mabrains/PLL_design/README.md

# Bluetooth PLL Design on Skywater's __130nm__ technology

 *The current design is still under progress. This is an **experimental release**.*

<p align="center">



&nbsp 
</p>

----------------------
# Table of Contents

- [Introduction](docs/Introduction.md)
- [System Model](docs/system_model.md)
- [Blocks](docs/blocks/design.md)
- [Full PLL Design](docs/full_pll_design.md)
- [Tapeout using Caravel SoC](docs/tapeout.md)

Each block is designed to achieve system design specifications using [xschem](https://github.com/StefanSchippers/xschem) tool. 

Each block is Layouted to using [Klayout](https://github.com/KLayout/klayout) tool. 

Refer to [README](docs/source/index.rst) for this sample project documentation.
