mabrains/PLL_design/pll/lc_vco_lib_Ahmed_Reda/VCO_CMOS_init_tb/README.md

Initial Design
=================

    - A simple inductor model is used which is composed of an ideal inductor in parallel with a resistor which represents the losses of the inductor.
    
    - Varactor isn't implemented yet, so a capacitor is used.
    
    - The values of the inductor and the capacitor are adjusted to get a resonance frequency at 2.45 GHz.
    
    - The size of the NMOS cross coupled pair is adjusted to generate a negative resistance which negates the positive resistance of the inductor.

_________________________________________________________________________
- Implemented CMOS based LC VCO operating at 2.45 GHz
    - Schematic:
 
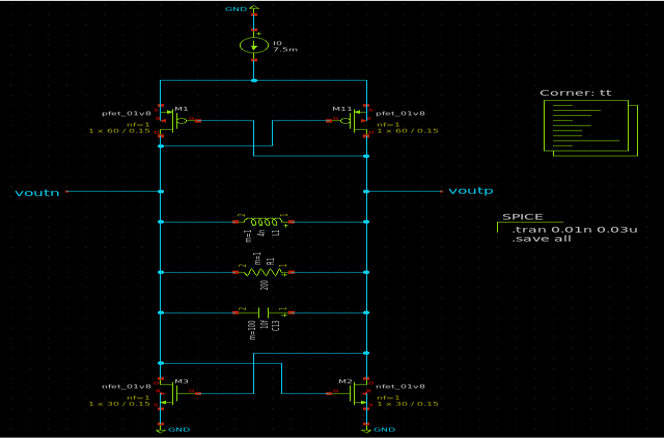
[picture p4: pll/lc_vco_lib_Ahmed_Reda/VCO_CMOS_init_tb/images/CMOS_LC_VCO_Schematic.png]
CMOS LC VCO Schematic
    
    
    - Output:
    
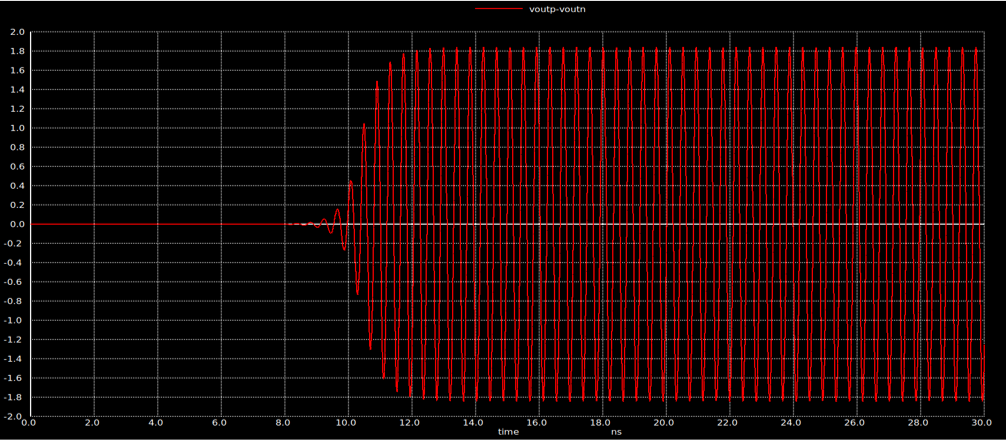
[picture p5: pll/lc_vco_lib_Ahmed_Reda/VCO_CMOS_init_tb/images/CMOS_LC_VCO_Diff_Output.png]
CMOS LC VCO Output CMOS LC VCO Differential Output
