mabrains/PLL_design/pll/lc_vco_lib_Ahmed_Reda/BGR_Corners/csv_sheets/mult/constant_load/README.md

**This file contains the results of the BGR circuit of the schematic view and after paracitic exraction but by **fixing** the voltage value of the output node at **VDD/2** at the typical corner.**
