mabrains/PLL_design/docs/blocks/design.md

# Blocks Design

- [Crystal OSC](xctl.md)

- [PFD](pfd.md)

- [Charge pump](cp.md)

- [Loop Filter](lf.md)

- [Band-gap Refrence](bgr.md)

- [VCO](vco.md)

- [Divider](div.md)

- [DSM](sdm.md)
