mabrains/PLL_design/pll/system/design_specs/Specs.md

# System specs

| Spec | Value |
| --- | --- |
| `Center frequencies` | 2.402-2.480 GHz|
| `Phase noise @ 1MHz offset (From Standard)` |<-74 dBc/Hz |
| `Phase noise @ 2MHz offset (From Standard) ` |<-106 dBc/Hz|
| `Phase noise @ 3MHz offset (From Standard)` | <-116 dBc/Hz |
| `Synthesizer lock time (From Standard)  ` | (<68𝜇)|
| `Loop Bandwidth` | 150 KHz|
| `Phase margin ` | 55°|
| ` Expected Lock time ` | 4/(𝐿𝑜𝑜𝑝 𝐵𝑊)≈26 𝜇𝑠|
| `Loop Filter Parameters` | Cz ≈268𝑝𝐹 ,Rz ≈12.5 𝐾Ohms , CP ≈29.5𝑝𝐹|

# Crystal Oscillator

| Spec | Value |
| --- | --- |
| `Fref` | 10 𝑀𝐻𝑧 |
| `Phase noise @ 1MHz offset` | <-150 dBc/Hz |

# PFD/CP

| Spec | Value |
| --- | --- |
| `Iout` | 100𝜇𝐴 |
| `Compliance Range` | 0.5V-1.5V |
| `Phase noise @ 1MHz offset` | <-240 dBc/Hz |

# VCO
| Spec | Value |
| --- | --- |
| `Tuning range` | 2.35G,2.55G |
| `𝐾_𝑣𝑐𝑜 ` | 200MHz/V |
| `Phase noise @ 1MHz offset ` | <-115 dBc/Hz |

# Divider
| Spec | Value |
| --- | --- |
| `DIV RATIO` | 240-248|
| `Step ` | 0.1 |
| `Resolution` |  1 MHz |
| `Modulus control A B ratios` |  9 : 1 |
| `Phase Noise @ 1 MHz offset` |  <-150 dBc/Hz |

18/8/2022
