mabrains/PLL_design/docs/Introduction.md

# Introduction

A fully integrated Sigma-Delta Fractional-N PLL for Wifi/Bluetooth applications is implemented using Open-Source PDKs by Google-Skywater 130nm. The entire design was built using Open-Source EDA tools such as Octave, python, xschem, ngspice and Klayout.
