mabrains/PLL_design/docs/blocks/bgr.md

## Band Gap Refrence (BGR) 
----------------------------------

### Circuit design 
----------------------

* Proposed BGR circuit (Banba) :

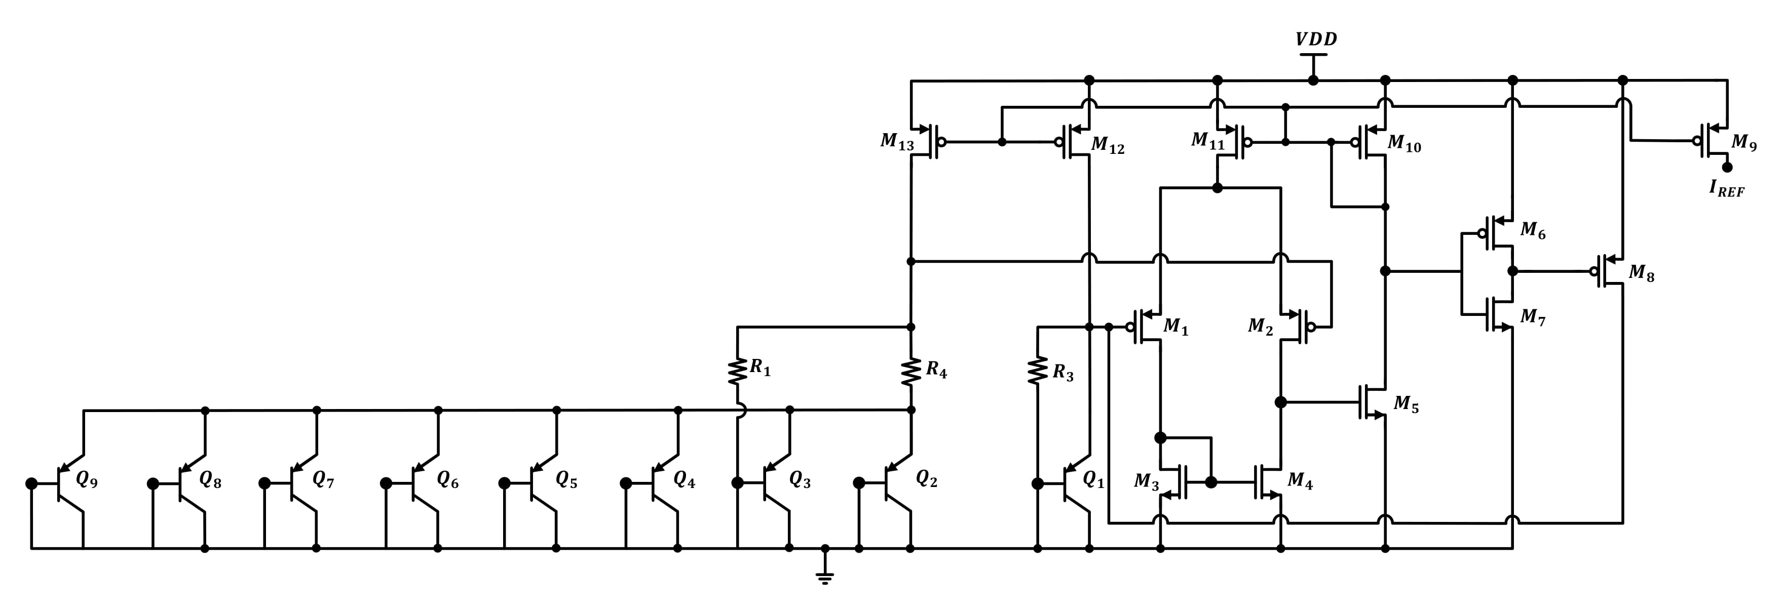
[picture p51: images/Diagrams/BGR/Banba BGR.jpg]
BGR


* Core Circuit :

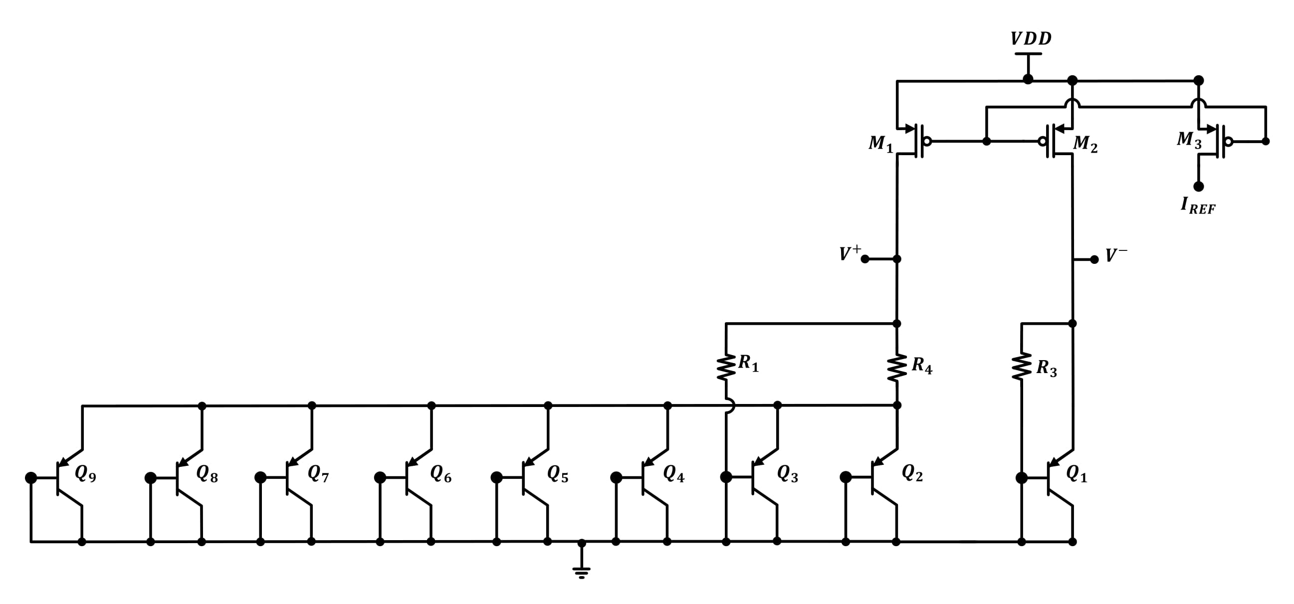
[picture p52: images/Diagrams/BGR/Core .jpg]
Core


* OTA :

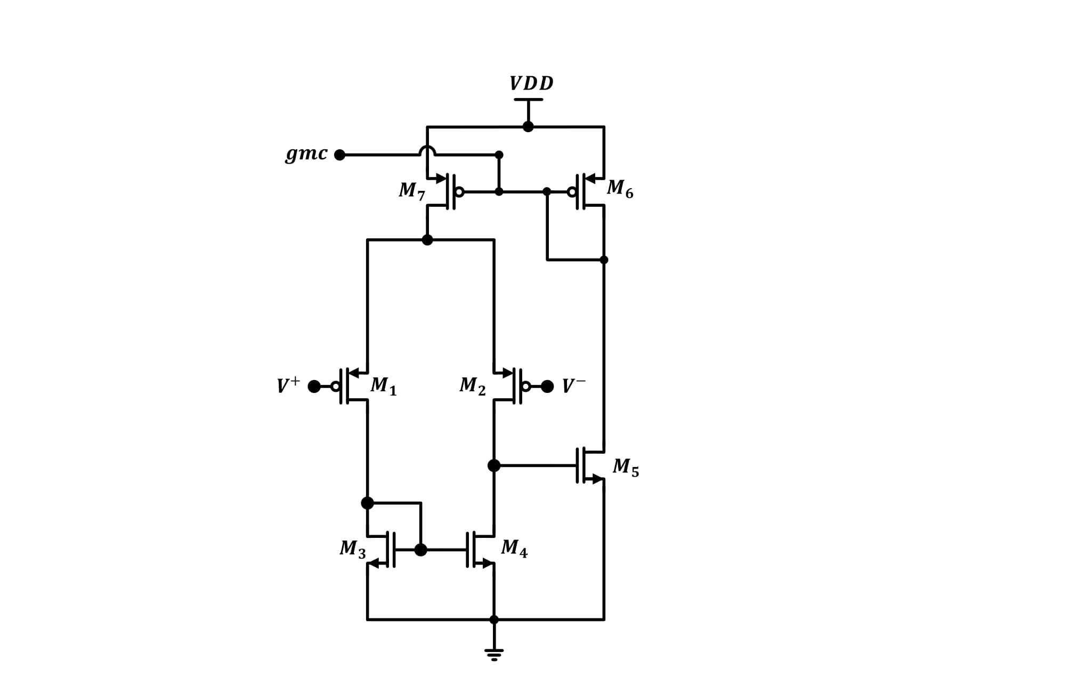
[picture p53: images/Diagrams/BGR/OTA.jpg]
OTA


* Start-Up Circuit :

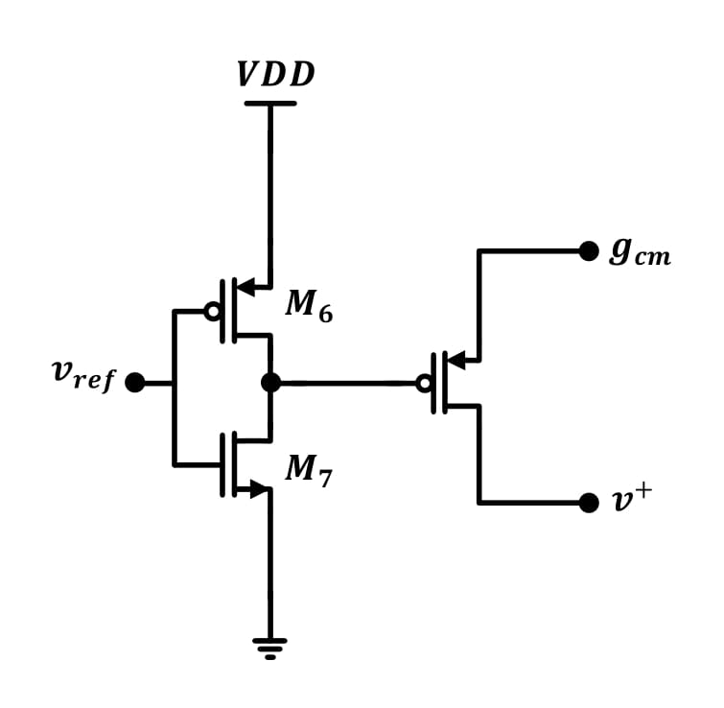
[picture p54: images/Diagrams/BGR/Start-up Circuit.jpg]
STC


### Simulation results 
----------------------
#### Biasing Circuit  : Simulation of Banba Bandgap

Iref vs Temperature (-40 to 125 )
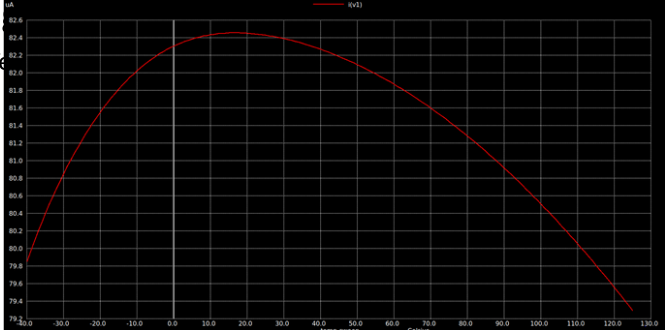
[picture p55: docs/blocks/bgr_images/1.png]

#### Transient Analysis
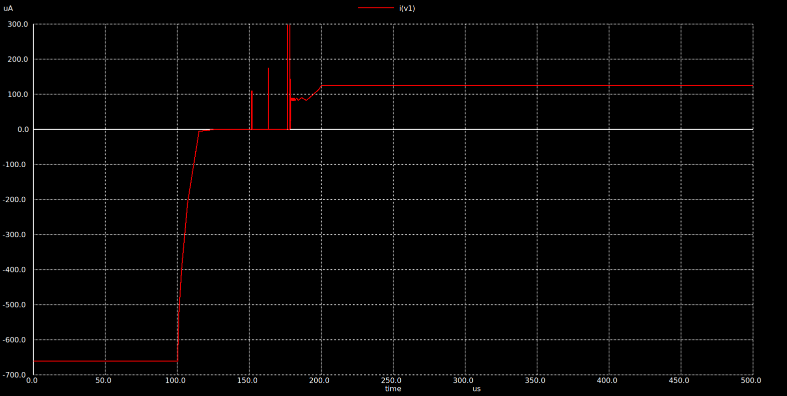
[picture p56: docs/blocks/bgr_images/tran.png]


### Layout design 
----------------------
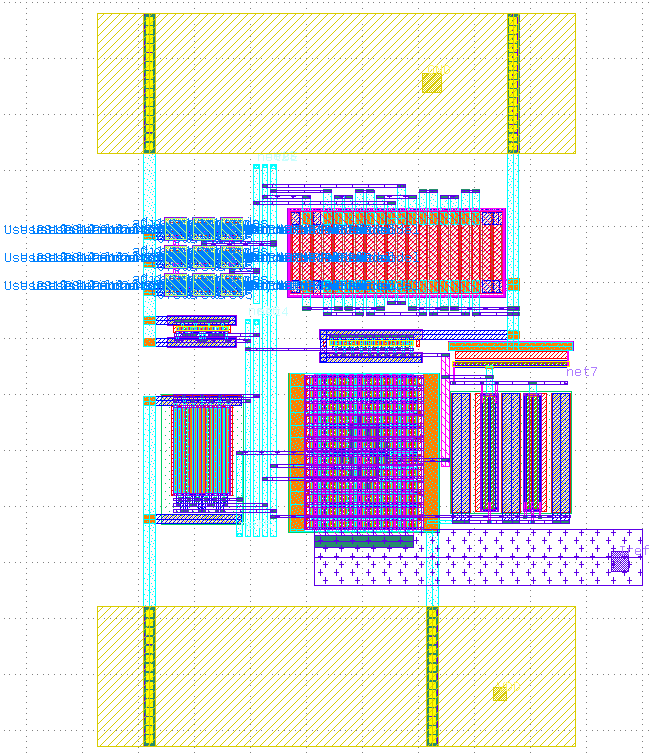
[picture p57: images/Layout/bgr_layout.png]
bgr_layout


### Post-Layout simulation
----------------------
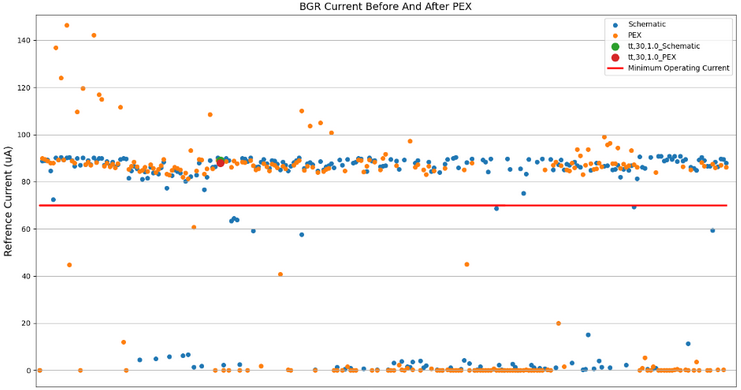
[picture p58: docs/blocks/bgr_images/play.png]
