mabrains/PLL_design/docs/blocks/lf.md

## Loop Filter
----------------------

### Circuit design 
----------------------

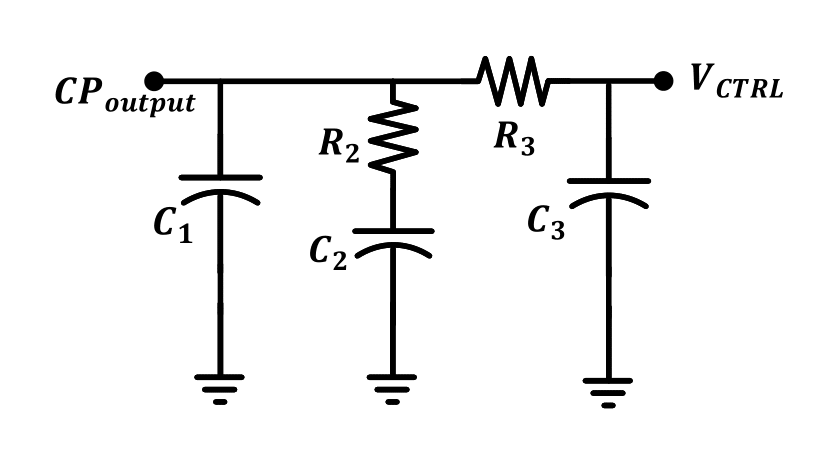
[picture p59: images/Diagrams/Loop filter/png/3rdorderlpf.png]


### Layout design 
----------------------

### Integeration of PFD + CP + LF
----------------------



#### REF lags from FB


#### FB lags from REF


#### FB lags from REF
When phase error is very small $50 ps$ FB lags from REF signal 
