mabrains/PLL_design/images/Diagrams/LC VCO/pdf/LC_VCO-6.pdf

# Capictance pF

# Reverse Voltage (Vr

)

Capictance decreases when the reverse voltage increases
