mabrains/PLL_design/images/Diagrams/PFD/pdf/deadzone_exists.pdf

180

o | −180 o

Pha e error

Avera e Output Volta e of the PFD
