mabrains/PLL_design/pll/system/python_model/README.md

4 Sept 2022
---
# _Status of the python Models_
80% 
---
## Phase Noise Modeling
* Need to model the loop filter parameters calculator
* Need to revise Ref Crystal 

* Python models are compiled and are working probably 

Here are the samples
* The Cloosed loop response of the PLL
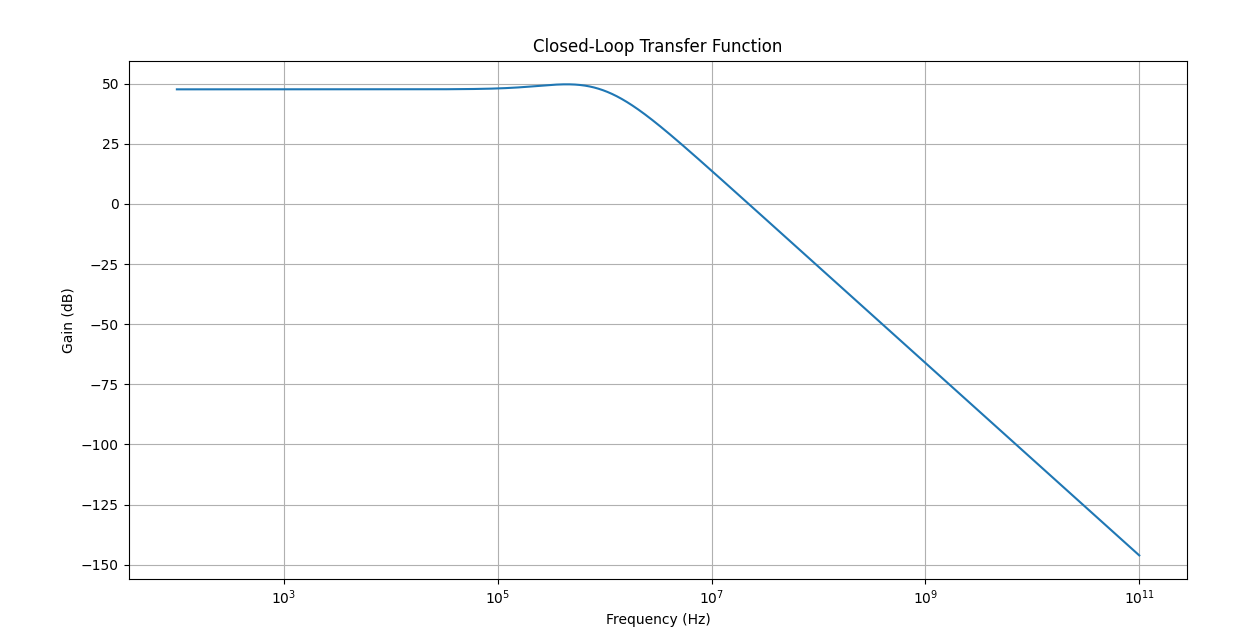
[picture p89: pll/system/python_model/2nd_sample_images/CL.png]
1st_sample

* The Open loop response of the PLL
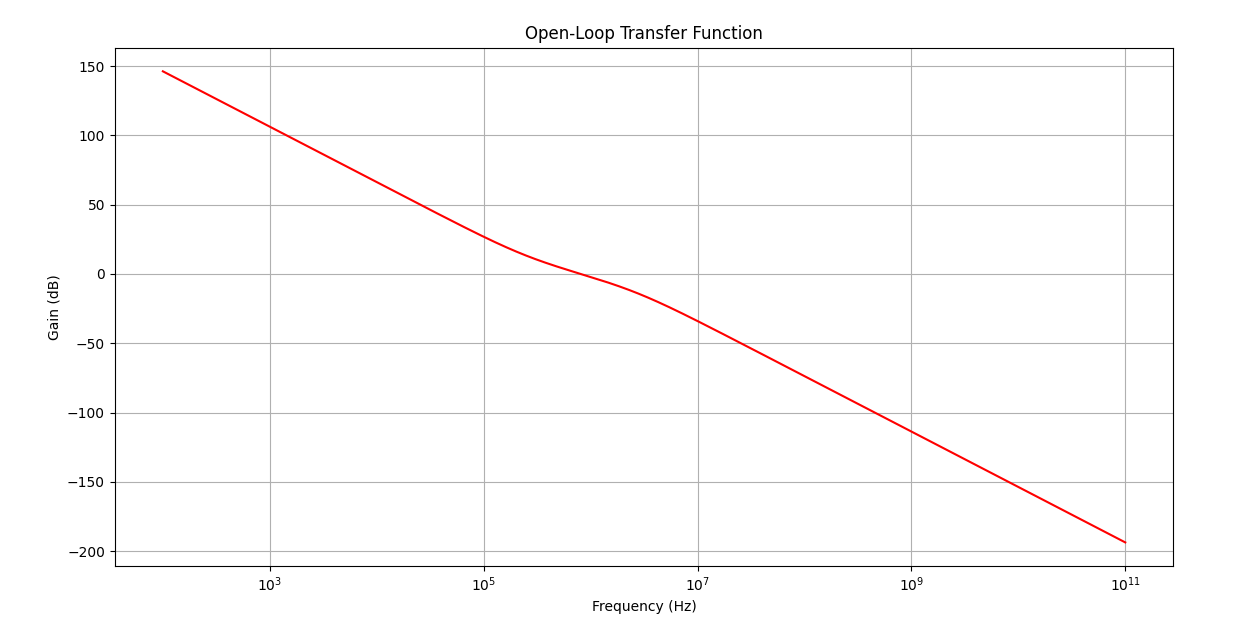
[picture p90: pll/system/python_model/2nd_sample_images/OL.png]
1st_sample

* Crystal oscillator Phase Noise Profile
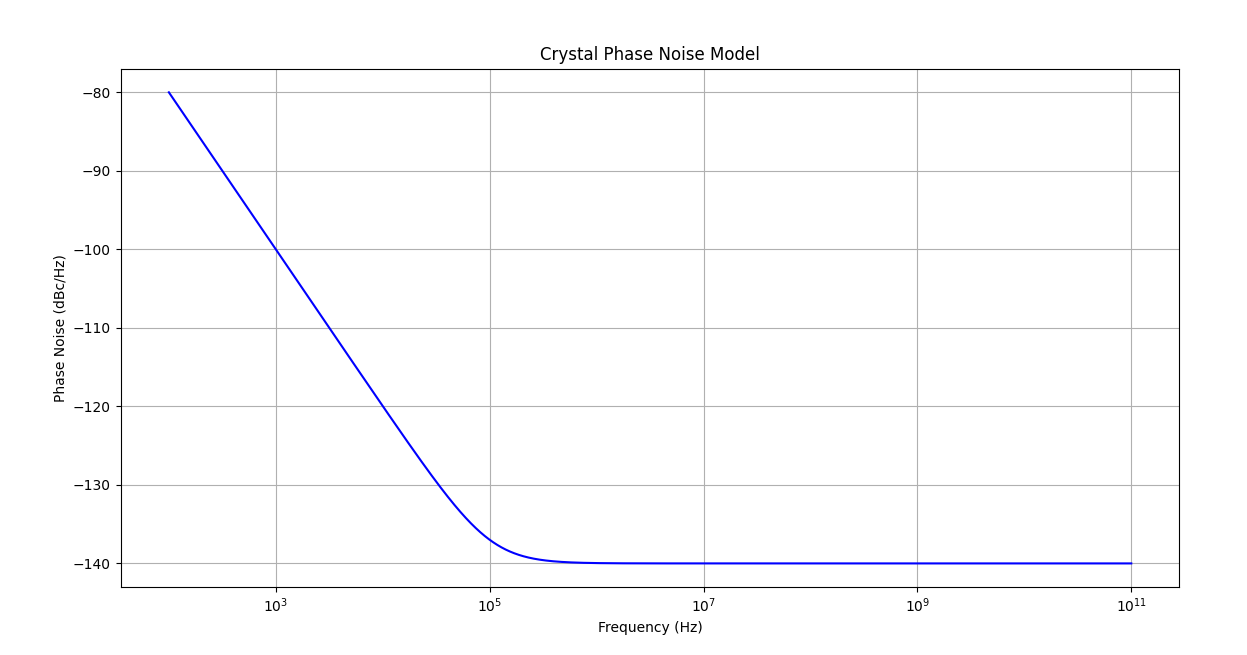
[picture p91: pll/system/python_model/2nd_sample_images/Crystal.png]
1st_sample

* Phase/Frequency Detector Phase Noise Profile
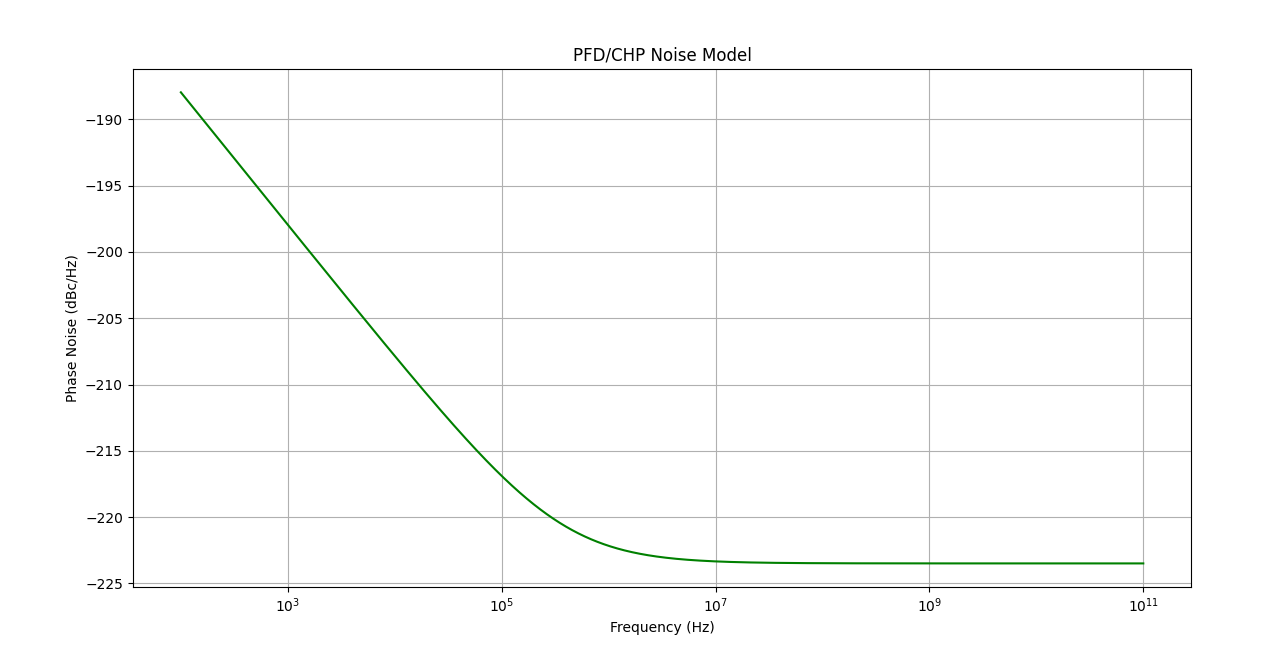
[picture p92: pll/system/python_model/2nd_sample_images/PFD.png]
1st_sample

* Divider Phase Noise Profile
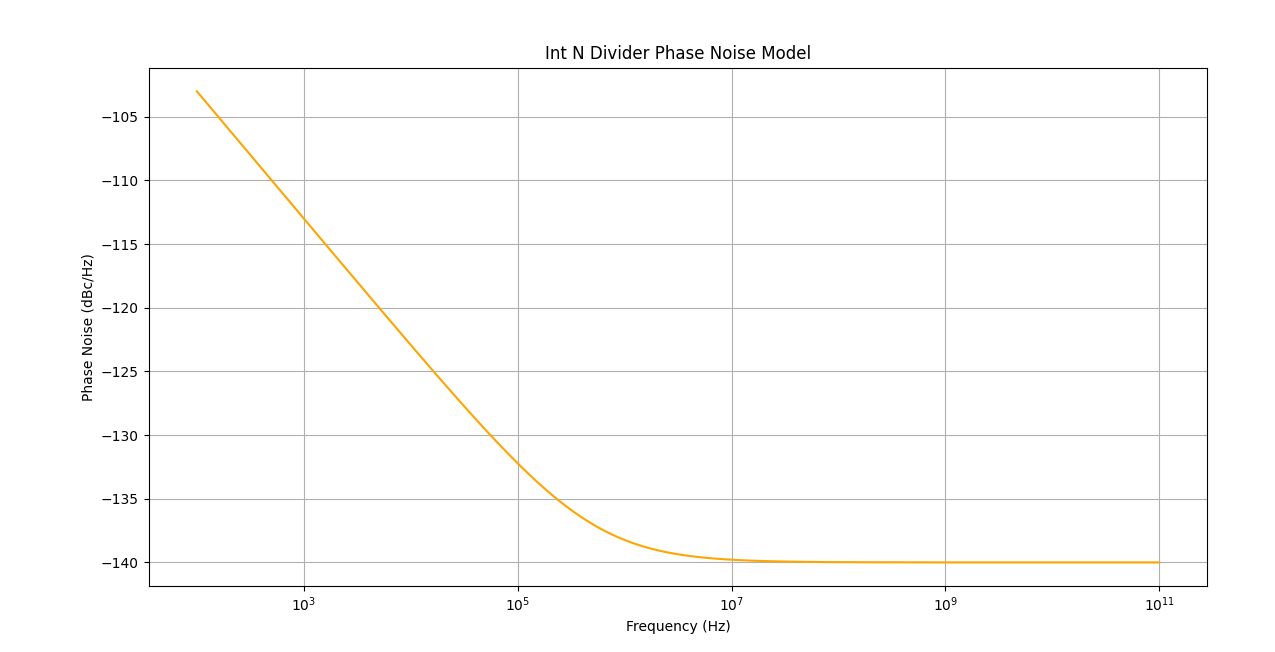
[picture p93: pll/system/python_model/2nd_sample_images/Int.png]
1st_sample

* Sigma Delta Noise Profile
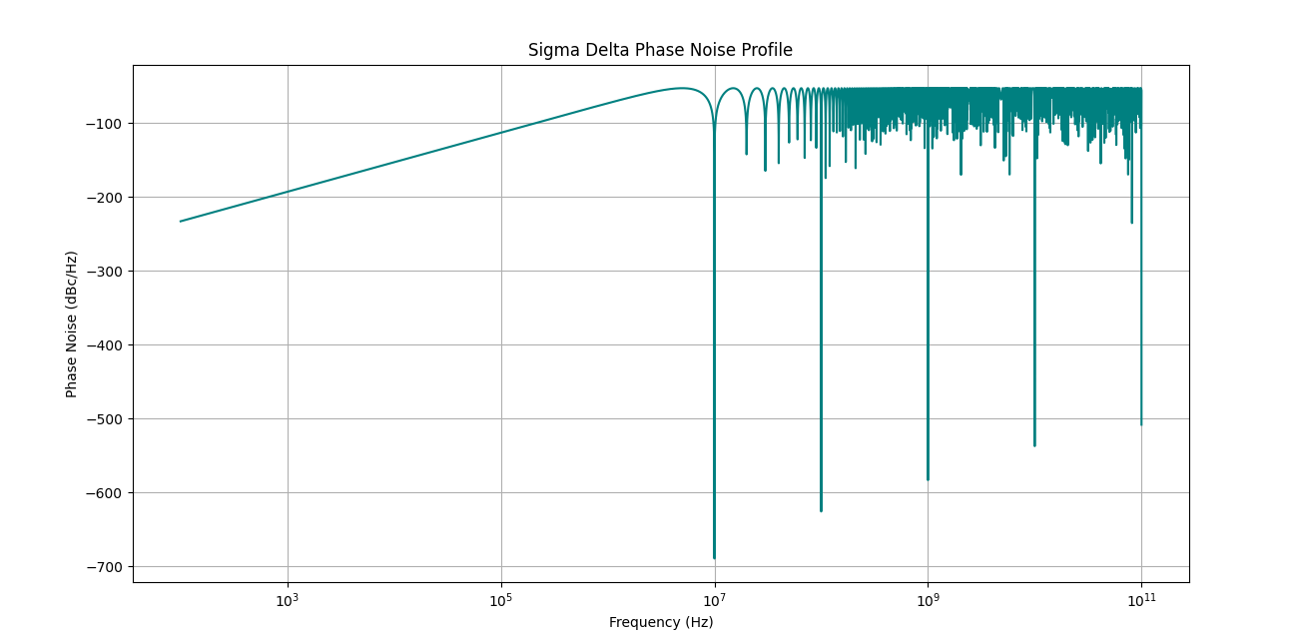
[picture p94: pll/system/python_model/2nd_sample_images/Sigma Delta.png]
1st_sample

* Voltage Controlled oscillator Phase Noise Profile
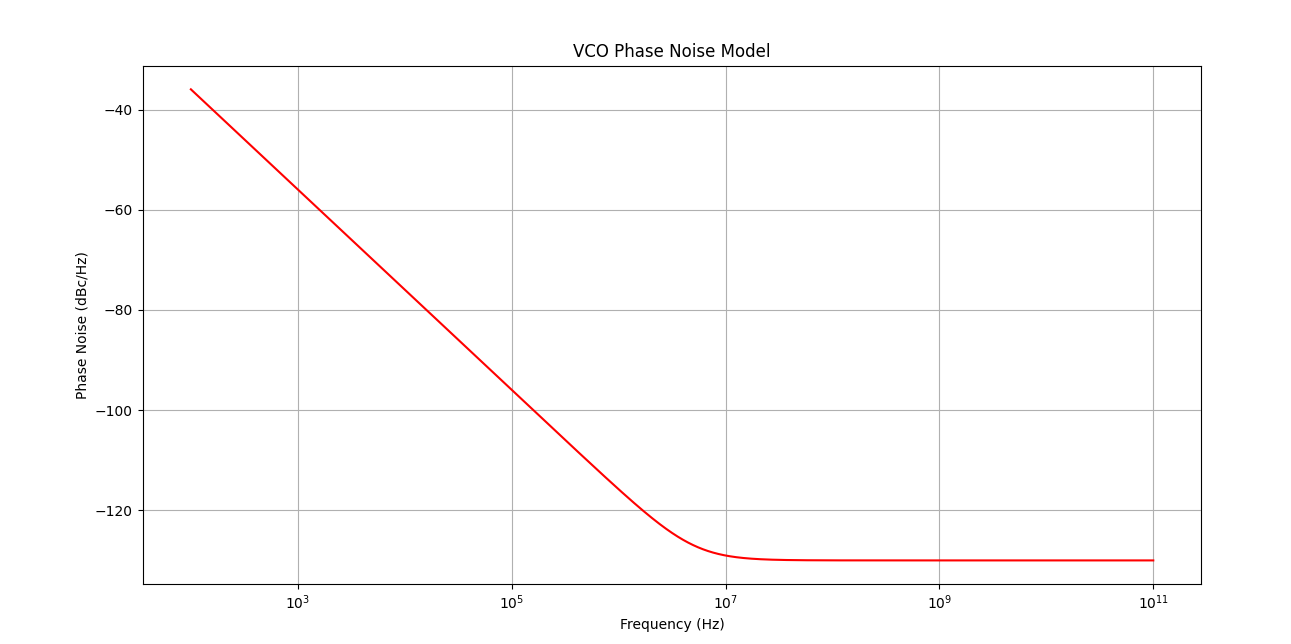
[picture p95: pll/system/python_model/2nd_sample_images/VCO.png]
1st_sample

* Total Output Phase Noise Profile
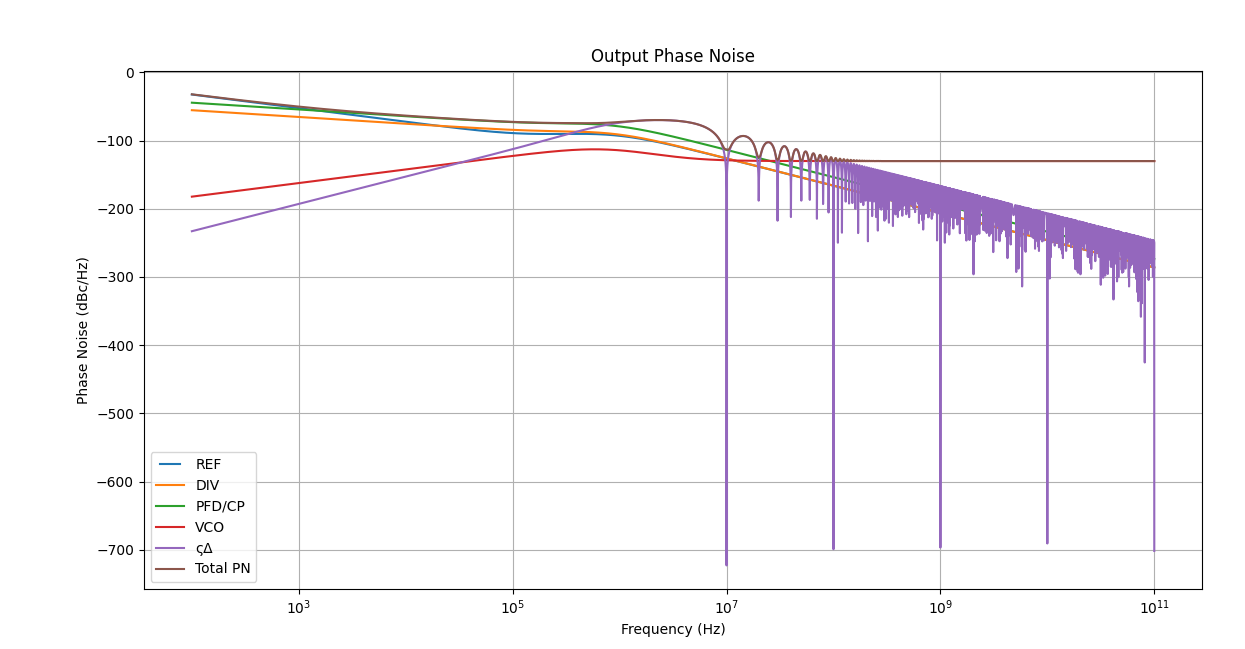
[picture p96: pll/system/python_model/2nd_sample_images/TOTAL.png]
1st_sample


* Missing Loop Filter Phase Noise ( Need to Revise Crystal phase noise and divider )

## Time Domain Modeling 
### PFD 
* In the PFD time domain modeling i compare manually enter two siganls with phase difference of pi to test the UP signal case
* The code comapre each value of time array siganls with each other to detect rising edges and based on this edges it flags an up signal
* But the code has a flaw in the initial step of the code as it cannot detect the first edge ( as i forcly waits for the 2nd edge of the feedback signal to drive some algrothim on how the code should detect the signals 
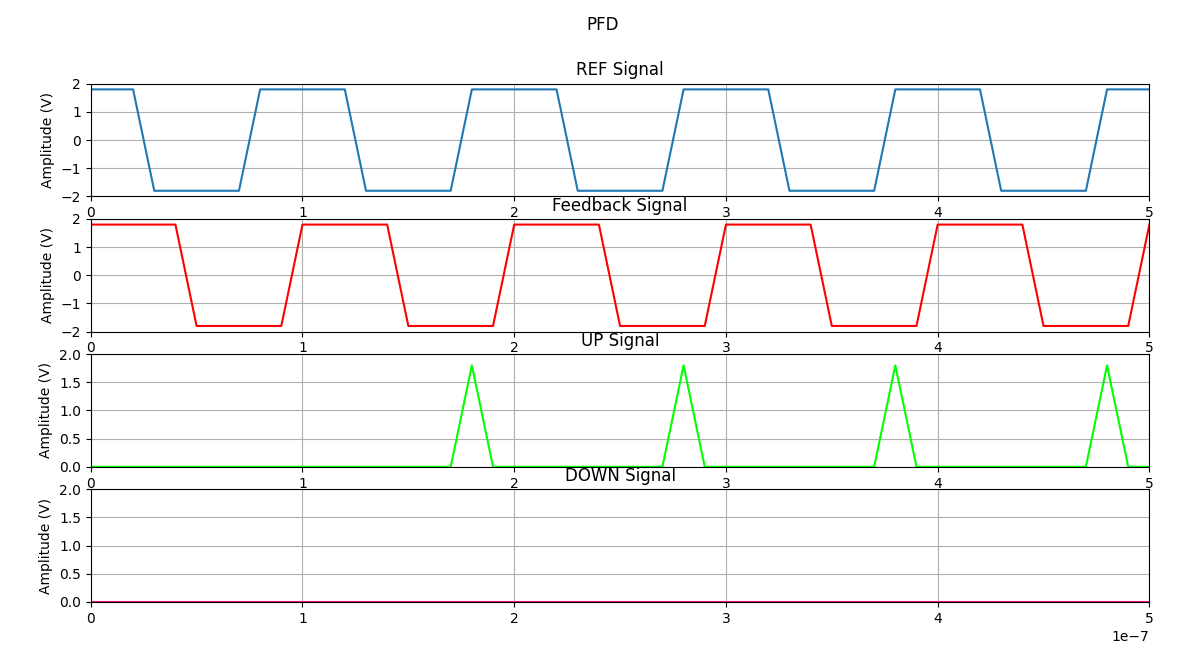
[picture p97: pll/system/python_model/PFD_TIME_DOMAIN_MODEL/PFD OPERATION.png]
   
* When i try to solve the issue i ran into a logical error as i reverse the logic for the next edges 
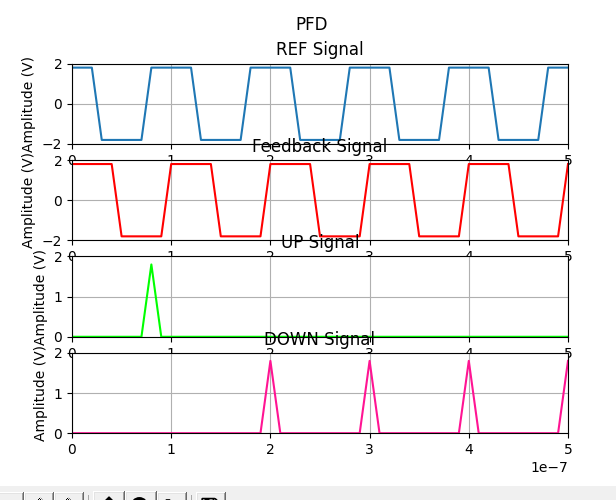
[picture p98: pll/system/python_model/PFD_TIME_DOMAIN_MODEL/trial pfd 1.png]
  
* Problem Should be Fixed soon

*_Moataz Mokhtar_*
