mabrains/PLL_design/pll/system/design_specs/System_Modeling.md

# PLL System Design

## System Parameters:
* Kvco = 200MHz/V
* Ichp = 100uA
* Fref = 10 MHz
* Fout = 2.402 GHz
* Loop Bandwidth = 150 KHz
* Phase margin = 55

## Open loop response:

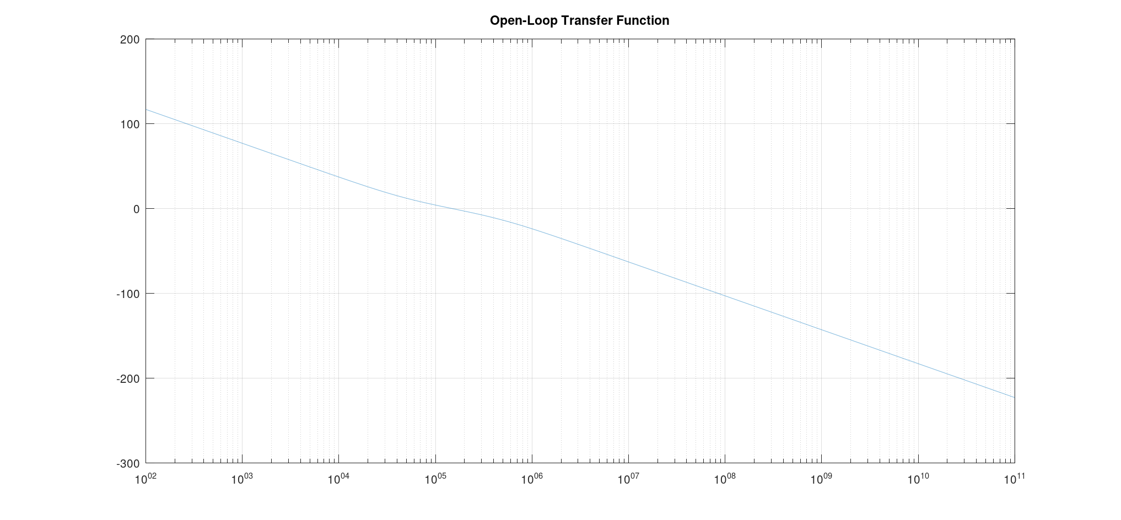
[picture p99: pll/system/phase_noise_images/OL_Tf.png]
Open loop response


## Closed loop response:

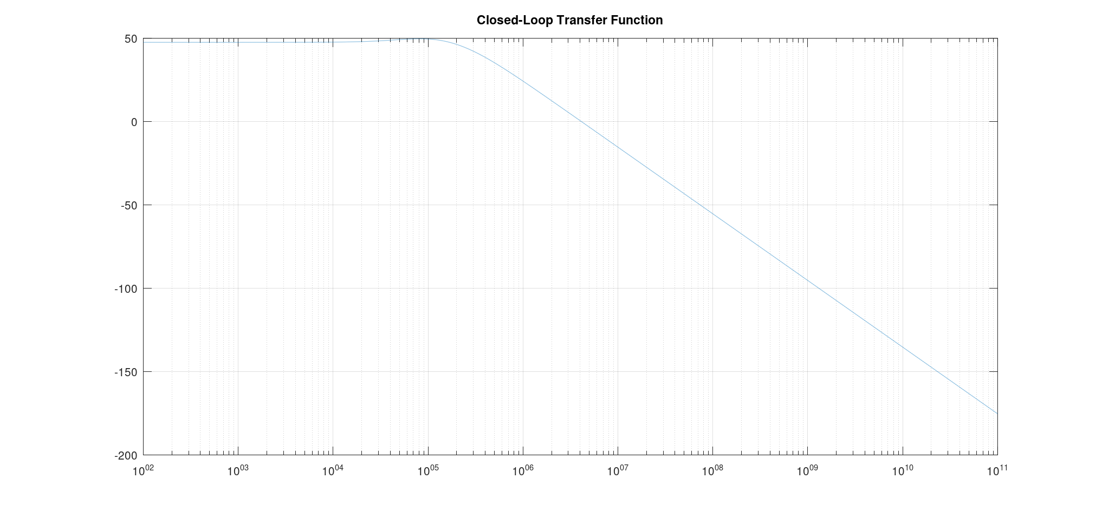
[picture p100: pll/system/phase_noise_images/CL_Tf.png]
Closed loop response


## Phase noise profile of each block:

### Crystal Oscillator Noise Model
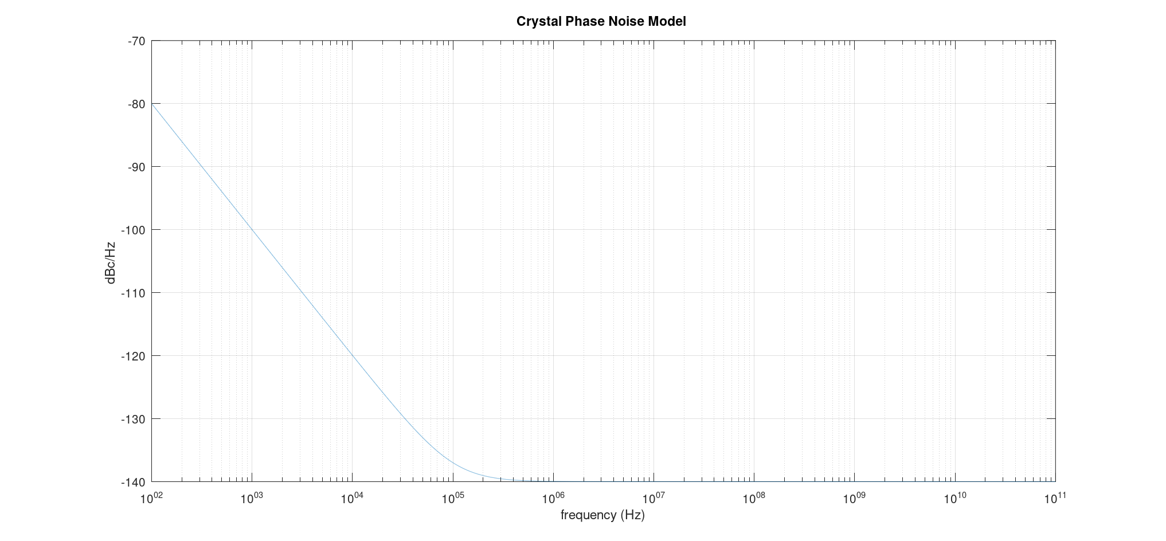
[picture p101: pll/system/phase_noise_images/Crystal_PN_Model.png]
Crystal Oscillator Noise Model


### PFD/CHP Noise Model
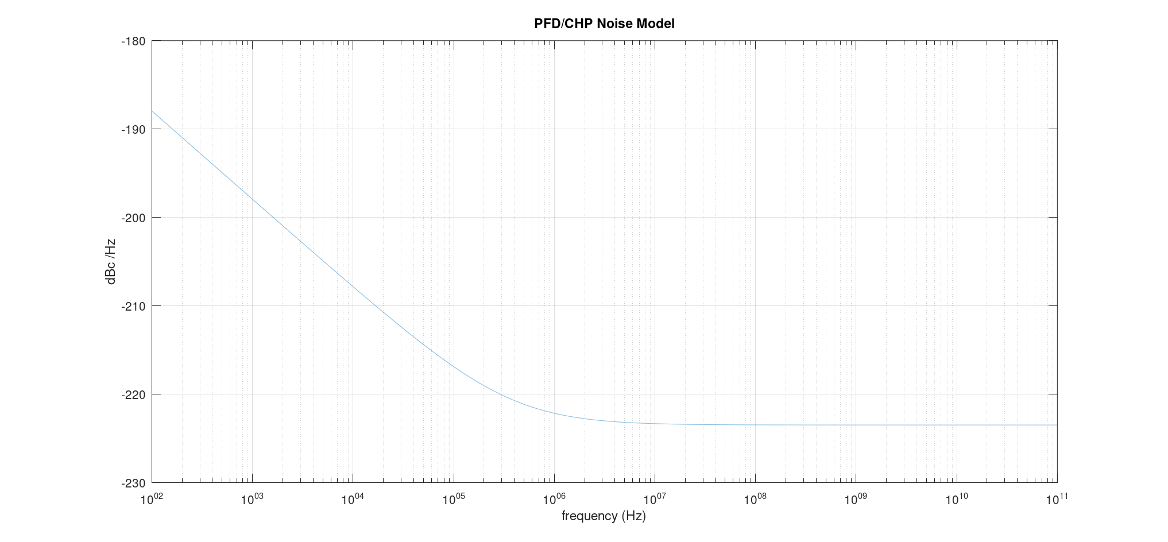
[picture p102: pll/system/phase_noise_images/PFDCHP_PN_Model.png]
PFD/CHP Noise Model


### VCO Noise Model
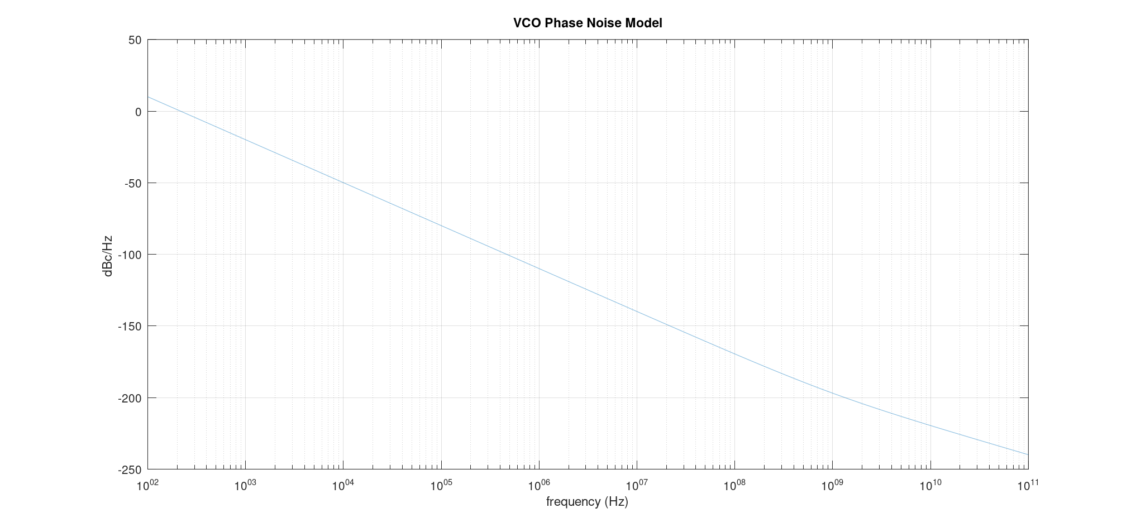
[picture p103: pll/system/phase_noise_images/VCO_PN_Model.png]
VCO Noise Model


### Divider Noise Model
Divider Noise Model

As in the following figure, each noise source sees a different transfer function depending on the position in the loop to the output.
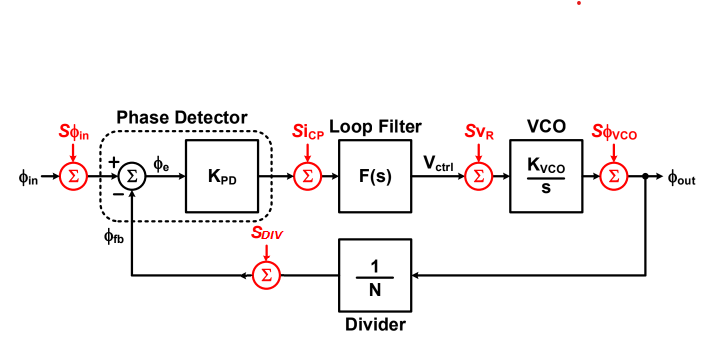
[picture p104: pll/system/phase_noise_images/Linearized_Model.png]


## Total Output Phase noise
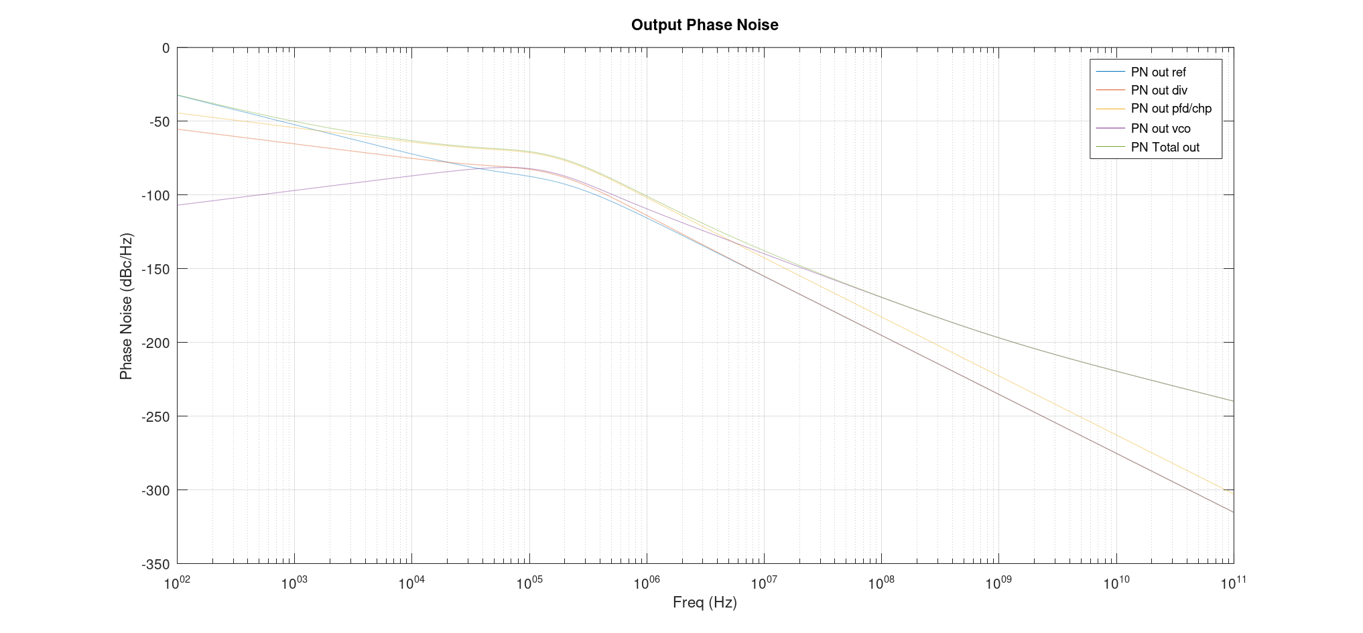
[picture p105: pll/system/phase_noise_images/Total_out_PN.png]


| Phase Noise | Value |
| --- | --- |
| `@ 1MHz offset` |-99.8 dBc/Hz |
| `@ 2MHz offset` |-111.4 dBc/Hz|
| `@ 3MHz offset` |-119.5dBc/Hz |
