mabrains/PLL_design/docs/blocks/xctl_images/crystal_layout.pdf

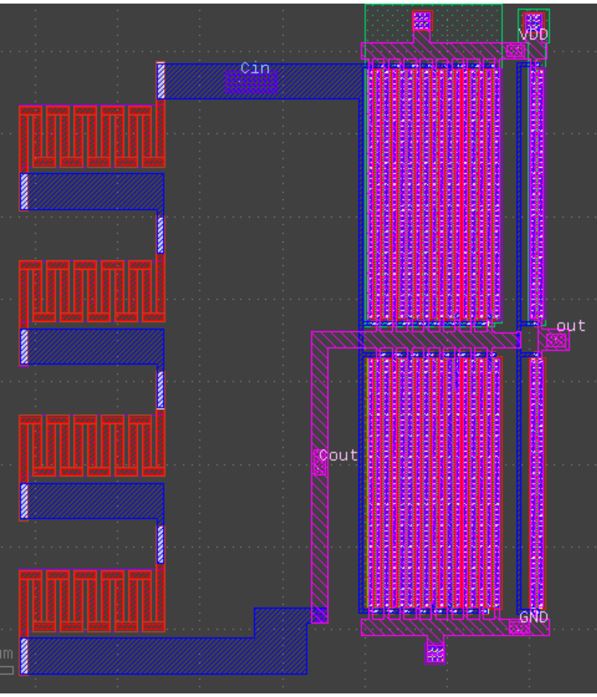
[picture p126: page 1]

gr
