mabrains/PLL_design/images/Diagrams/LC VCO/pdf/LC_VCO-1.pdf

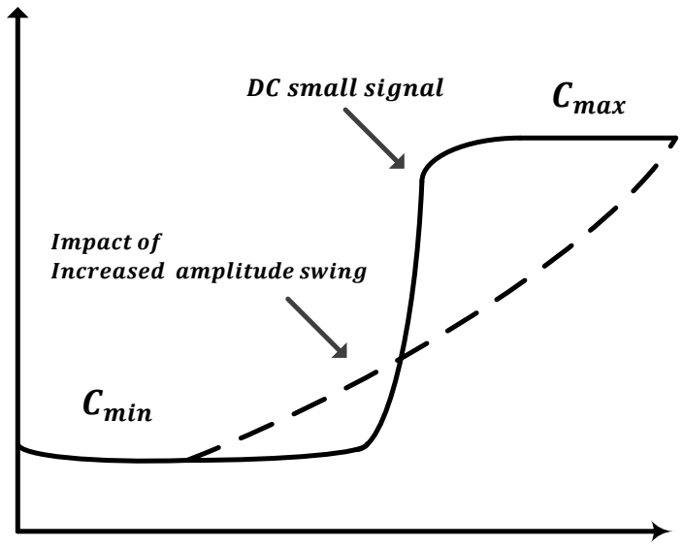
[picture p127: figure]
Impact of Increased amplitude swing; Cmin; Cmax; DC small signal
