mabrains/PLL_design/images/Diagrams/LC VCO/pdf/LC_VCO-10.pdf

1
f
Noise

−10 dB per decade

fcorner

White Noise
