mabrains/PLL_design/images/Diagrams/LC VCO/pdf/LC_VCO-12.pdf

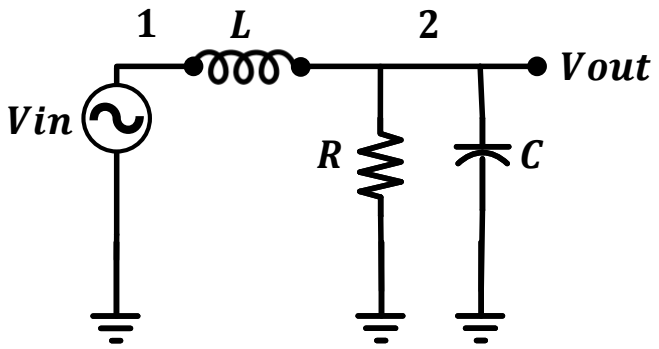
[picture p128: figure]
Vin; Vout
