mabrains/PLL_design/images/Diagrams/LC VCO/pdf/LC_VCO-13.pdf

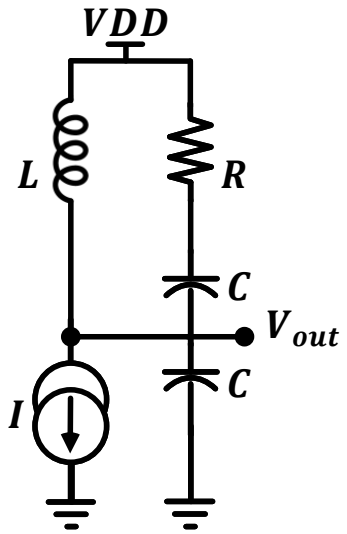
[picture p129: figure]
VDD; Vout
