mabrains/PLL_design/images/Diagrams/LC VCO/pdf/LC_VCO-14.pdf

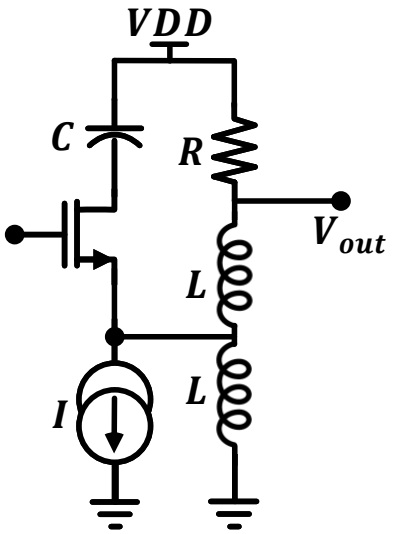
[picture p130: figure]
VDD; Vout
