mabrains/PLL_design/images/Diagrams/LC VCO/pdf/LC_VCO-15.pdf

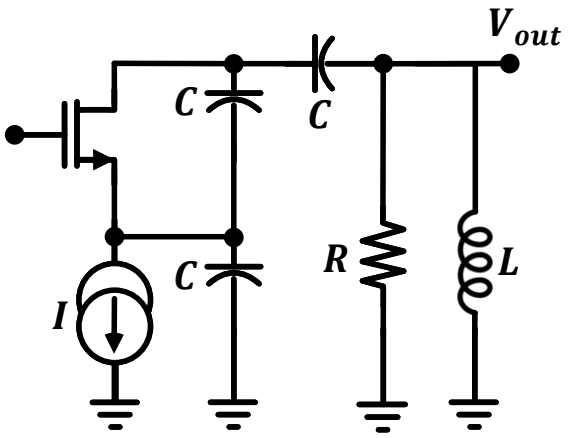
[picture p131: figure]
Vout
