mabrains/PLL_design/images/Diagrams/LC VCO/pdf/LC_VCO-2.pdf

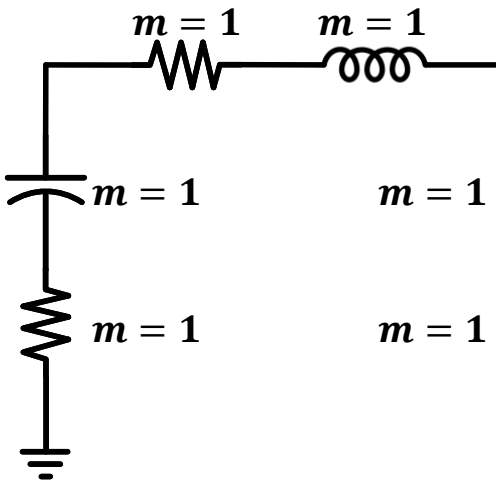
[picture p132: figure]
