mabrains/PLL_design/images/Diagrams/LC VCO/pdf/LC_VCO-20.pdf

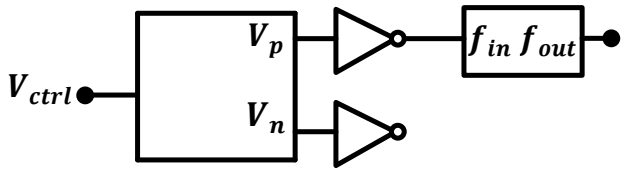
[picture p133: figure]
Vctrl; fin fout
