mabrains/PLL_design/images/Diagrams/LC VCO/pdf/LC_VCO-3.pdf

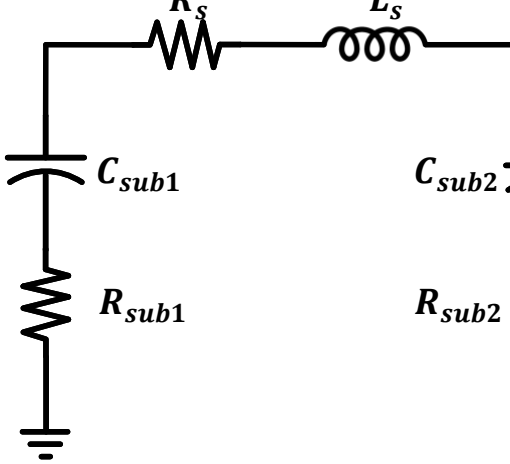
[picture p134: figure]
Csub1; Rsub1; Csub2; Rsub2

Rs | Ls
