mabrains/PLL_design/images/Diagrams/LC VCO/pdf/LC_VCO-4.pdf

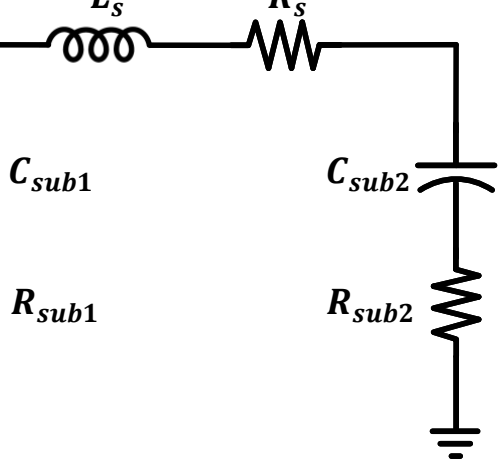
[picture p135: figure]
Csub1; Rsub1; Csub2; Rsub2

Ls | Rs
