mabrains/PLL_design/images/Diagrams/LC VCO/pdf/LC_VCO-7.pdf

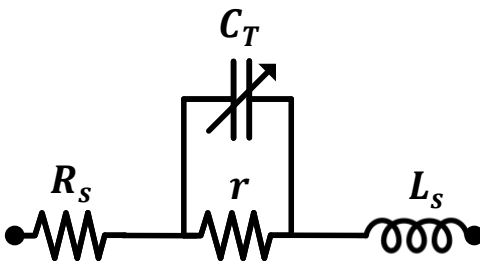
[picture p136: figure]
