mabrains/PLL_design/images/Diagrams/PFD/pdf/conv_PFD.pdf

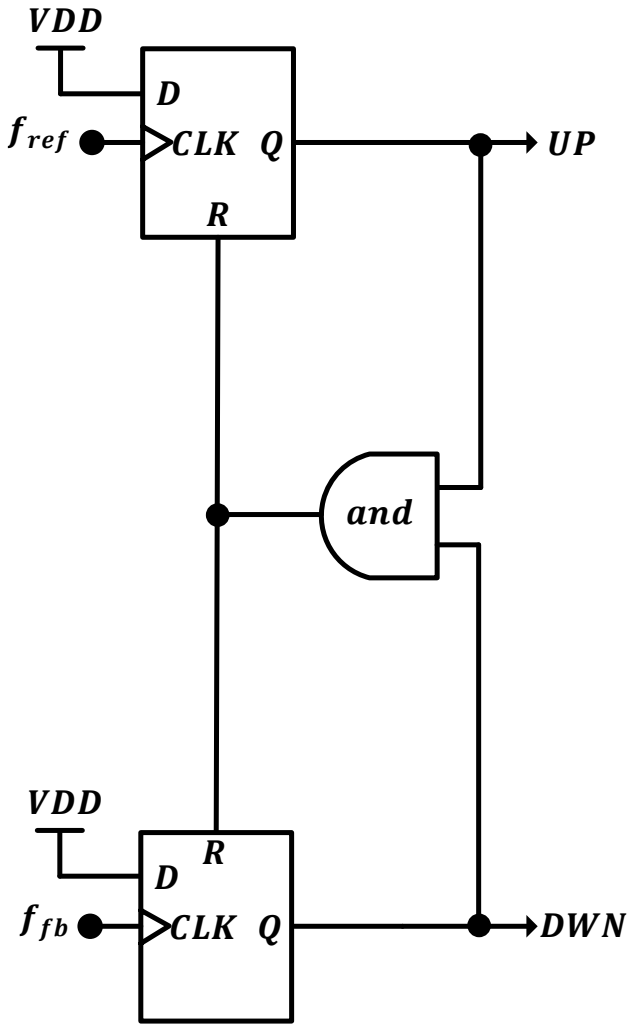
[picture p137: figure]
R SET; CLR; ffb; CLK; SET; fref; VDD; DWN; and
