mabrains/PLL_design/images/Diagrams/PFD/pdf/Implementation.pdf

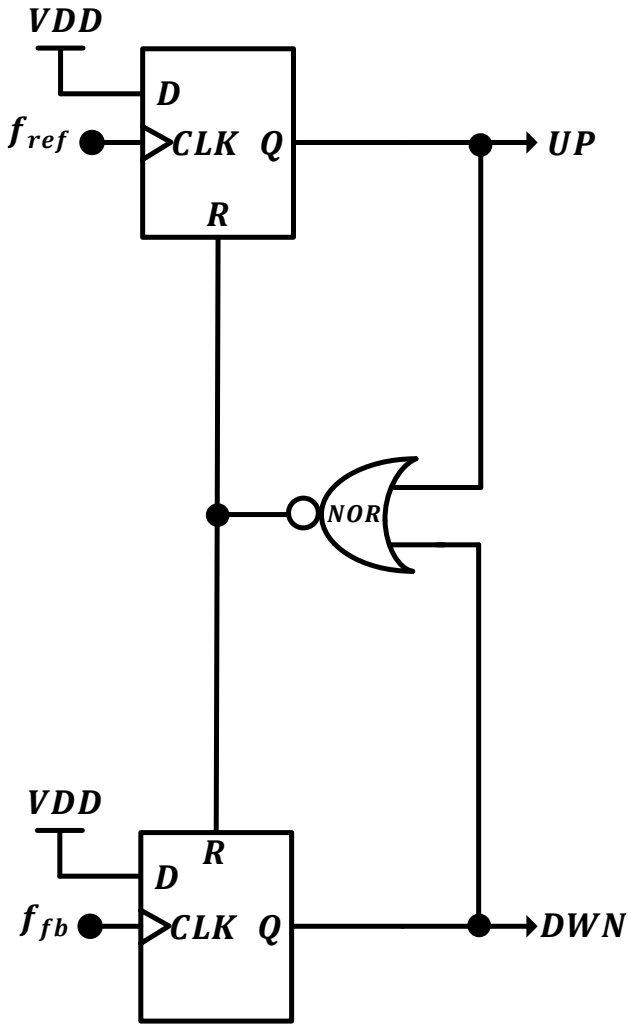
[picture p138: figure]
R SET; CLR; ffb; CLK; SET; fref; VDD; DWN; NOR
