mabrains/PLL_design/images/Diagrams/PFD/pdf/NOR.pdf

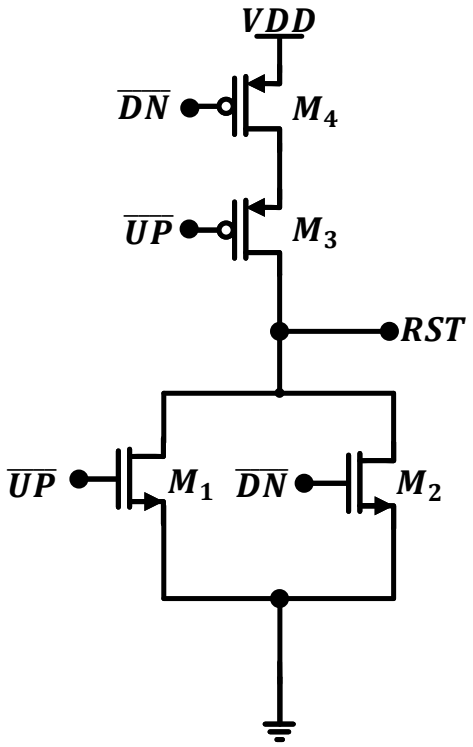
[picture p139: figure]
VDD; RST
