mabrains/PLL_design/images/Diagrams/PFD/pdf/PFD_TRADE_OFSS.pdf

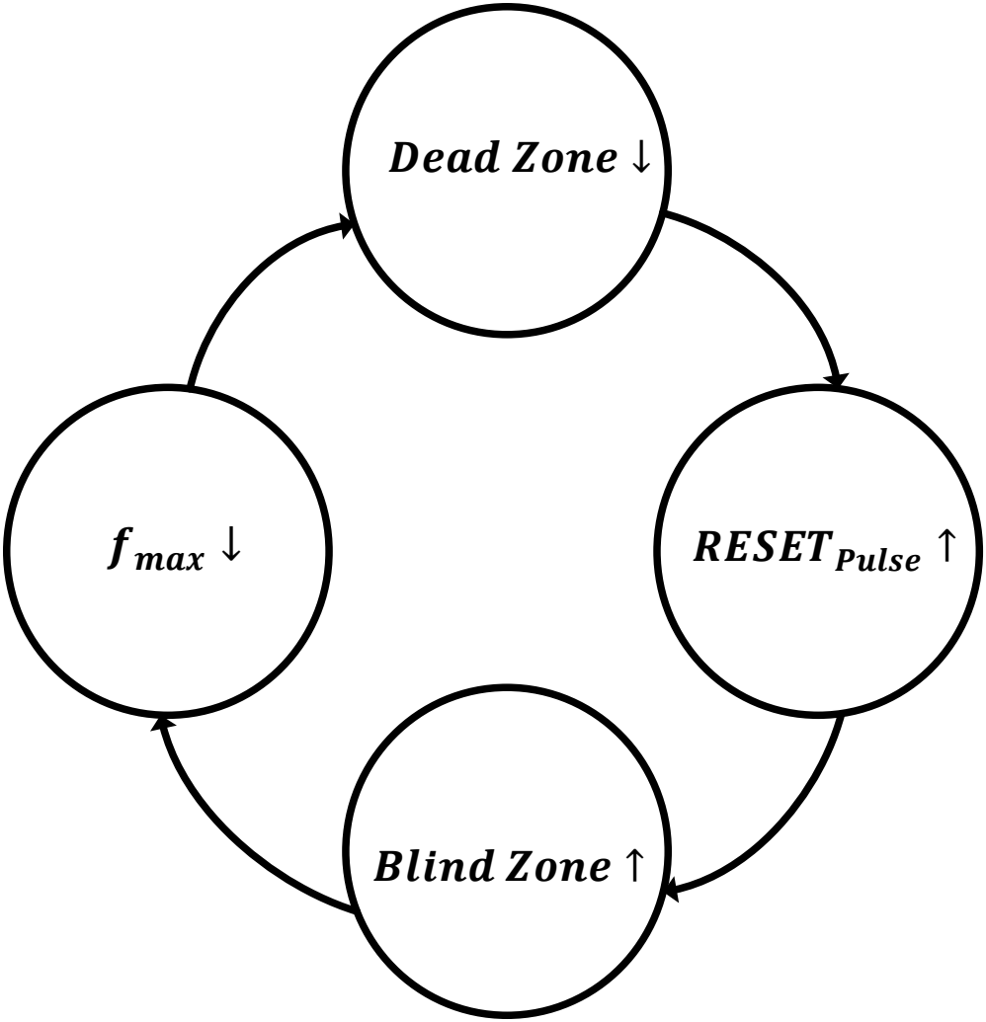
[picture p140: figure]
Dead Zone ↓; fmax ↓; Blind Zone ↑; RESETPul e ↑
