mabrains/PLL_design/images/Diagrams/PFD/pdf/reason_dead_zone.pdf

### Ref

Fb

UP

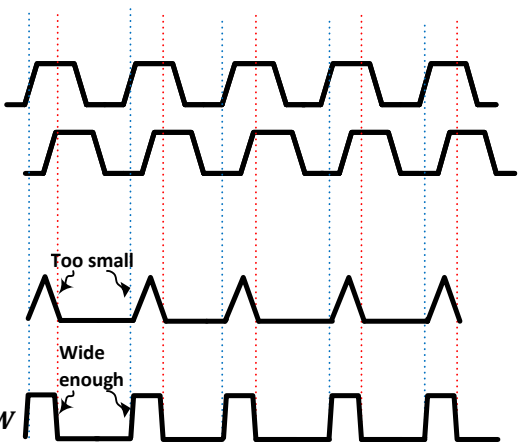
[picture p141: figure]
Too small Wide; enough

### UP NEW
