mabrains/PLL_design/images/Diagrams/PFD/pdf/simple phase detector.pdf

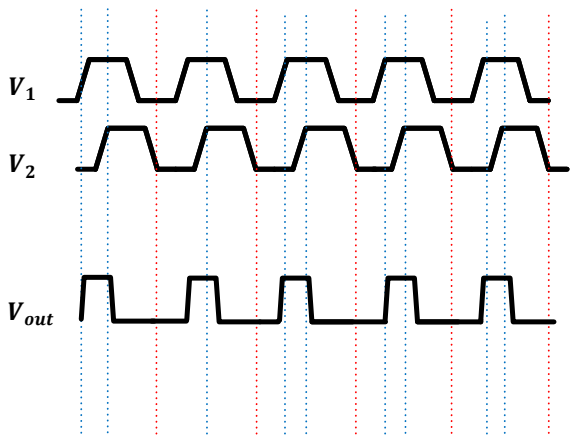
[picture p142: figure]
Vout

V1

V2

Vout
