mabrains/PLL_design/images/Diagrams/PFD/pdf/State_diagram.pdf

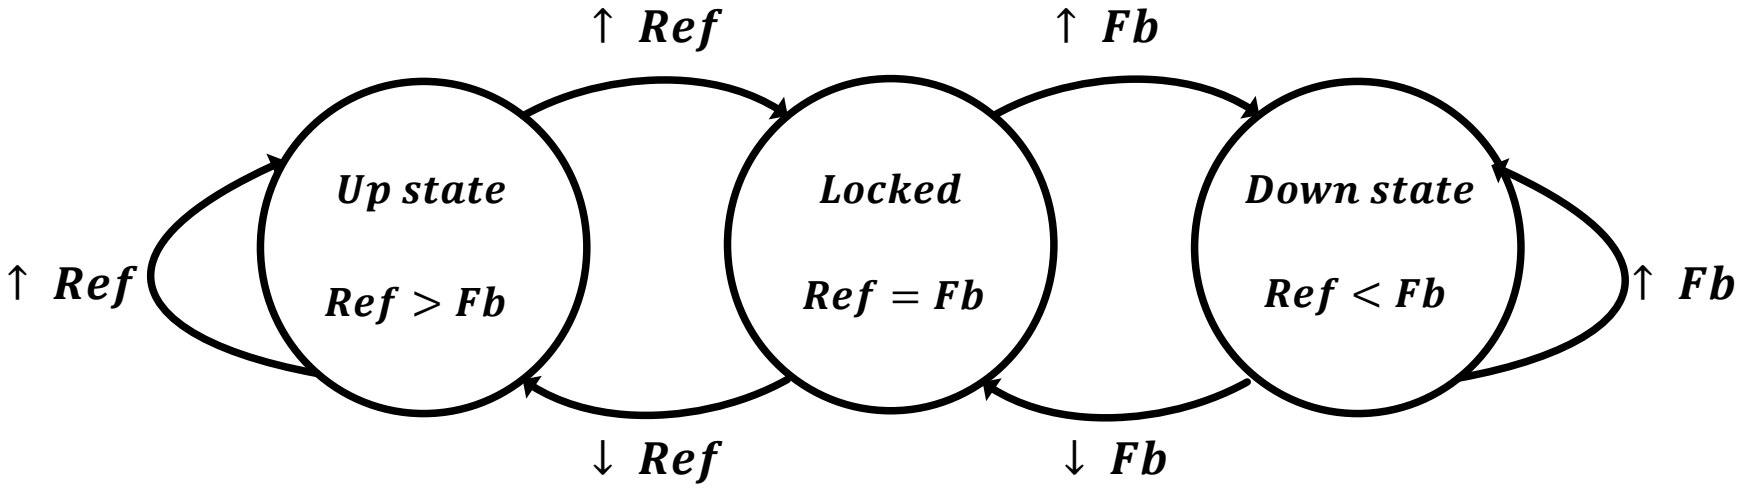
[picture p143: figure]
Up tate; Locked; Down tate; Ref > Fb; Ref = Fb; Ref < Fb; ↑ Ref; ↓ Ref
