mabrains/PLL_design/docs/blocks/vco_images/cmos lc vco buffers.png

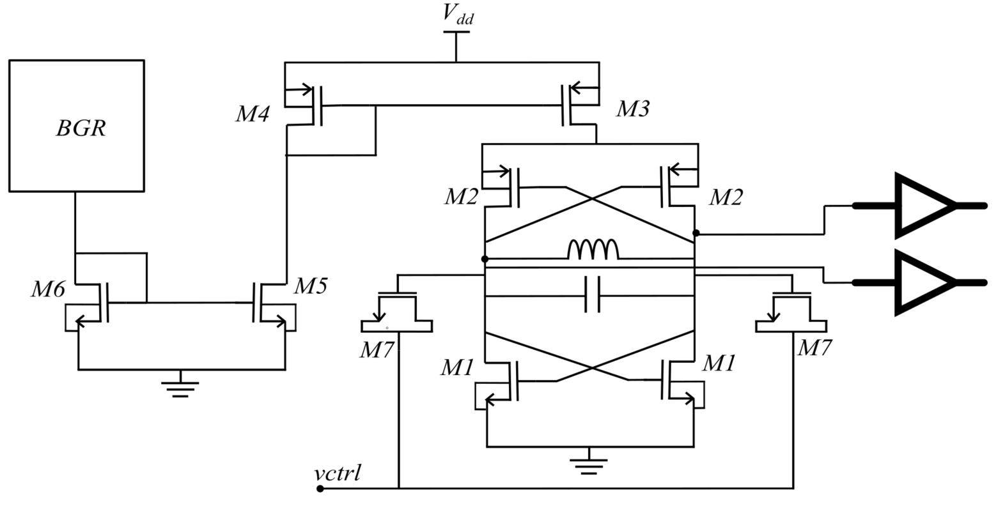
docs/blocks/vco_images/cmos lc vco buffers.png
