mabrains/PLL_design/docs/blocks/vco_images/cross coupled topologies.png

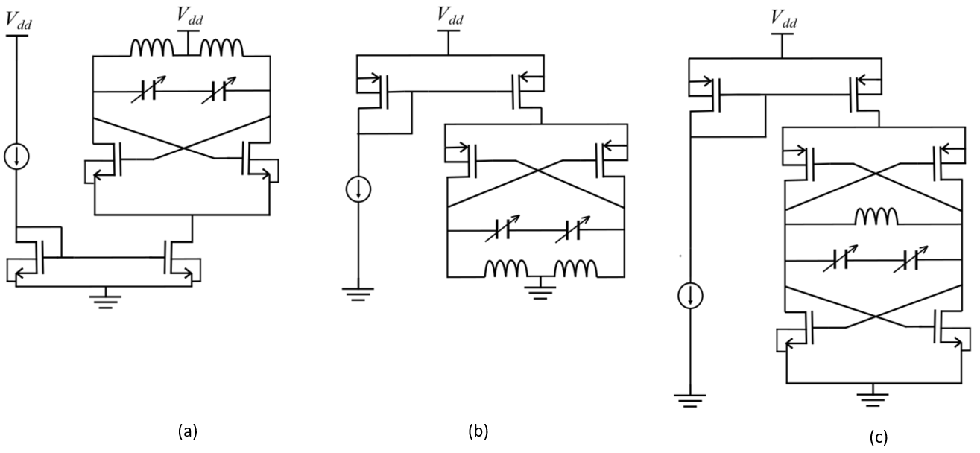
docs/blocks/vco_images/cross coupled topologies.png
