mabrains/PLL_design/docs/blocks/vco_images/inductor pi model.png

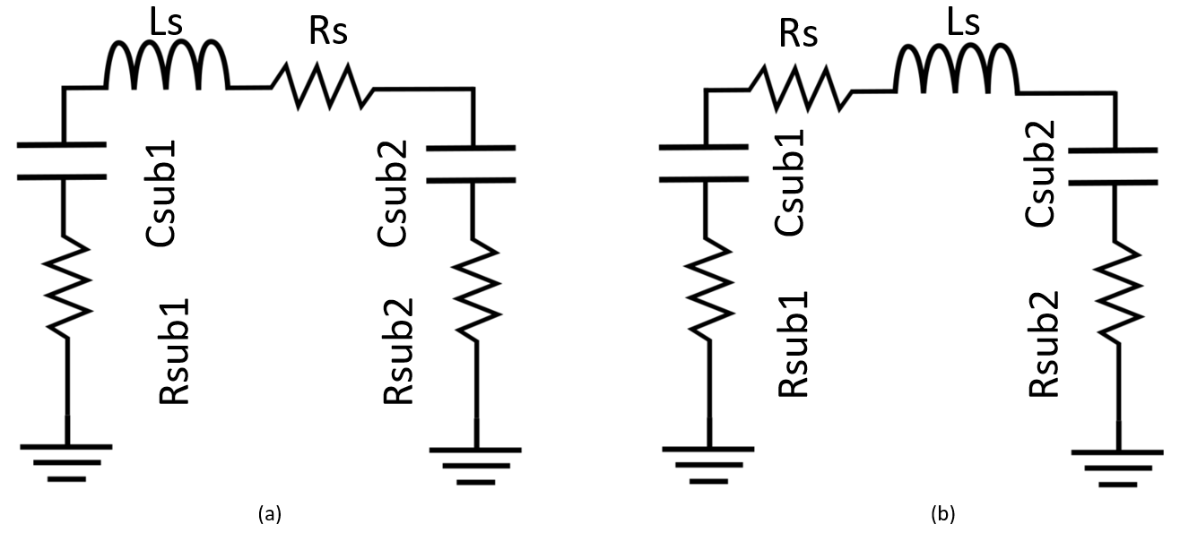
docs/blocks/vco_images/inductor pi model.png
