mabrains/PLL_design/docs/blocks/vco_images/LC_VCO-2-1.png

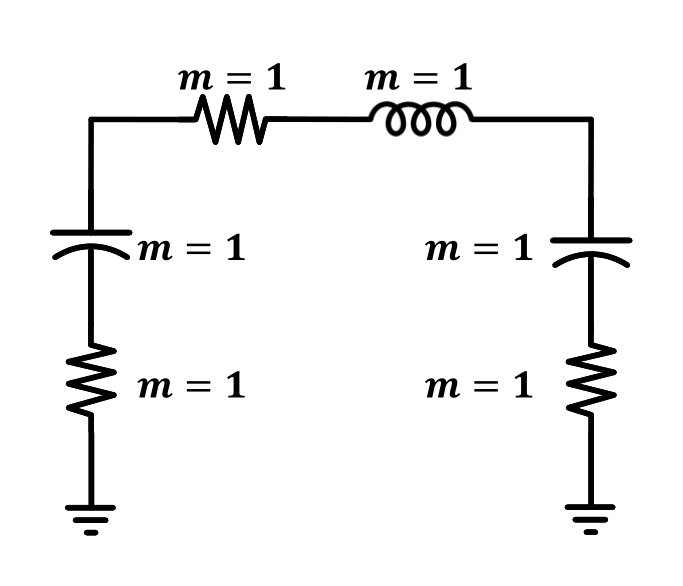
docs/blocks/vco_images/LC_VCO-2-1.png
