mabrains/PLL_design/docs/blocks/vco_images/LC_VCO-6-1.png

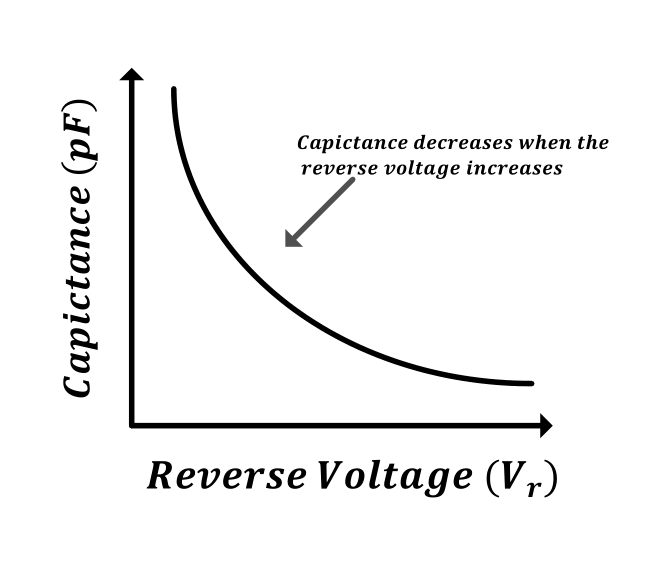
docs/blocks/vco_images/LC_VCO-6-1.png
