mabrains/PLL_design/docs/blocks/vco_images/LC_VCO-8-1.png

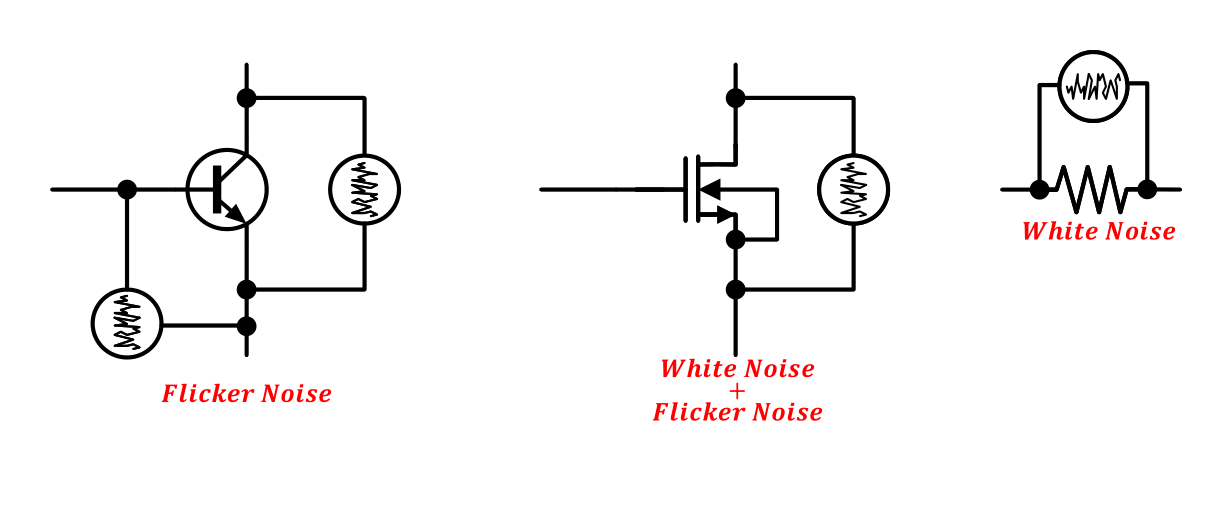
docs/blocks/vco_images/LC_VCO-8-1.png
