mabrains/PLL_design/docs/blocks/vco_images/lcvco topologies.png

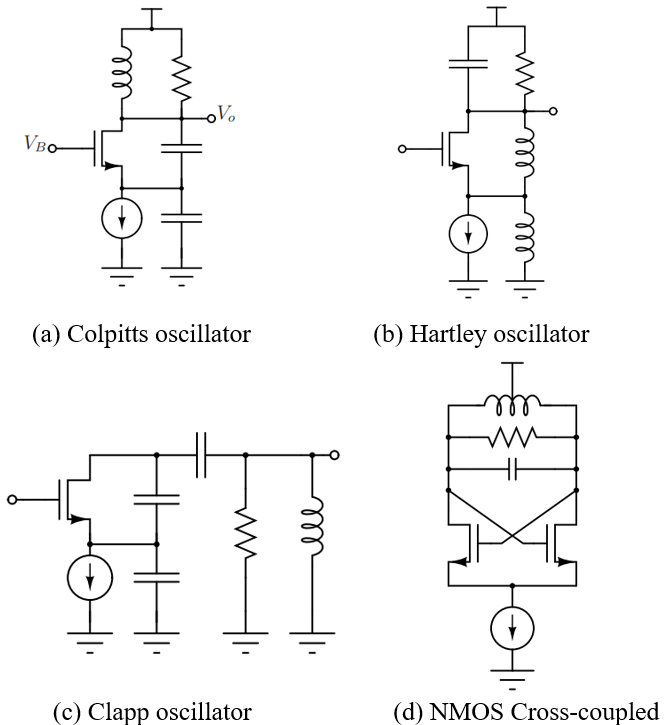
docs/blocks/vco_images/lcvco topologies.png
