mabrains/PLL_design/docs/blocks/vco_images/proposed cmos lc vco.png

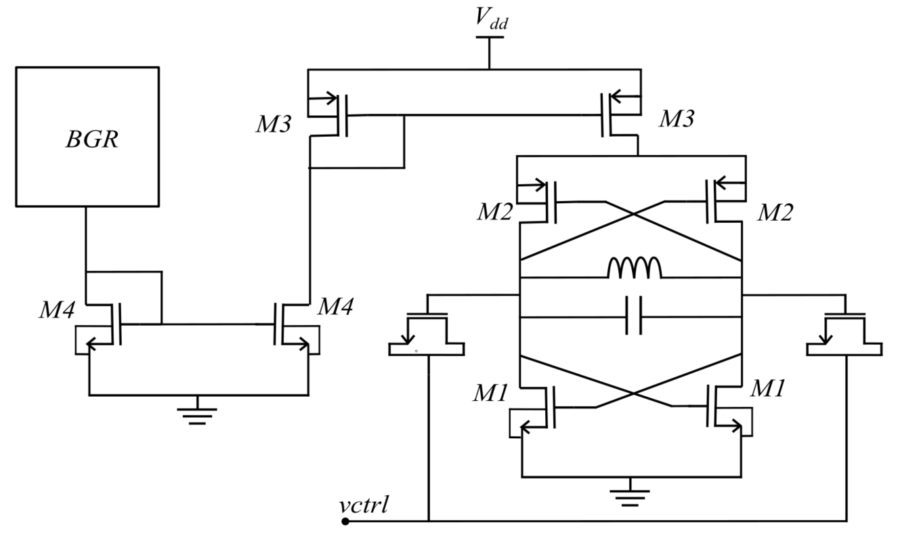
docs/blocks/vco_images/proposed cmos lc vco.png
