mabrains/PLL_design/docs/blocks/vco_images/vco layout with inductor.png

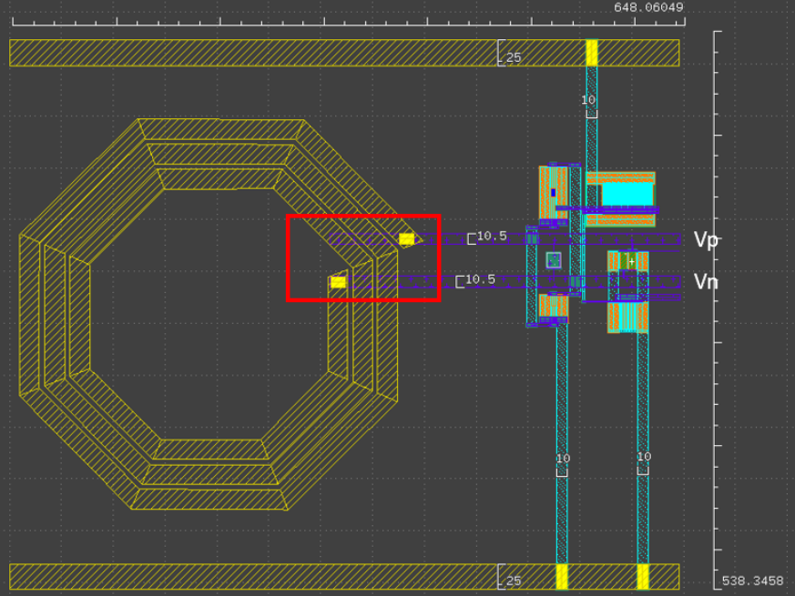
docs/blocks/vco_images/vco layout with inductor.png
