mabrains/PLL_design/docs/blocks/vco_images/vco structure.png

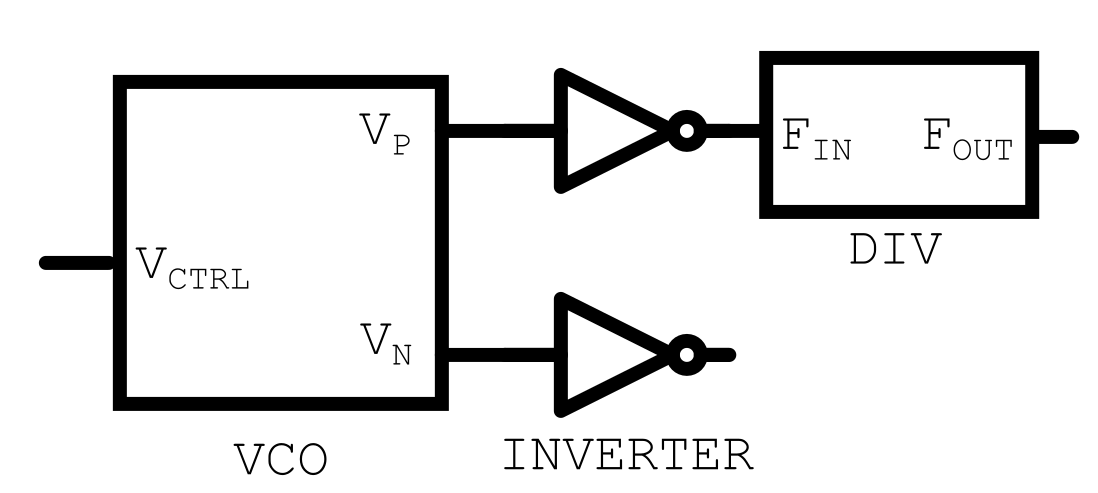
docs/blocks/vco_images/vco structure.png
