mabrains/PLL_design/docs/blocks/xctl_images/Crystal_model.png

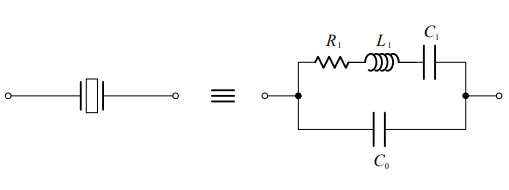
docs/blocks/xctl_images/Crystal_model.png
