mabrains/PLL_design/docs/blocks/xctl_images/pa_eq_model.png

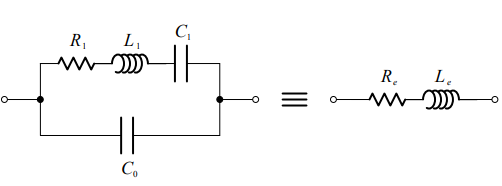
docs/blocks/xctl_images/pa_eq_model.png
