mabrains/PLL_design/docs/blocks/xctl_images/Pierce_crystal.png

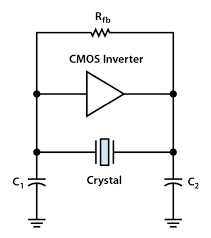
docs/blocks/xctl_images/Pierce_crystal.png
