mabrains/PLL_design/images/Diagrams/Charge pump/png/CP.png

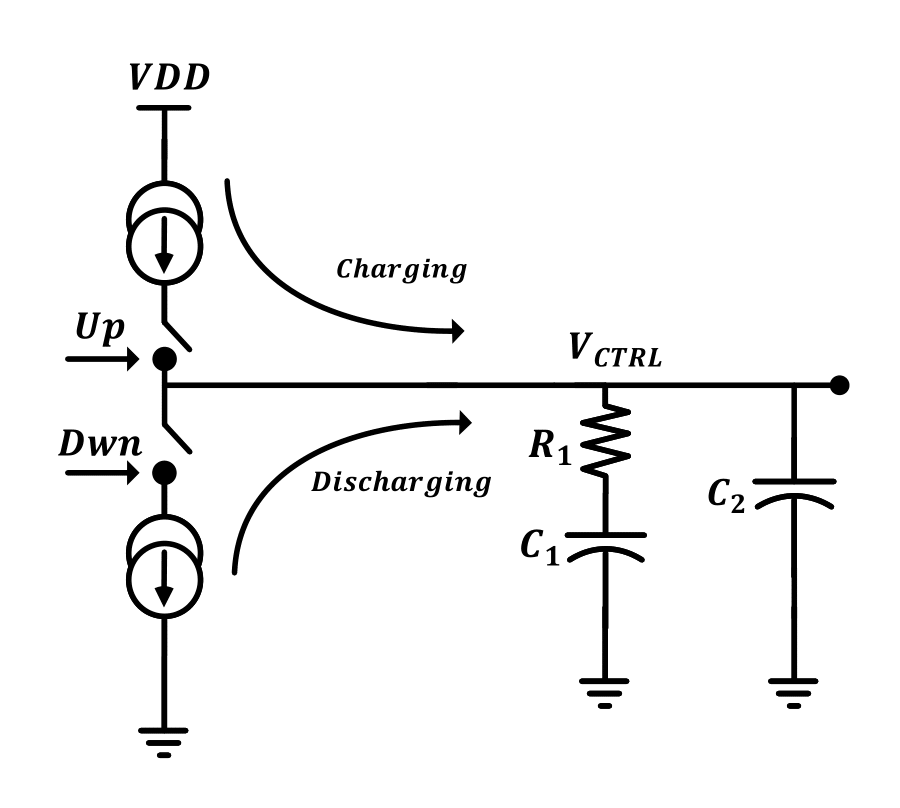
images/Diagrams/Charge pump/png/CP.png
