mabrains/PLL_design/images/Diagrams/Divider/TG.jpg

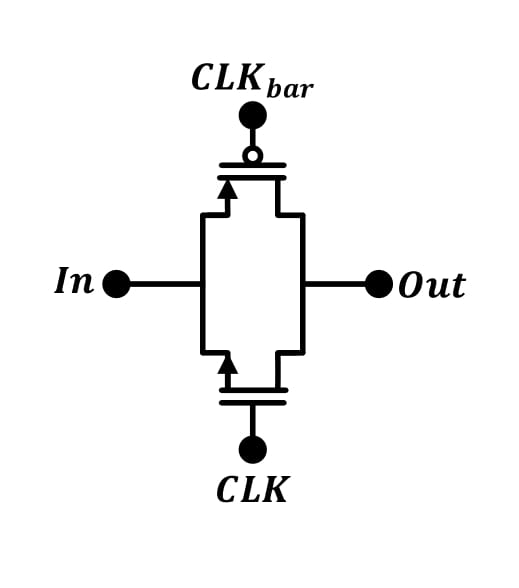
images/Diagrams/Divider/TG.jpg
