mabrains/PLL_design/images/Diagrams/Loop filter/png/2ndorderlpf.png

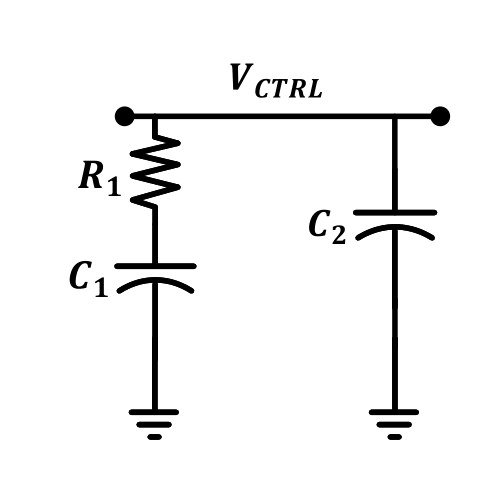
images/Diagrams/Loop filter/png/2ndorderlpf.png
