mabrains/PLL_design/images/schematics/cp.png

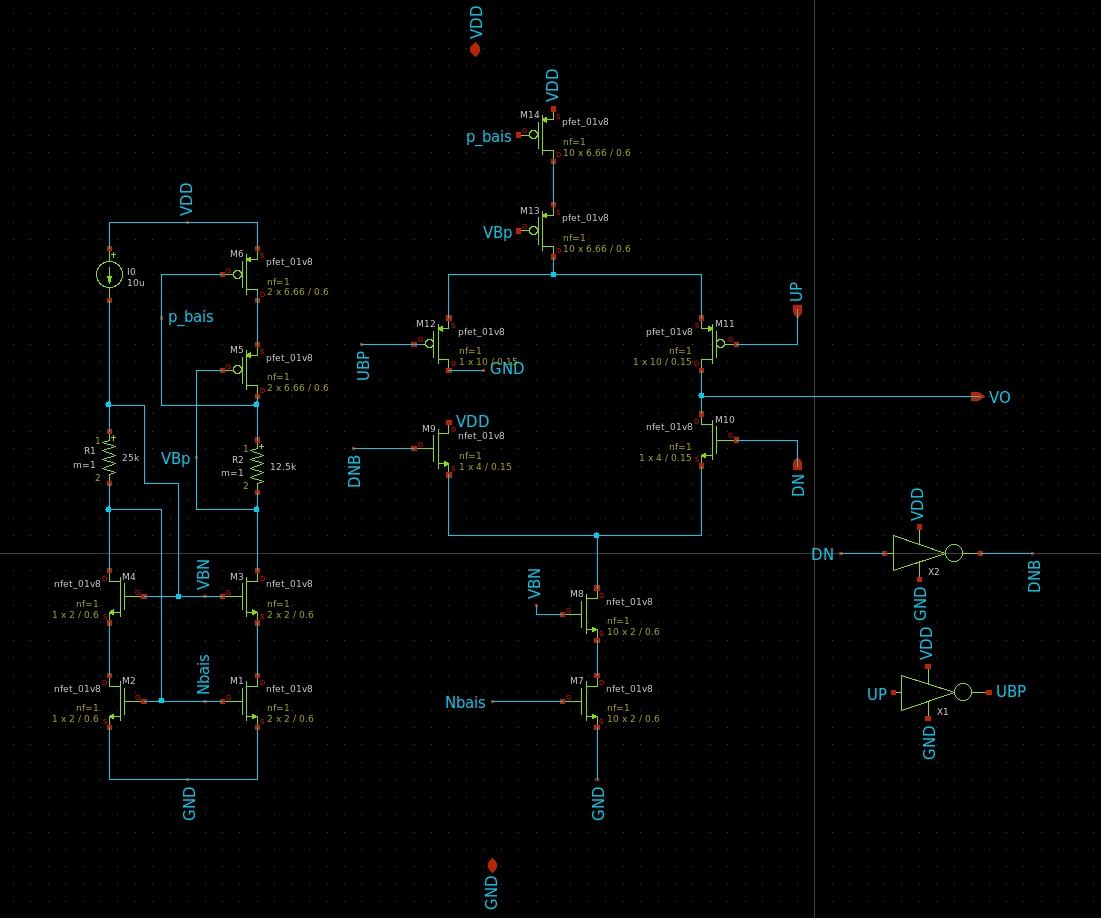
images/schematics/cp.png
