mabrains/PLL_design/images/schematics/cp_inv.png

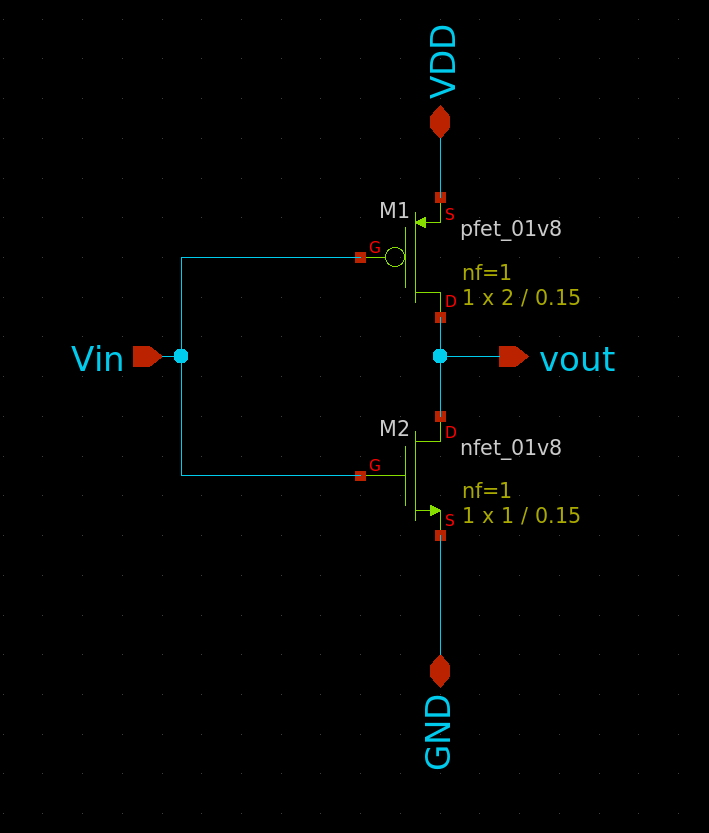
images/schematics/cp_inv.png
