mabrains/PLL_design/images/schematics/Crystal.png

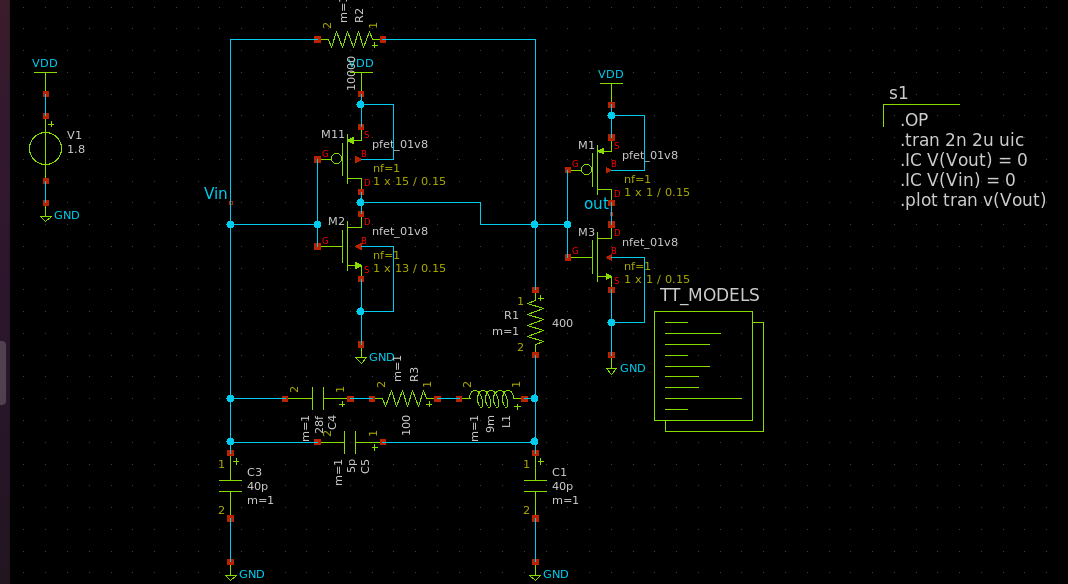
images/schematics/Crystal.png
