mabrains/PLL_design/images/schematics/divider.png

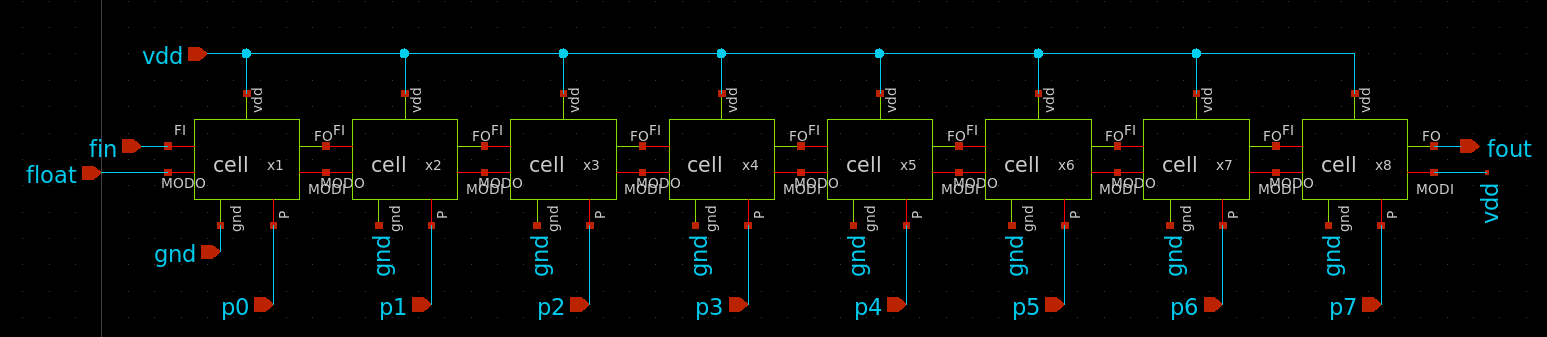
images/schematics/divider.png
