mabrains/PLL_design/images/schematics/divider_and.png

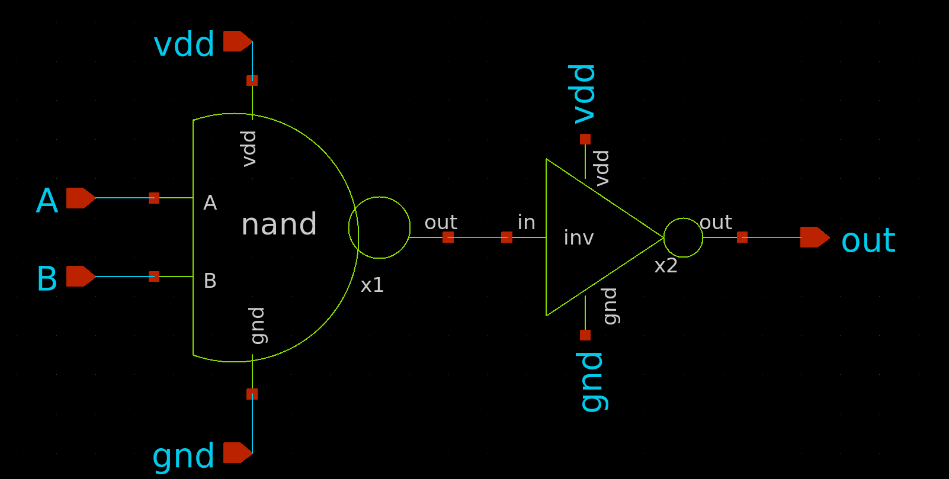
images/schematics/divider_and.png
