mabrains/PLL_design/images/schematics/divider_cell.png

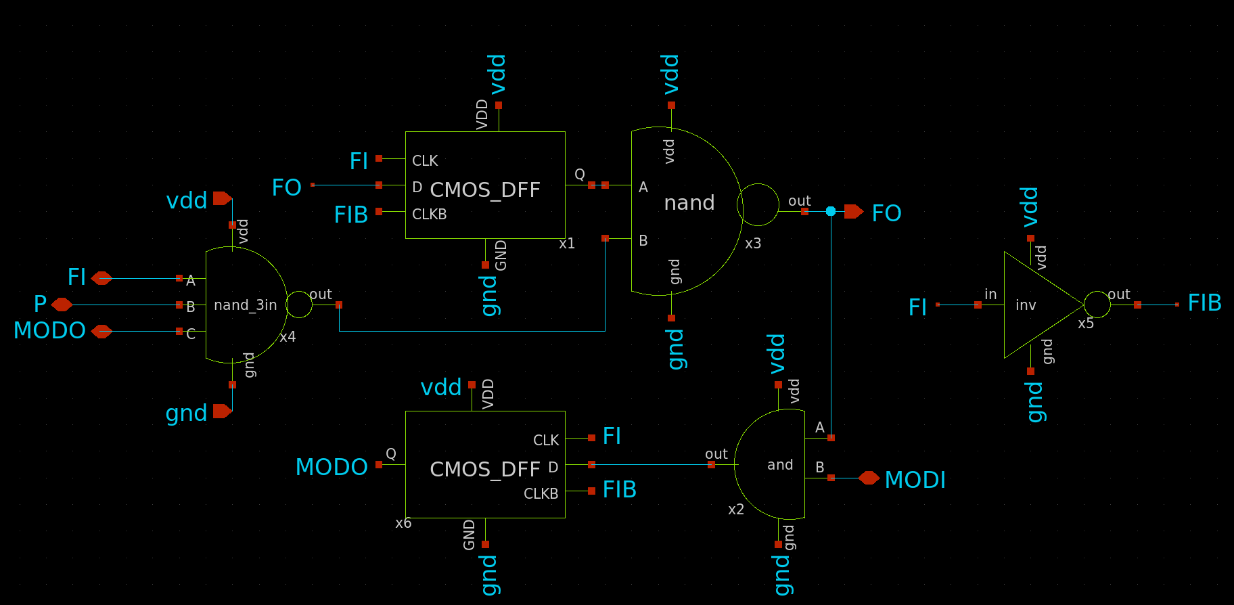
images/schematics/divider_cell.png
