mabrains/PLL_design/images/schematics/divider_dff.png

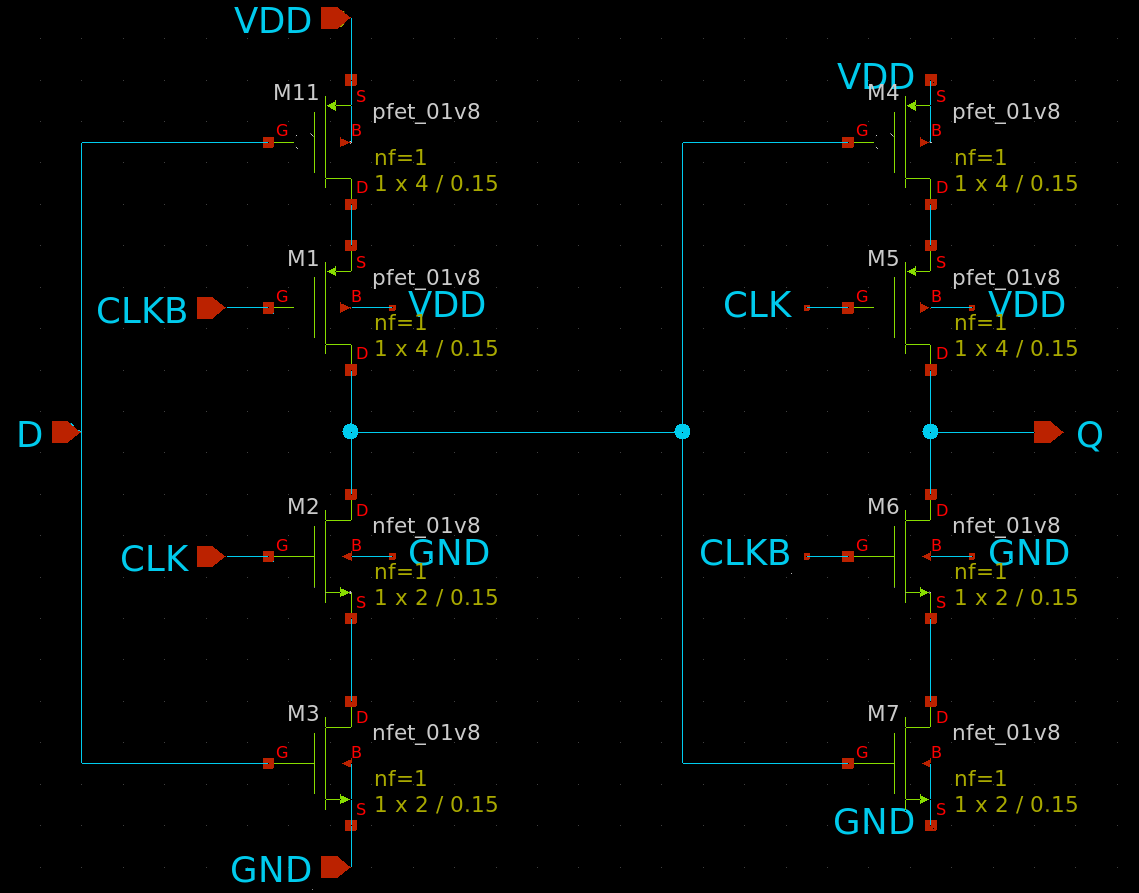
images/schematics/divider_dff.png
