mabrains/PLL_design/images/schematics/divider_inv.png

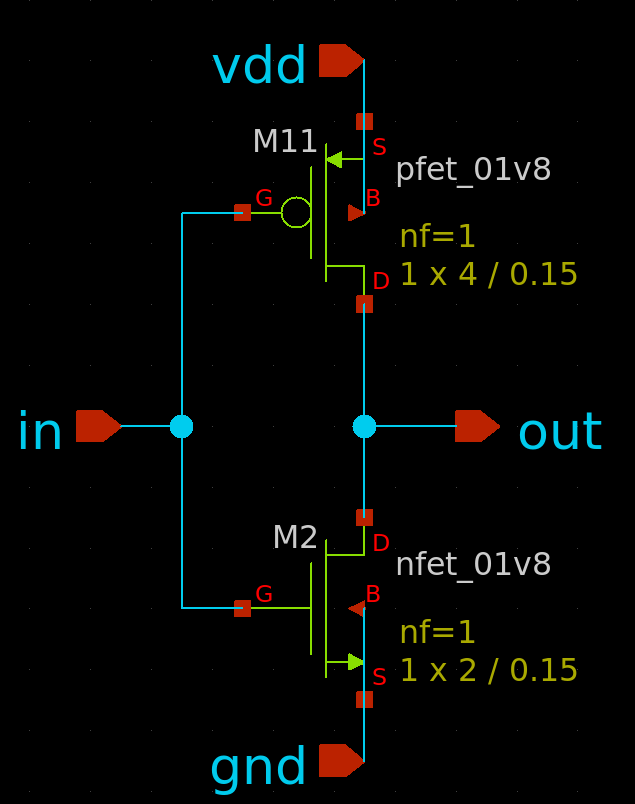
images/schematics/divider_inv.png
