mabrains/PLL_design/images/schematics/divider_nand.png

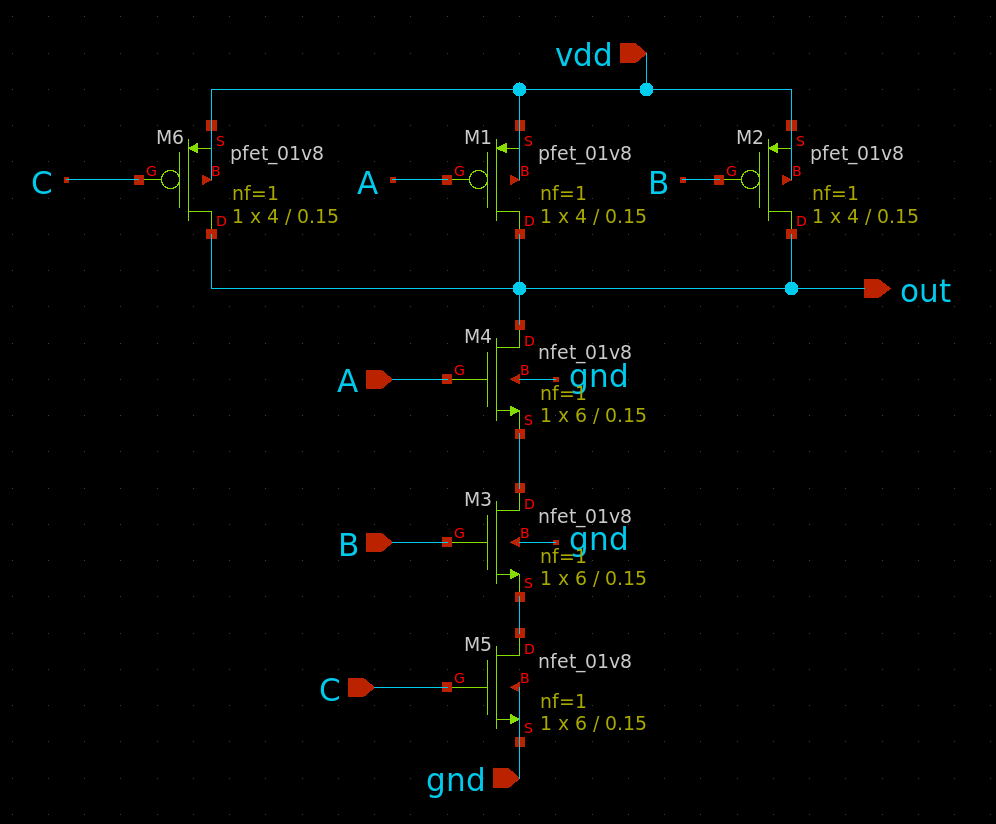
images/schematics/divider_nand.png
