mabrains/PLL_design/images/schematics/pfd.png

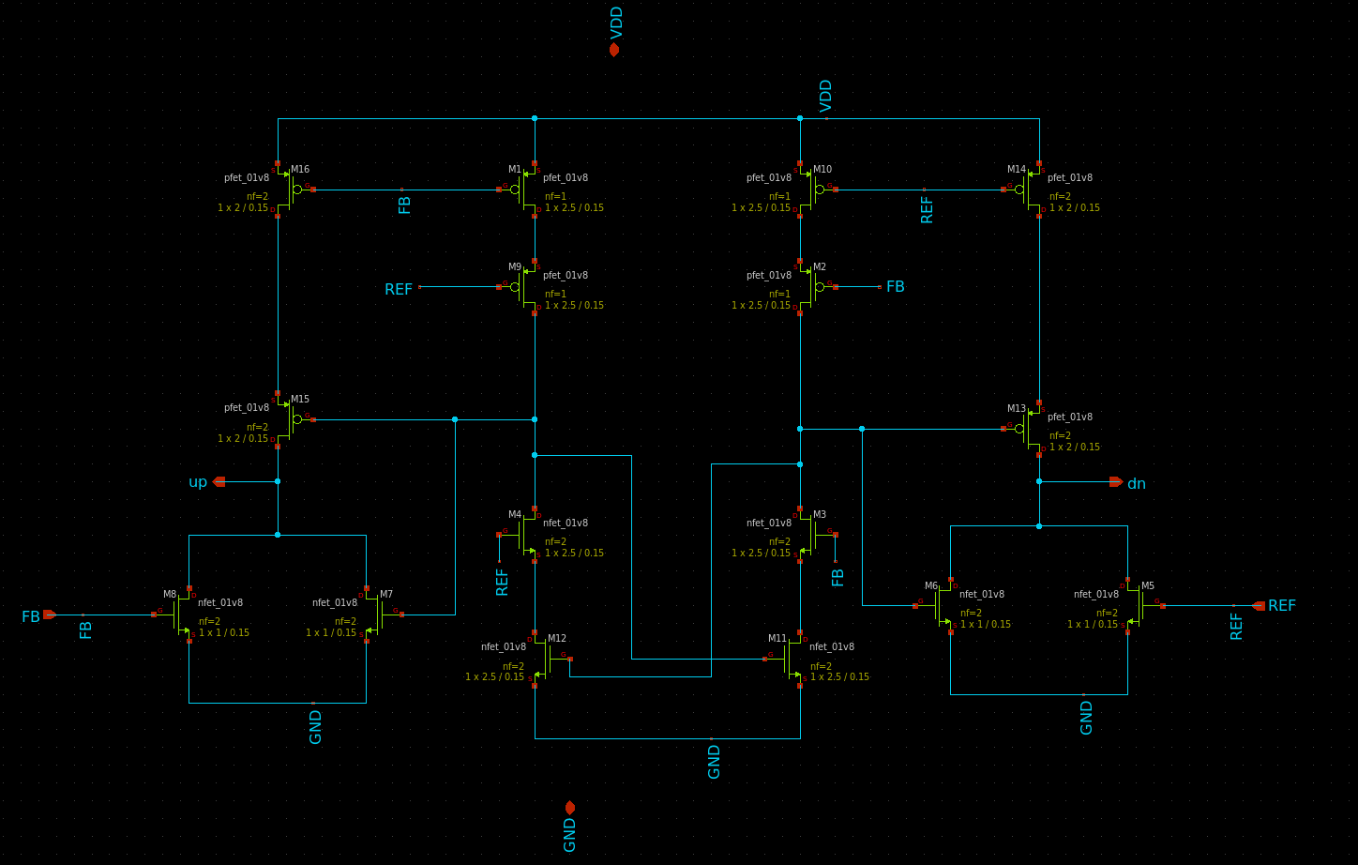
images/schematics/pfd.png
