mabrains/PLL_design/images/Simulations/Cry_sim.png

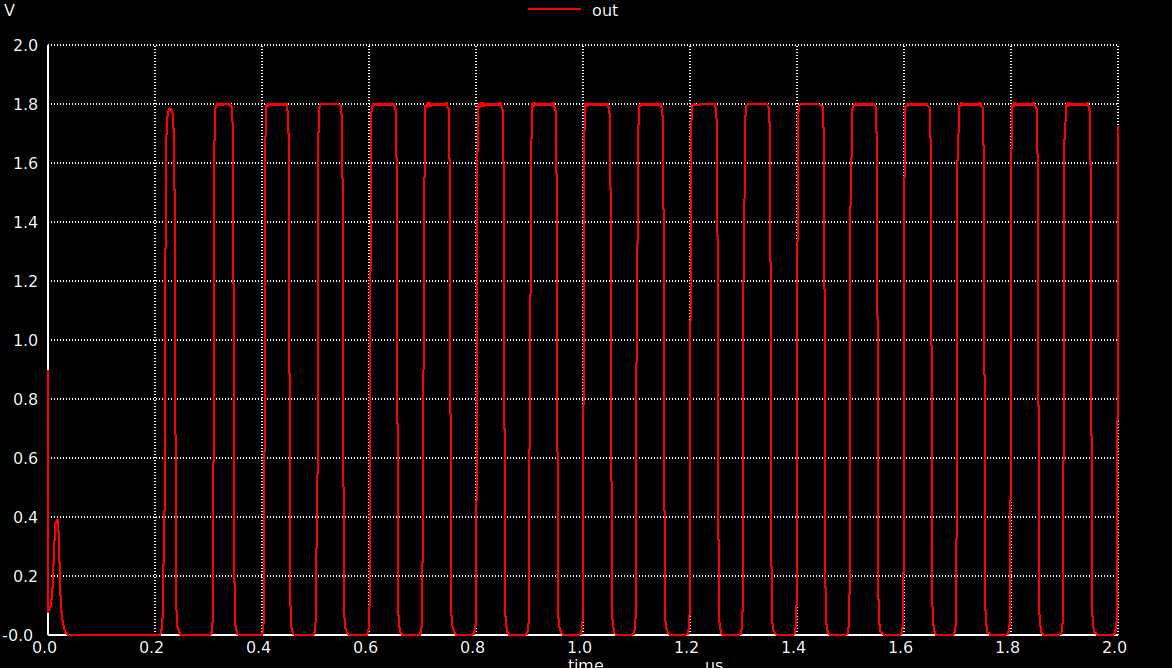
images/Simulations/Cry_sim.png
