mabrains/PLL_design/images/symbols/cp.png

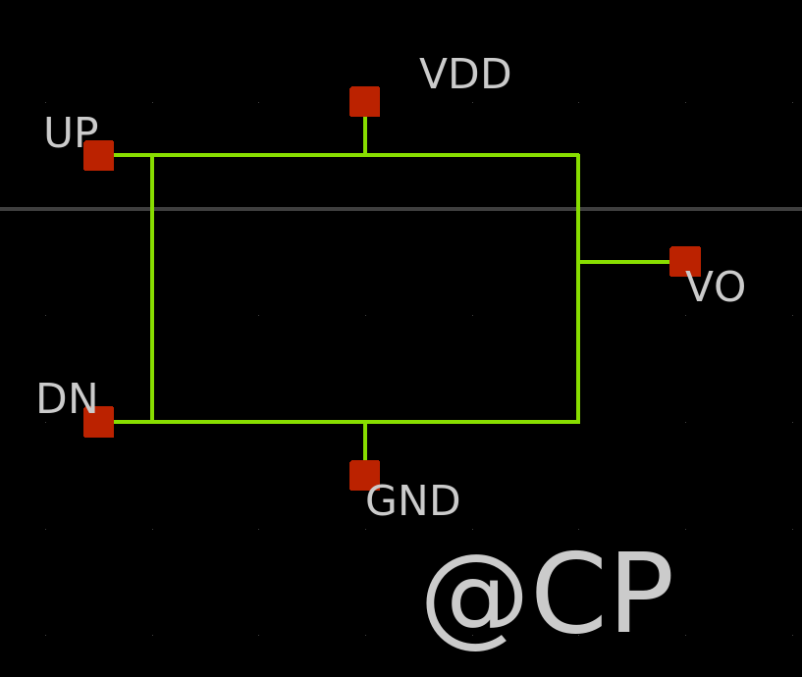
images/symbols/cp.png
