mabrains/PLL_design/images/symbols/pfd.png

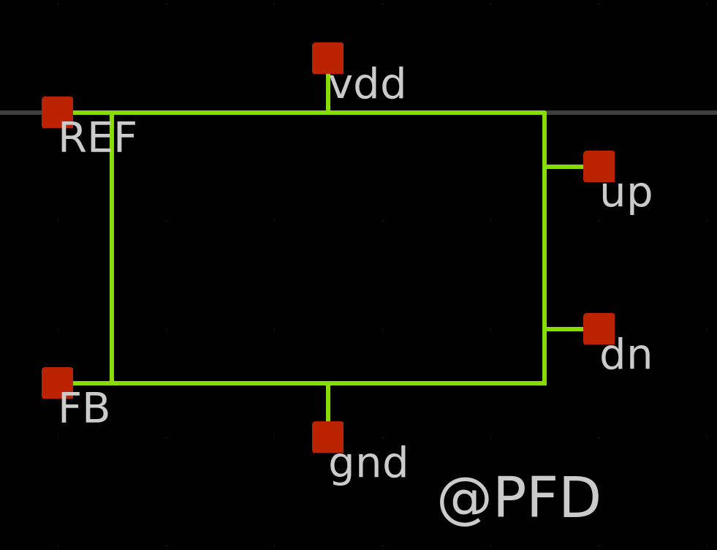
images/symbols/pfd.png
