mabrains/PLL_design/pll/DSM_lib/images/DSM_Diagram.png

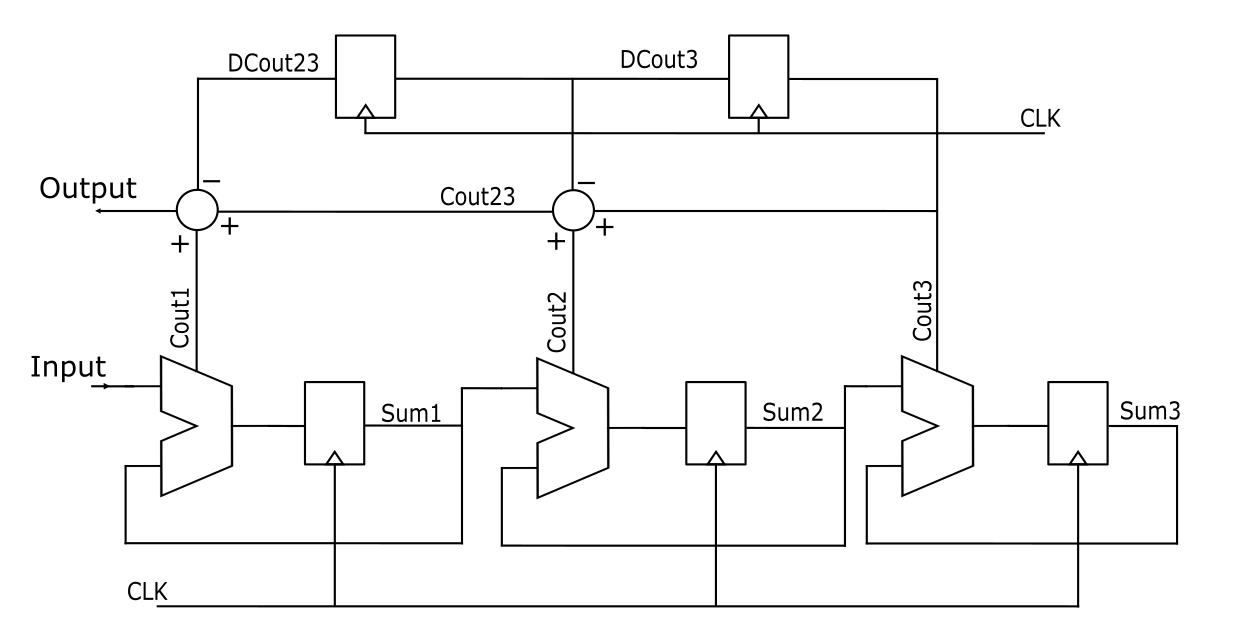
pll/DSM_lib/images/DSM_Diagram.png
