mabrains/PLL_design/pll/Integeration/circuit_integeration/tests/test_div/divider_design_trials/divider_2by3stages/Images/cell_design.png

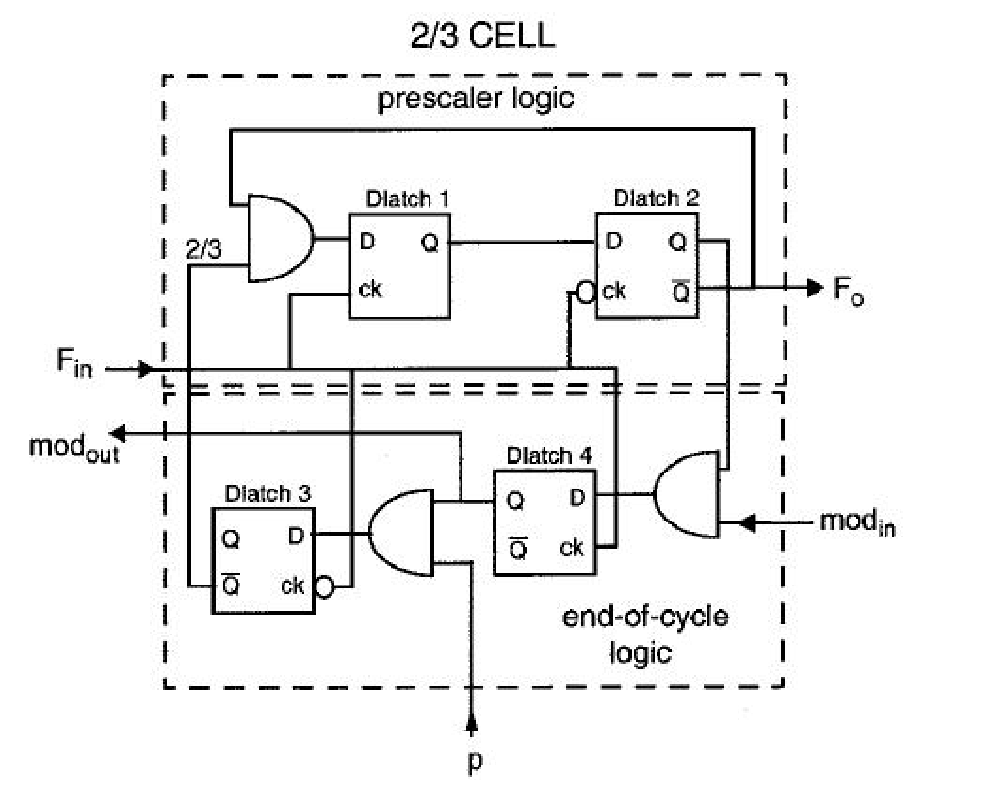
pll/Integeration/circuit_integeration/tests/test_div/divider_design_trials/divider_2by3stages/Images/cell_design.png
