mabrains/PLL_design/pll/lc_vco_lib_Ahmed_Elshahat/CMOS_LC_VCO/CMOS_VCO_corners/Images/fosc_working_corners.png

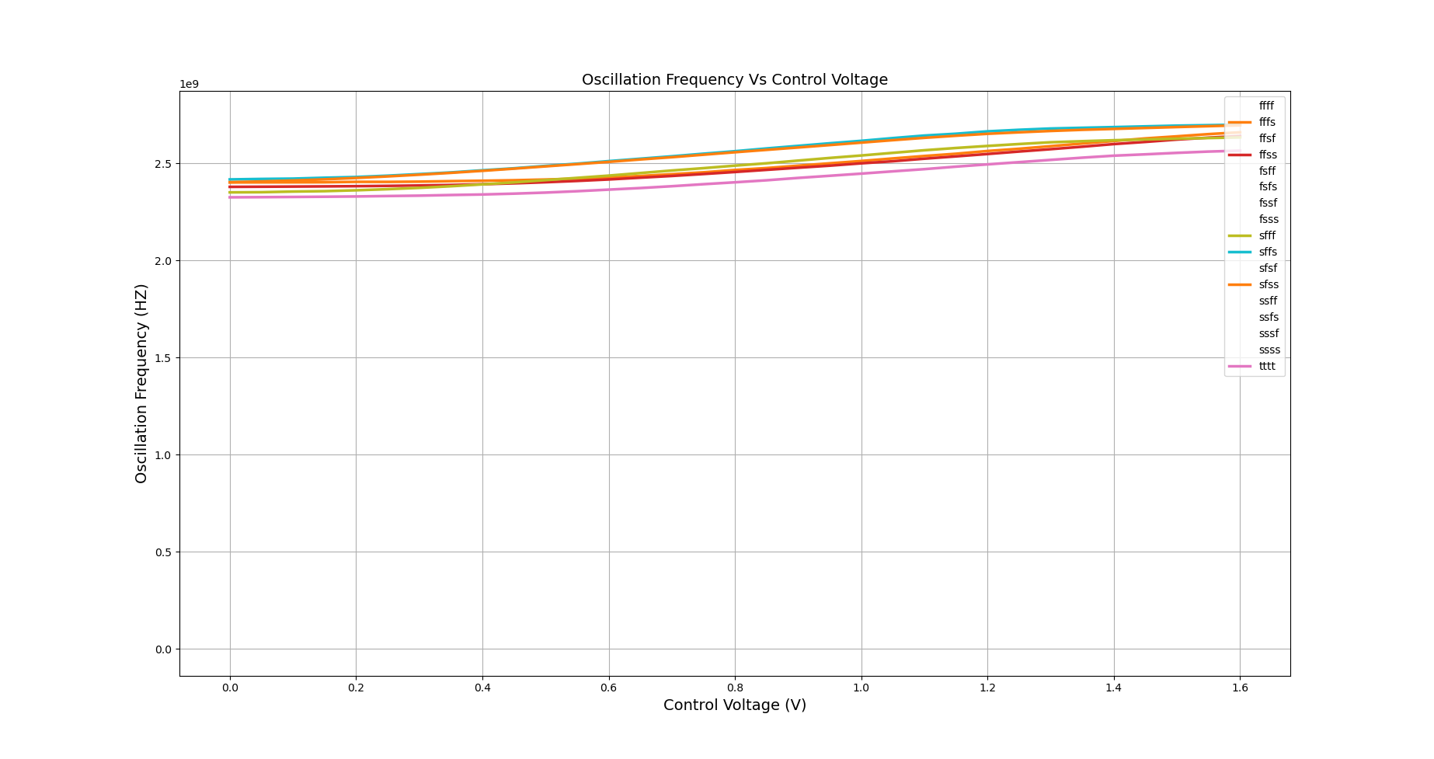
pll/lc_vco_lib_Ahmed_Elshahat/CMOS_LC_VCO/CMOS_VCO_corners/Images/fosc_working_corners.png
