mabrains/PLL_design/pll/lc_vco_lib_Ahmed_Elshahat/CMOS_LC_VCO/CMOS_VCO_corners/Images/kvco_vs_vctrl_modifies.png

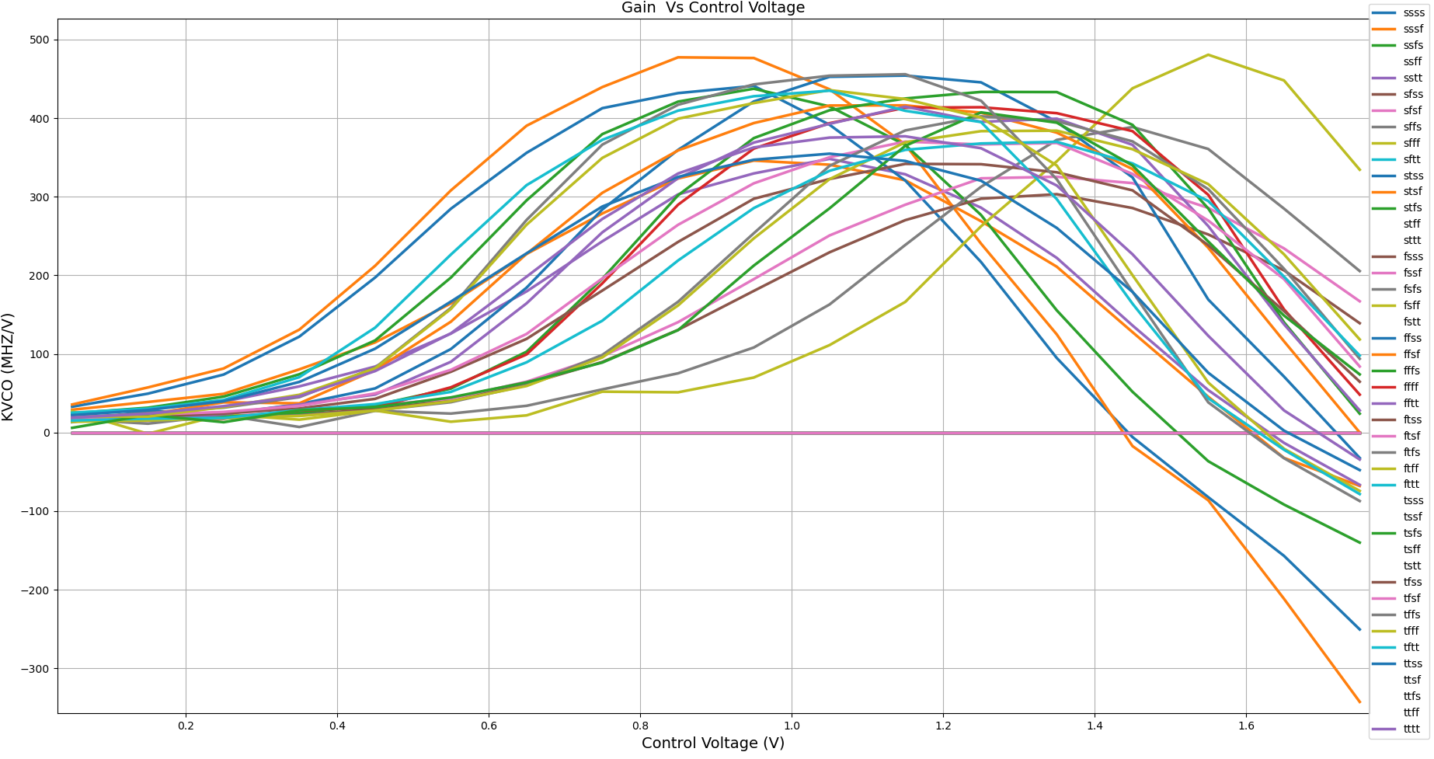
pll/lc_vco_lib_Ahmed_Elshahat/CMOS_LC_VCO/CMOS_VCO_corners/Images/kvco_vs_vctrl_modifies.png
