mabrains/PLL_design/pll/lc_vco_lib_Ahmed_Elshahat/CMOS_LC_VCO/NMOS_charts/Images/CGS_vs_gm_id.png

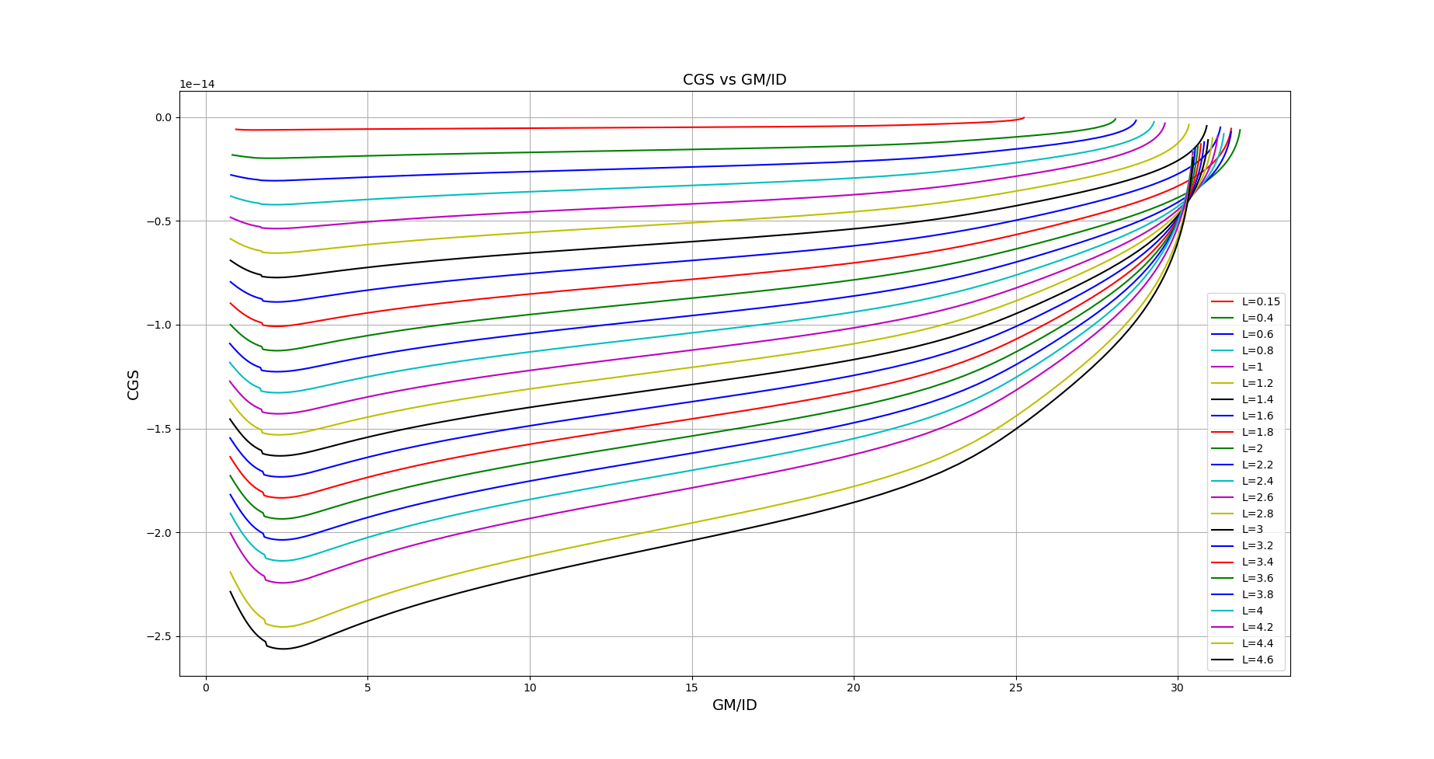
pll/lc_vco_lib_Ahmed_Elshahat/CMOS_LC_VCO/NMOS_charts/Images/CGS_vs_gm_id.png
