mabrains/PLL_design/pll/lc_vco_lib_Ahmed_Elshahat/CMOS_LC_VCO/PMOS_charts/Images/gm_vs_gm_over_id.png

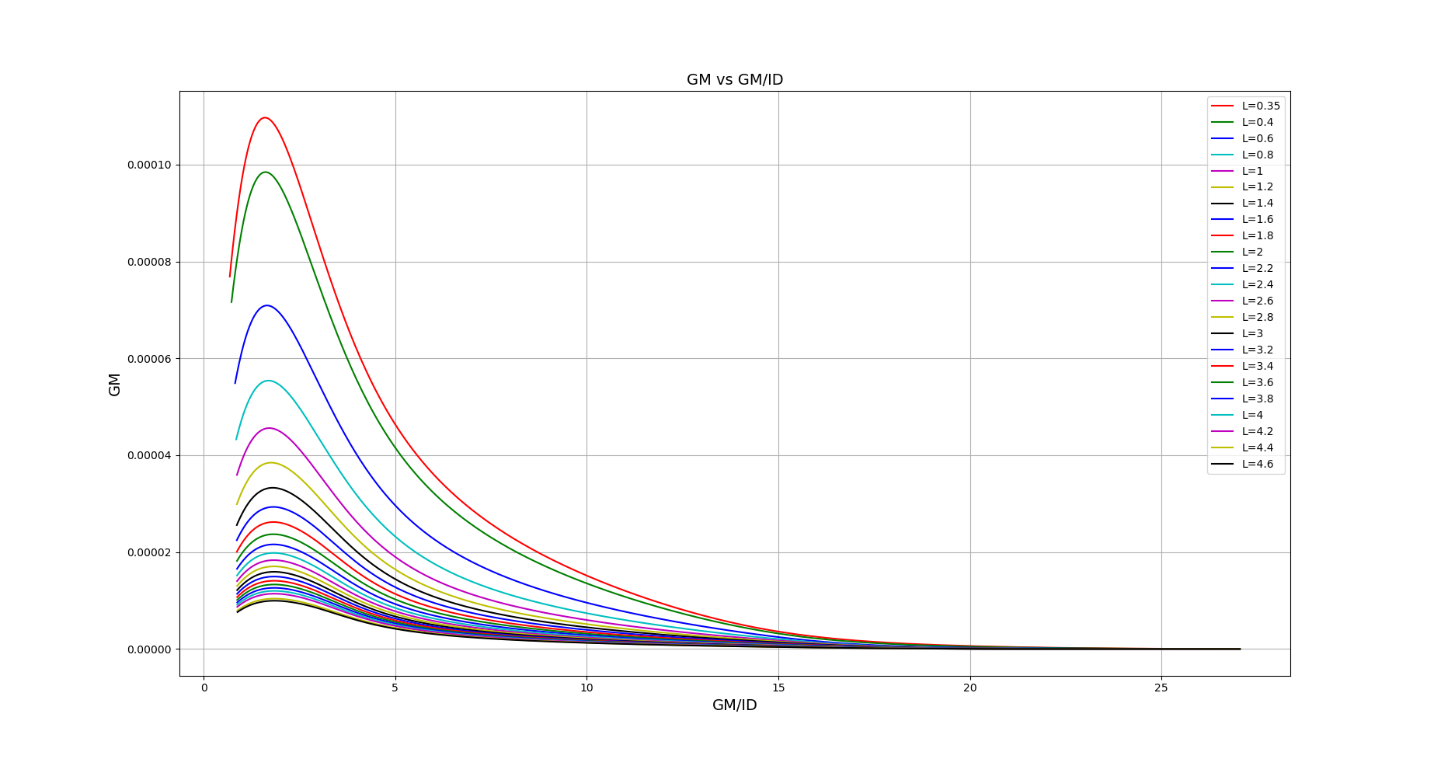
pll/lc_vco_lib_Ahmed_Elshahat/CMOS_LC_VCO/PMOS_charts/Images/gm_vs_gm_over_id.png
