mabrains/PLL_design/pll/lc_vco_lib_Ahmed_Elshahat/CMOS_LC_VCO/Varactor/Images/Capacitance_vs_volatge.png

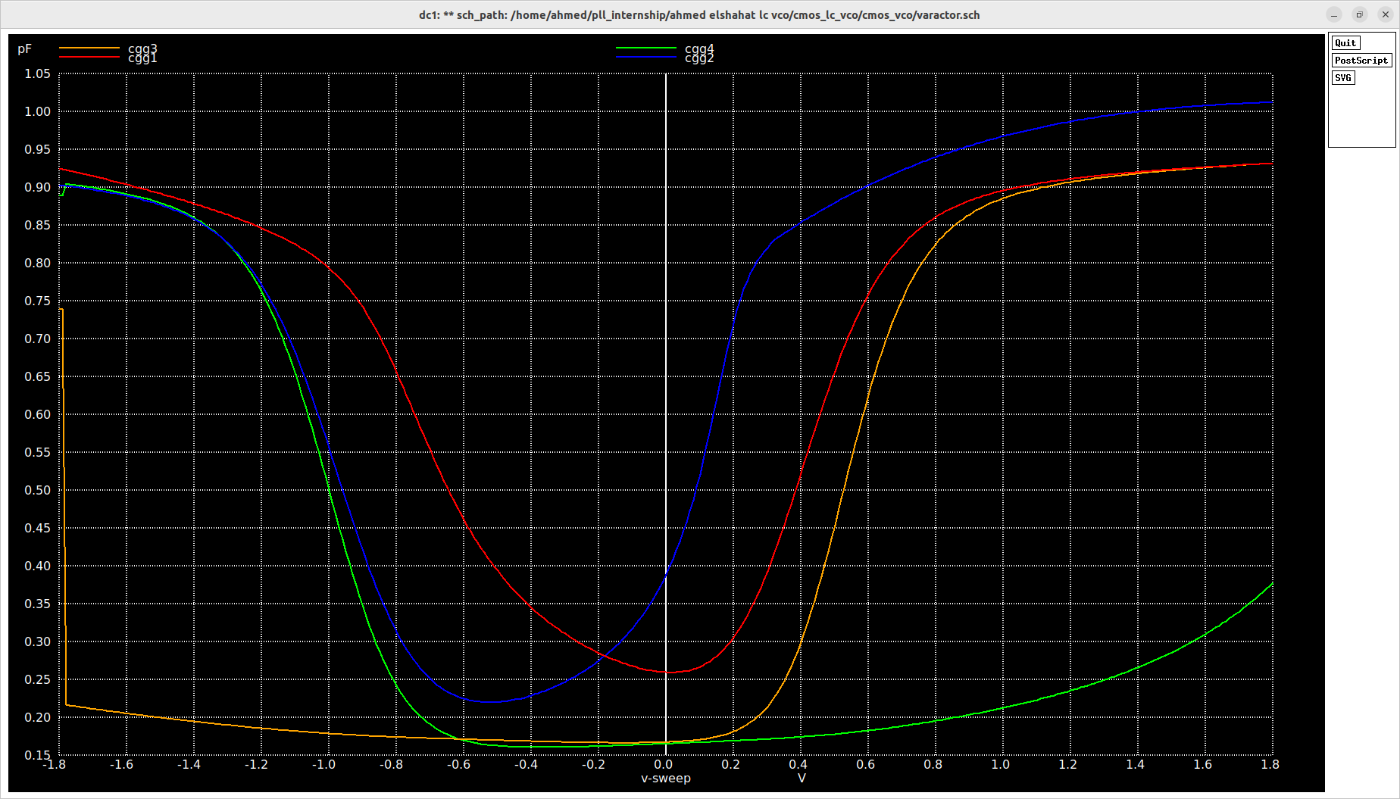
pll/lc_vco_lib_Ahmed_Elshahat/CMOS_LC_VCO/Varactor/Images/Capacitance_vs_volatge.png
