mabrains/PLL_design/pll/lc_vco_lib_Ahmed_Elshahat/phase_nosie_analysis/CS_PN/images/phaseNoise1.png

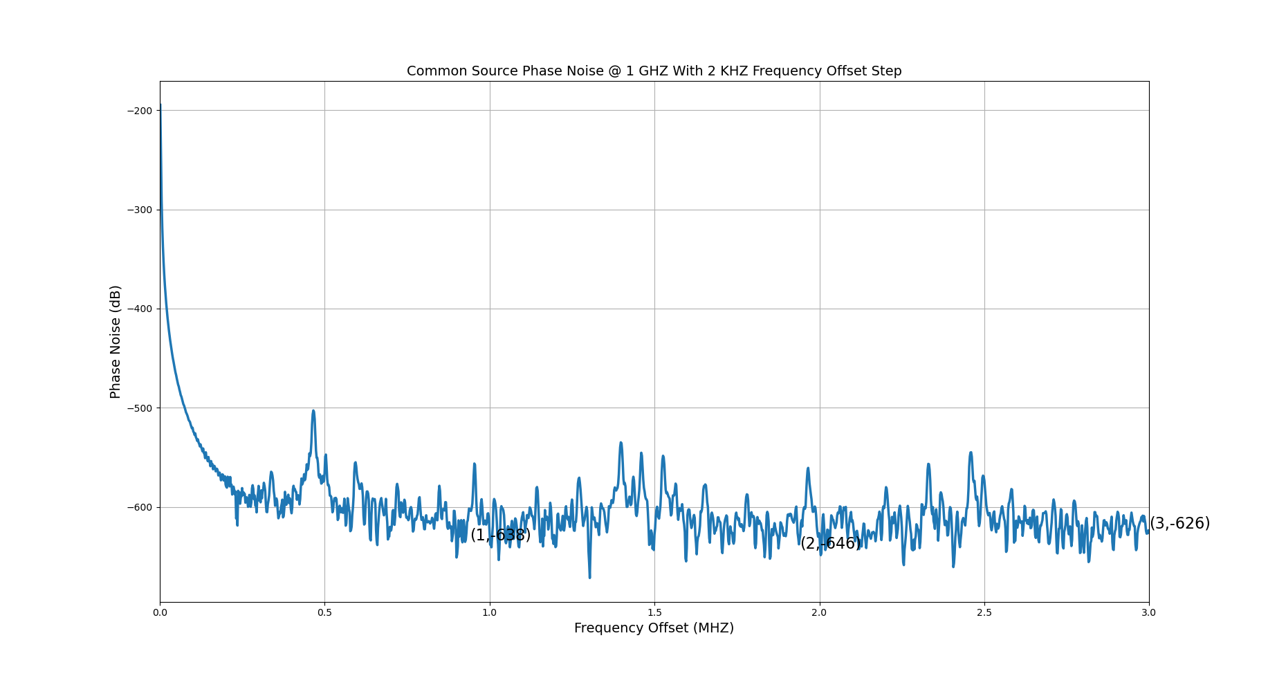
pll/lc_vco_lib_Ahmed_Elshahat/phase_nosie_analysis/CS_PN/images/phaseNoise1.png
