mabrains/PLL_design/pll/system/python_model/images/1st_sample_images/1.png

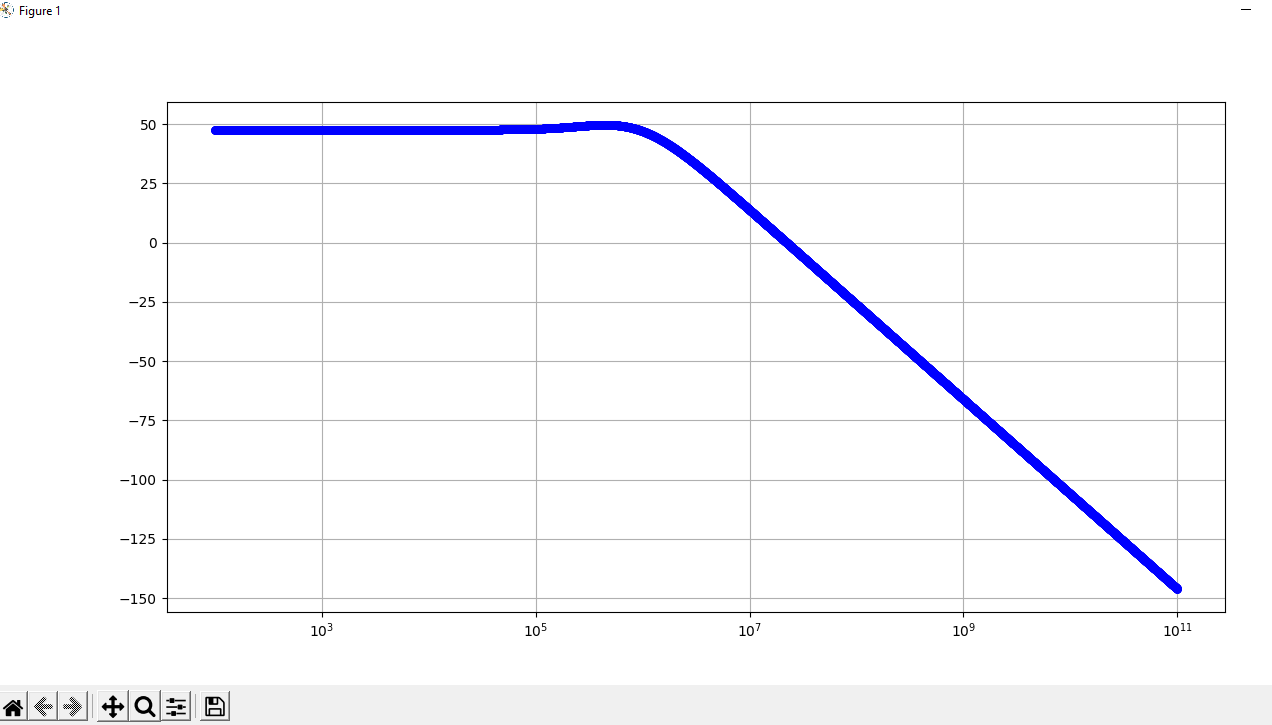
pll/system/python_model/images/1st_sample_images/1.png
