mabrains/PLL_design/pll_int/PLL/layout/images/integer_pll_after_modifying_supply_rails.png

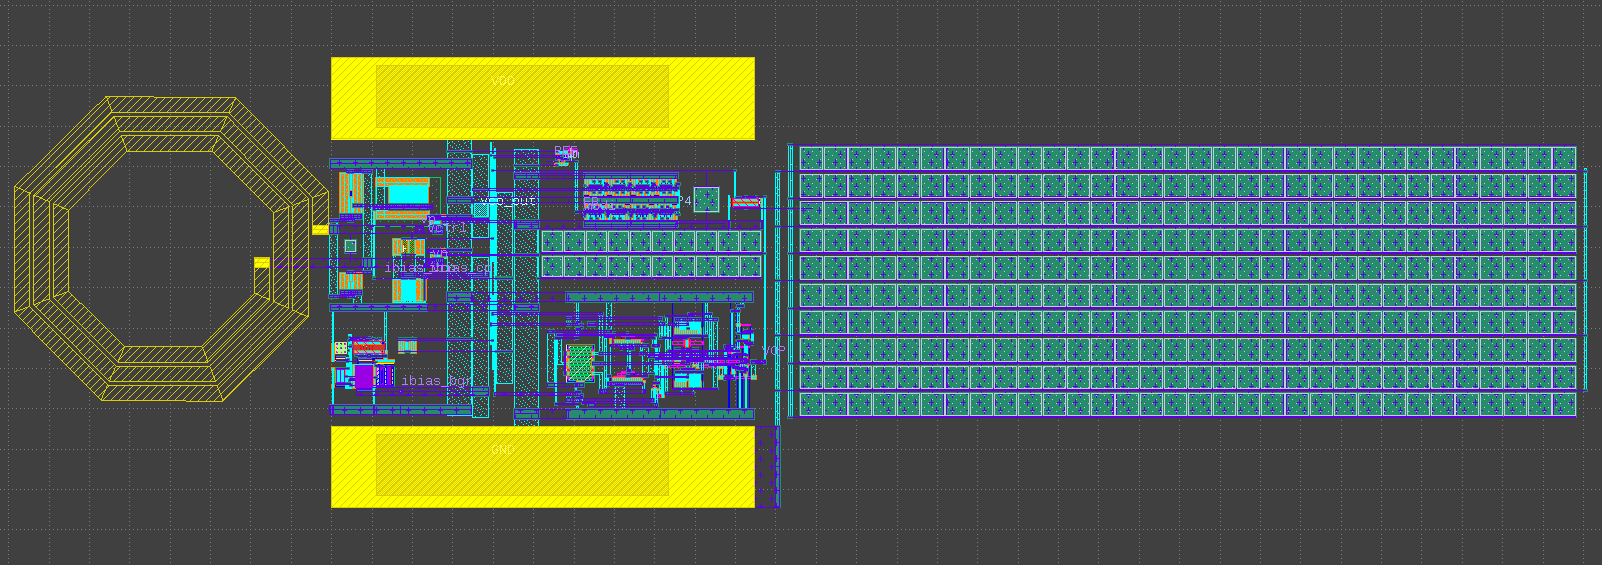
pll_int/PLL/layout/images/integer_pll_after_modifying_supply_rails.png
