mabrains/PLL_design/pll_int/PLL/layout/lvs_klatout/images/integer_pll_passing_lvs.png

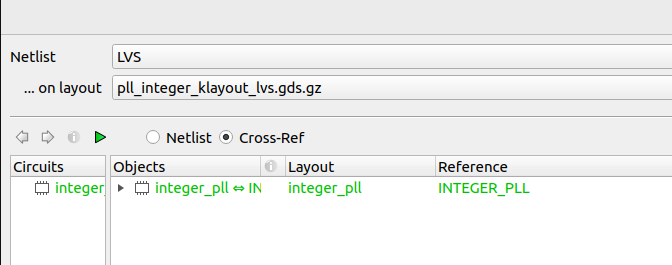
pll_int/PLL/layout/lvs_klatout/images/integer_pll_passing_lvs.png
