mabrains/PLL_design/pll_int/PLL/results/integer_pll_integrated_schematic/images/vco_fft.png

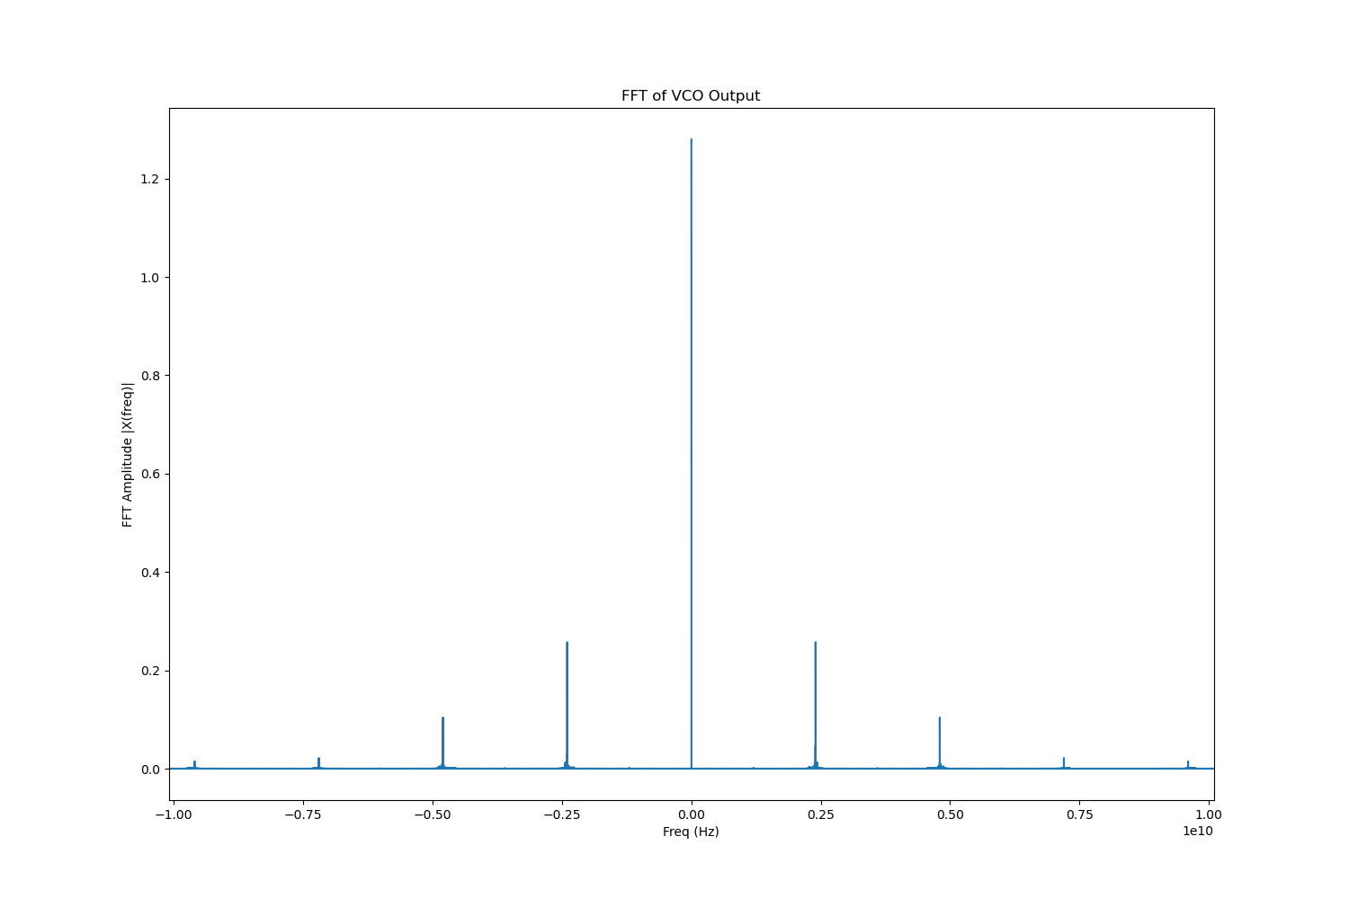
pll_int/PLL/results/integer_pll_integrated_schematic/images/vco_fft.png
