mabrains/PLL_design/pll_int/PLL/results/integer_pll_integrated_schematic_cp_nonideal_cs/images/vco_fft.png

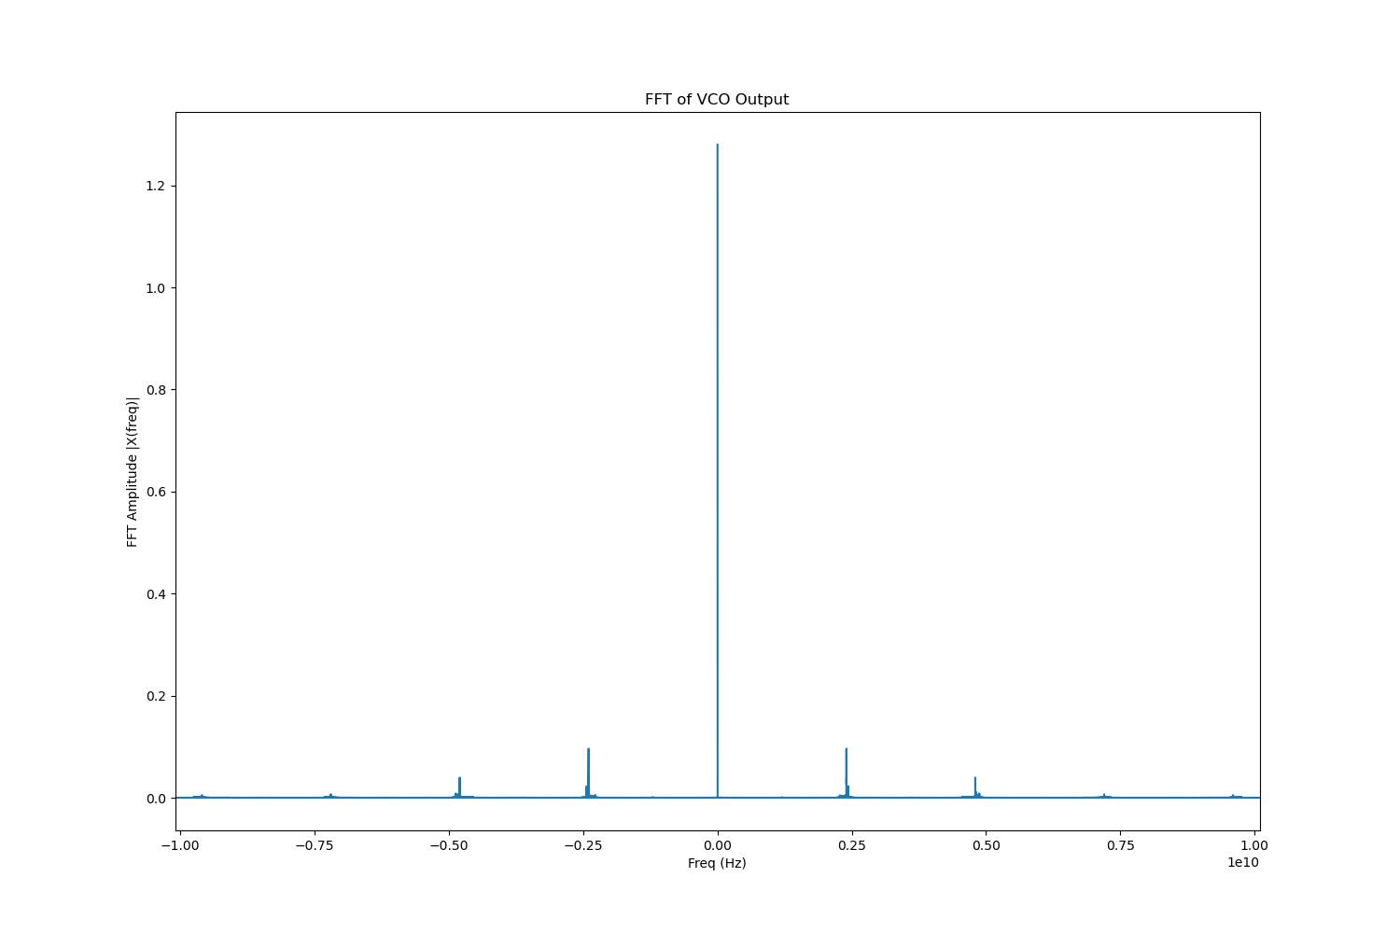
pll_int/PLL/results/integer_pll_integrated_schematic_cp_nonideal_cs/images/vco_fft.png
