mabrains/PLL_design/pll_int/PLL/results/integer_pll_integrated_schematic_with_buffer/images/vco_fft.png

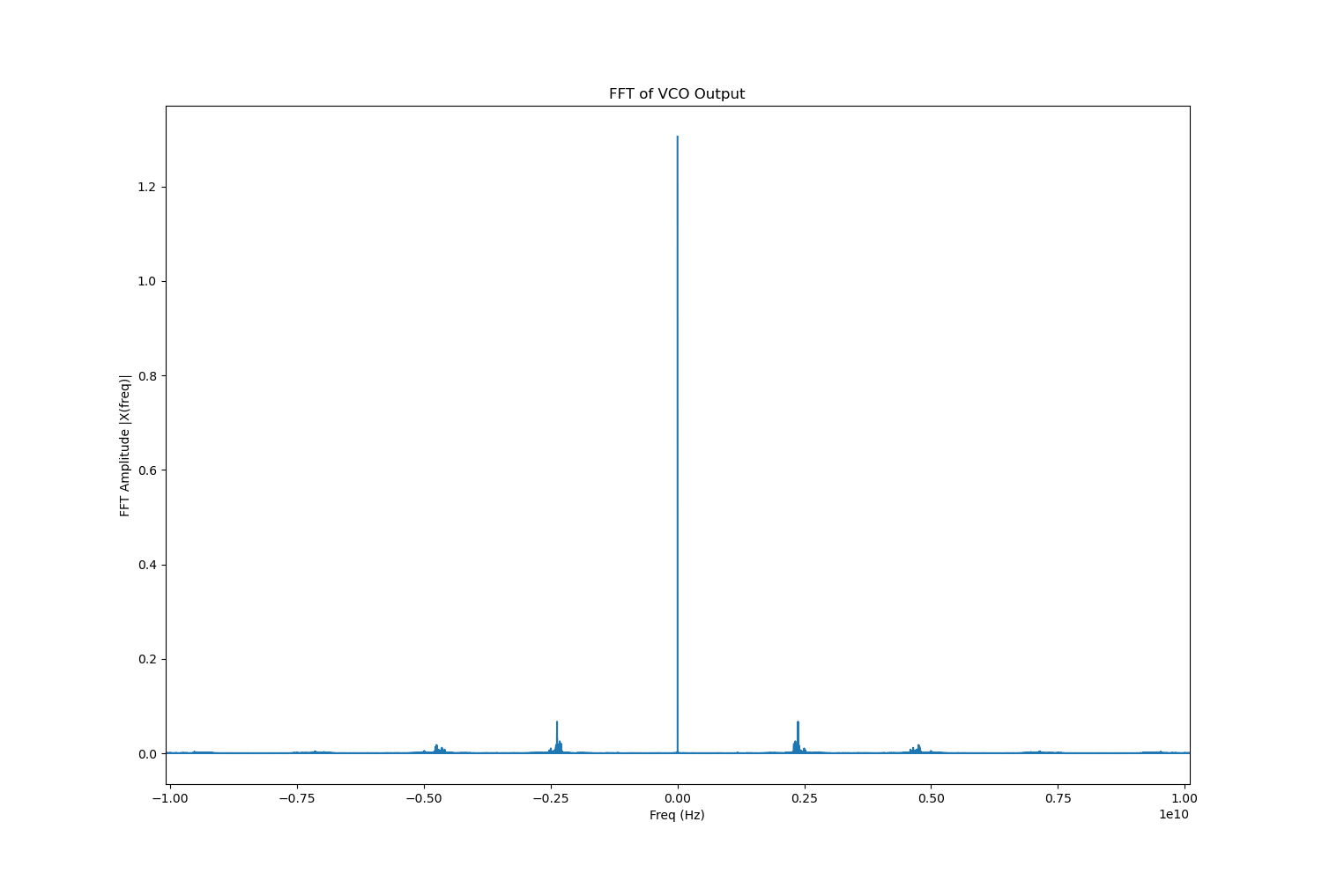
pll_int/PLL/results/integer_pll_integrated_schematic_with_buffer/images/vco_fft.png
