mabrains/PLL_design/pll_int/DSM/testbench/OpenLane/runs/RUN_2022.10.02_17.39.07/reports/metrics.csv

design | design_name | config | flow_status | total_runtime | routed_runtime | (Cell/mm^2)/Core_Util | DIEAREA_mm^2 | CellPer_mm^2 | OpenDP_Util | Peak_Memory_Usage_MB | cell_count | tritonRoute_violations | Short_violations | MetSpc_violations | OffGrid_violations | MinHole_violations | Other_violations | Magic_violations | antenna_violations | lvs_total_errors | cvc_total_errors | klayout_violations | wire_length | vias | wns | pl_wns | optimized_wns | fastroute_wns | spef_wns | tns | pl_tns | optimized_tns | fastroute_tns | spef_tns | HPWL | routing_layer1_pct | routing_layer2_pct | routing_layer3_pct | routing_layer4_pct | routing_layer5_pct | routing_layer6_pct | wires_count | wire_bits | public_wires_count | public_wire_bits | memories_count | memory_bits | processes_count | cells_pre_abc | AND | DFF | NAND | NOR | OR | XOR | XNOR | MUX | inputs | outputs
/home/farag/open_design_environment/tools/OpenLane-2022.09.08/designs/DSM | DSM | RUN_2022.10.02_17.39.07 | flow completed | 0h0m34s0ms | 0h0m14s0ms | -6.666666666666667 | 0.0165839025 | -1 | 15.83 | 503.28 | -1 | 0 | 0 | 0 | 0 | 0 | 0 | 0 | -1 | 0 | -1 | -1 | 4584 | 1162 | 0.0 | 0.0 | 0.0 | 0.0 | -1 | 0.0 | 0.0 | 0.0 | 0.0 | -1 | 3238746.0 | 0.0 | 8.5 | 10.45 | 0.0 | 0.0 | 0.0 | 162 | 374 | 44 | 256 | 0 | 0 | 0 | 173 | 3 | 25 | 19 | 12 | 10 | 31 | 21 | 0 | 32 | 30
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
