mabrains/PLL_design/images/Diagrams/Loop filter/pdf/2nd_order_lpf.pdf

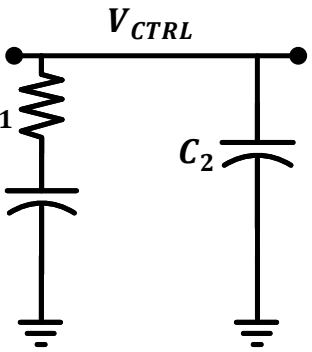
[picture p222: figure]
VCTRL

R1

C1
