mabrains/PLL_design/images/Diagrams/Loop filter/pdf/3rd_order_lpf.pdf

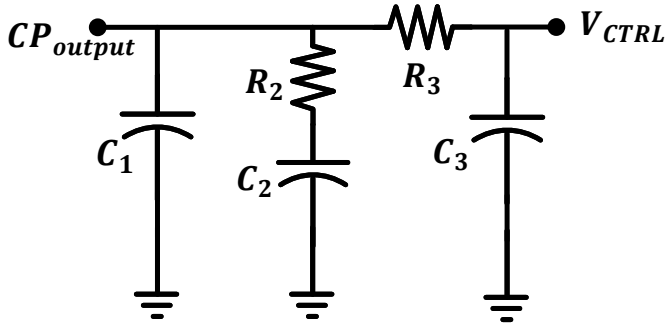
[picture p223: figure]
VCTRL; CPoutput
