mabrains/PLL_design/images/Diagrams/PFD/pdf/pfd_operation.pdf

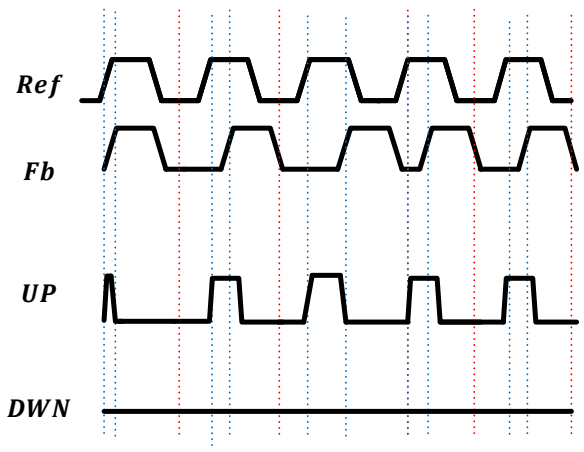
[picture p224: figure]
Ref; DWN
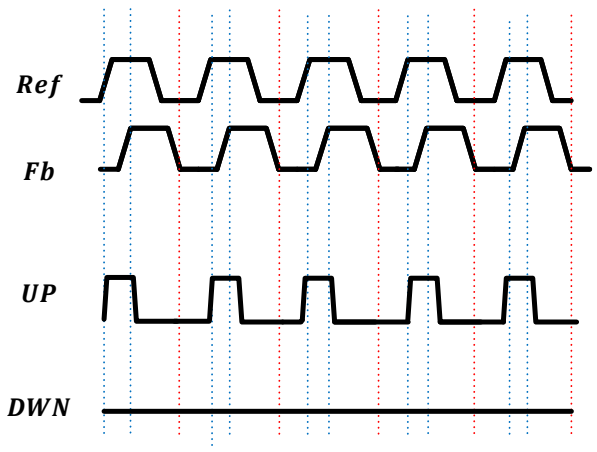
[picture p225: figure]
Ref; DWN
