mabrains/PLL_design/experiments/PDK_varactor_experiment/README.md

# **PDK Varactor Expeiment**  
To simulatet the cct, a bash script has been added to plot the oscillation frequency versus the control voltage.
TO run the sceipt: `./sweep_vctrl.sh`
