mabrains/PLL_design/pll/lc_vco_lib_Ahmed_Reda/CMOS_LC_VCO_tb/CMOS_LC_VCO_Results.md

CMOS LC VCO Design
=================

- Implemented CMOS based LC VCO operating from 2.35 to 2.55 GHz with voltage tuning range from 0.5 to 1.7 V

    - Schematic:
   
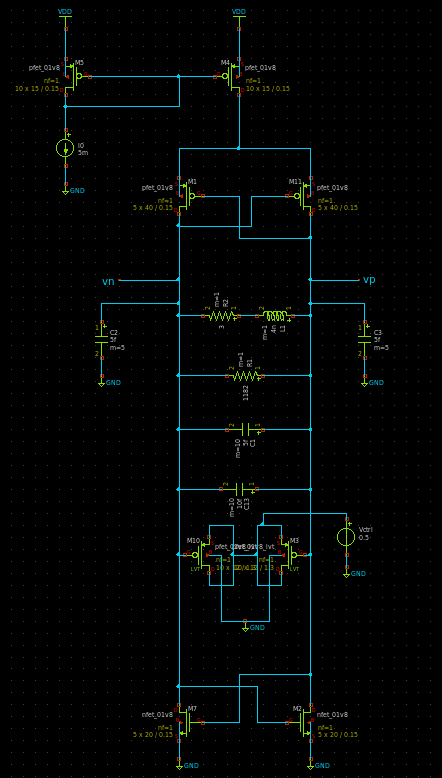
[picture p226: pll/lc_vco_lib_Ahmed_Reda/CMOS_LC_VCO_tb/images/CMOS_LC_VCO_Schematic.png]
CMOS LC VCO Schematic
    
	
    - Output(frequency = 2.35 GHz):
   
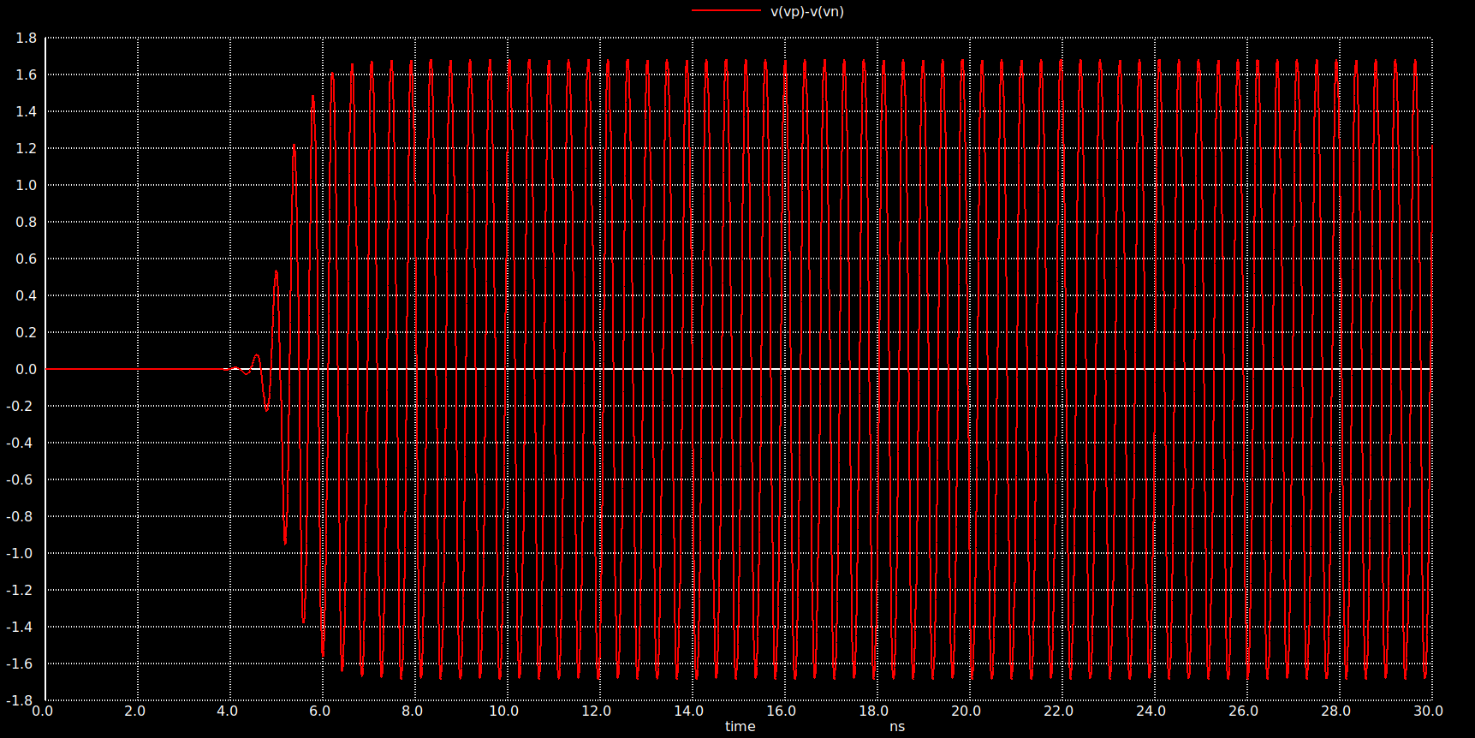
[picture p227: pll/lc_vco_lib_Ahmed_Reda/CMOS_LC_VCO_tb/images/CMOS_LC_VCO_Diff_Output1.png]
CMOS LC VCO Output CMOS LC VCO Differential Output
    
	
	- Output(frequency = 2.55 GHz):

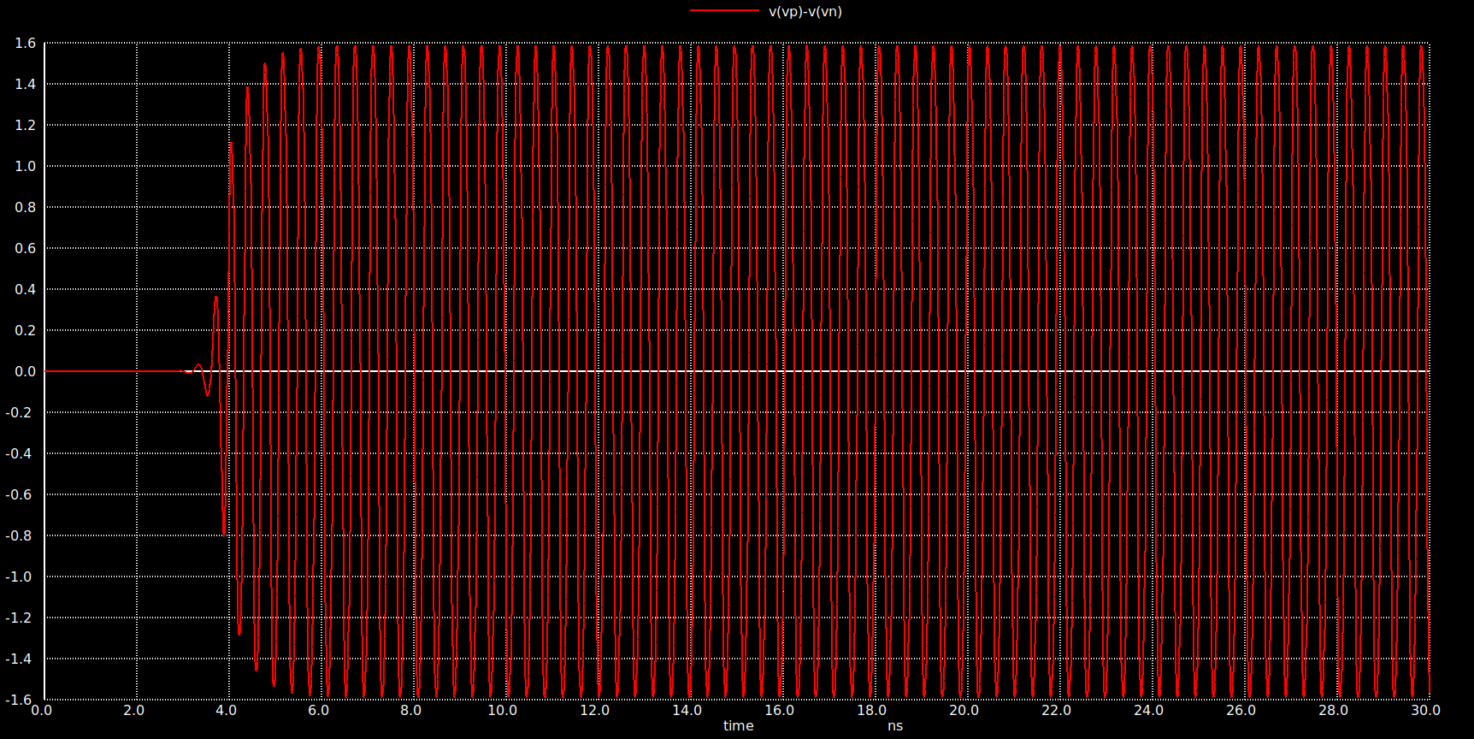
[picture p228: pll/lc_vco_lib_Ahmed_Reda/CMOS_LC_VCO_tb/images/CMOS_LC_VCO_Diff_Output2.png]
CMOS LC VCO Output CMOS LC VCO Differential Output
    
	
	- Frequncy of oscillation VS Control Voltage:

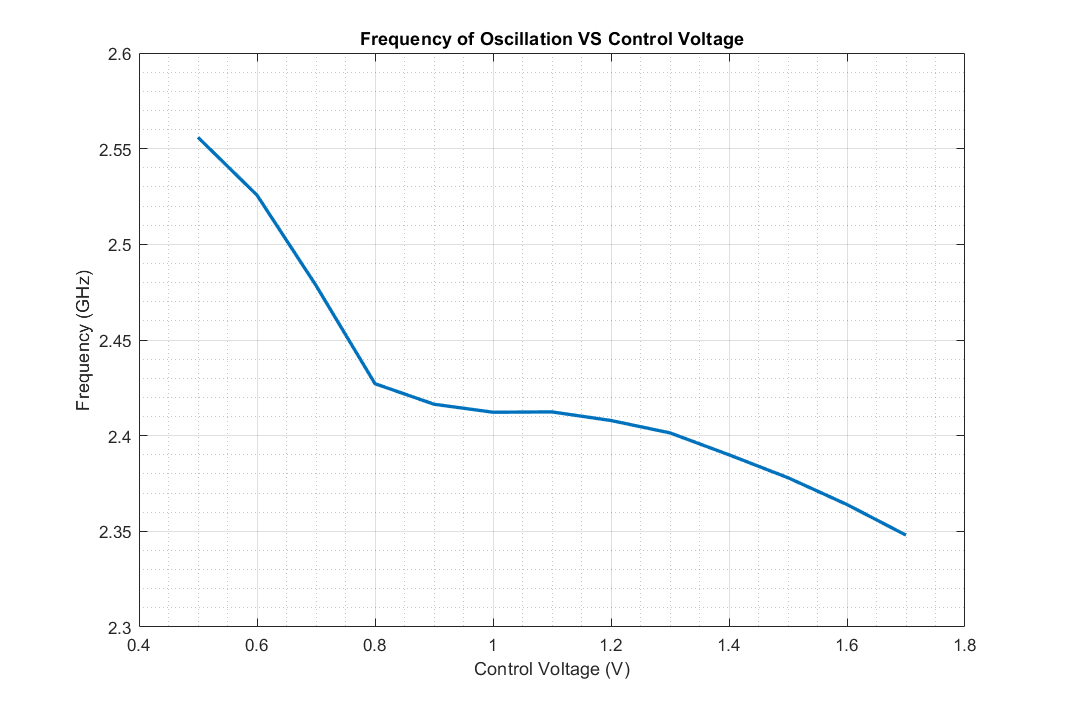
[picture p229: pll/lc_vco_lib_Ahmed_Reda/CMOS_LC_VCO_tb/images/Freq_VS_Vctrl.png]
CMOS LC VCO Output Frequncy of oscillation VS Control Voltage
