mabrains/PLL_design/pll/divider_and_DSM_model/Measurements.csv

Input | Division Ratio
0 | 256.0
1 | 242.43258666992188
2 | 242.43795776367188
3 | 242.45452880859375
4 | 242.43353271484375
5 | 242.50527954101562
6 | 242.41885375976562
7 | 242.4832763671875
8 | 242.4080810546875
9 | 242.46176147460938
10 | 242.43490600585938
11 | 242.49249267578125
12 | 242.39727783203125
13 | 242.48806762695312
14 | 242.46267700195312
15 | 242.456787109375
16 | 242.474365234375
17 | 242.47482299804688
18 | 242.43478393554688
19 | 242.48797607421875
20 | 242.45770263671875
21 | 242.48794555664062
22 | 242.42593383789062
23 | 242.4288330078125
24 | 242.4058837890625
25 | 242.47372436523438
26 | 242.47079467773438
27 | 242.48931884765625
28 | 242.47027587890625
29 | 242.48831176757812
30 | 242.46536254882812
31 | 242.41796875
32 | 242.41552734375
33 | 242.44088745117188
34 | 242.43795776367188
35 | 242.47747802734375
36 | 242.43890380859375
37 | 242.49014282226562
38 | 242.43301391601562
39 | 242.4588623046875
40 | 242.4564208984375
41 | 242.47689819335938
42 | 242.44760131835938
43 | 242.49932861328125
44 | 242.46319580078125
45 | 242.45144653320312
46 | 242.43875122070312
47 | 242.468505859375
48 | 242.477783203125
49 | 242.46505737304688
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
