mabrains/PLL_design/experiments/trnoise_experiment/csv_files/temp2.csv

 0.00000000e+00  1.80000000e+00  0.00000000e+00
 1.00000000e+06 -9.00134943e-01 -2.82756188e-04
 2.00000000e+06  6.00160249e-05  3.67999386e-08
 3.00000000e+06  2.25045627e-05  2.13495926e-08
 4.00000000e+06  1.20033884e-05  1.51683230e-08
 5.00000000e+06  7.50106661e-06  1.19530721e-08
 6.00000000e+06  5.14418798e-06  9.36954360e-09
 7.00000000e+06  3.75016178e-06  8.32709789e-09
 8.00000000e+06  2.85845792e-06  7.33948035e-09
 9.00000000e+06  2.24968309e-06  5.95910602e-09
 1.00000000e+07  1.81920565e-06  6.33644602e-09
 1.10000000e+07  1.50019726e-06  4.67026194e-09
 1.20000000e+07  1.25915379e-06  5.19597459e-09
 1.30000000e+07  1.07074995e-06  3.68862607e-09
 1.40000000e+07  9.24090674e-07  4.95518574e-09
 1.50000000e+07  8.03262131e-07  3.03736974e-09
 1.60000000e+07  7.05908162e-07  3.92050570e-09
 1.70000000e+07  6.25324666e-07  2.95699880e-09
 1.80000000e+07  5.57503421e-07  3.73694616e-09
 1.90000000e+07  5.00093724e-07  2.40878044e-09
 2.00000000e+07  4.51140150e-07  3.53493984e-09
 2.10000000e+07  4.08600920e-07  1.66903092e-09
 2.20000000e+07  3.73535798e-07  3.24079695e-09
 2.30000000e+07  3.40555086e-07  2.87529148e-09
 2.40000000e+07  3.13183706e-07  1.96765688e-09
 2.50000000e+07  2.88978753e-07  2.34169949e-09
 2.60000000e+07  2.66190603e-07  1.91465238e-09
 2.70000000e+07  2.47426250e-07  2.07021718e-09
 2.80000000e+07  2.29697812e-07  1.89875944e-09
 2.90000000e+07  2.14344133e-07  2.47022348e-09
 3.00000000e+07  2.00708891e-07  1.47194178e-09
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
 2.47400000e+09  4.08318956e-10 -1.19038493e-10
 2.47500000e+09 -2.78491700e-10  7.51615846e-10
 2.47600000e+09 -1.52122823e-10 -5.26562379e-10
 2.47700000e+09  8.36976820e-10 -2.42113328e-10
 2.47800000e+09 -8.38766650e-10  3.19299454e-10
 2.47900000e+09  4.21362260e-10  2.15025343e-10
 2.48000000e+09  2.07414272e-11 -3.59308977e-11
 2.48100000e+09  8.49579317e-11 -2.53103252e-10
 2.48200000e+09 -8.44829467e-10  1.92335209e-10
 2.48300000e+09  1.25457227e-09 -2.33301951e-10
 2.48400000e+09 -4.42606215e-10  2.37342436e-10
 2.48500000e+09 -1.04425557e-11  3.33969509e-10
 2.48600000e+09 -2.65958497e-10 -6.66139192e-10
 2.48700000e+09  1.58454178e-10  5.50116927e-10
 2.48800000e+09 -1.43766331e-10  5.09884627e-11
 2.48900000e+09  5.04800488e-10 -2.50448517e-10
 2.49000000e+09 -3.95467119e-10 -4.29694197e-11
 2.49100000e+09  7.56302831e-10  1.02714754e-10
 2.49200000e+09 -6.63580302e-10  1.69808483e-10
 2.49300000e+09  3.78418007e-10 -1.98808470e-10
 2.49400000e+09 -5.68224484e-10  3.35928681e-10
 2.49500000e+09  2.14422606e-10 -5.67038382e-10
 2.49600000e+09  7.89866590e-10  4.13733922e-10
 2.49700000e+09 -5.54095338e-10  2.80631284e-10
 2.49800000e+09 -3.95905206e-10 -4.82762670e-10
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
