mabrains/PLL_design/pll/selected_vco_lib/csv_sheets/post_pex/all_measurements_pex.csv

process | temp | supply | control | corner name | Power (mW) | vn | vp | differential swing | Oscillation Status | freq (GHZ)
tt | 27 | 1 | 0.0 | tt,27,1 | 8.0532 | 9.722206e-01 | 2.343910e-01 | 2.73642 | True | 2.166968
tt | 27 | 1 | 0.1 | tt,27,1 | 4.6656 | -4.01073e-02 | 1.158313e+00 | 2.725402 | True | 2.197007
tt | 27 | 1 | 0.2 | tt,27,1 | -41.4306 | 1.256556e+00 | -5.81121e-02 | 2.718454 | True | 2.231036
tt | 27 | 1 | 0.3 | tt,27,1 | 165.6234 | 1.321272e+00 | 4.506797e-03 | 2.719714 | True | 2.266405
tt | 27 | 1 | 0.4 | tt,27,1 | 411.8994 | 9.646992e-01 | 3.611557e-01 | 2.73529 | True | 2.300612
tt | 27 | 1 | 0.5 | tt,27,1 | 4.5414 | 7.679276e-01 | 7.679230e-01 | 2.76849 | True | 2.331404
tt | 27 | 1 | 0.6 | tt,27,1 | 61.3818 | 1.243137e+00 | 9.478694e-02 | 2.816468 | True | 2.358869
tt | 27 | 1 | 0.7 | tt,27,1 | 4.5468 | 7.679675e-01 | 7.679324e-01 | 2.870548 | True | 2.38433
tt | 27 | 1 | 0.8 | tt,27,1 | 4.519800000000001 | 7.679141e-01 | 7.679023e-01 | 2.924158 | True | 2.408237
tt | 27 | 1 | 0.9 | tt,27,1 | 4.5234000000000005 | 7.678311e-01 | 7.678484e-01 | 2.972378 | True | 2.430115
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
