mabrains/PLL_design/pll/Integeration/circuit_integeration/selected_vco_lib/scripts/all_measurements.csv

process | temp | supply | control | corner name | bgr_tran_02_sat_check | bgr_tran_13_sat_check | bgr_tran_14_sat_check | bgr_tran_15_sat_check | bgr_tran_16_sat_check | bgr_tran_17_sat_check | bgr_tran_18_sat_check | bgr_tran_19_sat_check | bgr_tran_20_sat_check | bgr_tran_21_sat_check | bgr_tran_22_sat_check | bgr_tran_23_sat_check | bgr_tran_24_sat_check | gmn (mS) | gmp (mS) | i2 (uA) | i13 (uA) | i14 (uA) | i15 (uA) | i16 (uA) | i17 (uA) | i18 (uA) | i19 (uA) | i22 (uA) | i23 (uA) | i24 (uA) | I_left (mA) | I_right (mA) | I_tail (mA) | nmos_sat_check | pmos_sat_check | tail_sat_check | Power (mW) | vn | vp | differential swing | Oscillation Status | freq (GHZ)
tt | 27 | 1 | 0.0 | tt,27,1 | True | True | True | True | True | True | True | True | True | True | True | True | True | 1.717200e+01 | 1.175884e+01 | 8.909404e+01 | 8.751688e+00 | 8.709784e+00 | 2.816968e+00 | 4.552549e+01 | 1.509952e+00 | 1.307016e+00 | 4.552549e+01 | 6.431815e-03 | 6.430053e-03 | 4.368483e-10 | 1.113575e+00 | 1.113575e+00 | 2.227149e+00 | True | True | True | 5.2164 | 7.751884e-01 | 7.751884e-01 | 2.972952 | True | 2.209689
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
