mabrains/PLL_design/pll/Integeration/circuit_integeration/tests/test_cp/all_measurements.csv

process | temp | supply | control | UP | Down | corner name | i_out
ff | -40 | 0.9 | 0.0 | 0.0 | 1.8 | ff,-40,0.9 | 2.017690e-06
ff | -40 | 0.9 | 0.0 | 0.0 | 0.0 | ff,-40,0.9 | 2.008824e-06
ff | -40 | 0.9 | 0.0 | 1.8 | 0.0 | ff,-40,0.9 | 9.395492e+01
ff | -40 | 0.9 | 0.0 | 1.8 | 1.8 | ff,-40,0.9 | 9.395492e+01
ff | -40 | 0.9 | 0.1 | 0.0 | 0.0 | ff,-40,0.9 | 1.585398e-06
ff | -40 | 0.9 | 0.1 | 0.0 | 1.8 | ff,-40,0.9 | -7.26369e+01
ff | -40 | 0.9 | 0.1 | 1.8 | 0.0 | ff,-40,0.9 | 9.395006e+01
ff | -40 | 0.9 | 0.1 | 1.8 | 1.8 | ff,-40,0.9 | 2.131313e+01
ff | -40 | 0.9 | 0.2 | 0.0 | 0.0 | ff,-40,0.9 | 1.284306e-06
ff | -40 | 0.9 | 0.2 | 0.0 | 1.8 | ff,-40,0.9 | -9.47825e+01
ff | -40 | 0.9 | 0.2 | 1.8 | 0.0 | ff,-40,0.9 | 9.394507e+01
ff | -40 | 0.9 | 0.2 | 1.8 | 1.8 | ff,-40,0.9 | -8.37470e-01
ff | -40 | 0.9 | 0.3 | 0.0 | 0.0 | ff,-40,0.9 | 1.042721e-06
ff | -40 | 0.9 | 0.3 | 0.0 | 1.8 | ff,-40,0.9 | -9.90249e+01
ff | -40 | 0.9 | 0.3 | 1.8 | 1.8 | ff,-40,0.9 | -5.08500e+00
ff | -40 | 0.9 | 0.3 | 1.8 | 0.0 | ff,-40,0.9 | 9.393992e+01
ff | -40 | 0.9 | 0.4 | 0.0 | 1.8 | ff,-40,0.9 | -9.97135e+01
ff | -40 | 0.9 | 0.4 | 0.0 | 0.0 | ff,-40,0.9 | 8.260059e-07
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
