mabrains/PLL_design/pll/Integeration/circuit_integeration/tests/test_cp/temp.csv

process | temp | supply | control | UP | Down | corner name | i_out
tt | -27 | 1 | 0.0 | 0.0 | 0.0 | tt,-27,1 | 2.841862e-06
tt | -27 | 1 | 0.0 | 0.0 | 1.8 | tt,-27,1 | 2.862753e-06
tt | -27 | 1 | 0.0 | 1.8 | 0.0 | tt,-27,1 | 99.28854
tt | -27 | 1 | 0.0 | 1.8 | 1.8 | tt,-27,1 | 99.28853
tt | -27 | 1 | 0.1 | 0.0 | 0.0 | tt,-27,1 | 2.107203e-06
tt | -27 | 1 | 0.1 | 0.0 | 1.8 | tt,-27,1 | -68.3924
tt | -27 | 1 | 0.1 | 1.8 | 0.0 | tt,-27,1 | 99.2849
tt | -27 | 1 | 0.1 | 1.8 | 1.8 | tt,-27,1 | 30.89251
tt | -27 | 1 | 0.2 | 0.0 | 0.0 | tt,-27,1 | 1.628919e-06
tt | -27 | 1 | 0.2 | 0.0 | 1.8 | tt,-27,1 | -93.4467
tt | -27 | 1 | 0.2 | 1.8 | 0.0 | tt,-27,1 | 99.2812
tt | -27 | 1 | 0.2 | 1.8 | 1.8 | tt,-27,1 | 5.834471
tt | -27 | 1 | 0.3 | 0.0 | 0.0 | tt,-27,1 | 1.29674e-06
tt | -27 | 1 | 0.3 | 0.0 | 1.8 | tt,-27,1 | -98.723
tt | -27 | 1 | 0.3 | 1.8 | 0.0 | tt,-27,1 | 99.27741
tt | -27 | 1 | 0.3 | 1.8 | 1.8 | tt,-27,1 | 0.5544615
tt | -27 | 1 | 0.4 | 0.0 | 0.0 | tt,-27,1 | 1.03384e-06
tt | -27 | 1 | 0.4 | 0.0 | 1.8 | tt,-27,1 | -99.6502
tt | -27 | 1 | 0.4 | 1.8 | 0.0 | tt,-27,1 | 99.27352
tt | -27 | 1 | 0.4 | 1.8 | 1.8 | tt,-27,1 | -0.376692
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
