mabrains/PLL_design/pll/system/ngspice_time_model/test_benches/pfd_cp_lf_vco_integeration/vco_behav.csv

vctrl | vout_max | vout_min | vout_cm | freq
0.0 | 1.699997e+00 | 1.000065e-01 | 9.000017e-01 | 2354986000.0
0.01 | 1.699999e+00 | 1.000003e-01 | 8.999998e-01 | 2355201000.0
0.02 | 1.699999e+00 | 1.000026e-01 | 9.000010e-01 | 2355396000.0
0.03 | 1.699997e+00 | 1.000011e-01 | 8.999992e-01 | 2355589000.0
0.04 | 1.699996e+00 | 1.000002e-01 | 8.999978e-01 | 2355784000.0
0.05 | 1.700000e+00 | 1.000000e-01 | 9.000000e-01 | 2355980000.0
0.06 | 1.699996e+00 | 1.000005e-01 | 8.999981e-01 | 2356176000.0
0.07 | 1.699997e+00 | 1.000013e-01 | 8.999992e-01 | 2356372000.0
0.08 | 1.699999e+00 | 1.000027e-01 | 9.000010e-01 | 2356620000.0
0.09 | 1.699979e+00 | 1.000000e-01 | 8.999894e-01 | 2356766000.0
0.1 | 1.699999e+00 | 1.000096e-01 | 9.000044e-01 | 2357025000.0
0.11 | 1.700000e+00 | 1.000009e-01 | 9.000004e-01 | 2357429000.0
0.12 | 1.699998e+00 | 1.000001e-01 | 8.999989e-01 | 2357761000.0
0.13 | 1.700000e+00 | 1.000005e-01 | 9.000001e-01 | 2358234000.0
0.14 | 1.699949e+00 | 1.000578e-01 | 9.000034e-01 | 2358634000.0
0.15 | 1.699999e+00 | 1.000020e-01 | 9.000007e-01 | 2359034000.0
0.16 | 1.700000e+00 | 1.000079e-01 | 9.000039e-01 | 2359432000.0
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
