mabrains/PLL_design/pll_int/CP/testbench/scripts/analysis/measurements/all_measurements.csv

lp | wp | i1 | i2 | i3 | i4 | sat1 | sat2 | sat3 | sat4 | vds1 | vds2 | vds3 | vds4 | vgs1 | vgs2 | vgs3 | vgs4 | vth1 | vth2 | vth3 | vth4
0.15 | 13.5 | 8.939155e+01 | 4.597166e+01 | 4.597168e+01 | 1.347058e+01 | 5.615789e-01 | 9.560388e-01 | 7.133882e-01 | 6.578424e-01 | 6.719800e-01 | 1.066440e+00 | 7.335583e-01 | 6.679373e-01 | 6.719806e-01 | 6.719805e-01 | 7.335587e-01 | 7.335587e-01 | 5.615794e-01 | 5.615794e-01 | 7.133885e-01 | 7.234638e-01
0.15 | 11.0 | 8.939155e+01 | 4.597166e+01 | 4.597168e+01 | 1.207869e+01 | 5.615789e-01 | 9.560388e-01 | 7.133882e-01 | 6.955907e-01 | 6.719800e-01 | 1.066440e+00 | 7.335583e-01 | 7.124828e-01 | 6.719806e-01 | 6.719805e-01 | 7.335587e-01 | 7.335587e-01 | 5.615794e-01 | 5.615794e-01 | 7.133885e-01 | 7.166666e-01
0.15 | 14.0 | 8.939155e+01 | 4.597166e+01 | 4.597168e+01 | 1.372828e+01 | 5.615789e-01 | 9.560388e-01 | 7.133882e-01 | 6.508799e-01 | 6.719800e-01 | 1.066440e+00 | 7.335583e-01 | 6.597503e-01 | 6.719806e-01 | 6.719805e-01 | 7.335587e-01 | 7.335587e-01 | 5.615794e-01 | 5.615794e-01 | 7.133885e-01 | 7.246883e-01
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
