mabrains/PLL_design/pll_int/Divider/testbench/scripts/corners/measurements/all_measurements.csv

Process | Temp | Supply | F_input | F_out | N
tt | 27.00 | 1.80 | 2.2GHz | 1.00000e+07 | 2.20000e+02
