mabrains/PLL_design/pll_int/VCO/testbench/scripts/corners/measurements/all_measurements.csv

process | temp | supply | control | corner name | Power (mW) | vn | vp | differential swing | Oscillation Status | freq (GHZ) | failed corners
ff | -40 | 0.9 | 0.0 | ff,-40,0.9 | 3425.634 | 1.294391e+00 | -6.98793e-02 | 2.75427 | True | 2.285121
ff | -40 | 0.9 | 0.1 | ff,-40,0.9 | -549.0054000000001 | 9.936014e-02 | 1.172705e+00 | 2.744914 | True | 2.32477
ff | -40 | 0.9 | 0.2 | ff,-40,0.9 | -810.7650000000001 | 1.117119e+00 | 1.565412e-01 | 2.737804 | True | 2.367643
ff | -40 | 0.9 | 0.3 | ff,-40,0.9 | 2.6189999999999998 | 7.599547e-01 | 7.599505e-01 | 2.734024 | True | 2.4108
ff | -40 | 0.9 | 0.4 | ff,-40,0.9 | 2.655 | 7.600337e-01 | 7.600444e-01 | 2.750382 | True | 2.452638
ff | -40 | 0.9 | 0.5 | ff,-40,0.9 | -1310.7528 | 1.101307e-01 | 1.185584e+00 | 2.791688 | True | 2.487615
ff | -40 | 0.9 | 0.6 | ff,-40,0.9 | -110.0304 | -5.25262e-02 | 1.231648e+00 | 2.844618 | True | 2.520768
ff | -40 | 0.9 | 0.7 | ff,-40,0.9 | 2.5416000000000003 | 7.600740e-01 | 7.600619e-01 | 2.899792 | True | 2.553284
ff | -40 | 0.9 | 0.8 | ff,-40,0.9 | 37.34460000000001 | 4.316319e-01 | 7.325083e-01 | 2.952772 | True | 2.587913
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
