mabrains/PLL_design/pll/Integeration/circuit_integeration/tests/test_div/corner_automation/CSV_files/final_result.csv

Process | Temp | Supply | F_input | F_out | N
tt | 27.00 | 1.62 | 2.2GHz | 1.00000e+07 | 2.20000e+02
tt | 27.00 | 1.62 | 2.21GHz | 1.00000e+07 | 2.21000e+02
tt | 27.00 | 1.62 | 2.22GHz | 1.00000e+07 | 2.22000e+02
tt | 27.00 | 1.62 | 2.23GHz | 1.00000e+07 | 2.23000e+02
tt | 27.00 | 1.62 | 2.24GHz | 1.00000e+07 | 2.24000e+02
tt | 27.00 | 1.62 | 2.25GHz | 1.00000e+07 | 2.25000e+02
tt | 27.00 | 1.62 | 2.26GHz | 1.00000e+07 | 2.26000e+02
tt | 27.00 | 1.62 | 2.27GHz | 1.00000e+07 | 2.27000e+02
tt | 27.00 | 1.62 | 2.28GHz | 1.00000e+07 | 2.28000e+02
tt | 27.00 | 1.62 | 2.29GHz | 1.00000e+07 | 2.29000e+02
tt | 27.00 | 1.62 | 2.3GHz | 1.00000e+07 | 2.30000e+02
tt | 27.00 | 1.62 | 2.31GHz | 1.00000e+07 | 2.31000e+02
tt | 27.00 | 1.62 | 2.32GHz | 1.00000e+07 | 2.32000e+02
tt | 27.00 | 1.62 | 2.33GHz | 1.00000e+07 | 2.33000e+02
tt | 27.00 | 1.62 | 2.34GHz | 1.00000e+07 | 2.34000e+02
tt | 27.00 | 1.62 | 2.35GHz | 1.00000e+07 | 2.35000e+02
tt | 27.00 | 1.62 | 2.36GHz | 1.00000e+07 | 2.36000e+02
tt | 27.00 | 1.62 | 2.37GHz | 1.00000e+07 | 2.37000e+02
tt | 27.00 | 1.62 | 2.38GHz | 1.00000e+07 | 2.38000e+02
tt | 27.00 | 1.62 | 2.39GHz | 1.00000e+07 | 2.39000e+02
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
