mabrains/PLL_design/pll/Integeration/circuit_integeration/tests/test_div/phase_nosie_analysis/csv_files/vout_fft.csv

 0.00000000e+00  1.80080944e+00
 2.00000000e+05  9.00689383e-01
 4.00000000e+05  1.38276065e-04
 6.00000000e+05  1.11119006e-04
 8.00000000e+05  7.13350829e-05
 1.00000000e+06  7.52452216e-05
 1.20000000e+06  3.46659159e-05
 1.40000000e+06  4.01599211e-05
 1.60000000e+06  3.89964474e-05
 1.80000000e+06  6.51315261e-06
 2.00000000e+06  4.26514240e-06
 2.20000000e+06  1.48471557e-05
 2.40000000e+06  2.20503402e-05
 2.60000000e+06  1.77556048e-05
 2.80000000e+06  8.79440670e-06
 3.00000000e+06  3.80077009e-05
 3.20000000e+06  3.23357417e-05
 3.40000000e+06  2.14291633e-05
 3.60000000e+06  1.97511128e-05
 3.80000000e+06  2.09510179e-05
 4.00000000e+06  2.23693155e-05
 4.20000000e+06  2.32583705e-05
 4.40000000e+06  2.30980408e-05
 4.60000000e+06  1.74052882e-05
 4.80000000e+06  1.05400414e-05
 5.00000000e+06  2.42763152e-05
 5.20000000e+06  2.10473820e-05
 5.40000000e+06  2.61202053e-05
 5.60000000e+06  2.52725620e-05
 5.80000000e+06  2.17933768e-05
 6.00000000e+06  2.18325751e-05
 6.20000000e+06  3.32586125e-05
 6.40000000e+06  2.92189778e-05
 6.60000000e+06  2.95280082e-05
 6.80000000e+06  2.68168263e-05
 7.00000000e+06  3.85846242e-05
 7.20000000e+06  2.24365125e-05
 7.40000000e+06  1.42042279e-05
 7.60000000e+06  2.71250601e-05
 7.80000000e+06  7.72470165e-06
 8.00000000e+06  1.81820917e-05
 8.20000000e+06  5.64645952e-06
 8.40000000e+06  5.70748965e-05
 8.60000000e+06  3.32531650e-05
 8.80000000e+06  8.19538332e-05
 9.00000000e+06  1.25629869e-04
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
 4.98400000e+08  3.15523679e-05
 4.98600000e+08  6.10990924e-05
 4.98800000e+08  6.62166585e-05
 4.99000000e+08  4.65039307e-05
 4.99200000e+08  7.96122318e-05
 4.99400000e+08  7.24853847e-05
 4.99600000e+08  5.33442687e-05
 4.99800000e+08  1.64197586e-04
 5.00000000e+08  6.64522135e-04
