mabrains/PLL_design/pll/selected_vco_lib/scripts/all_measurements.csv

process | temp | supply | control | corner name | Power (mW) | vn | vp | differential swing | Oscillation Status | freq (GHZ) | failed corners
ff | -40 | 0.9 | 0.0 | ff,-40,0.9 | -25.0776 | 1.010083e+00 | 2.502402e-01 | 2.754038 | True | 2.285767
ff | -40 | 0.9 | 0.1 | ff,-40,0.9 | 4353.893999999999 | 2.264854e-02 | 1.083217e+00 | 2.74386 | True | 2.32453
ff | -40 | 0.9 | 0.2 | ff,-40,0.9 | -344.4948 | 1.127919e+00 | -3.00914e-02 | 2.738024 | True | 2.368612
ff | -40 | 0.9 | 0.3 | ff,-40,0.9 | 2.6189999999999998 | 7.599547e-01 | 7.599505e-01 | 2.734012 | True | 2.411242
ff | -40 | 0.9 | 0.4 | ff,-40,0.9 | 2.655 | 7.600337e-01 | 7.600444e-01 | 2.750432 | True | 2.452638
ff | -40 | 0.9 | 0.5 | ff,-40,0.9 | 394.9326 | 1.360171e+00 | 6.242661e-03 | 2.792494 | True | 2.487571
ff | -40 | 0.9 | 0.6 | ff,-40,0.9 | 224.8146 | 5.743946e-01 | 6.941236e-01 | 2.844354 | True | 2.520773
ff | -40 | 0.9 | 0.7 | ff,-40,0.9 | 2.5416000000000003 | 7.600740e-01 | 7.600619e-01 | 2.899792 | True | 2.553284
ff | -40 | 0.9 | 0.8 | ff,-40,0.9 | 110.35079999999999 | 1.101794e+00 | 1.555014e-01 | 2.95237 | True | 2.587818
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
