mabrains/PLL_design/pll/dividers_lib/ss_corner_testing/NMOS_testing/ss_corner/images/I_V.png

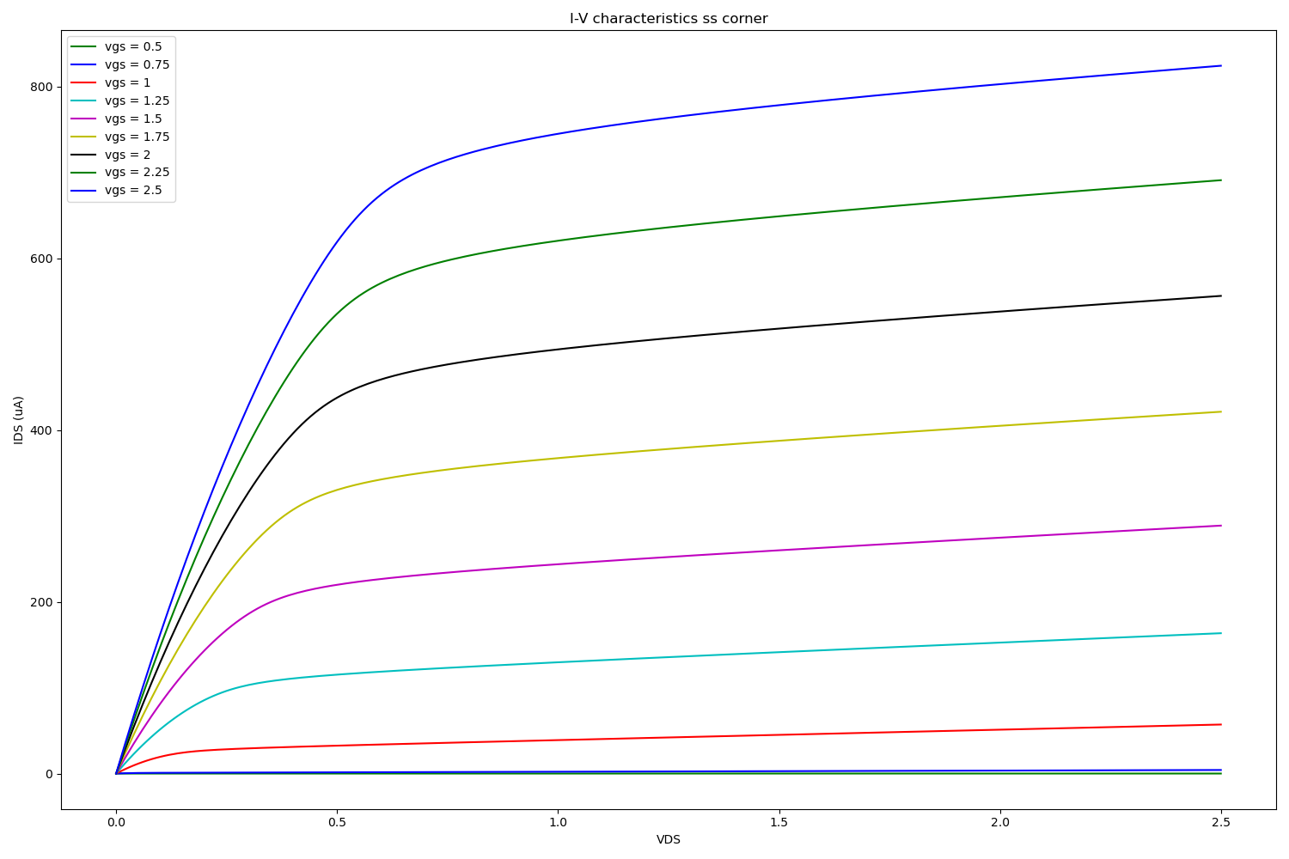
pll/dividers_lib/ss_corner_testing/NMOS_testing/ss_corner/images/I_V.png
