mabrains/PLL_design/pll/dividers_lib/ss_corner_testing/PMOS_testing/tt_corner/images/I_V.png

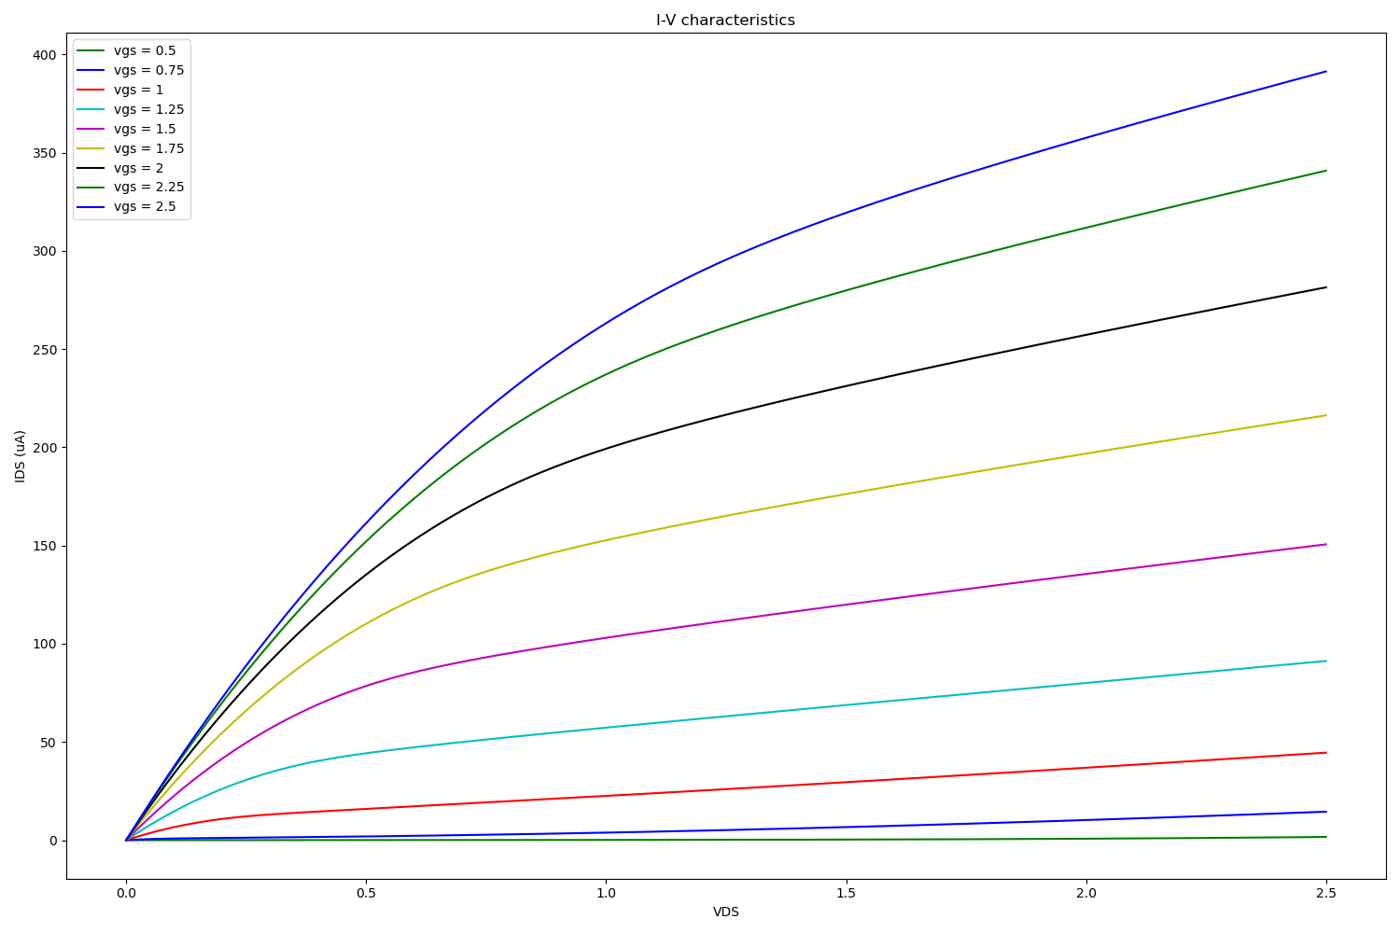
pll/dividers_lib/ss_corner_testing/PMOS_testing/tt_corner/images/I_V.png
