mabrains/PLL_design/pll/Integeration/circuit_integeration/selected_vco_lib/results/ASTIC_hexa_with_bgr_varctor_optimozed/kvco.png

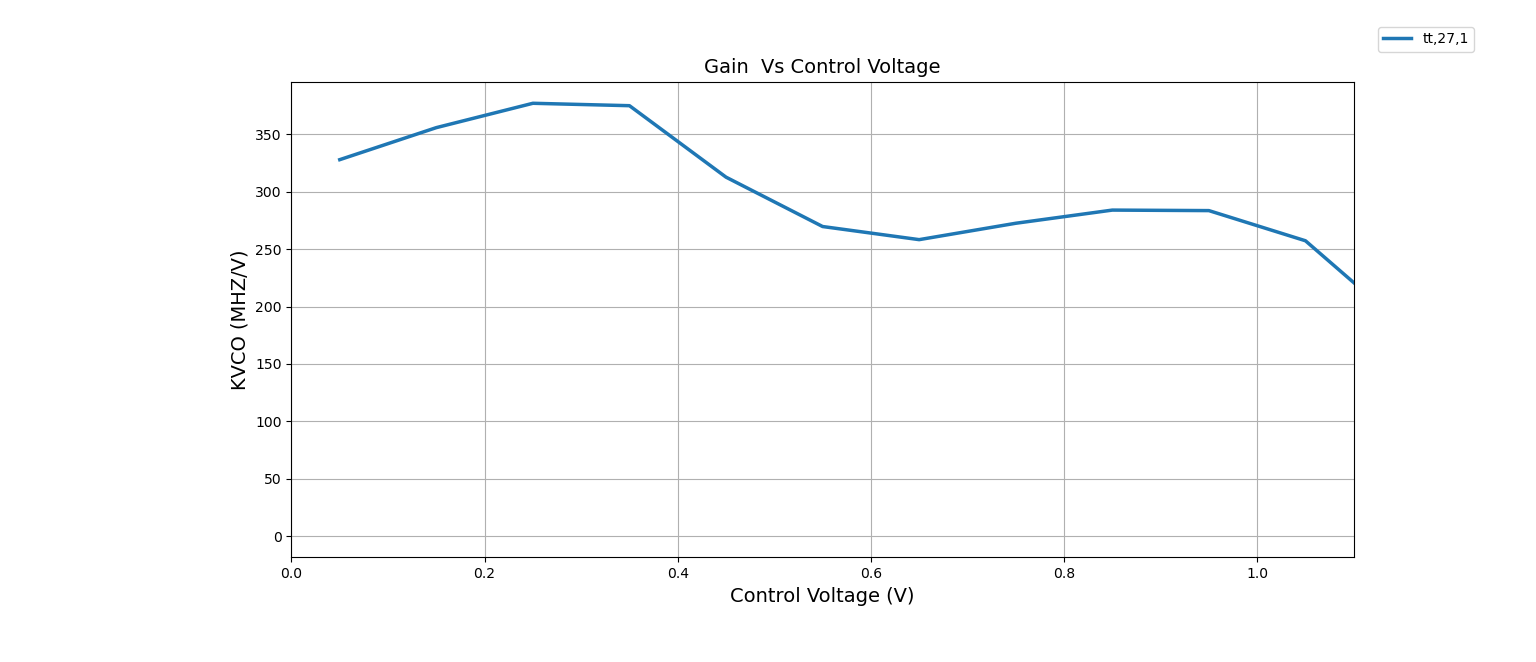
pll/Integeration/circuit_integeration/selected_vco_lib/results/ASTIC_hexa_with_bgr_varctor_optimozed/kvco.png
