mabrains/PLL_design/pll/Integeration/circuit_integeration/selected_vco_lib/results/fosc_new.png

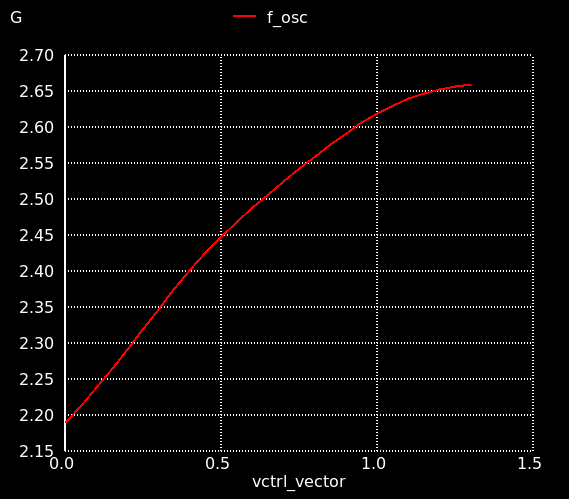
pll/Integeration/circuit_integeration/selected_vco_lib/results/fosc_new.png
