mabrains/PLL_design/pll/Integeration/circuit_integeration/selected_vco_lib/results/fosc_vs_vctrl_corners.png

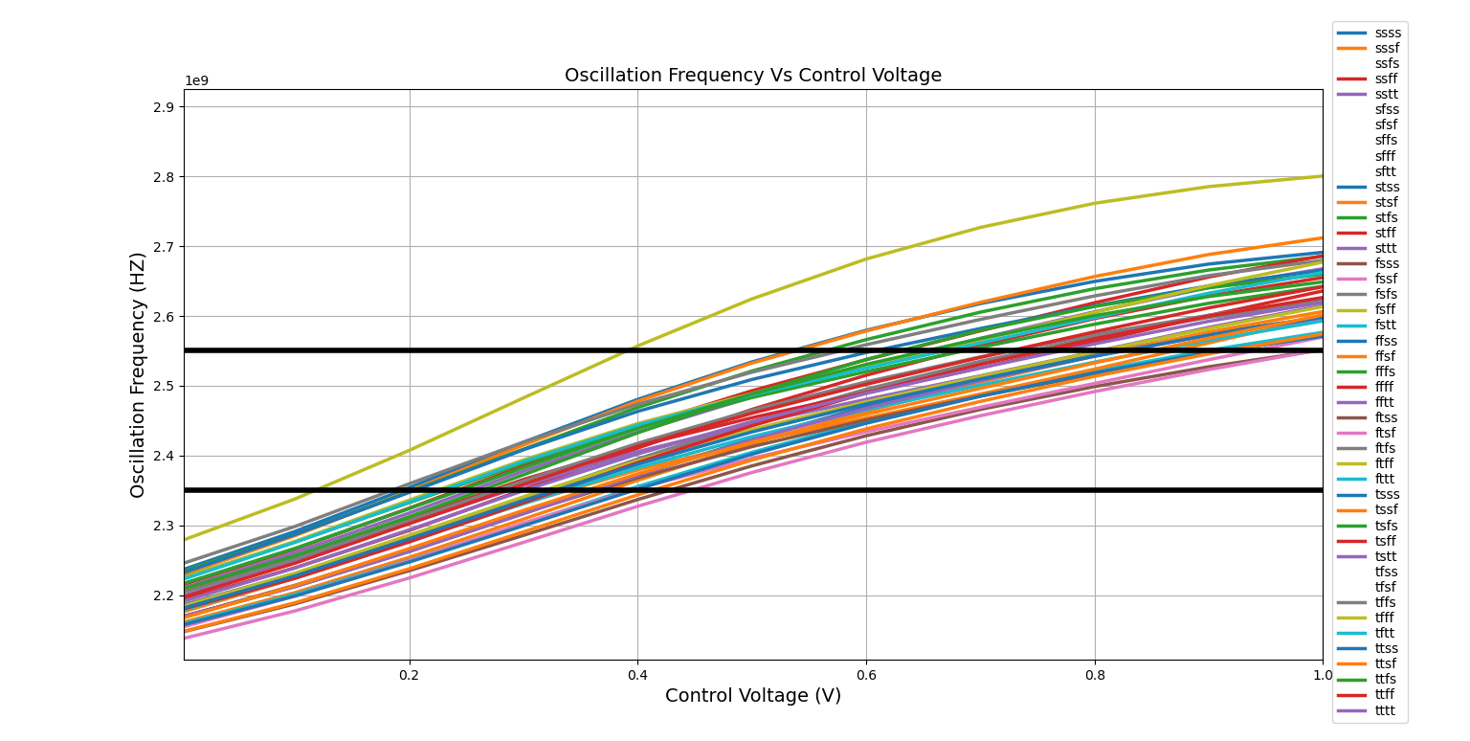
pll/Integeration/circuit_integeration/selected_vco_lib/results/fosc_vs_vctrl_corners.png
