mabrains/PLL_design/pll/Integeration/circuit_integeration/selected_vco_lib/results/ideal_current_source/max_swing.png

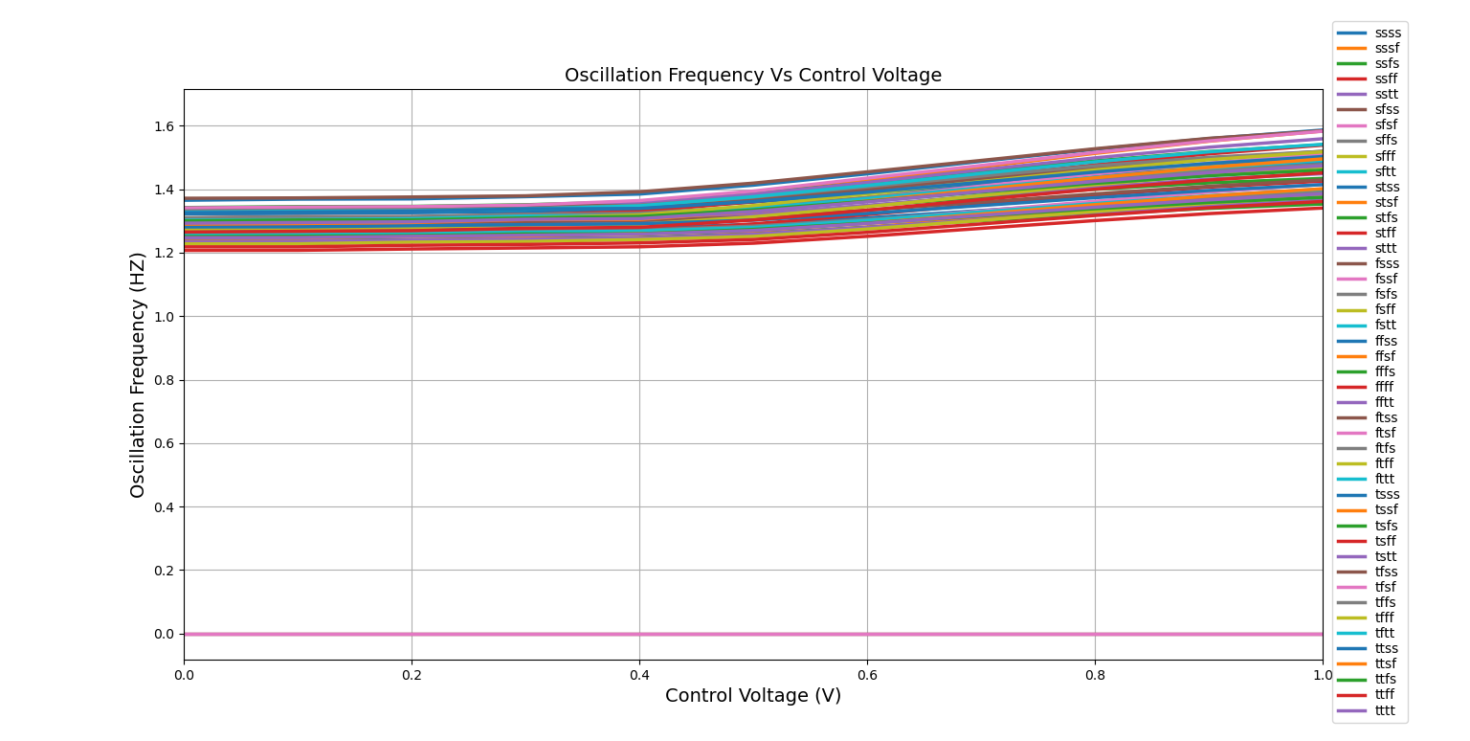
pll/Integeration/circuit_integeration/selected_vco_lib/results/ideal_current_source/max_swing.png
