mabrains/PLL_design/pll/Integeration/circuit_integeration/tests/PLL_Tests/results2/VCO out.png

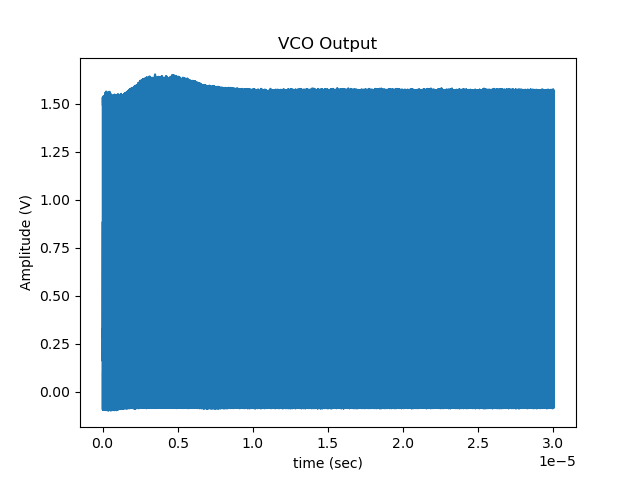
pll/Integeration/circuit_integeration/tests/PLL_Tests/results2/VCO out.png
