mabrains/PLL_design/pll/Integeration/circuit_integeration/tests/PLL_Tests/results/beforelock.png

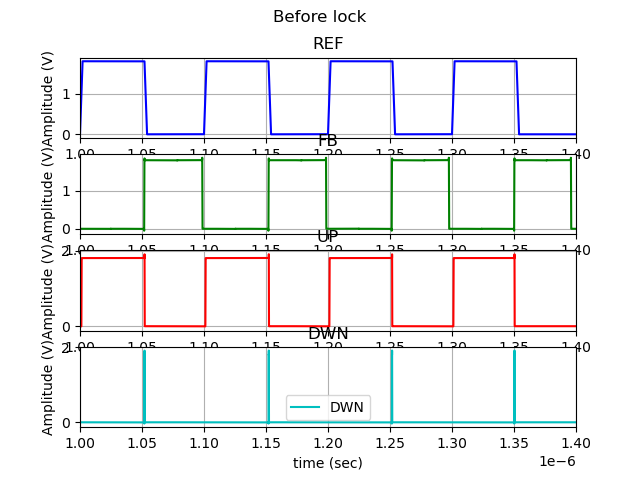
pll/Integeration/circuit_integeration/tests/PLL_Tests/results/beforelock.png
