mabrains/PLL_design/pll/Integeration/circuit_integeration/tests/PLL_Tests/results_3_kvco_lf_200u/VCO out.png

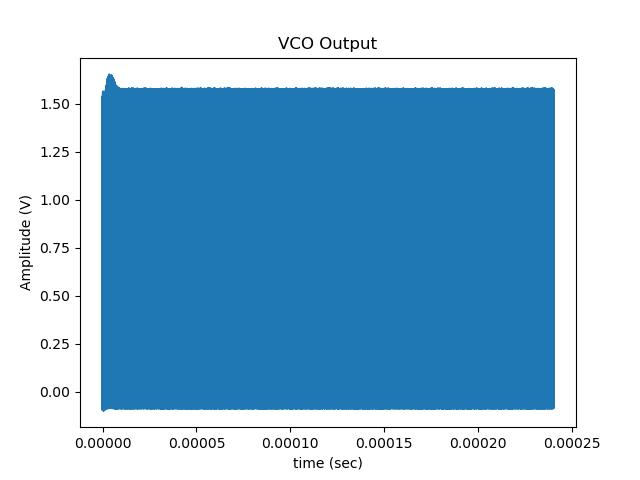
pll/Integeration/circuit_integeration/tests/PLL_Tests/results_3_kvco_lf_200u/VCO out.png
