mabrains/PLL_design/pll/Integeration/circuit_integeration/tests/test_pfd/circuit/Feedback signal leads the Reference.png

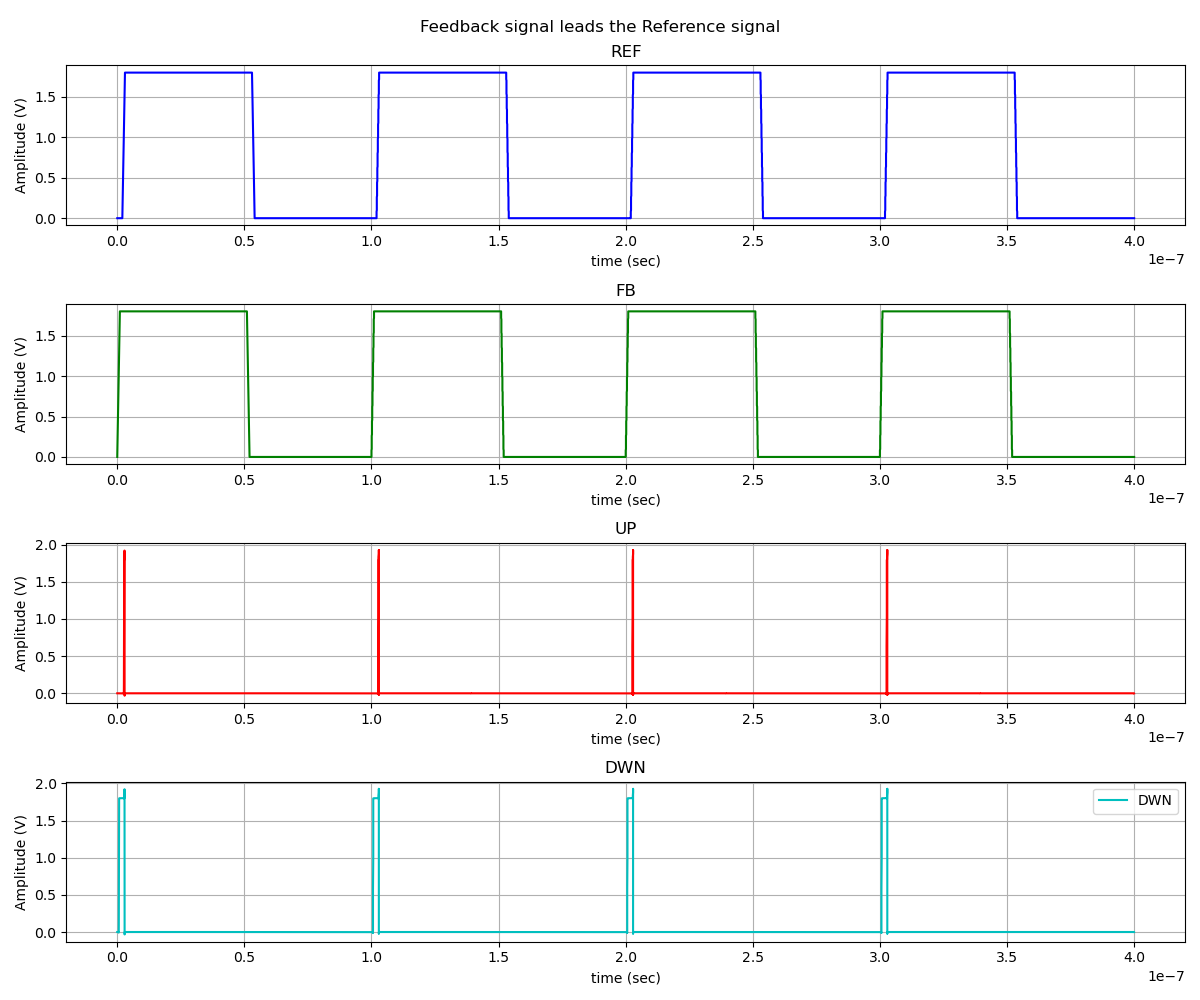
pll/Integeration/circuit_integeration/tests/test_pfd/circuit/Feedback signal leads the Reference.png
