mabrains/PLL_design/pll/lc_vco_lib_Ahmed_Reda/BGR_Corners/results/mult/variant_load/sch.png

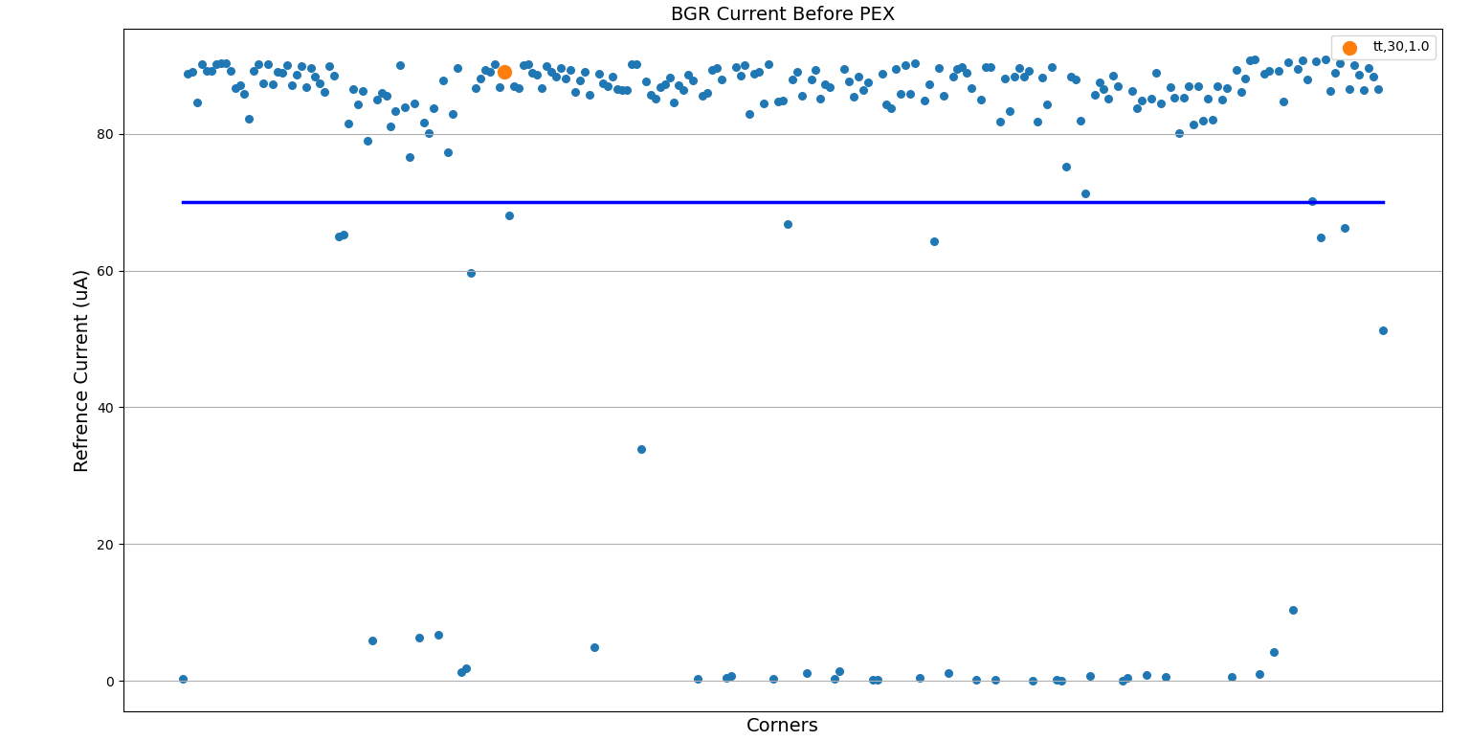
pll/lc_vco_lib_Ahmed_Reda/BGR_Corners/results/mult/variant_load/sch.png
