mabrains/PLL_design/pll/lc_vco_lib_Ahmed_Reda/BGR_Corners/results/mult/variant_load/sch_and_pex.png

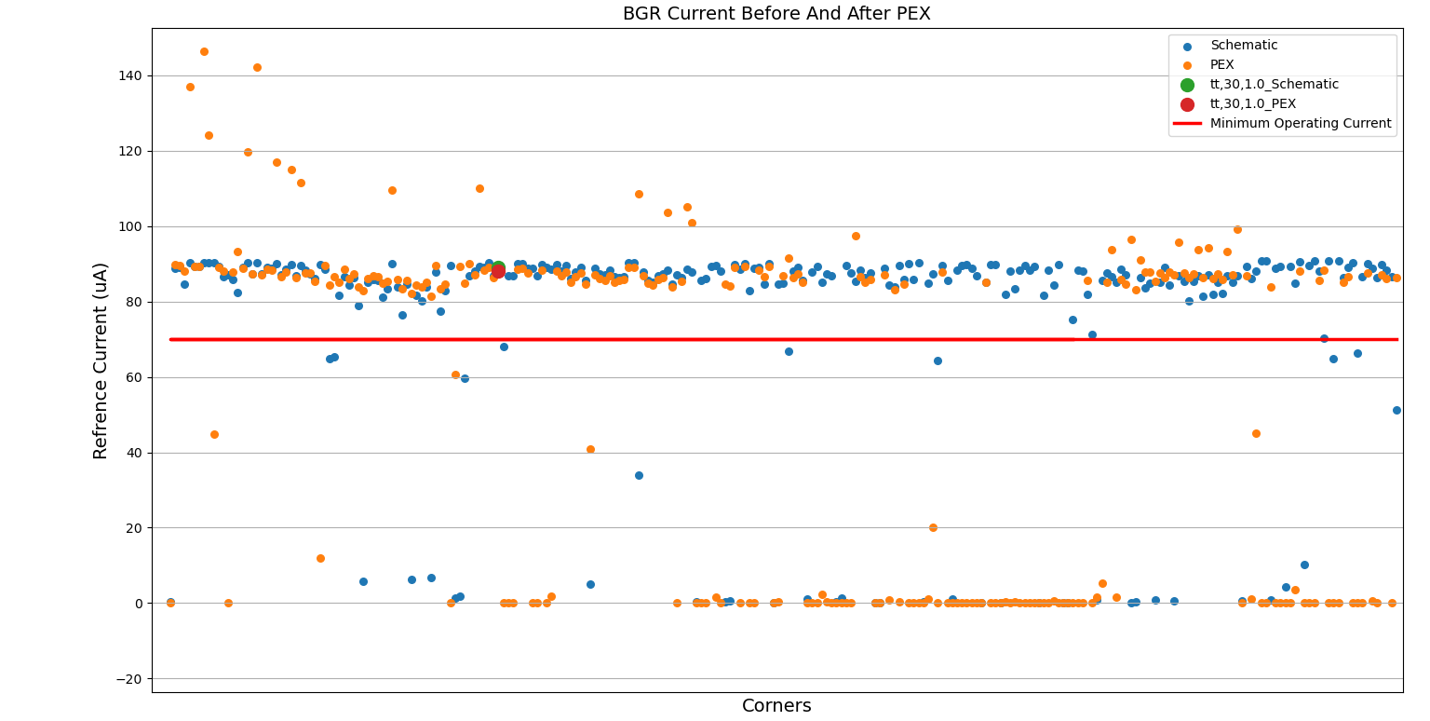
pll/lc_vco_lib_Ahmed_Reda/BGR_Corners/results/mult/variant_load/sch_and_pex.png
