mabrains/PLL_design/pll/lc_vco_lib_Ahmed_Reda/BGR_Corners/results/nf/constant/sch_and_pex.png

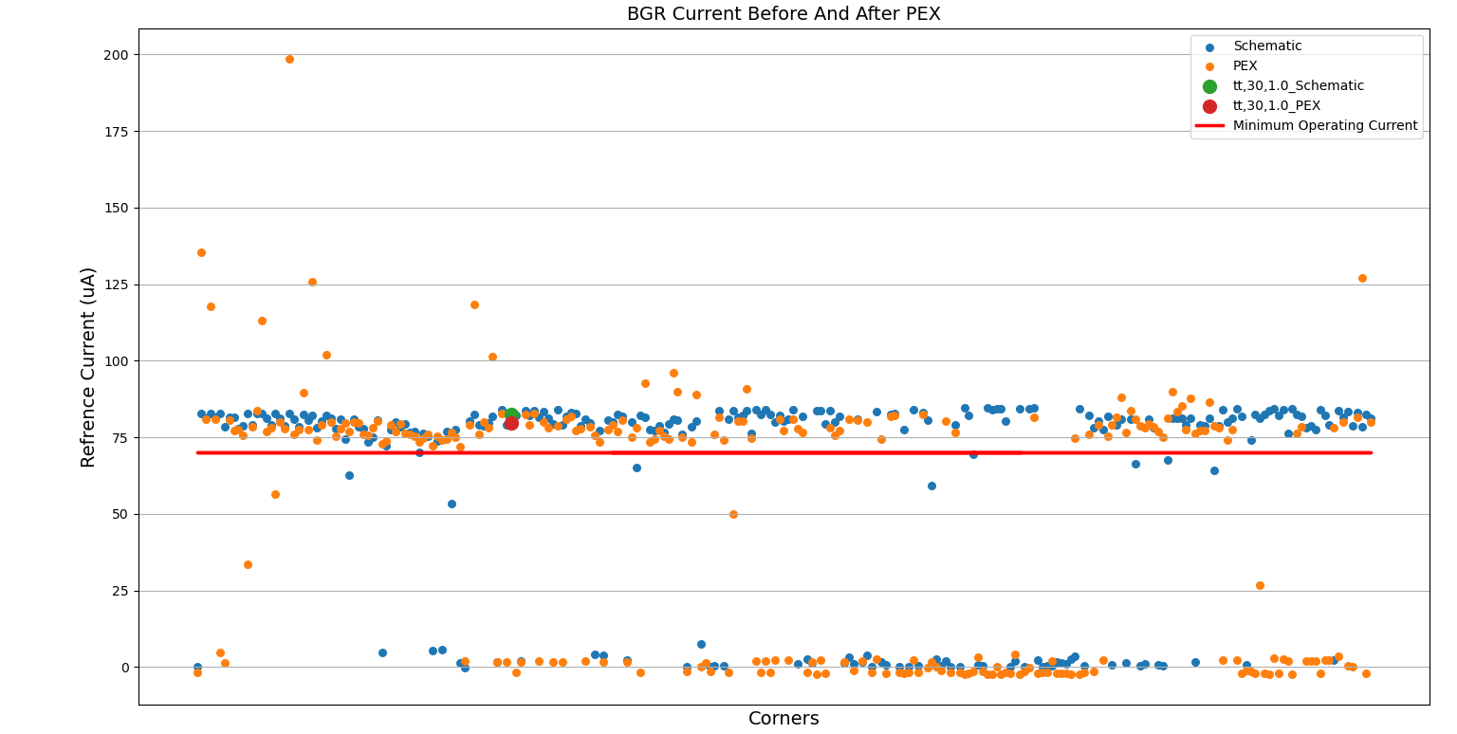
pll/lc_vco_lib_Ahmed_Reda/BGR_Corners/results/nf/constant/sch_and_pex.png
