mabrains/PLL_design/pll/lc_vco_lib_Ahmed_Reda/BGR_Corners/results/nf/variant/sch.png

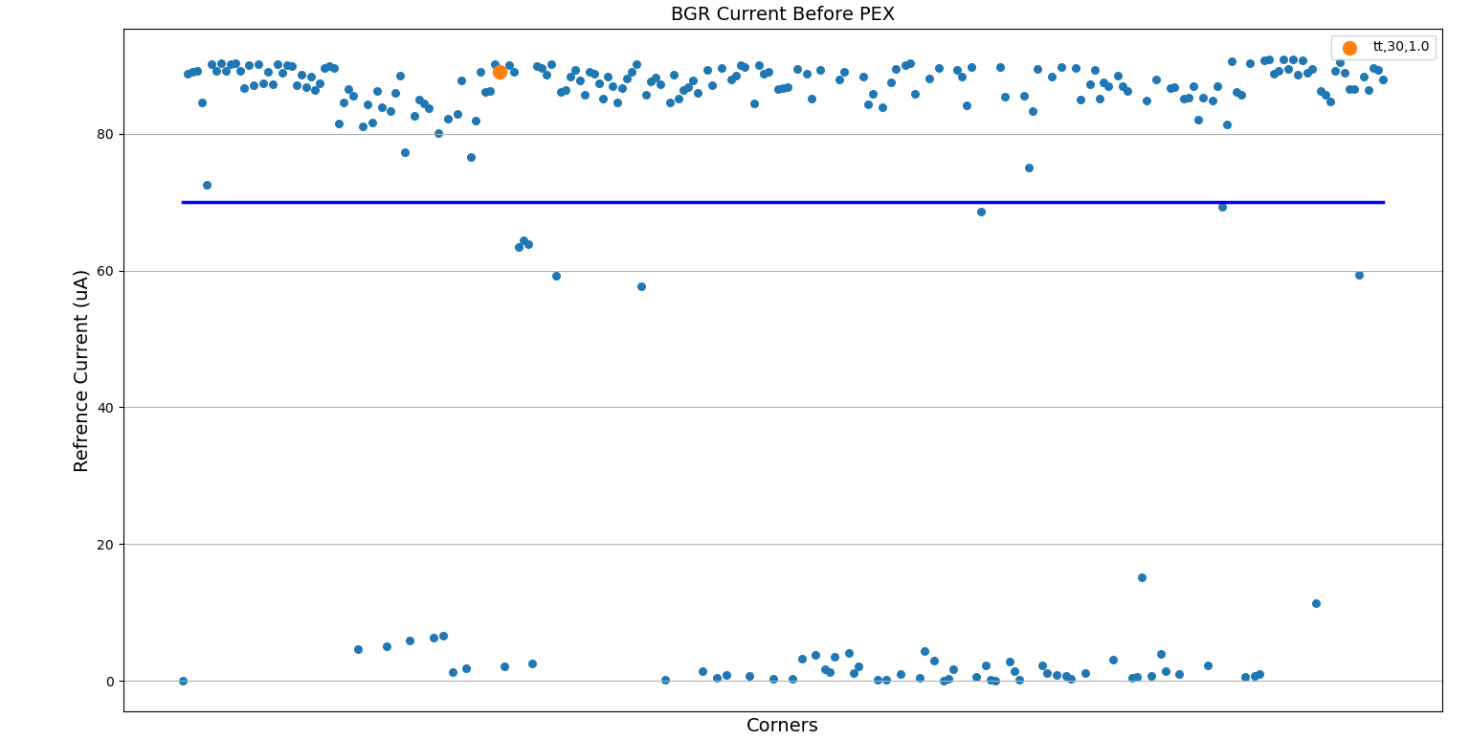
pll/lc_vco_lib_Ahmed_Reda/BGR_Corners/results/nf/variant/sch.png
