mabrains/PLL_design/pll/pfd_cp_lf_lib/cp_corners/Results/up_0_dn_0.png

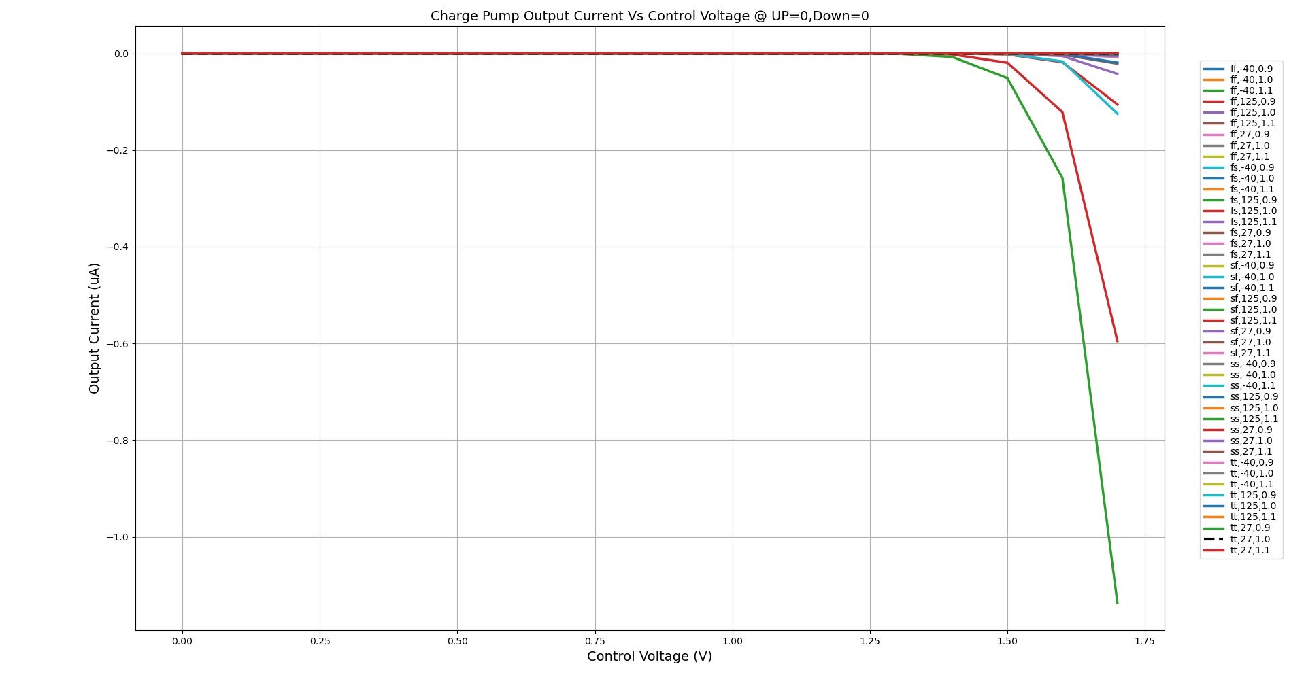
pll/pfd_cp_lf_lib/cp_corners/Results/up_0_dn_0.png
