mabrains/PLL_design/pll/pfd_cp_lf_lib/cp_corners/Results/up_0_dn_1.8.png

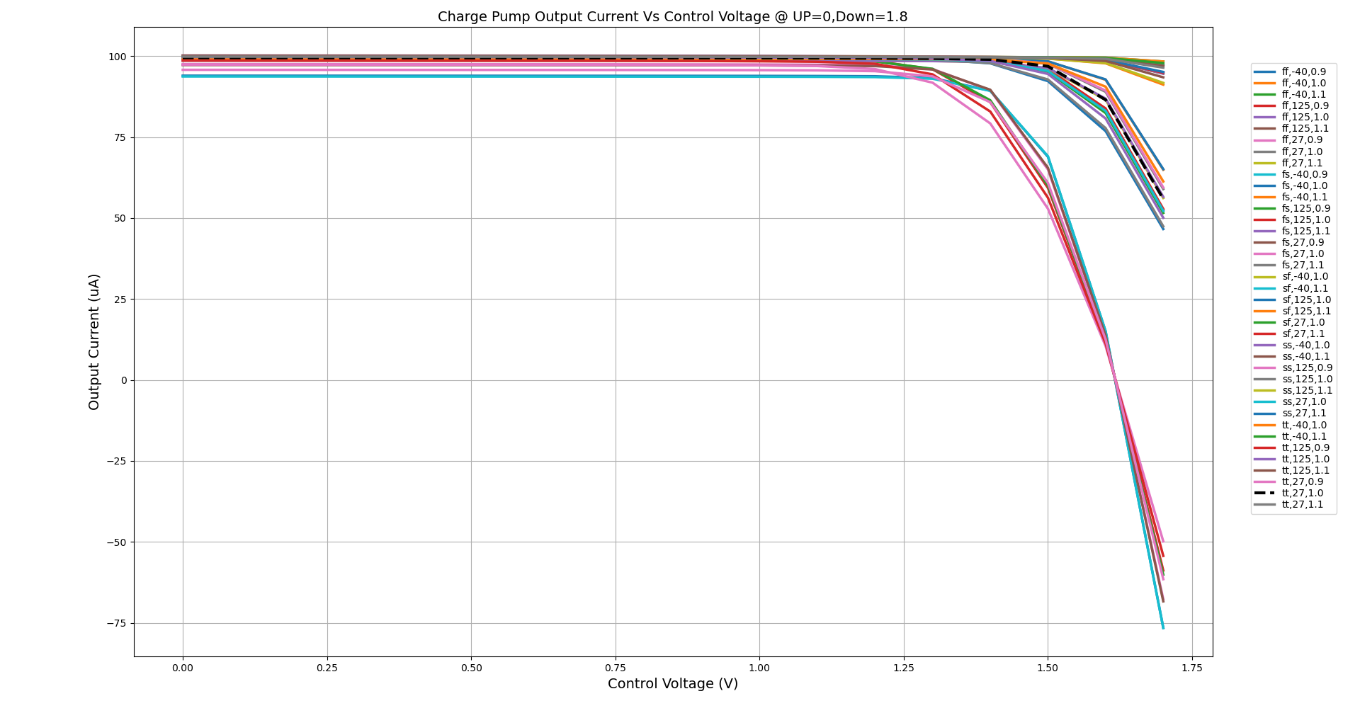
pll/pfd_cp_lf_lib/cp_corners/Results/up_0_dn_1.8.png
