mabrains/PLL_design/pll/pfd_cp_lf_lib/cp_corners/Results/up_1.8_dn_0.png

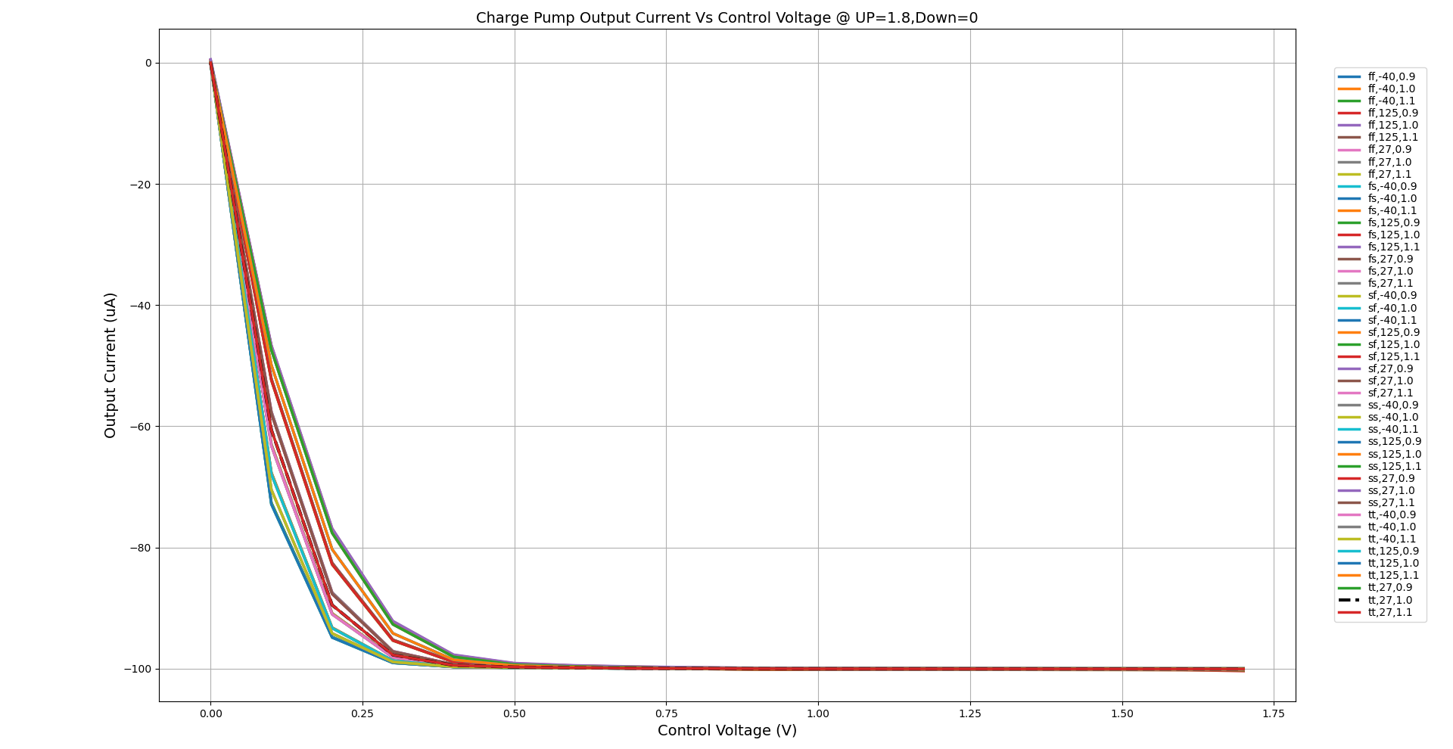
pll/pfd_cp_lf_lib/cp_corners/Results/up_1.8_dn_0.png
