mabrains/PLL_design/pll/pfd_cp_lf_lib/pfd_corners/results/fb_lags_from_fbby10ns/down.png

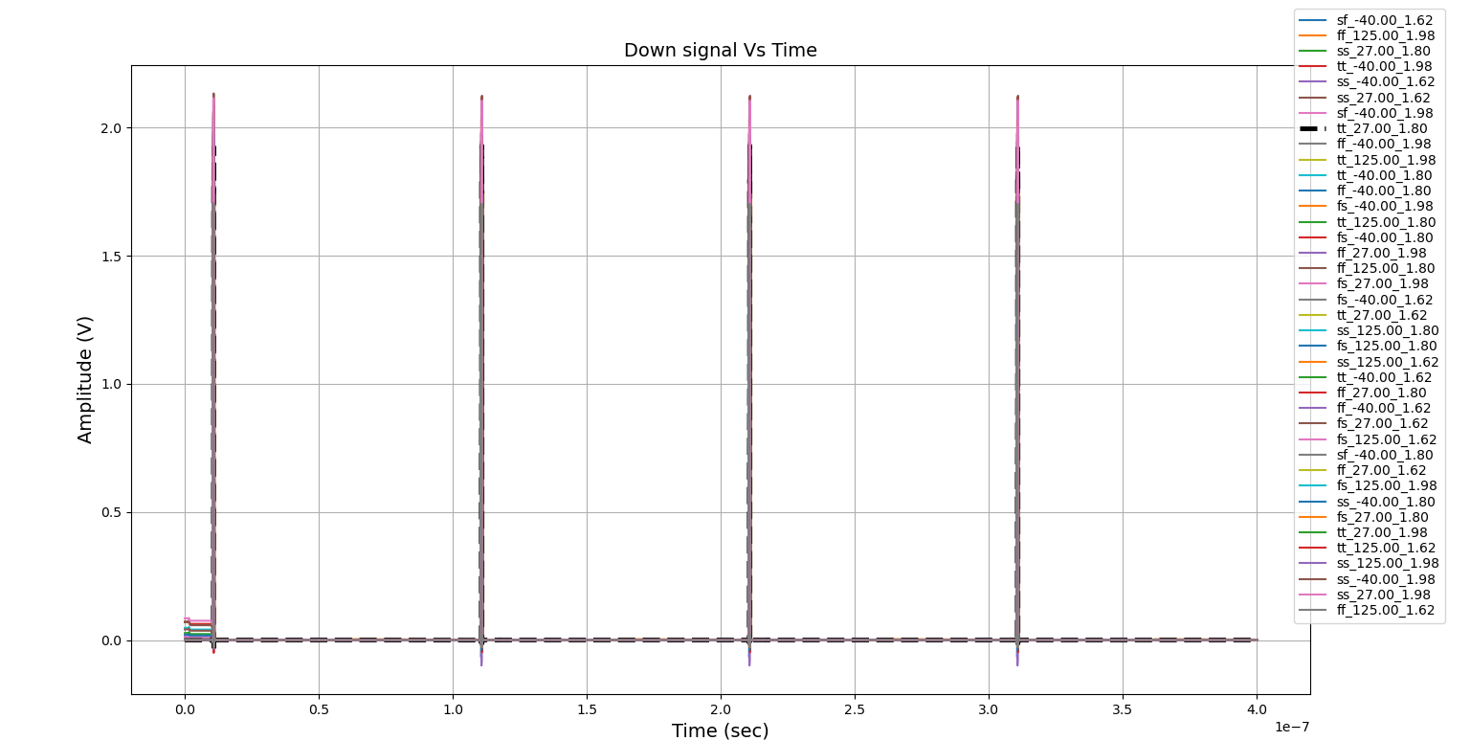
pll/pfd_cp_lf_lib/pfd_corners/results/fb_lags_from_fbby10ns/down.png
