mabrains/PLL_design/pll/pfd_cp_lf_lib/pfd_corners/results/fb_lags_from_refby150p/down_1_period.png

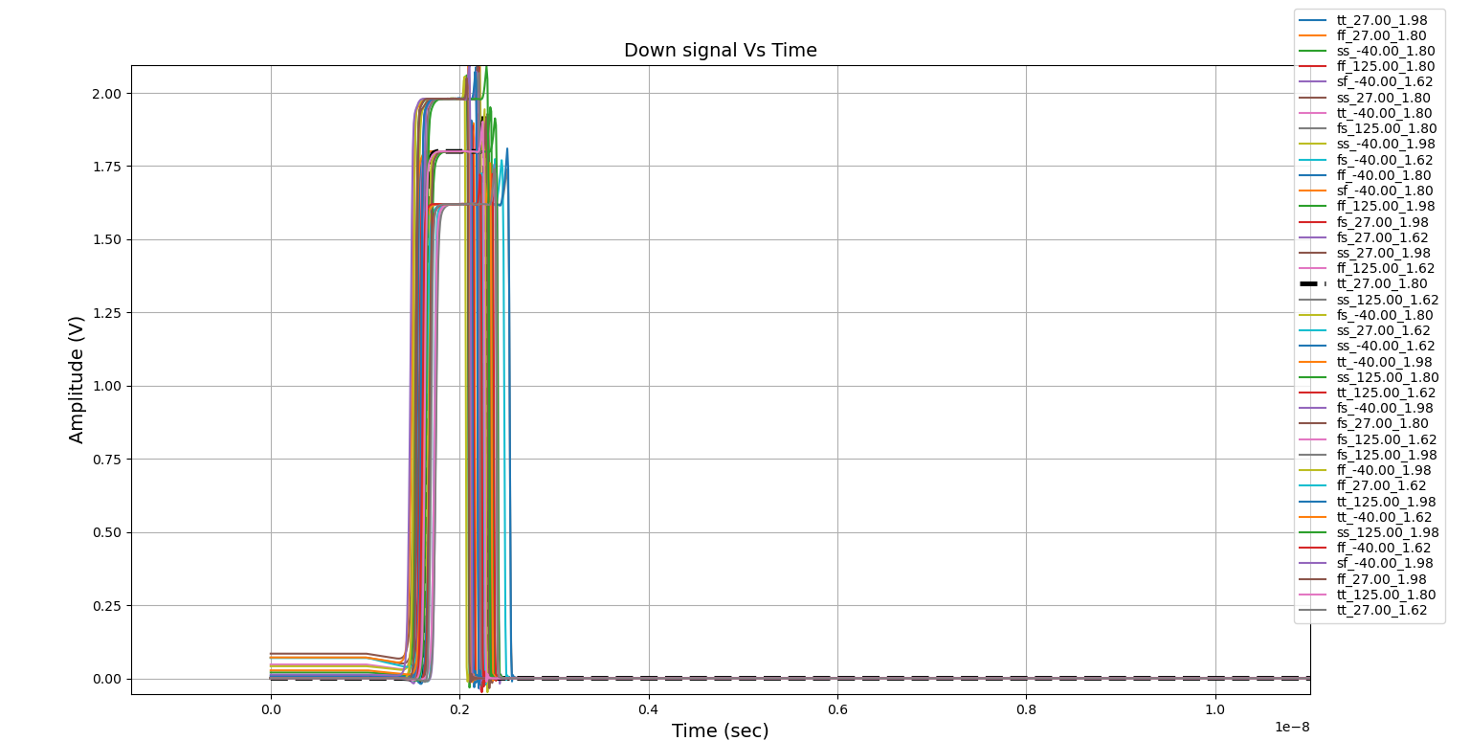
pll/pfd_cp_lf_lib/pfd_corners/results/fb_lags_from_refby150p/down_1_period.png
