mabrains/PLL_design/pll/pfd_cp_lf_lib/pfd_corners/results/ref_lags_from_fb_by10ns/up.png

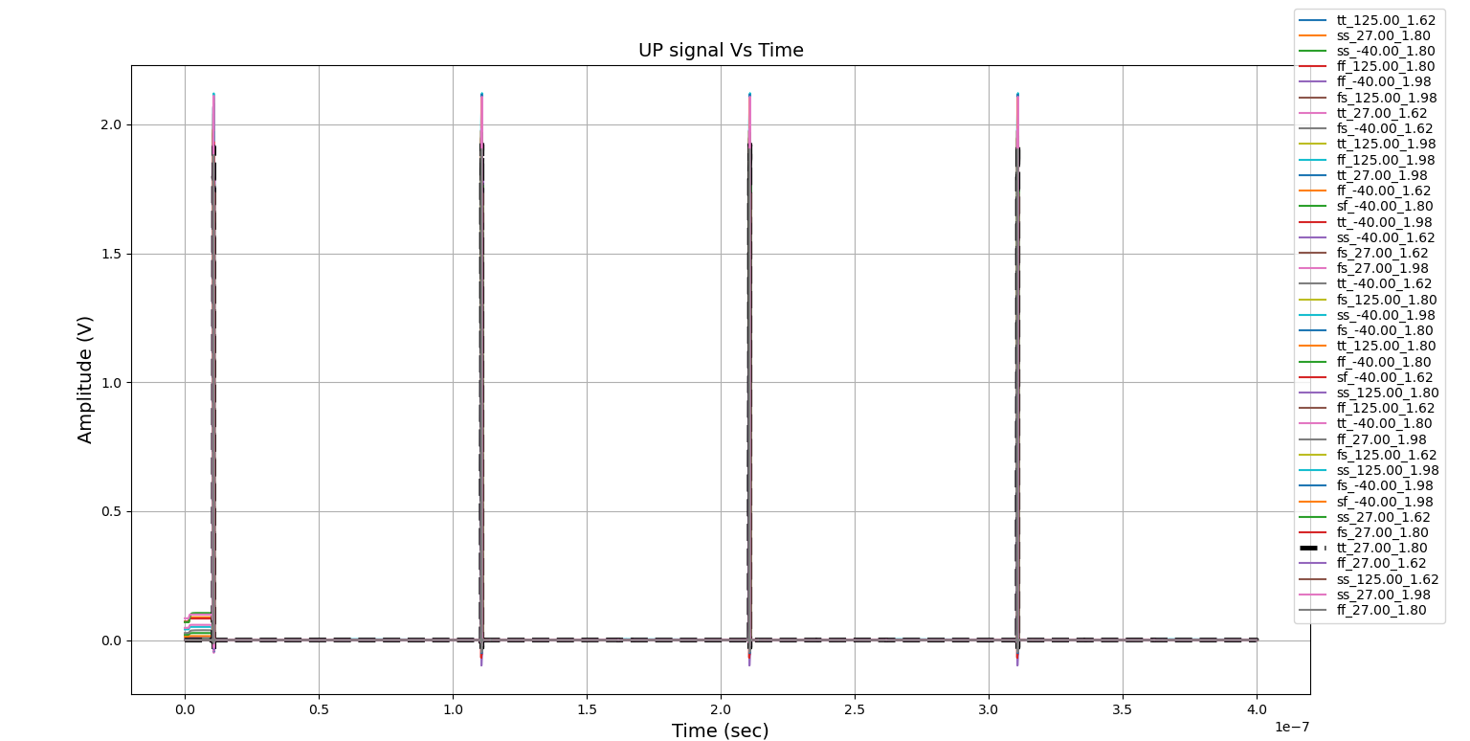
pll/pfd_cp_lf_lib/pfd_corners/results/ref_lags_from_fb_by10ns/up.png
