mabrains/PLL_design/pll/selected_vco_lib/results/after_nf_left_side_inductor/power.png

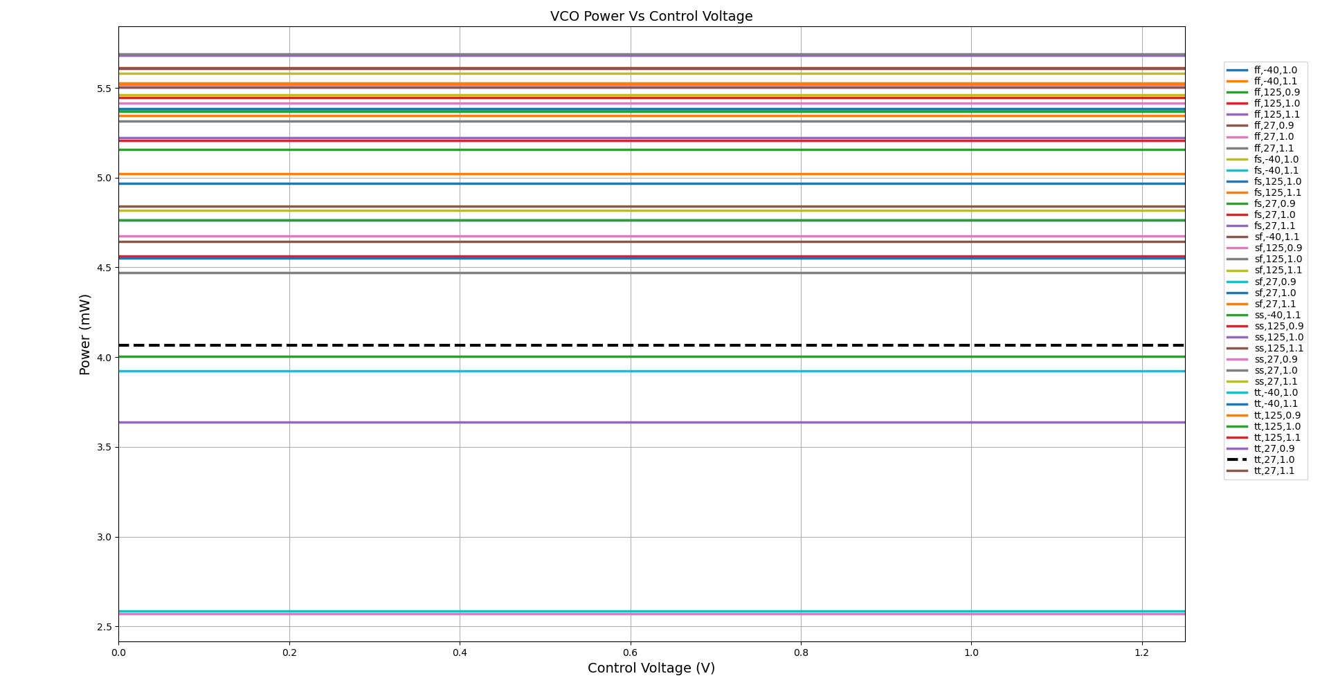
pll/selected_vco_lib/results/after_nf_left_side_inductor/power.png
