mabrains/PLL_design/pll/selected_vco_lib/results/after_nf_left_side_inductor/swing.png

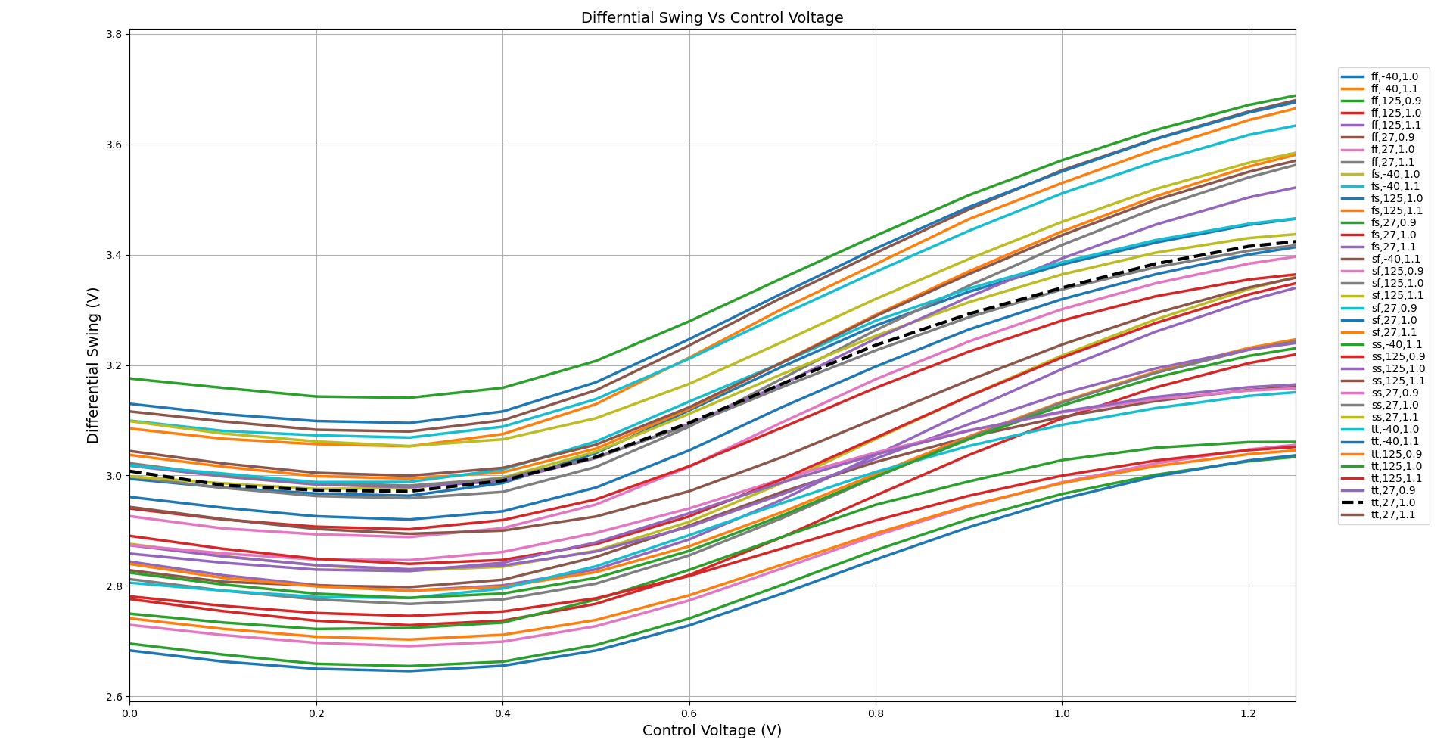
pll/selected_vco_lib/results/after_nf_left_side_inductor/swing.png
