mabrains/PLL_design/pll/selected_vco_lib/results/ASTIC_hexa_with_bgr_varctor_optimozed/differential_swing_corners.png

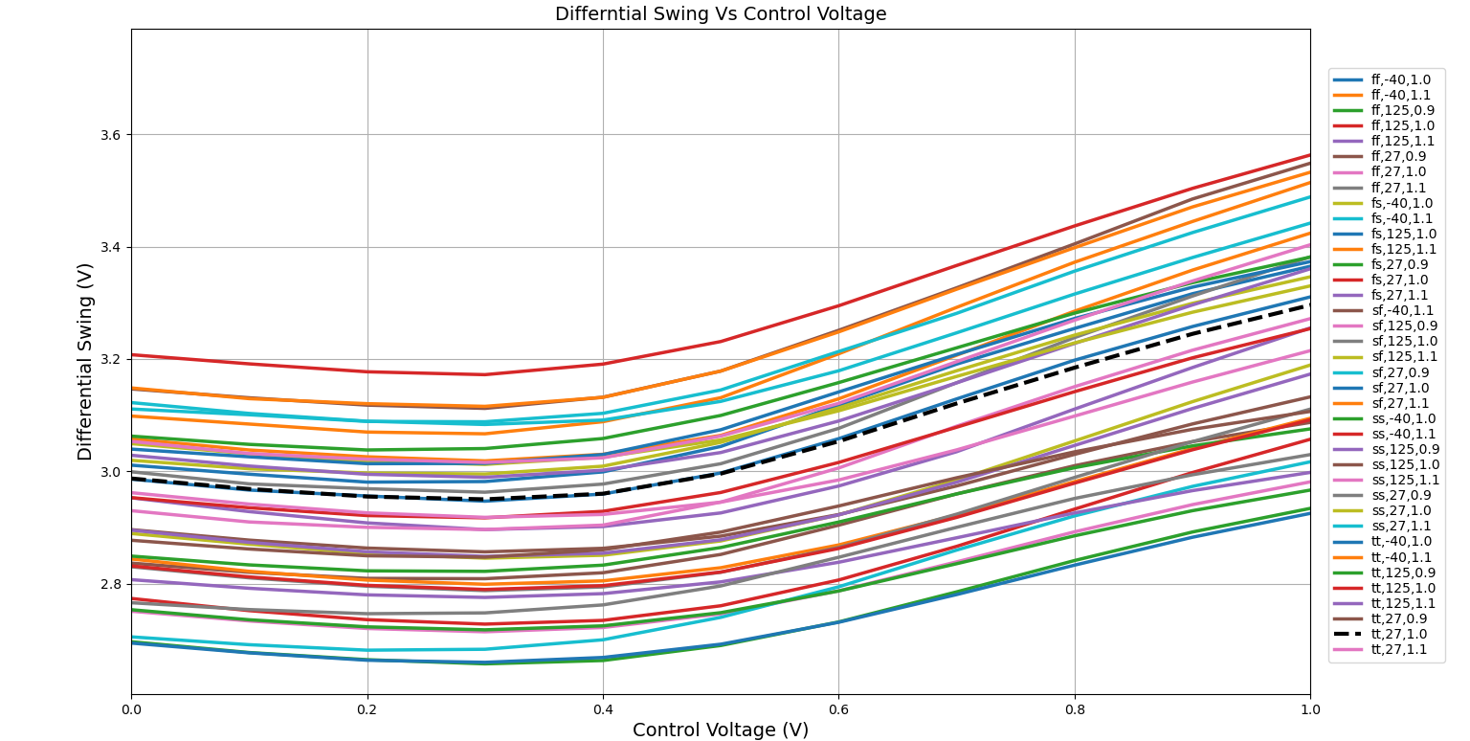
pll/selected_vco_lib/results/ASTIC_hexa_with_bgr_varctor_optimozed/differential_swing_corners.png
