mabrains/PLL_design/pll/selected_vco_lib/results/vco_post_pex_ideal_current/frequency_before_modification.png

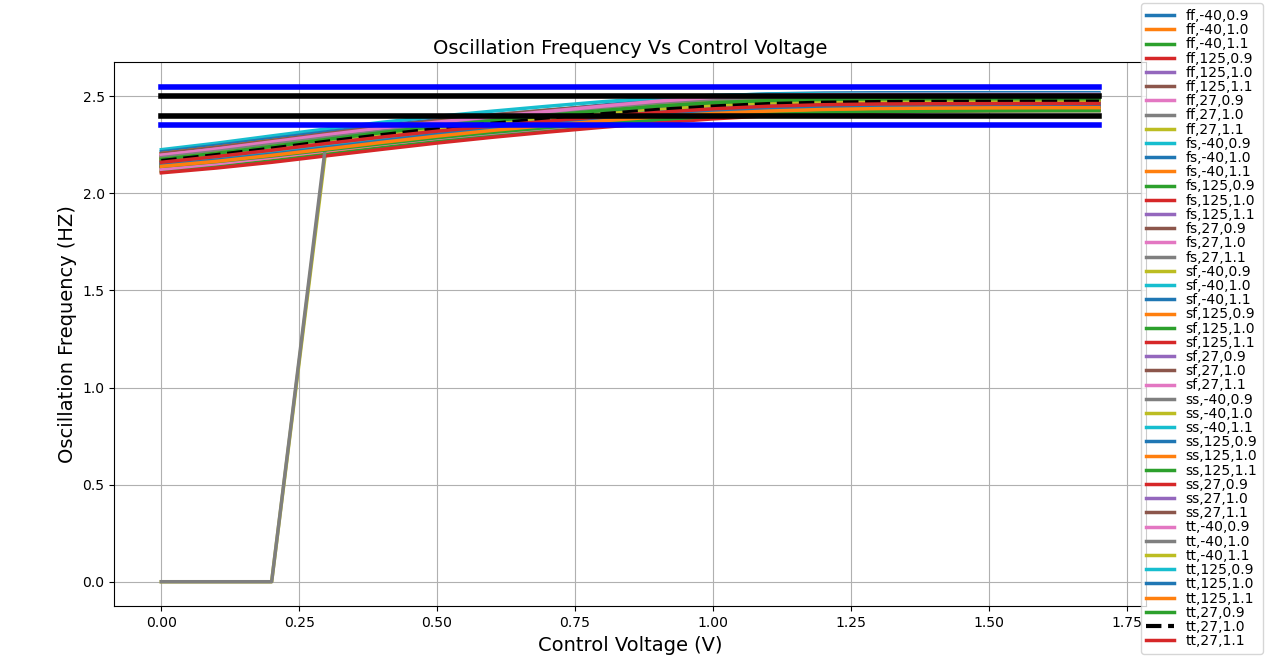
pll/selected_vco_lib/results/vco_post_pex_ideal_current/frequency_before_modification.png
