mabrains/PLL_design/pll/system/ngspice_time_model/test_benches/pfd_cp_lf_integeration/Feedback signal leads the Reference.png

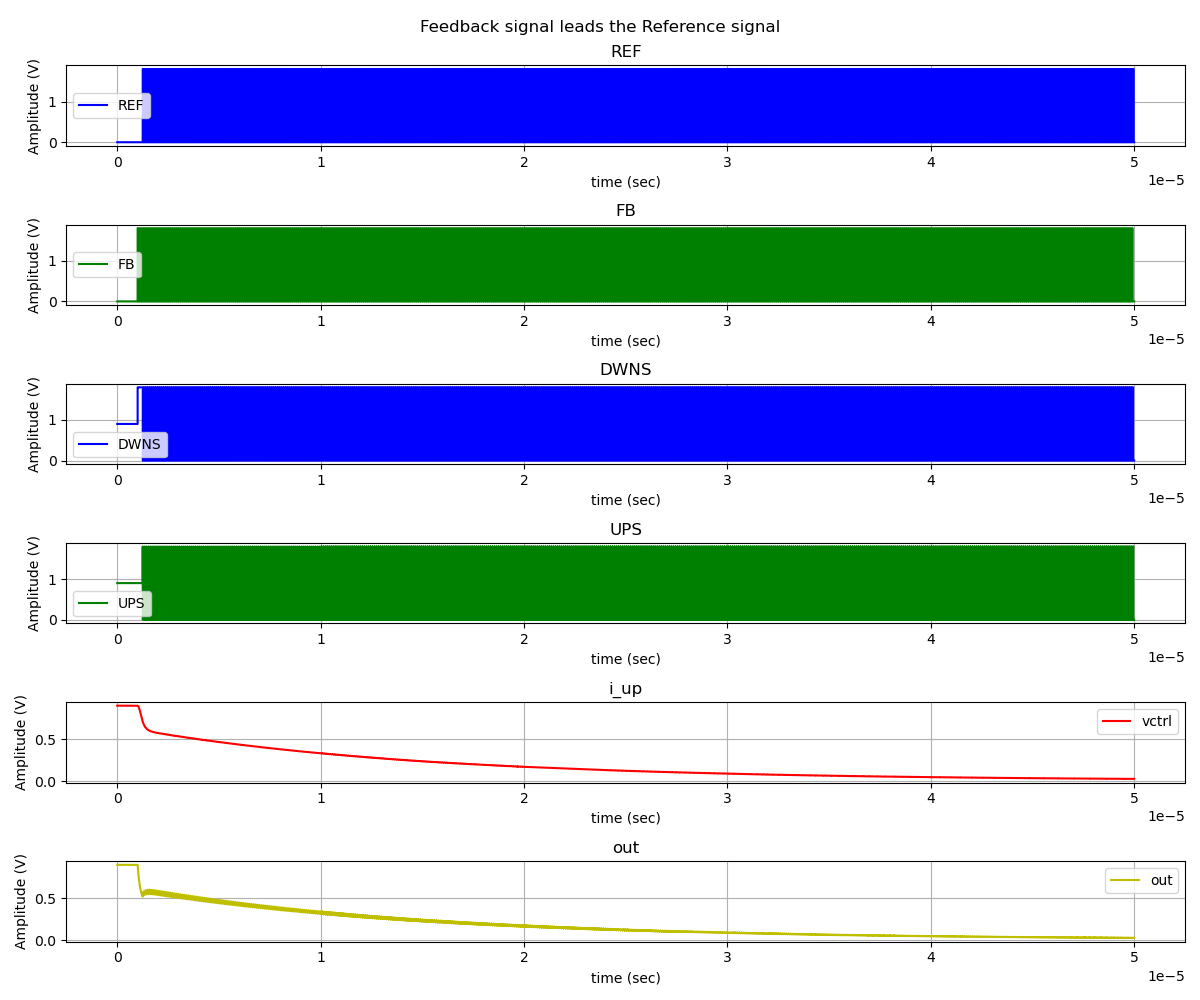
pll/system/ngspice_time_model/test_benches/pfd_cp_lf_integeration/Feedback signal leads the Reference.png
