mabrains/PLL_design/pll/system/ngspice_time_model/test_benches/pfd_cp_lf_integeration/Locked State.png

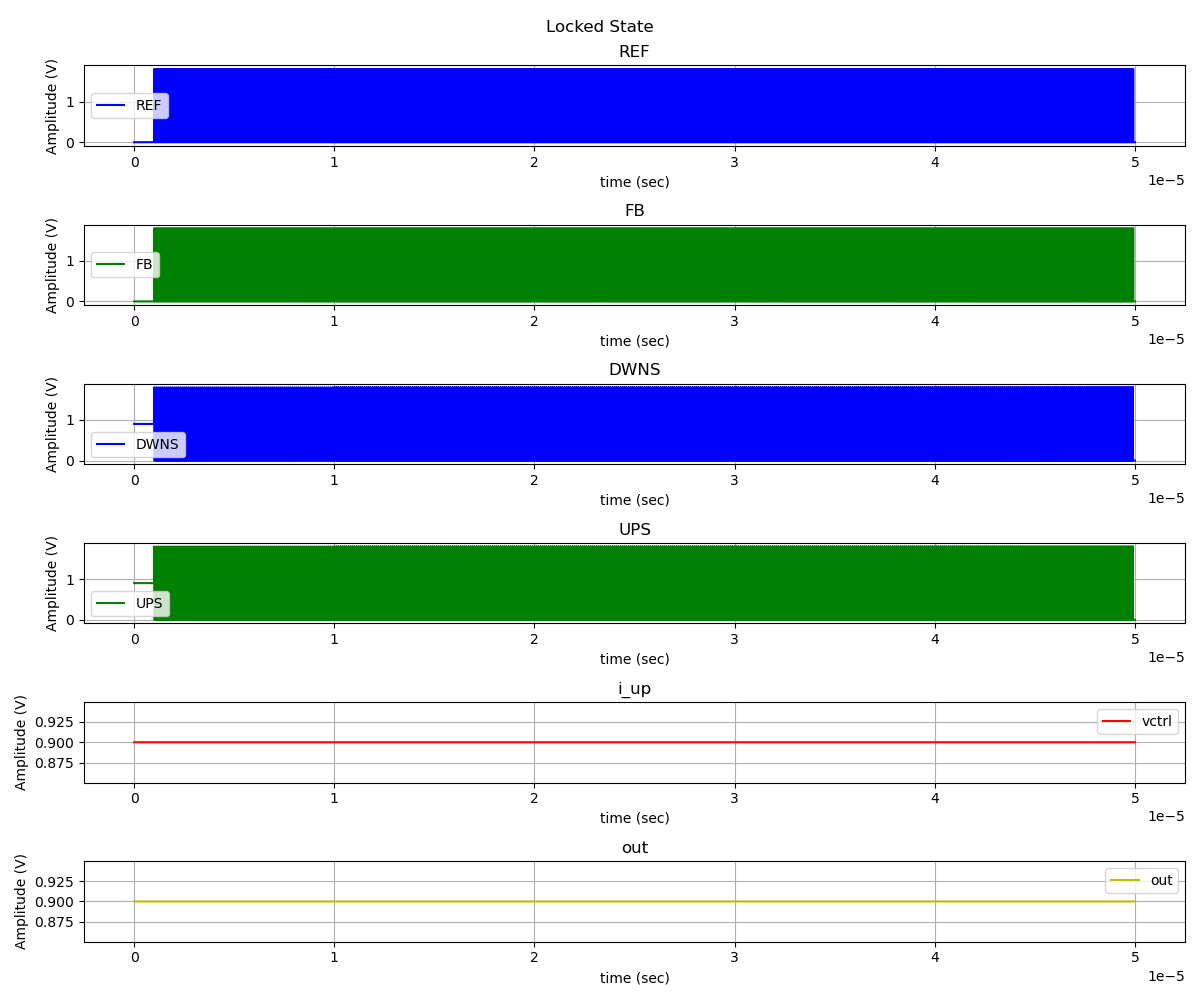
pll/system/ngspice_time_model/test_benches/pfd_cp_lf_integeration/Locked State.png
