mabrains/PLL_design/pll/system/ngspice_time_model/test_benches/pfd_cp_lf_integeration/Reference signal leads the Feedback signal.png

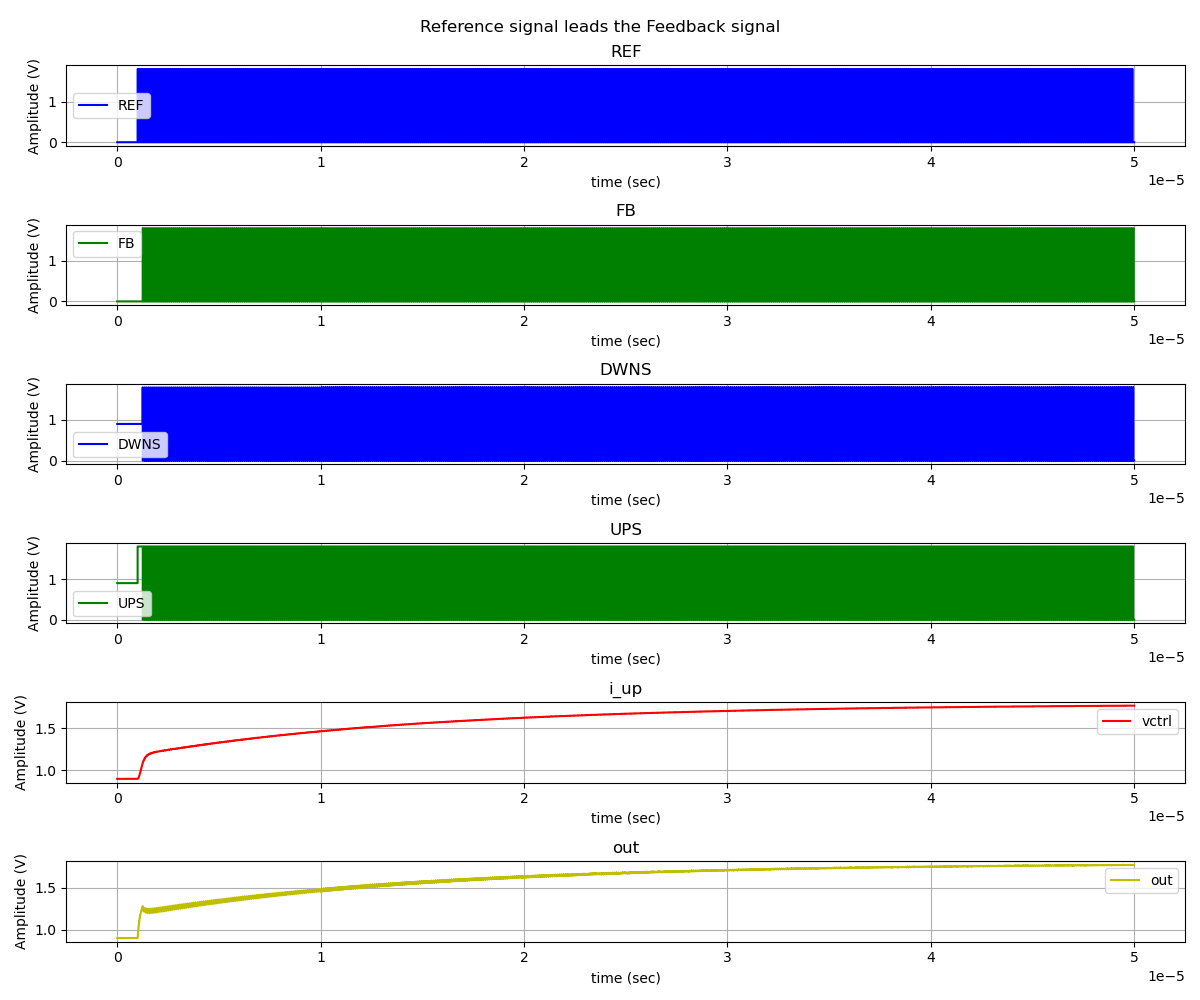
pll/system/ngspice_time_model/test_benches/pfd_cp_lf_integeration/Reference signal leads the Feedback signal.png
