mabrains/PLL_design/pll/system/ngspice_time_model/test_benches/pfd_cp_lf_vco_integeration/vco at up.png

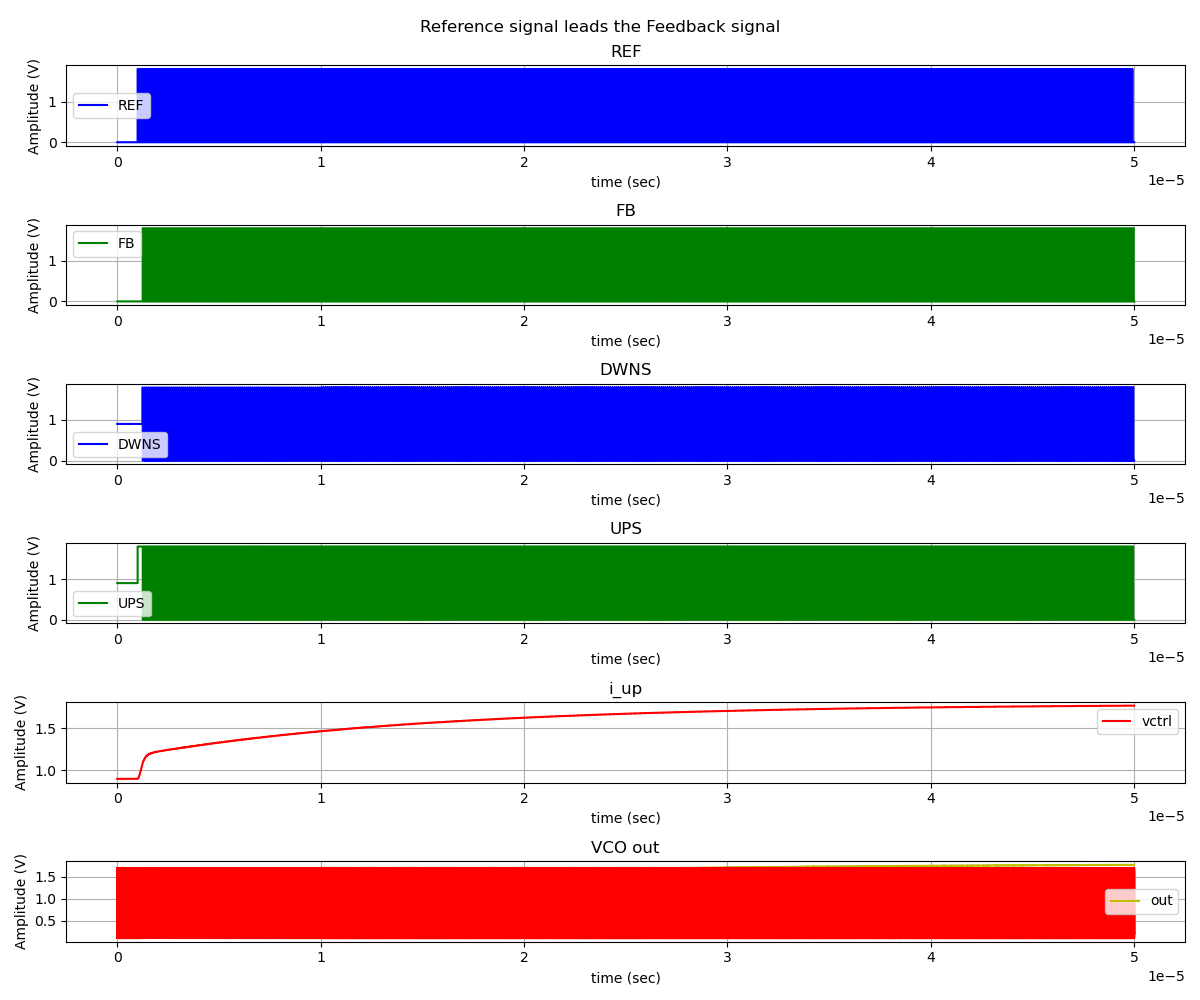
pll/system/ngspice_time_model/test_benches/pfd_cp_lf_vco_integeration/vco at up.png
