mabrains/PLL_design/pll_int/Divider/layout/hierarchical_cdl_experiment/images/divider_lvs_using_hierarchical_cdl.png

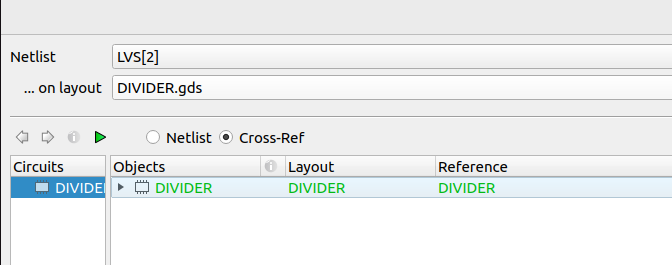
pll_int/Divider/layout/hierarchical_cdl_experiment/images/divider_lvs_using_hierarchical_cdl.png
