mabrains/PLL_design/pll_int/PLL/layout/lvs_klatout_hierarchical_cdl_2/images/klayout_lvs_result.png

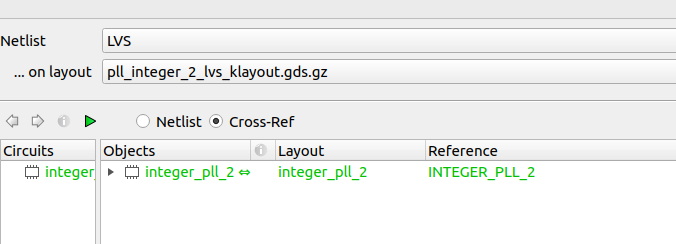
pll_int/PLL/layout/lvs_klatout_hierarchical_cdl_2/images/klayout_lvs_result.png
