mabrains/PLL_design/pll_int/PLL/results/pex_results/images/aferlock.png

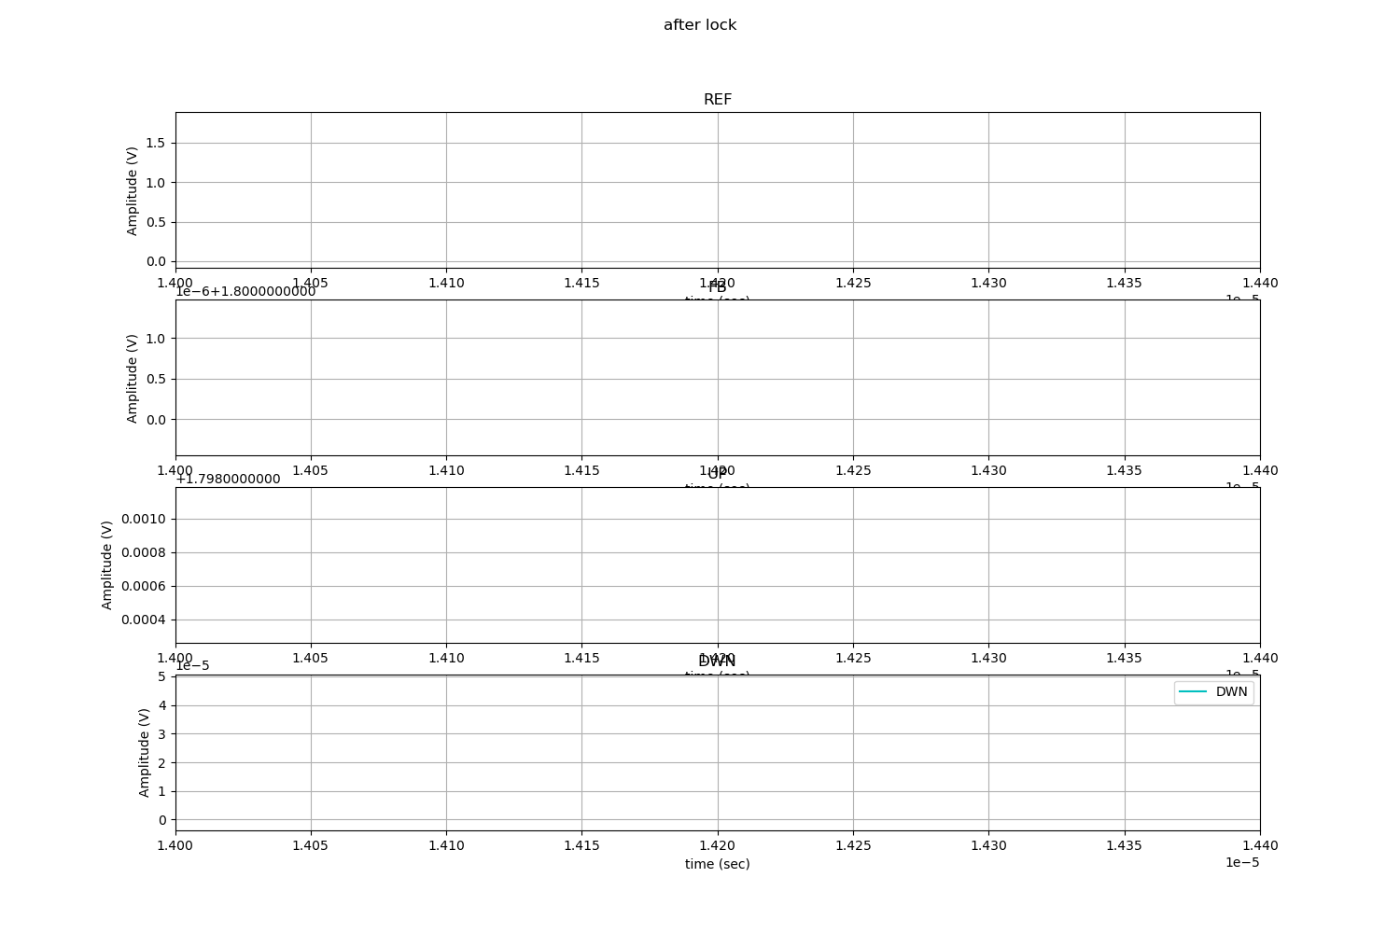
pll_int/PLL/results/pex_results/images/aferlock.png
