mabrains/PLL_design/pll_int/PLL/results/pex_results/images/VCO_out_after_inv.png

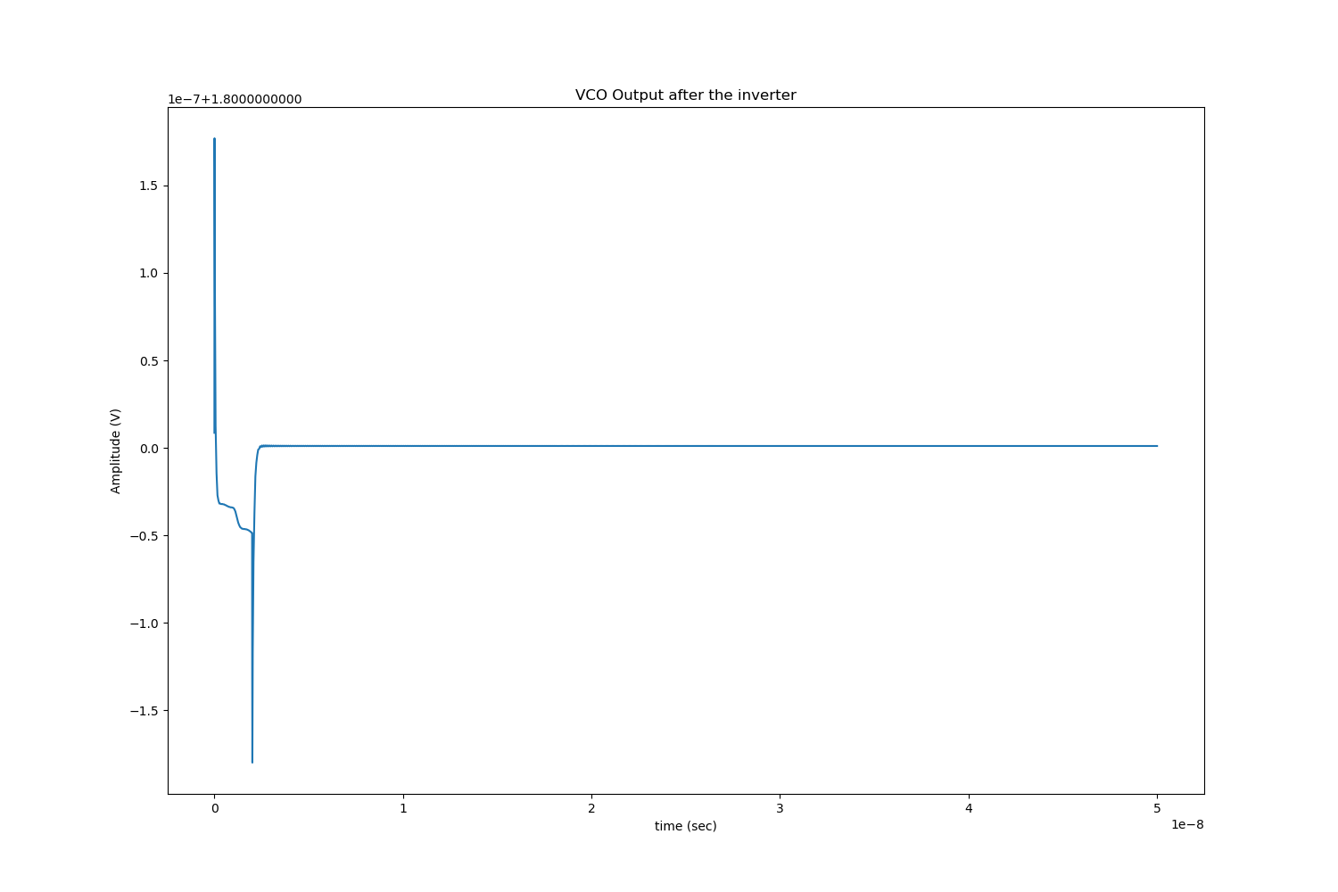
pll_int/PLL/results/pex_results/images/VCO_out_after_inv.png
