mabrains/PLL_design/pll_int/PLL/results/pex_results/images/vctrl.png

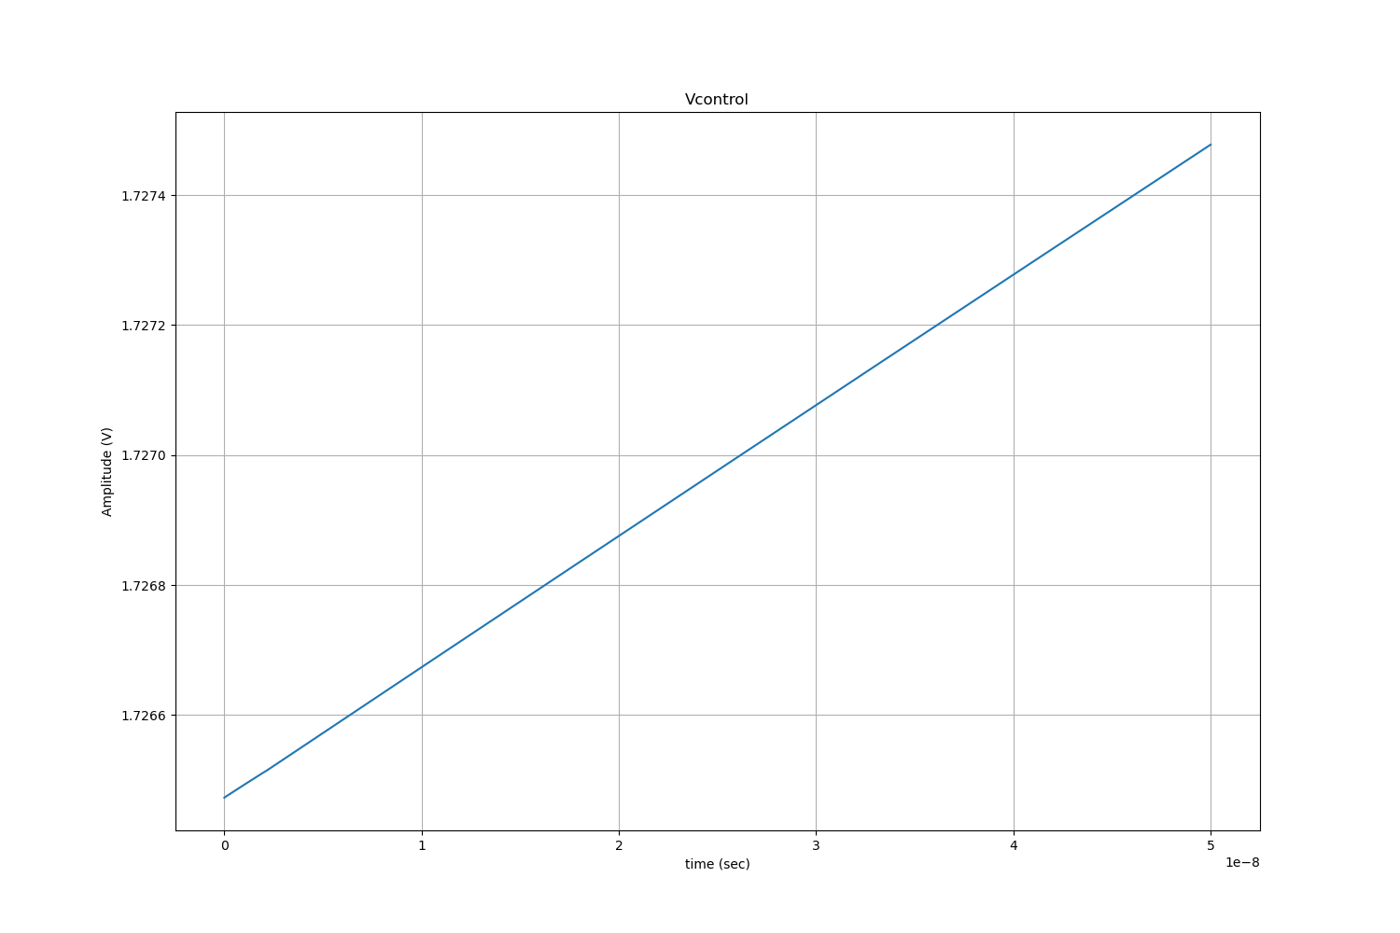
pll_int/PLL/results/pex_results/images/vctrl.png
