mabrains/PLL_design/pll_int/PLL/results/schematic_results/images/vco_freq.png

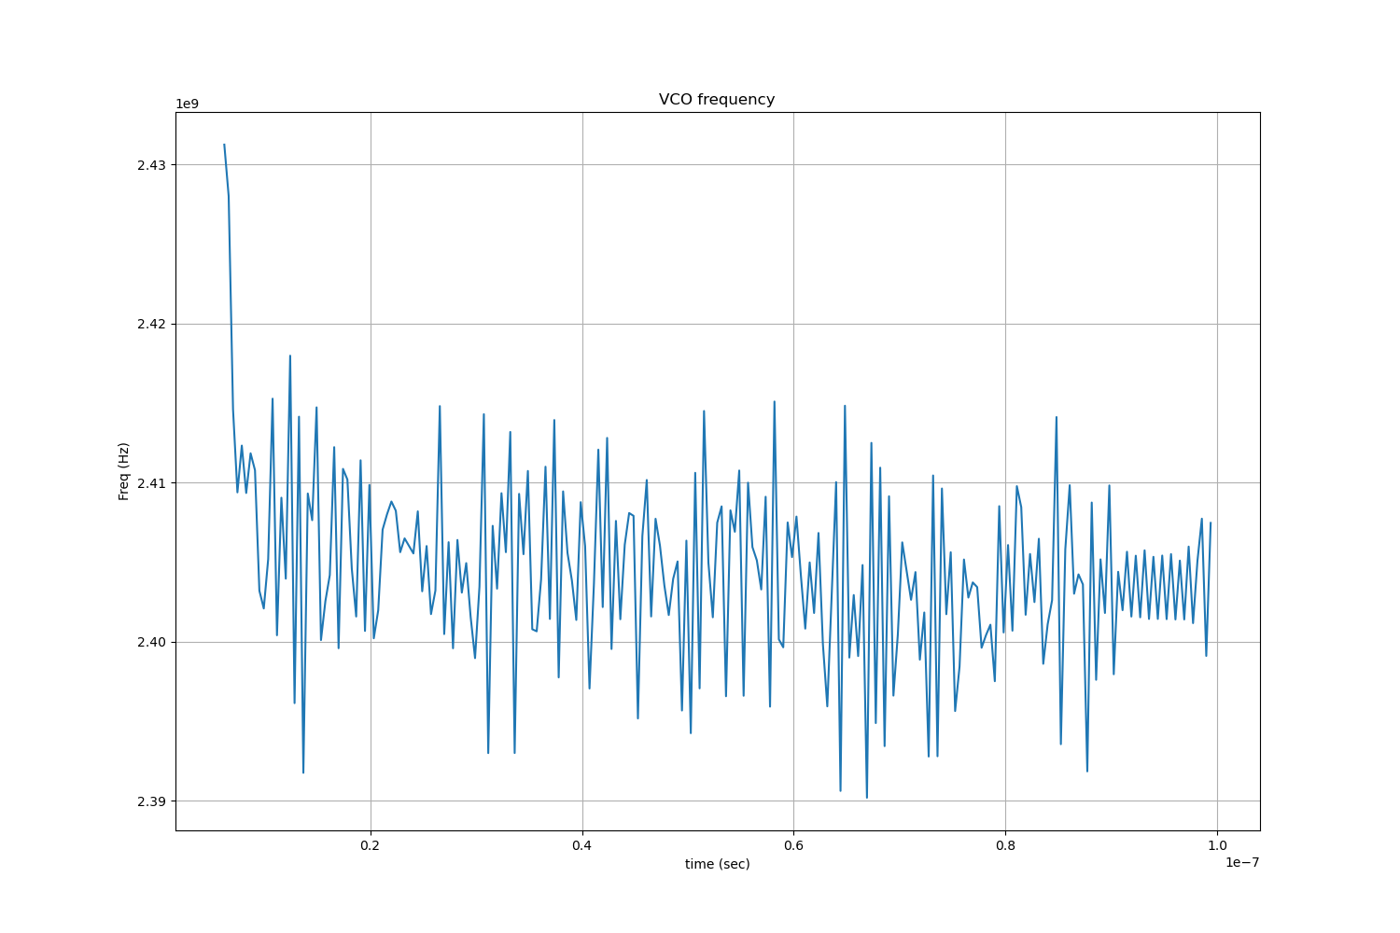
pll_int/PLL/results/schematic_results/images/vco_freq.png
