mabrains/PLL_design/pll_int/PLL/results/schematic_results/images/vctrl.png

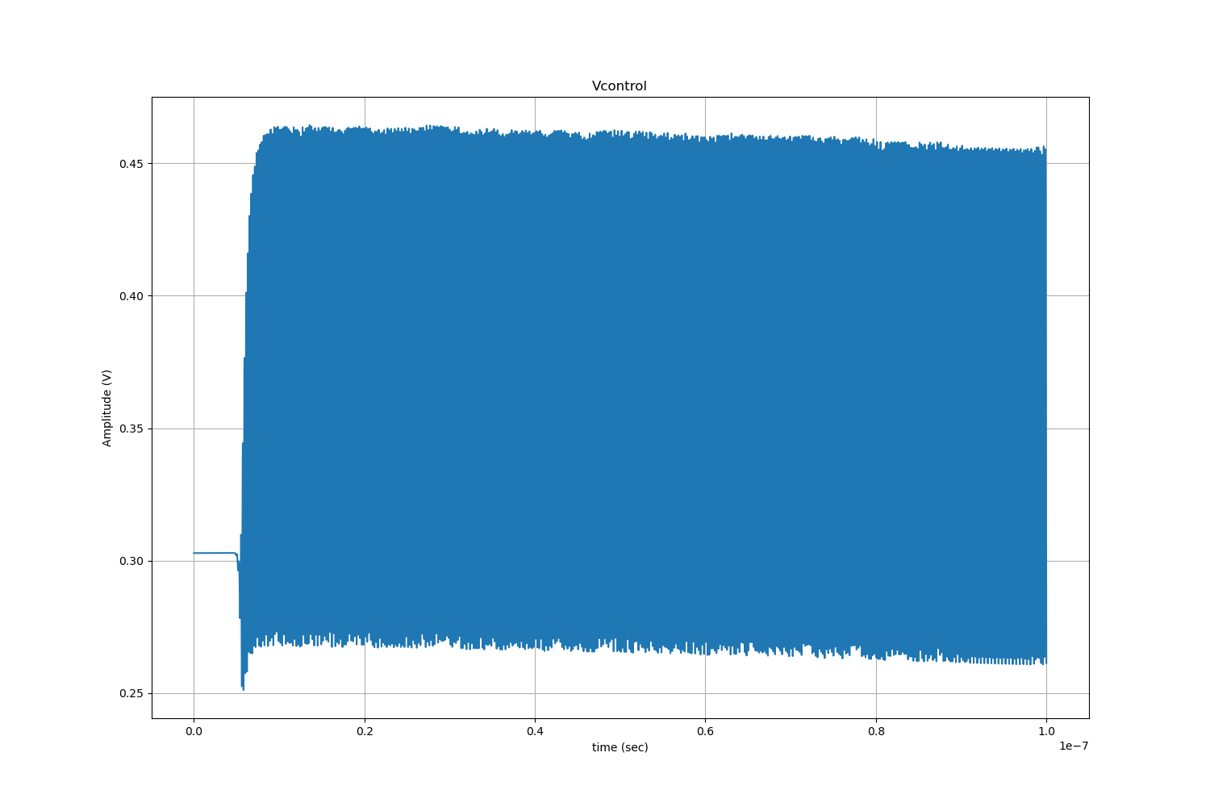
pll_int/PLL/results/schematic_results/images/vctrl.png
