mabrains/PLL_design/pll/system/Diagrams.pdf

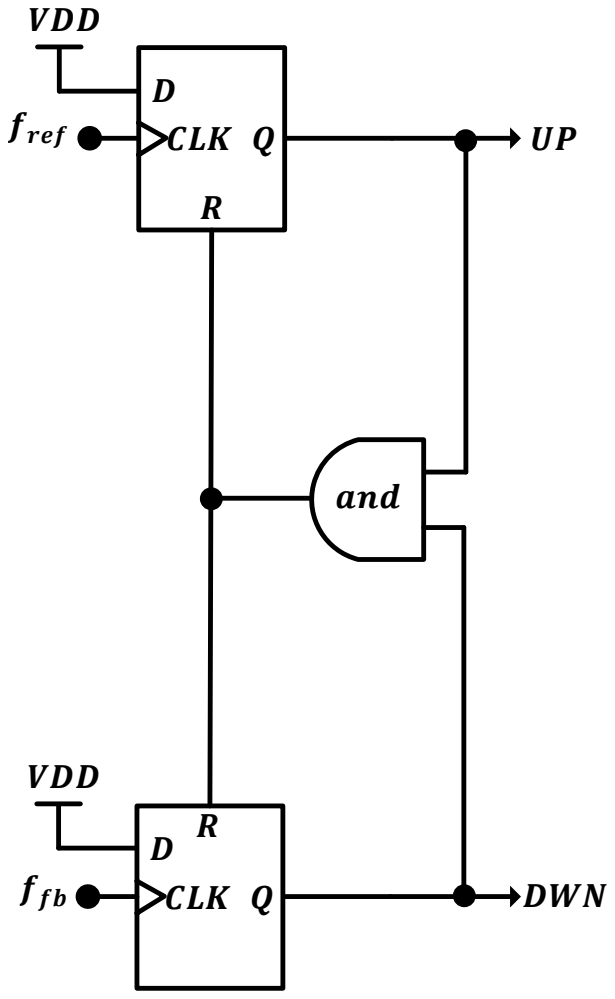
[picture p314: page 1]
CLR; ffb; CLK; fref; VDD; DWN; and

SET

R SET

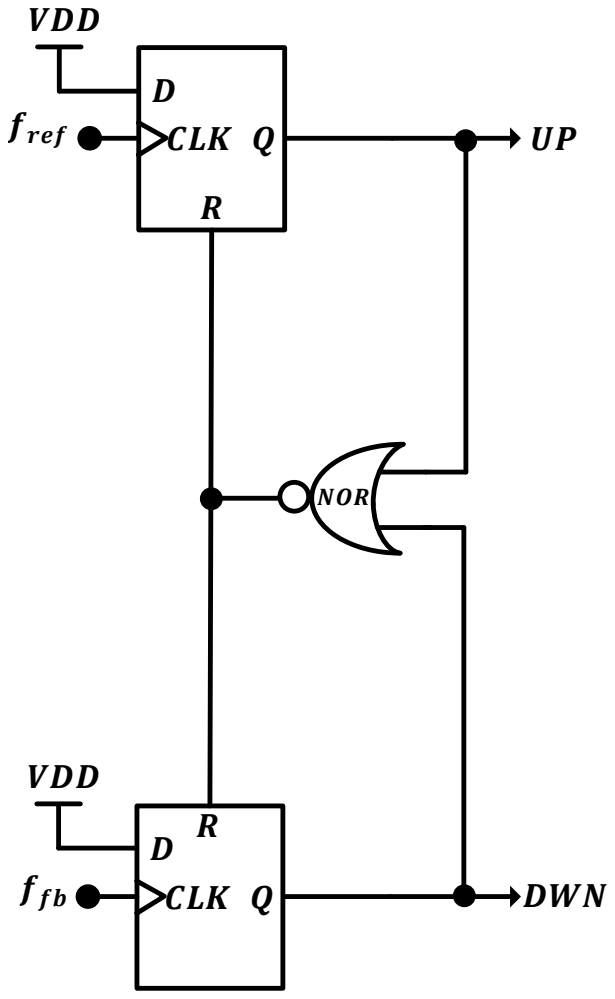
[picture p315: page 2]
CLR; ffb; CLK; fref; VDD; DWN; NOR

SET

R SET

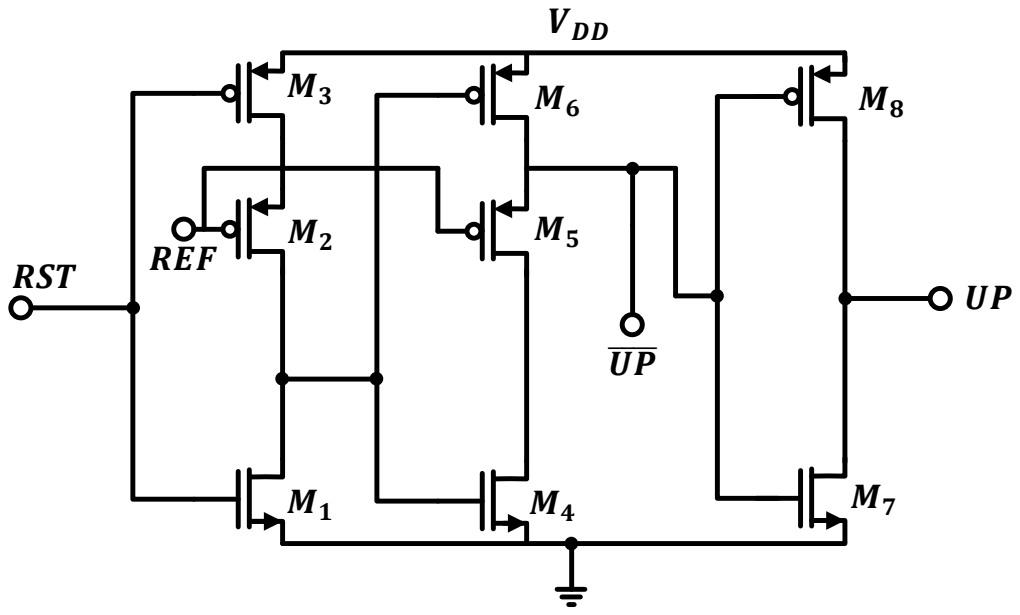
[picture p316: page 3]
VDD; RST; REF

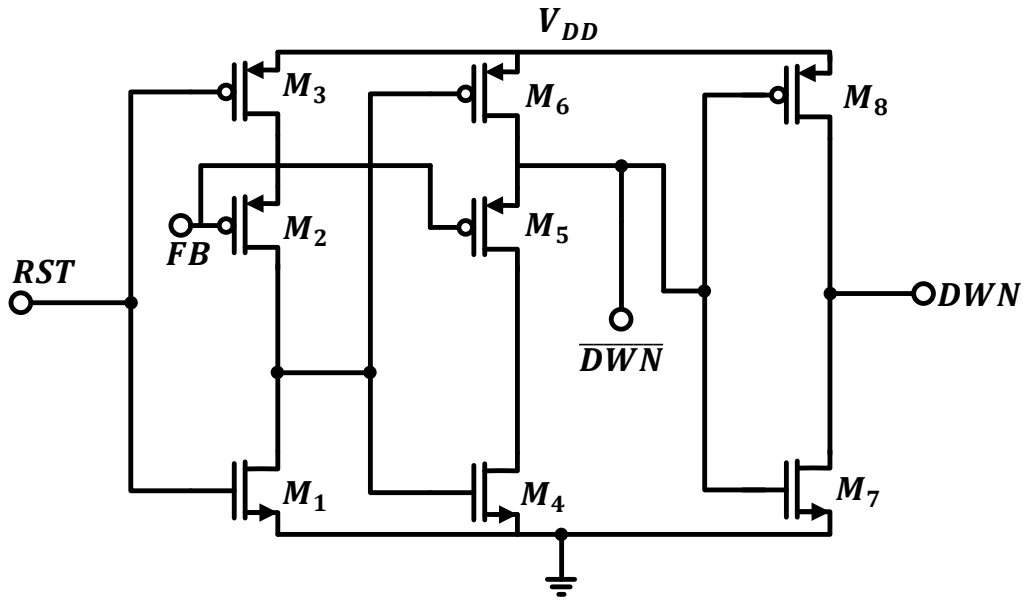
[picture p317: page 4]
VDD; RST; DWN

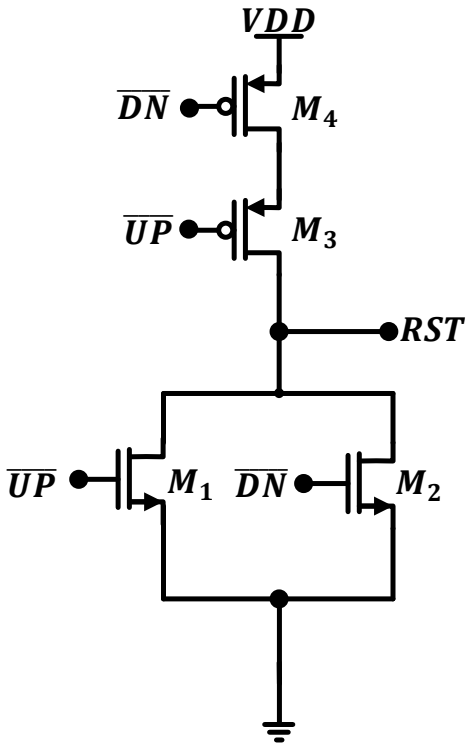
[picture p318: figure]
VDD; RST
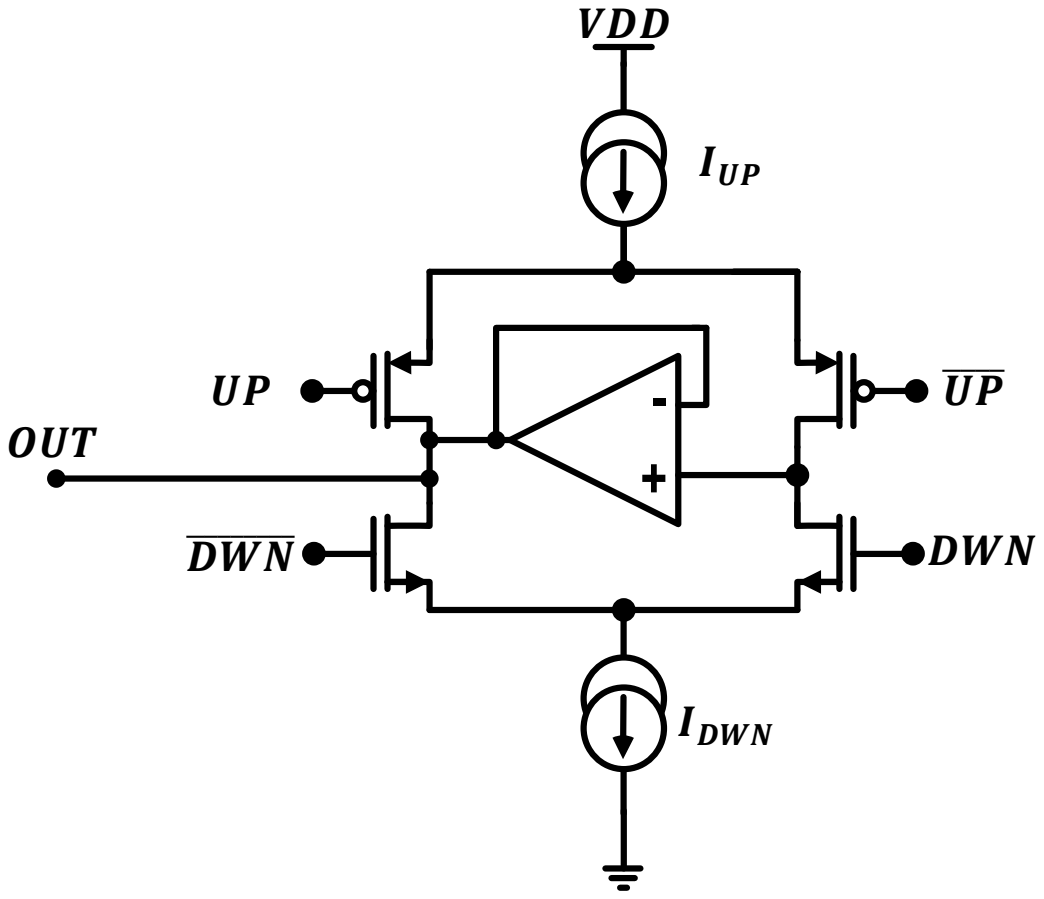
[picture p319: page 6]
DWN VDDIDWN IUP OUT

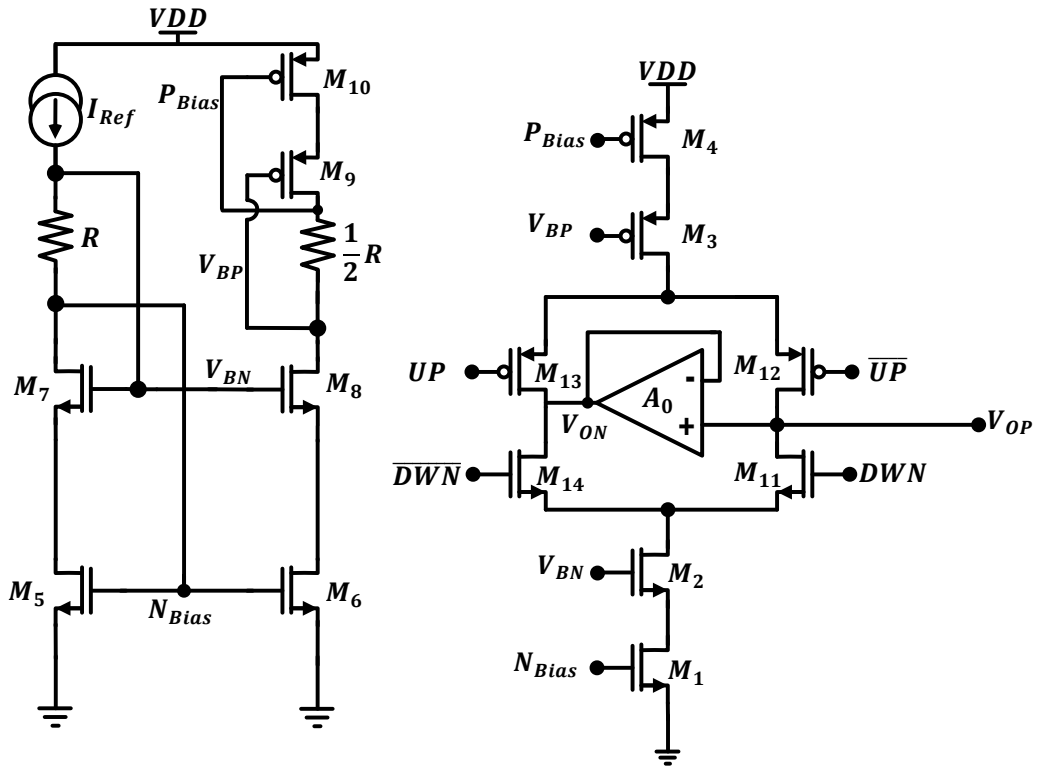
[picture p320: page 7]
DWN VON; VOP RIRef; 12R NBias; NBias PBias; PBias VBN VBP VBN VBP VDD

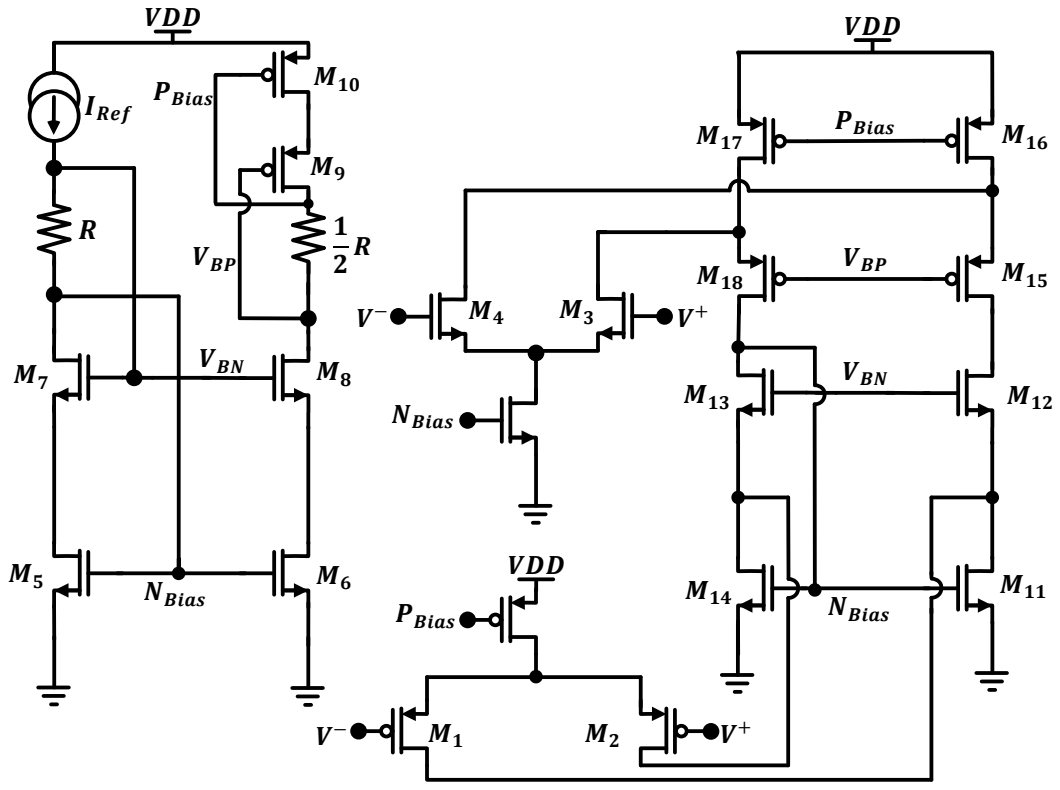
[picture p321: page 8]
IRef; NBias; PBias; VBN; VBP; VDD

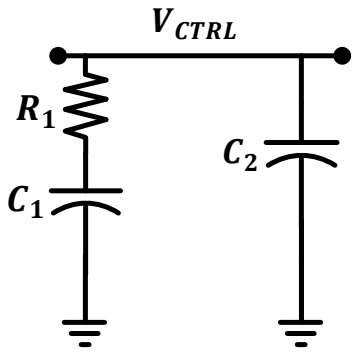
[picture p322: figure]
VCTRL

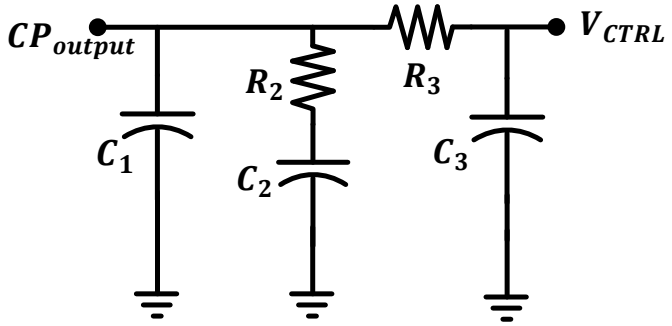
[picture p323: figure]
VCTRL; CPoutput

## BGR

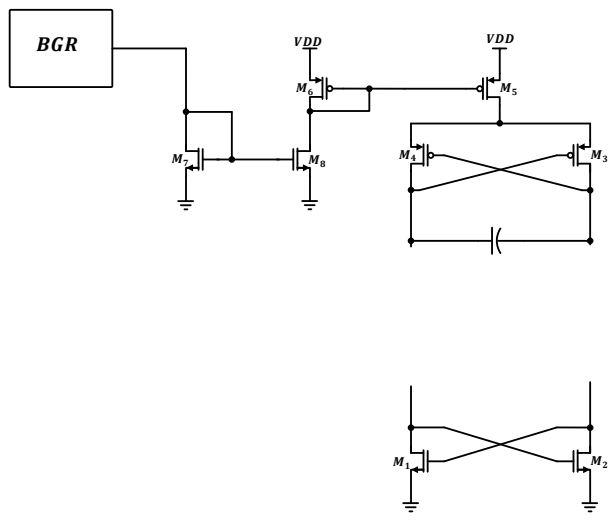
[picture p324: page 11]
VDD

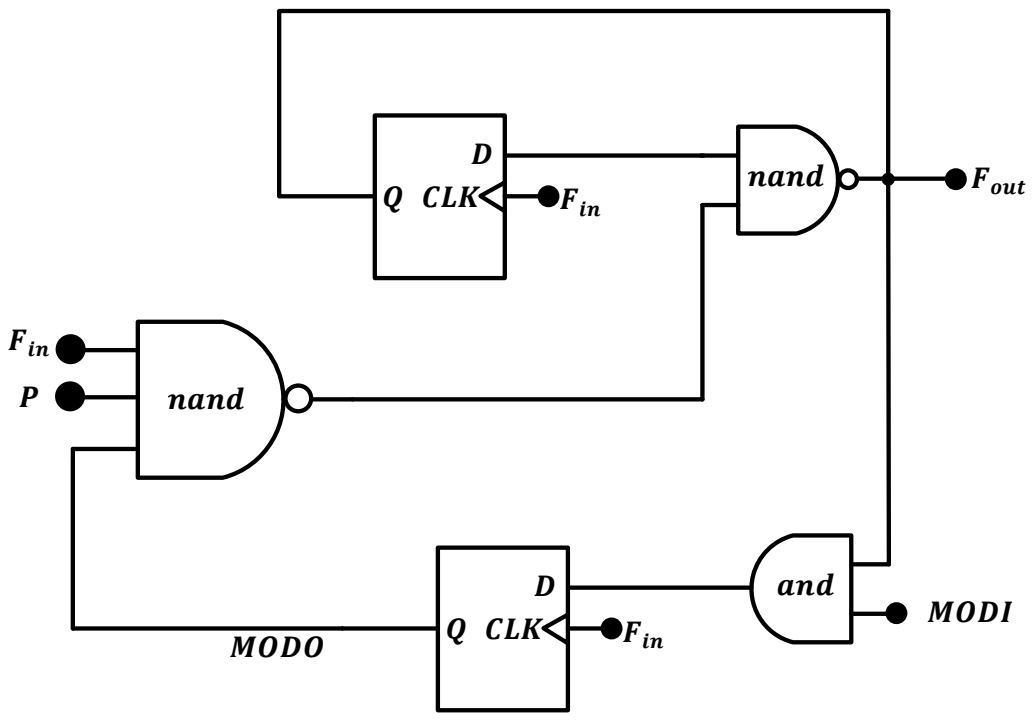
[picture p325: page 12]
MODI; and; nand; CLR; Fin; MODO; Fout

SET

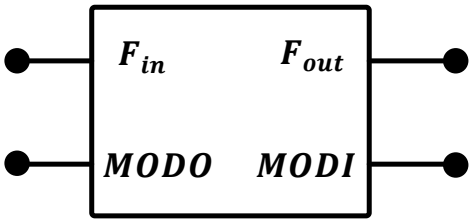
[picture p326: figure]
Fout; MODO; MODI; Fin

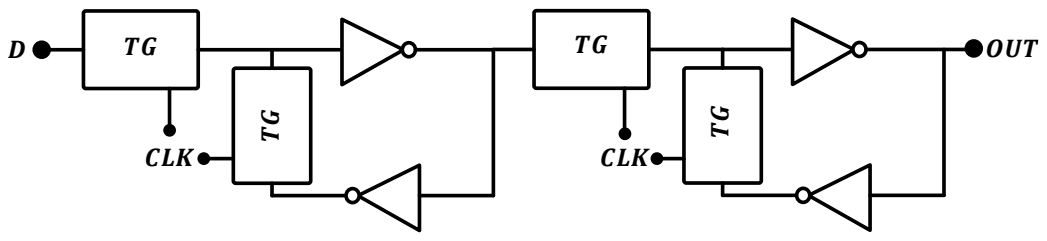
[picture p327: page 15]
OUT; CLK

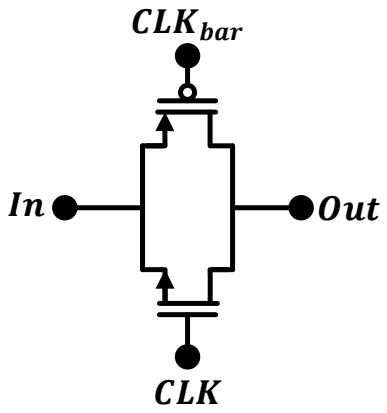
[picture p328: figure]
CLKbar; CLK; Out
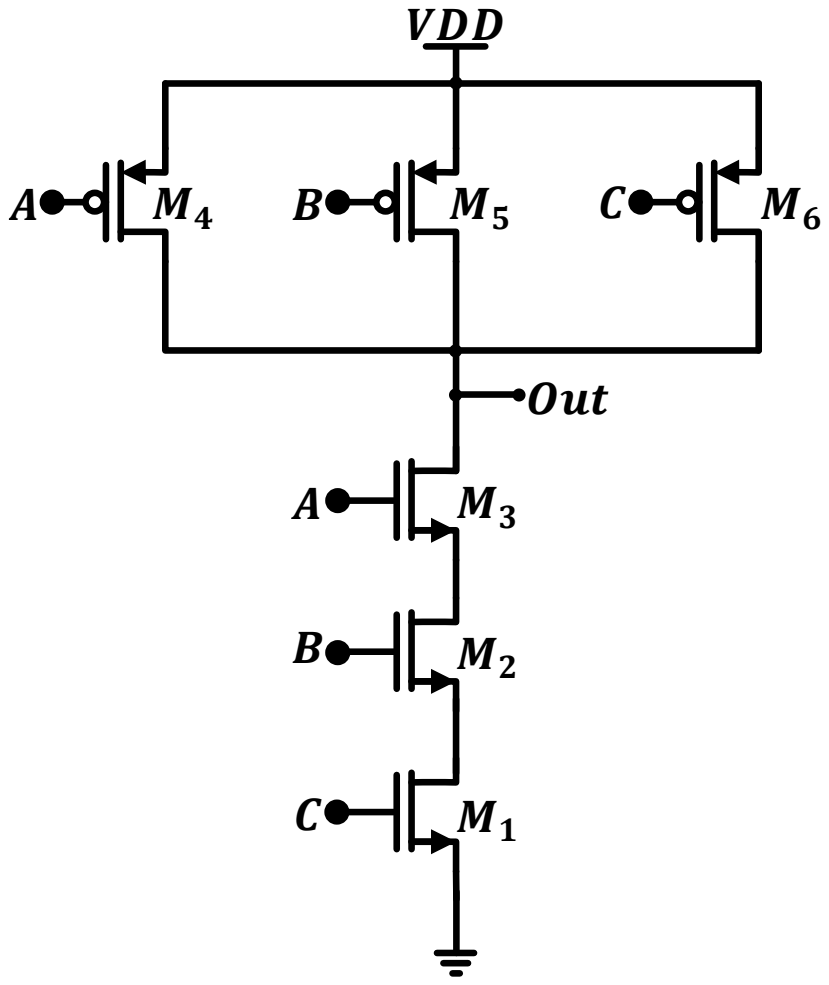
[picture p329: page 17]
VDD; Out

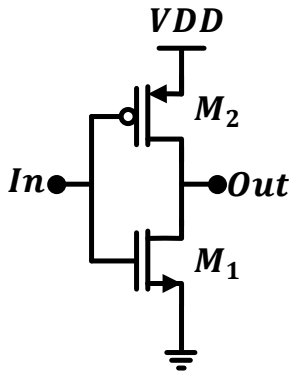
[picture p330: figure]
VDD; Out

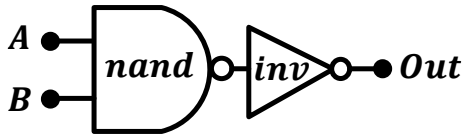
[picture p331: figure]
nand; inv; Out

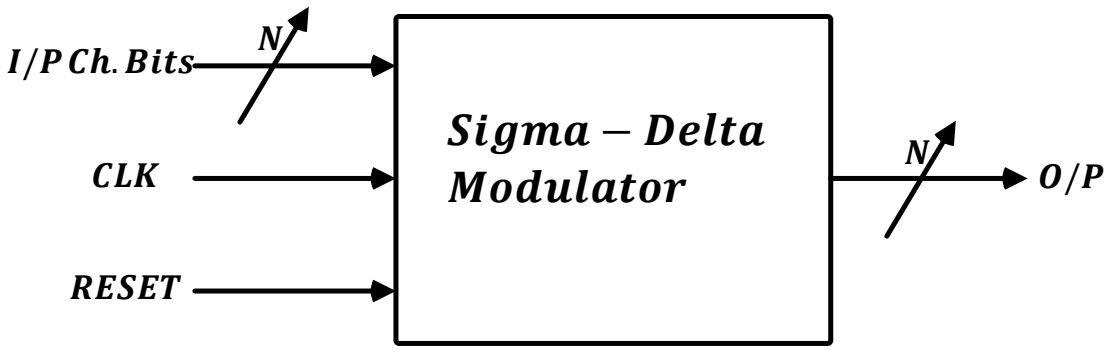
[picture p332: figure]
I/PCh. Bits; CLK; RESET; Sigma − Delta Modulator

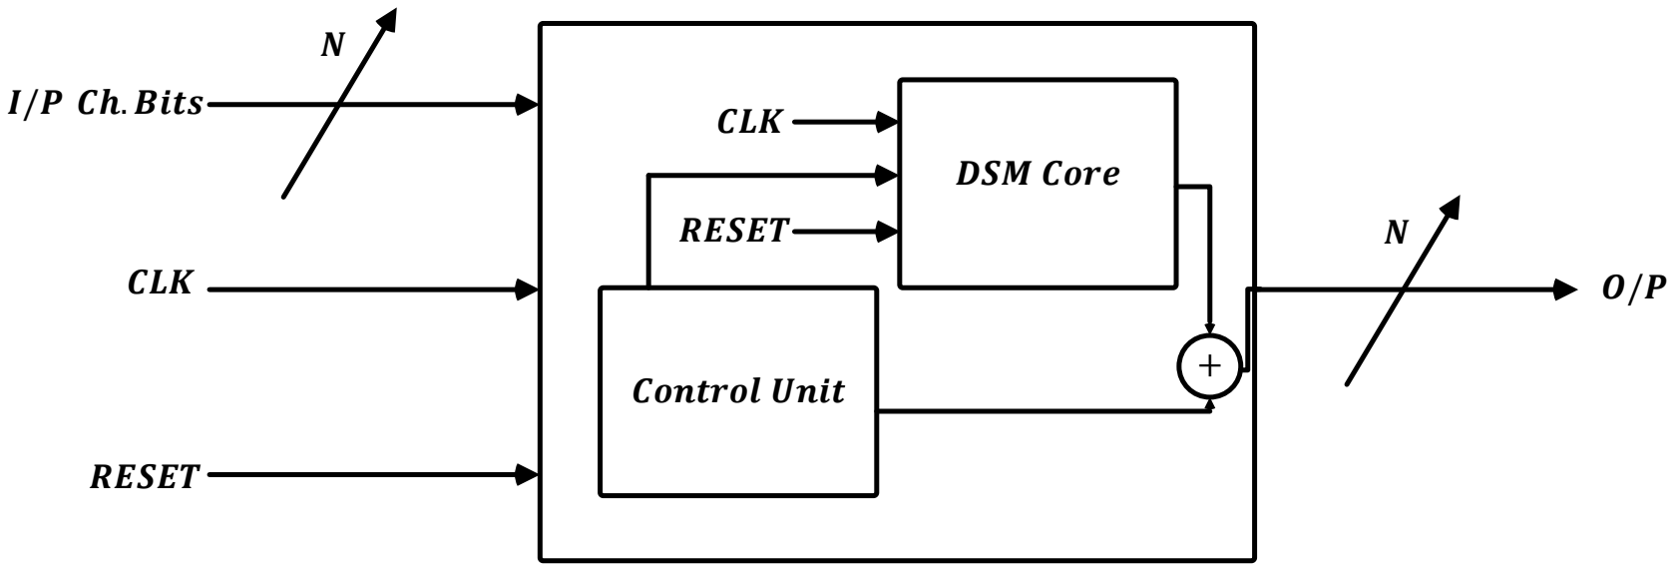
[picture p333: figure]
I/P Ch. Bits; CLK; RESET; Control Unit; DSM Core
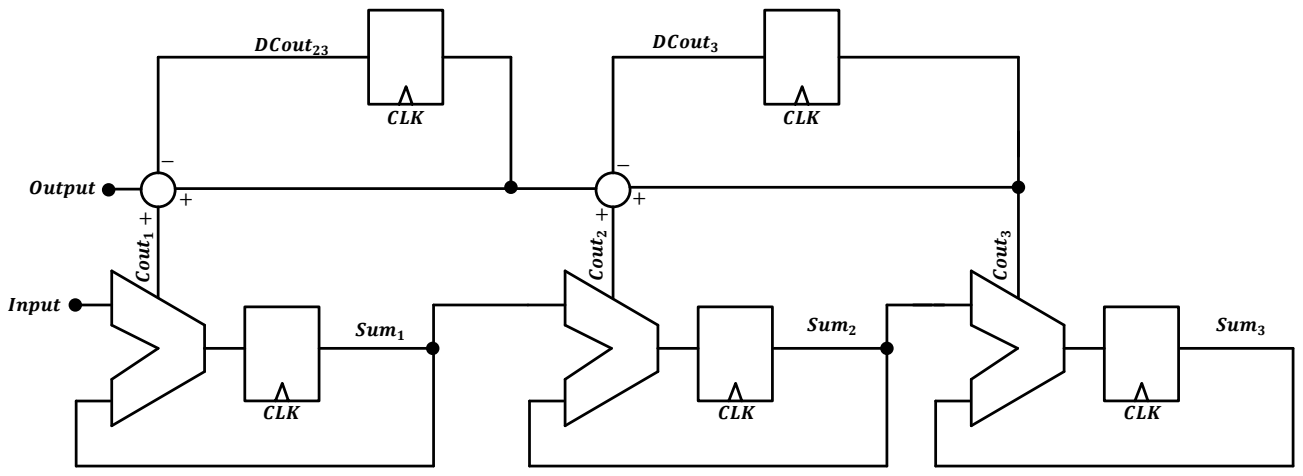
[picture p334: page 22]
CLR; SET D

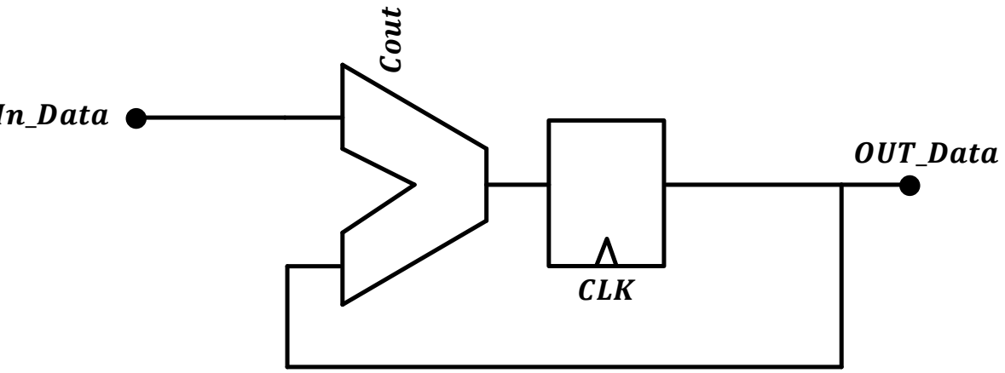
[picture p335: figure]
CLR; SET D

I

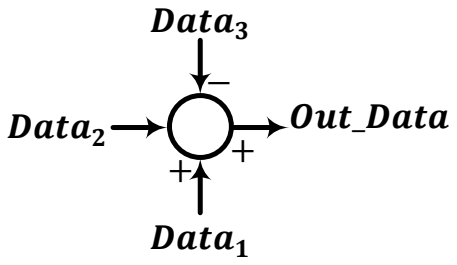
[picture p336: figure]
Data1; Data2; Data3; Out_Data
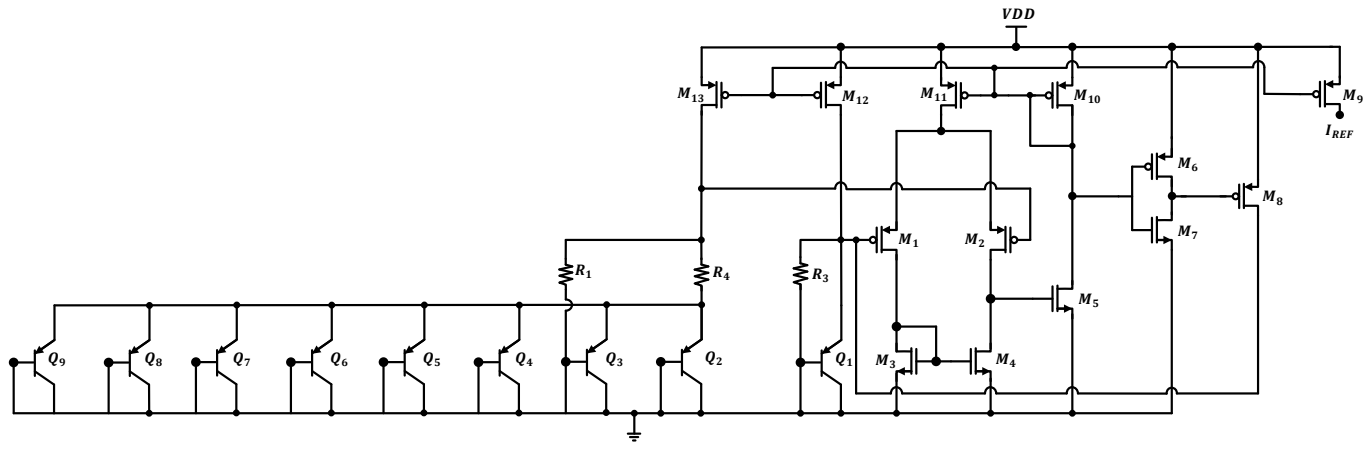
[picture p337: page 25]
VDD; IREF

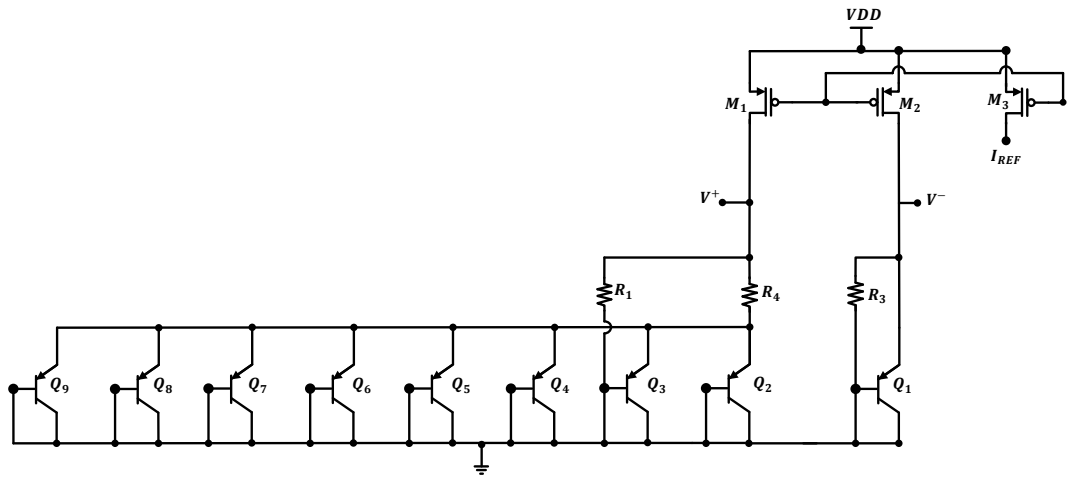
[picture p338: page 26]
VDD; IREF

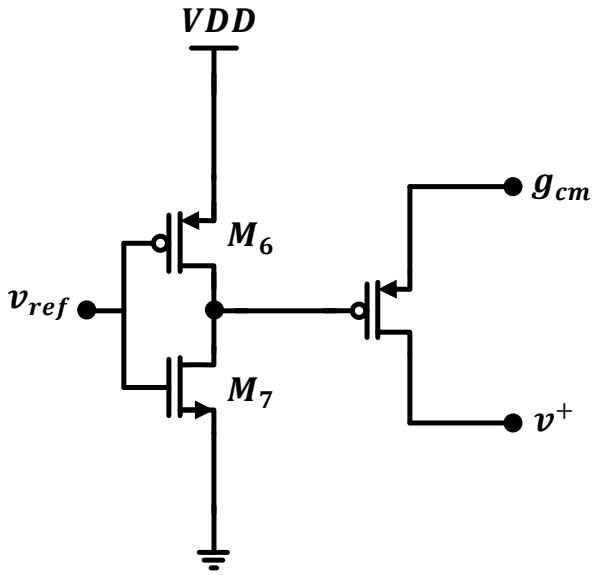
[picture p339: figure]
VDD; vref; gcm
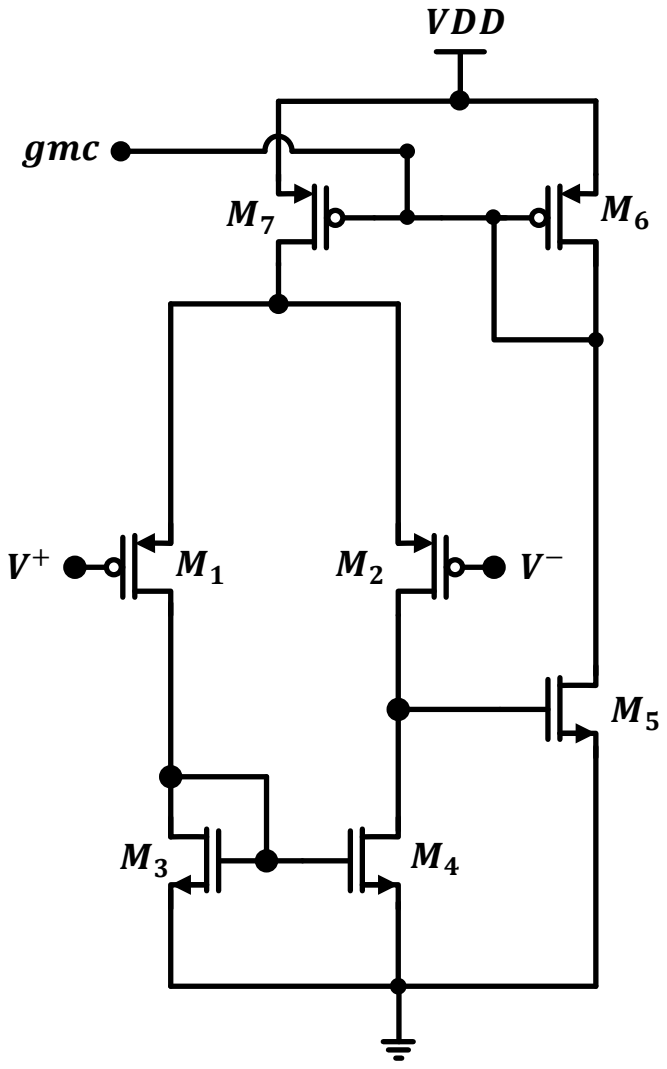
[picture p340: page 28]
VDD; gmc
