mabrains/PLL_design/images/Diagrams/LC VCO/pdf/LC_VCO-11.pdf

## BGR

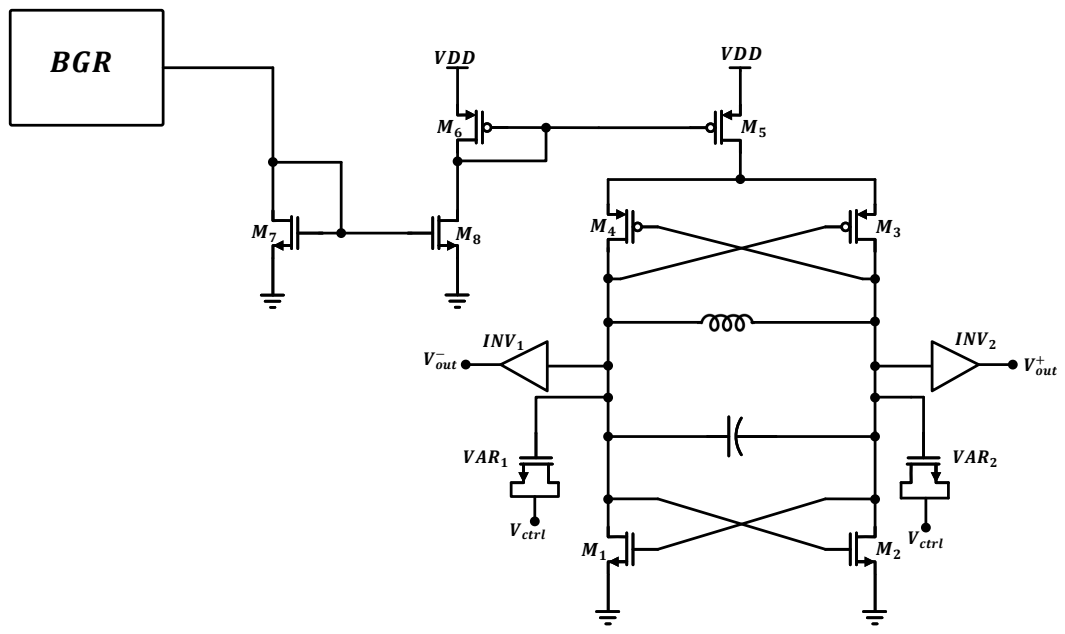
[picture p341: page 1]
VDD; VAR1; VAR2; INV1; INV2; Vctrl; Vout; out
