mabrains/PLL_design/images/Diagrams/LC VCO/pdf/LC_VCO-16.pdf

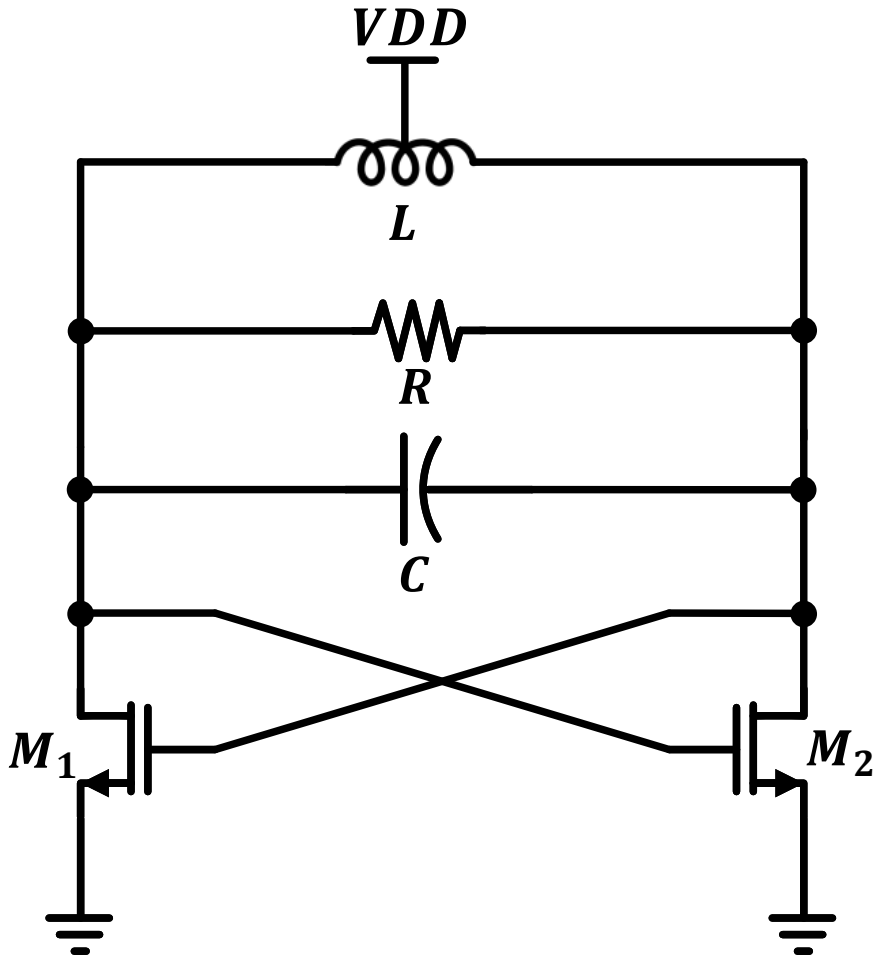
[picture p342: page 1]
VDD
