mabrains/PLL_design/images/Diagrams/LC VCO/pdf/LC_VCO-17.pdf

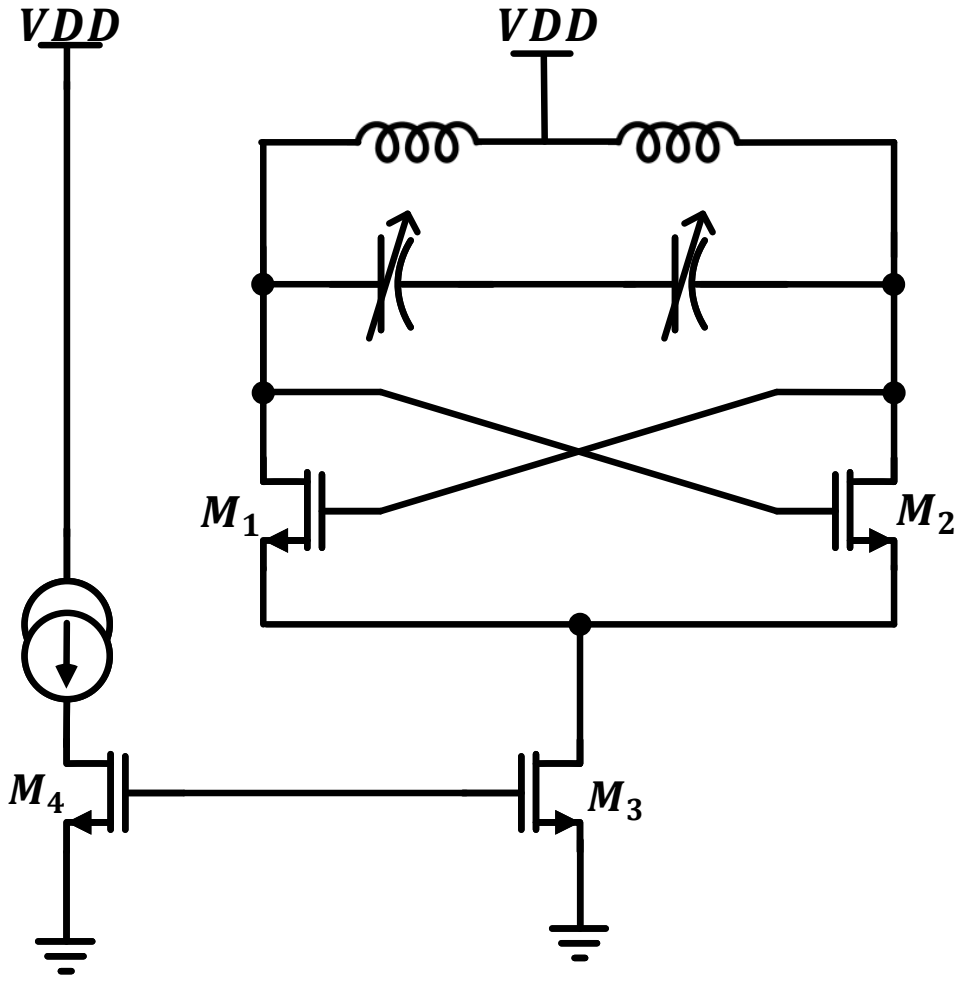
[picture p343: page 1]
VDD
