mabrains/PLL_design/images/Diagrams/LC VCO/pdf/LC_VCO-18.pdf

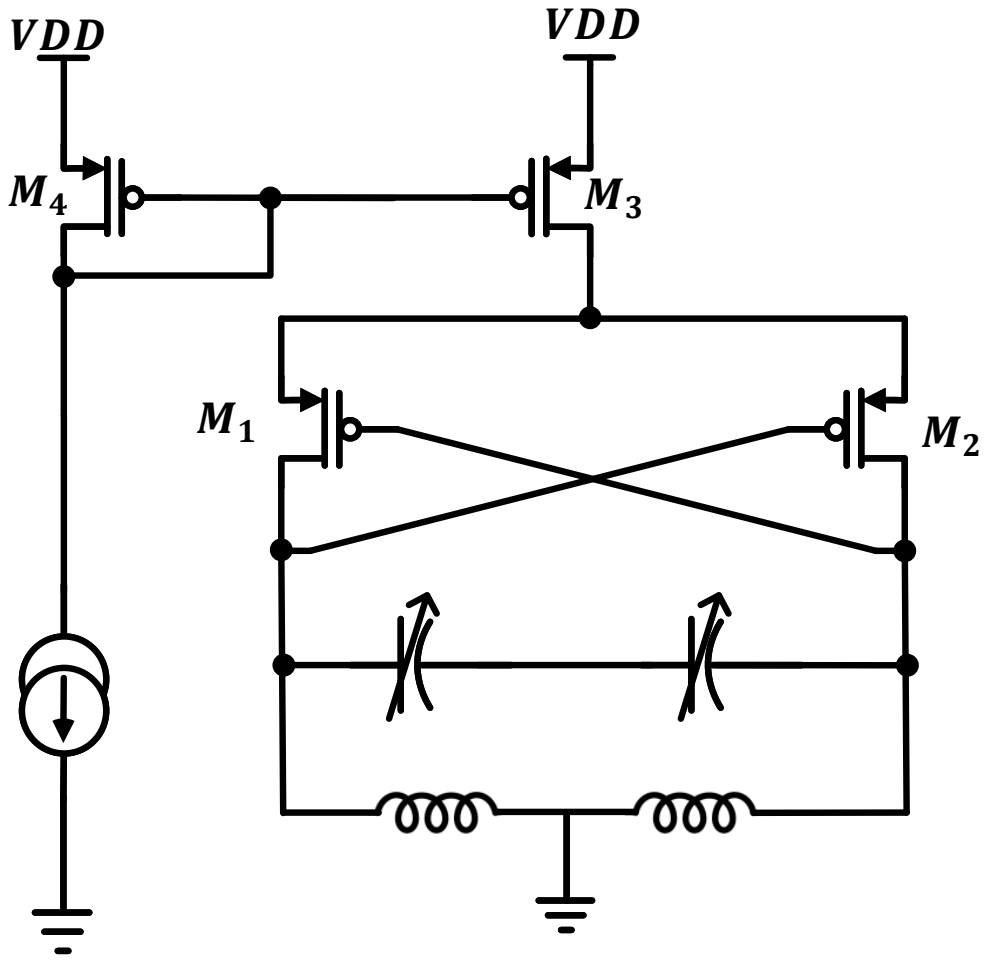
[picture p344: page 1]
VDD
