mabrains/PLL_design/images/Diagrams/LC VCO/pdf/LC_VCO-19.pdf

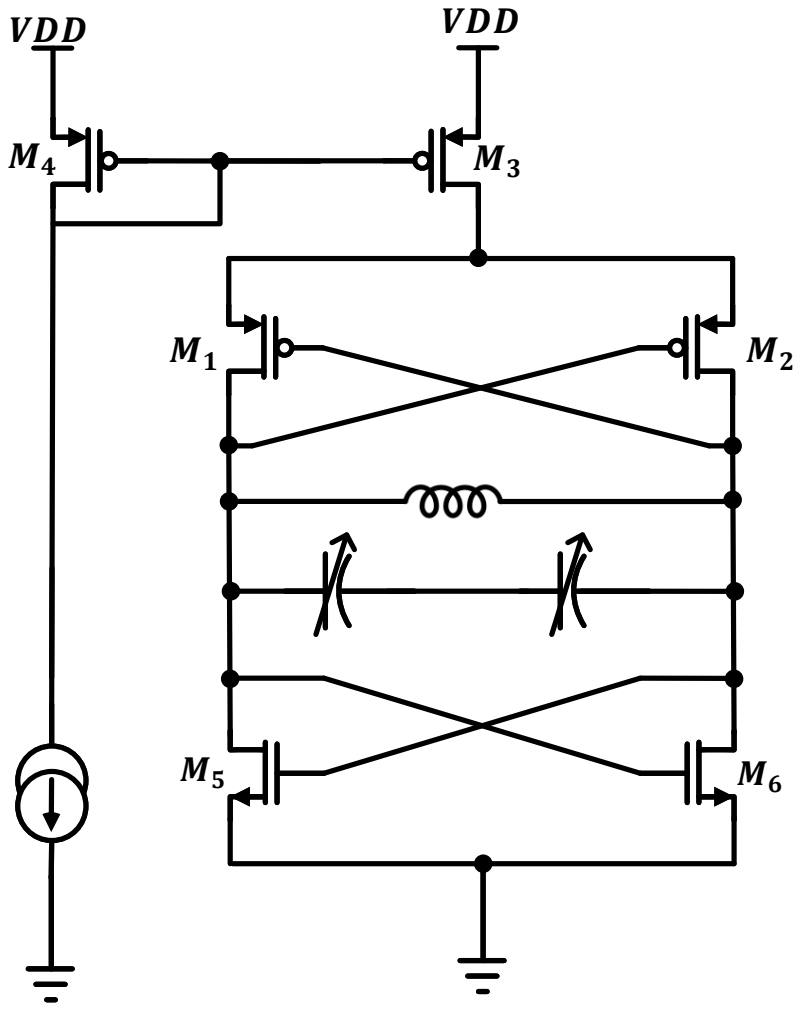
[picture p345: page 1]
VDD
