mabrains/PLL_design/images/Diagrams/LC VCO/pdf/LC_VCO-8.pdf

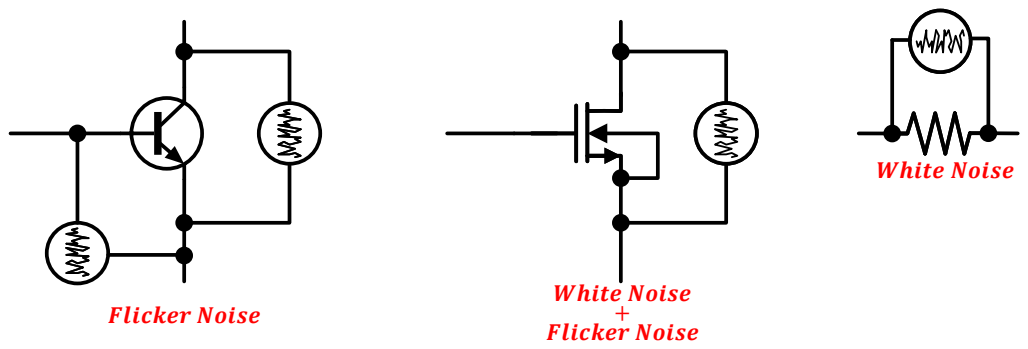
[picture p346: page 1]
Flicker Noise; White Noise +; White Noise
