mabrains/PLL_design/images/Diagrams/Charge pump/pdf/Chargepump_BD.pdf

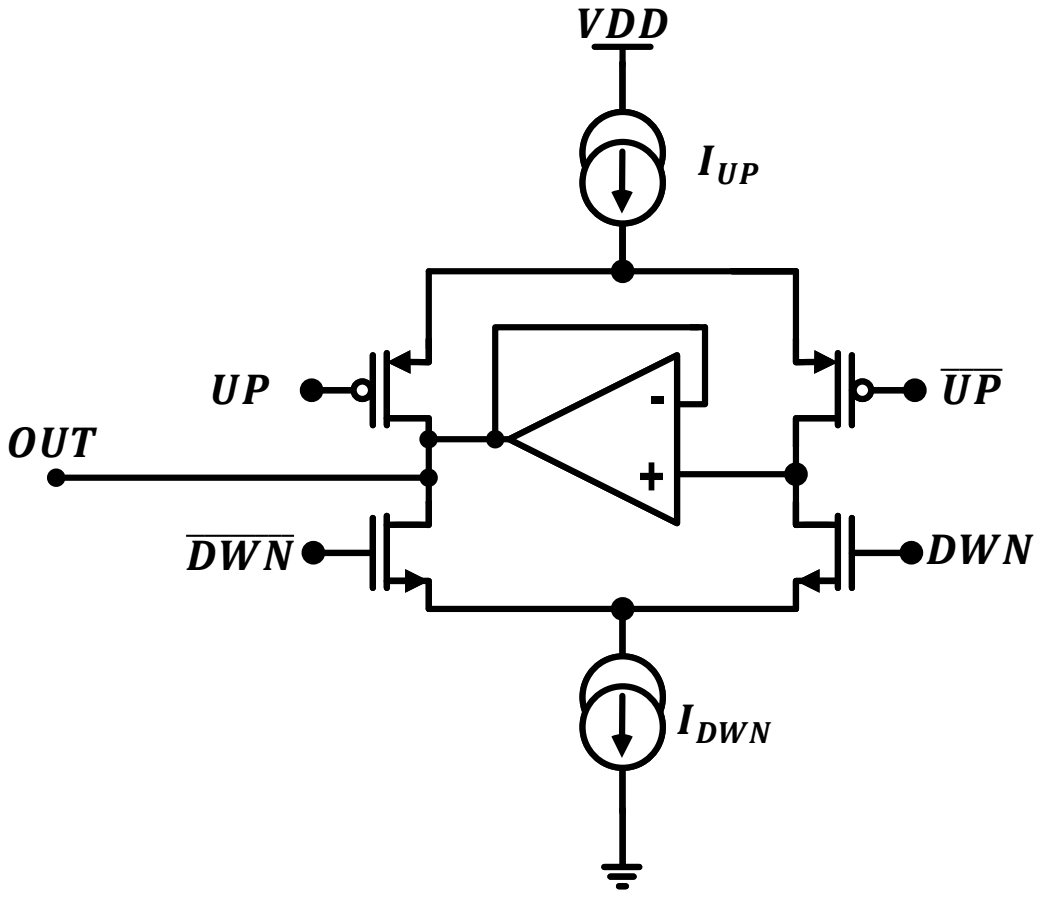
[picture p347: page 1]
DWN VDDIDWN IUP OUT
