mabrains/PLL_design/images/Diagrams/Charge pump/pdf/CP.pdf

## VDD

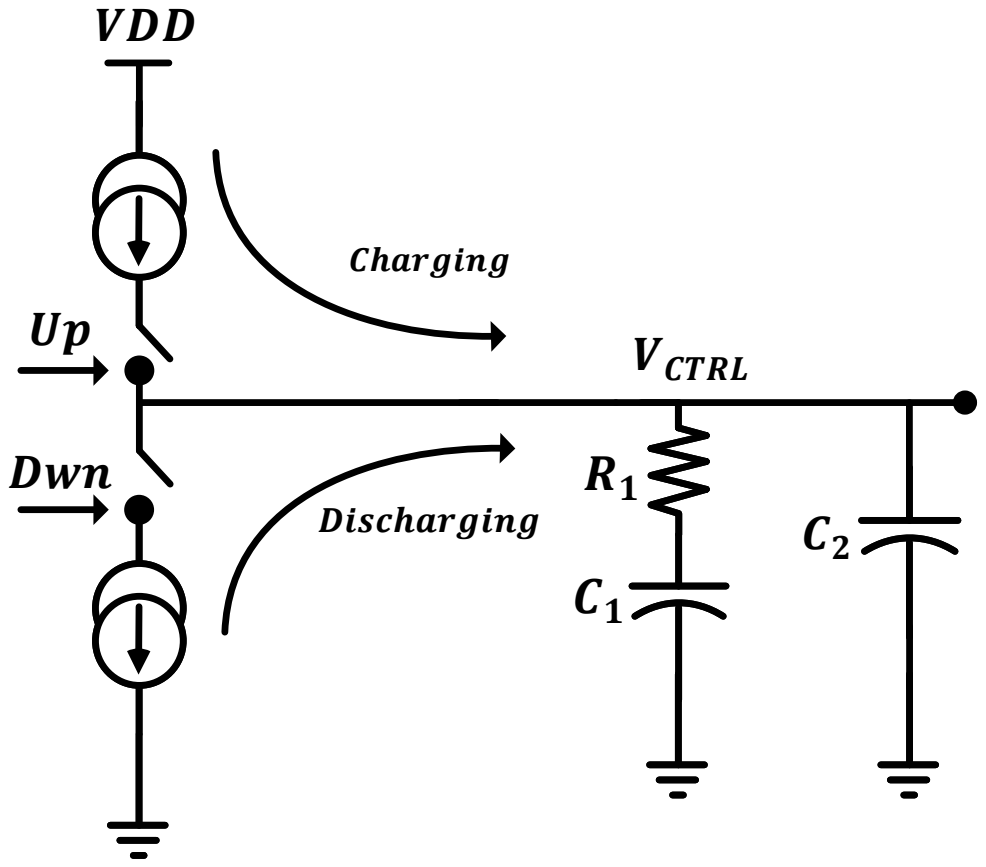
[picture p348: page 1]
VCTRL; Dwn; Char in

Di char in
