mabrains/PLL_design/images/Diagrams/Charge pump/pdf/cp_circuit.pdf

V

D

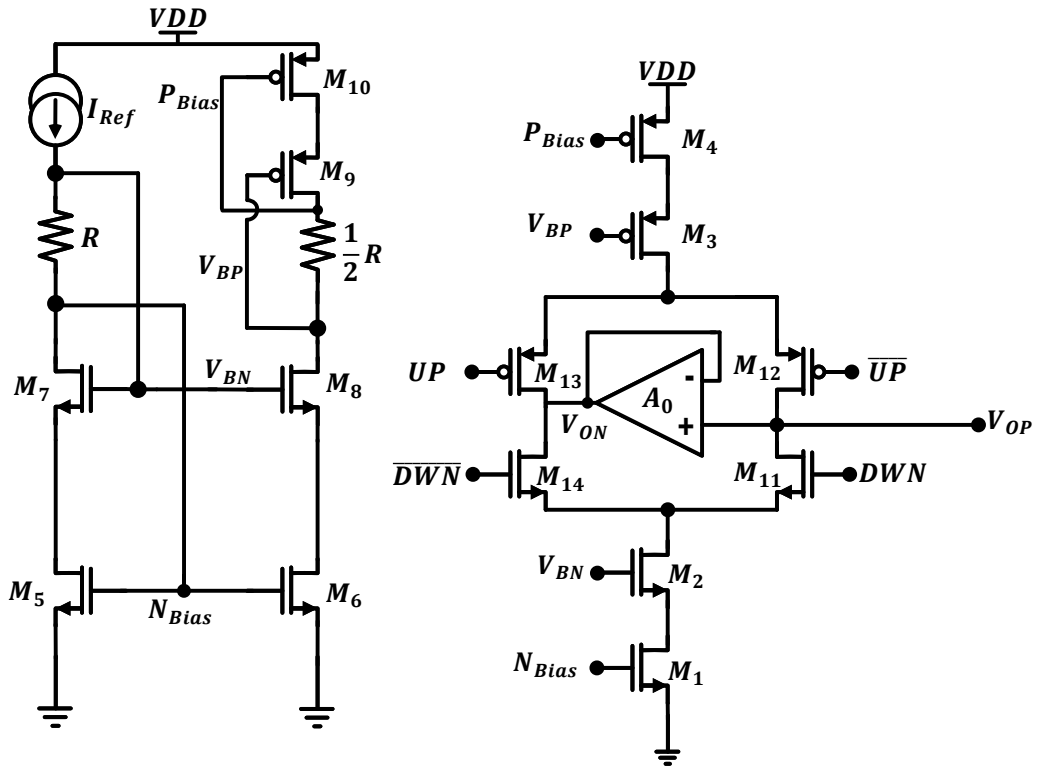
[picture p349: page 1]
DWN VON; VOP RIRef; 12R NBia; NBia PBia; PBia VBN VBP VBN VBP VDD
