mabrains/PLL_design/images/Diagrams/Charge pump/pdf/cp_ota.pdf

## VDD

M9

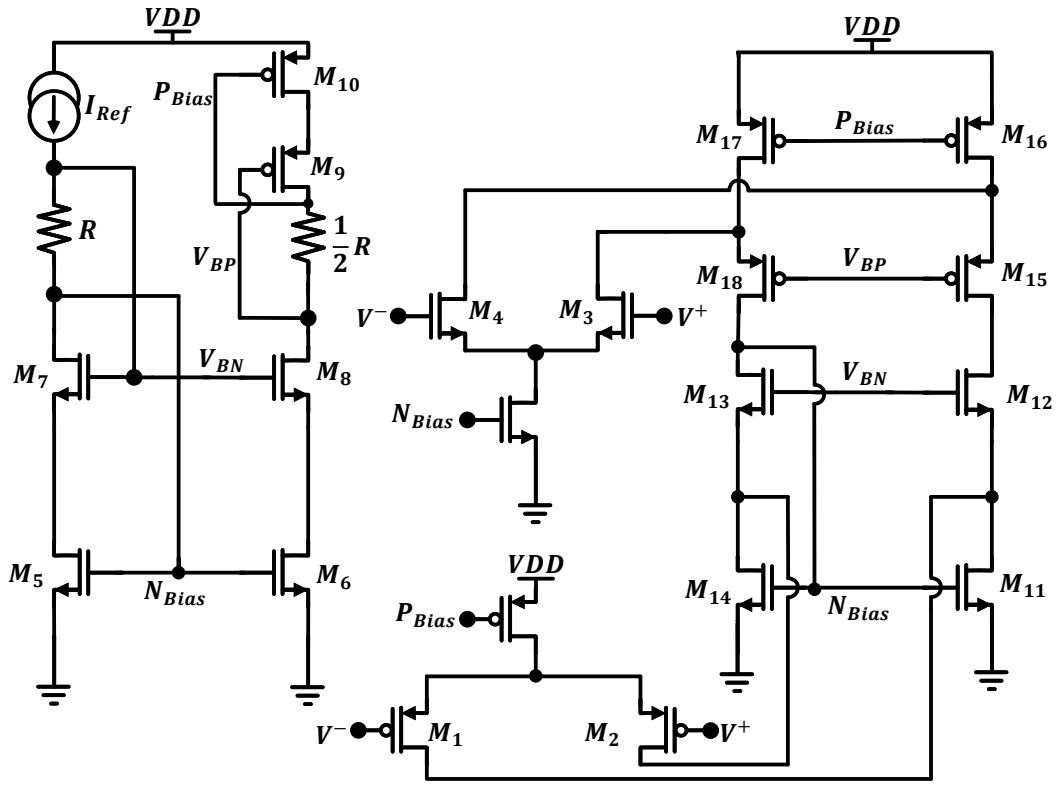
[picture p350: page 1]
IRef; NBia; PBia; VBN; VBP; VDD
