mabrains/PLL_design/images/Diagrams/PFD/pdf/DWN_DFF_PFD.pdf

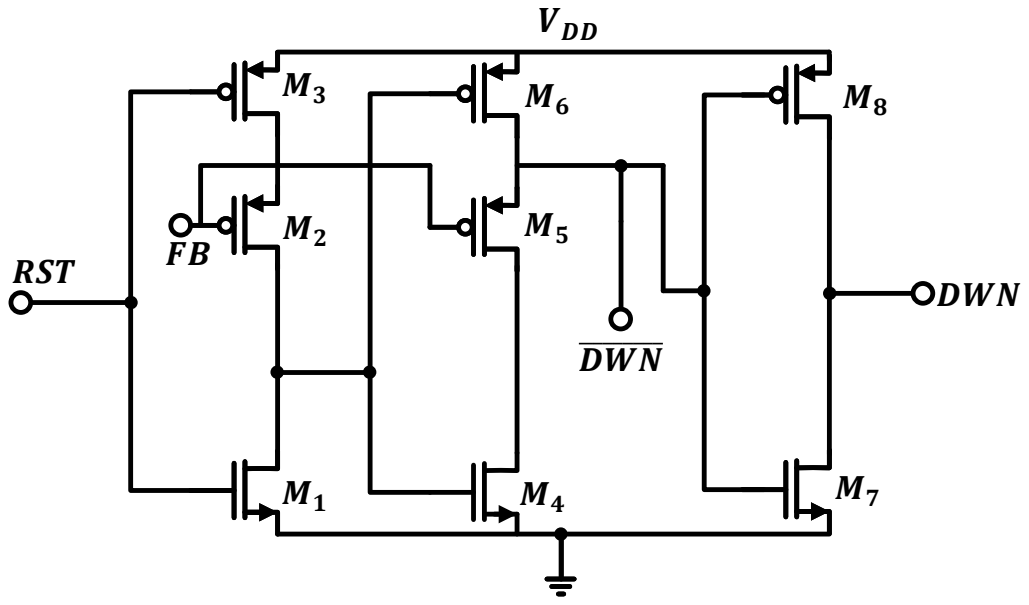
[picture p351: page 1]
VDD; RST; DWN
