mabrains/PLL_design/images/Diagrams/PFD/pdf/UP_DFF_PFD.pdf

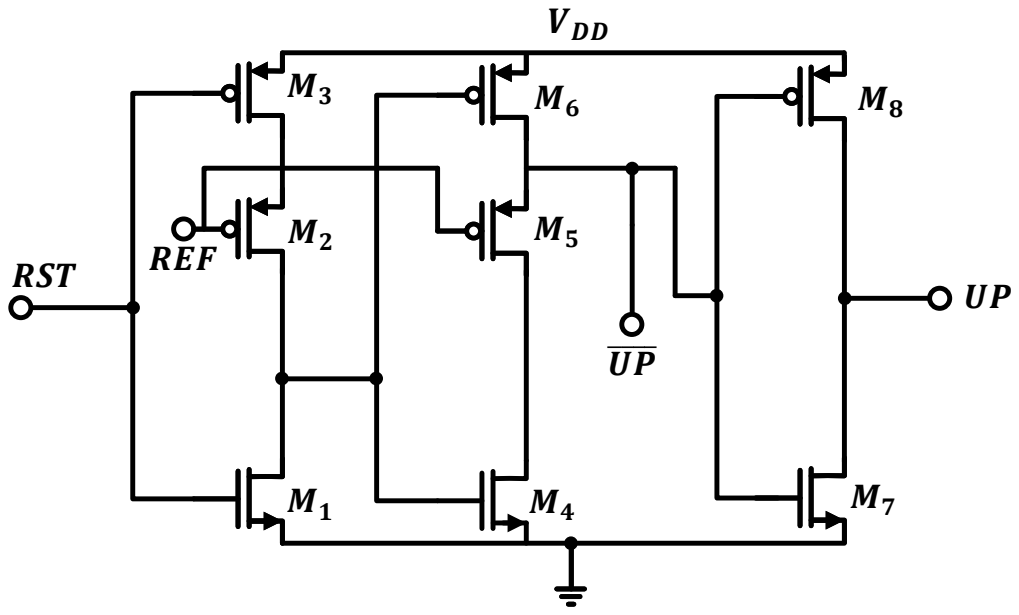
[picture p352: page 1]
VDD; RST; REF
