mabrains/PLL_design/images/Diagrams/PFD/pdf/UP_DFF_PFD_RED_LABEL.pdf

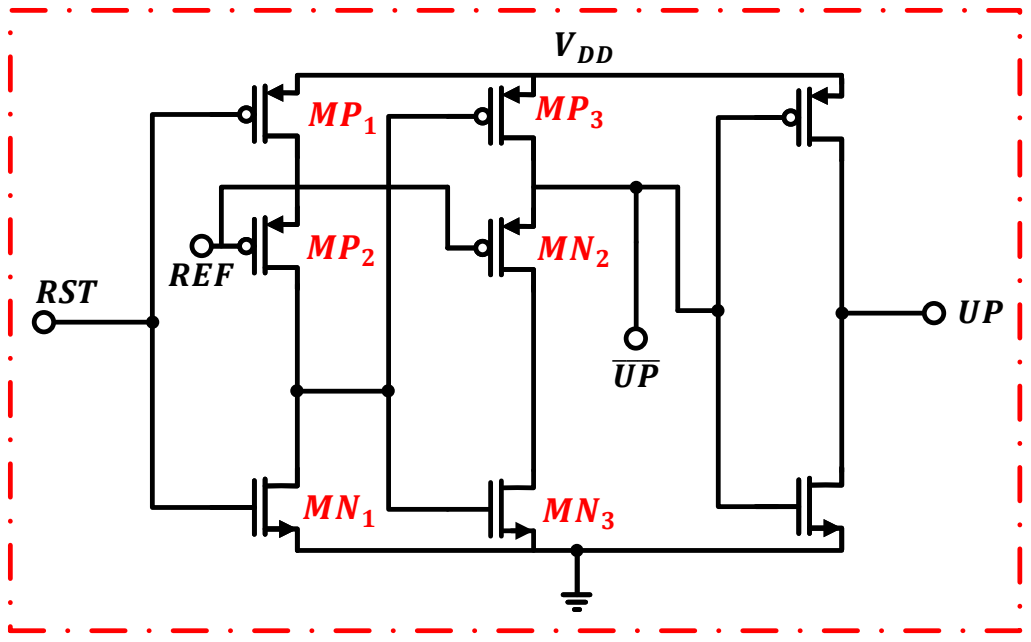
[picture p353: page 1]
VDD; RST; REF
