mabrains/PLL_design/(commit log)

2022-08-02 -adding crystal oscillator with accumulating jitter verilog-A model
2022-08-14 Adding DFF design
    [DFF.sch, DFFtb.sch, untitled.sch]
2022-08-14 Adding PFD design
    [PFD(1).sch, PFD.sch]
2022-08-15 Added the NMOS and CMOS LC VCO initial designs
    [VCO_try2.sch, VCO_try3.sch]
2022-08-15 - Moving lc_vco_nmos_pmos design to the appropriate location.
    [VCO_CMOS.sch, VCO_NMOS.sch]
2022-08-15 - Moving the design to the appropriate location.
    [PFD(1).sch, PFD.sch]
2022-08-15 - Adding DFF to the appropriate location.
    [DFF.sch, DFFtb.sch, untitled.sch]
2022-08-16 - Moving all files to a folder.
    [Delay_cell_2.sch, Delay_cell_M.sch, RO2.sch, delay_cell_m.sch, extraction.sch, inv.sch, modified_cell_sym_test.sch, new_cell_test.sch]
2022-08-16 - Moving delay cell design to the appropriate location.
    [Delay_cell_2.sch, Delay_cell_M.sch, RO2.sch, delay_cell_m.sch, extraction.sch, inv.sch, modified_cell_sym_test.sch, new_cell_test.sch]
2022-08-16 - Adding Ahmed Ramadan work in the crystal osc design.
    [schematic_crystal.sch, schematic_crystal_v2.sch, untitled.sch]
2022-08-16 added crystal xctl
    [schematic_crystal.sch, schematic_crystal_v2.sch, untitled.sch]
2022-08-16 Cleaning repo and updating PLL folder structure
    [DFF.sch, DFFtb.sch, Delay_cell_2.sch, Delay_cell_M.sch, PFD(1).sch, PFD.sch, RO2.sch, delay_cell_m.sch]
2022-08-16 Adding latest versions , Updating folder structure
    [VCO_CMOS.sch, VCO_NMOS.sch]
2022-08-17 Cleaning repo , Adding latest works
    [DFF.sch, NMOS_OSC.sch, PFD(1).sch, PFD.sch, TG.sch, VCO_CMOS.sch, VCO_NMOS.sch, and.sch]
2022-08-17 divider is simulated at N=250
    [DFF.sch, TG.sch, divider_tb.sch, inv.sch, nand.sch, nand_3in.sch]
2022-08-18 - System Modeling using Octave
    Without Loop filter & Sigma Delta Modulator noise
2022-08-18 Adding tb dirs , cleaning repo
    [DFF.sch, DFFtb.sch, NMOS_OSC.sch, TG.sch, VCO_CMOS.sch, VCO_NMOS.sch, and.sch, cell.sch]
2022-08-21 Adding latest work of divider
    [DFF.sch, TG.sch, and.sch, cell.sch, divider.sch, divider_tb.sch, inv.sch, inv_DC.sch]
2022-08-21 Updating LC VCO work and cleaning repo
    [CMOS_LC_VCO.sch, MOSCAPS_char.sch, MOS_char.sch, NMOS_OSC.sch, VCO_CMOS.sch, VCO_NMOS.sch, first_lc_osc.sch, first_lc_osc_op.sch]
2022-08-21 Adding QRO-ring osc design
    [FF_cell.sch, FF_cell_test.sch, QRO.sch, aux_circuits.sch, core_cell.sch, core_cell_test.sch, current_mirror_test.sch]
2022-08-24 Updating some designs , Adding README file , Updating folder struct.
    [DFF.sch, TG.sch, and.sch, cell.sch, divider.sch, divider_tb.sch, inv.sch, inv_DC.sch]
2022-08-28 adding Charge pump files
    [CP.sch, OTA.sch, inv_symbol.sch, inverter.sch, untitled-1.sch, untitled-2.sch, untitled.sch]
2022-08-29 Adding sch test for xctl osc
    [schematic_crystal.sch, schematic_crystal_v2.sch, xctl_test.sch]
2022-08-29 Upliading csv_files
    [gm10_no_noise.csv, gm11_no_noise.csv, gm1_no_noise.csv, gm2_no_noise.csv, gm3_no_noise.csv, gm4_no_noise.csv, gm5_no_noise.csv, gm7_no_noise.csv]
2022-08-30 Solving some issues , Adding some tests , Cleaning designs
    [CMOS_LC_VCO.sch, CMOS_LC_VCO_tb.sch, MOSCAPS_char.sch, MOS_char.sch, NMOS_OSC.sch, VCO_CMOS.sch, VCO_CMOS_init.sch, VCO_CMOS_init_tb.sch]
2022-08-30 addingPFD+CP designs and testbench and TB for PFD+Cp integration
    [CP_tb.sch, PFD.sch, PFD_tb.sch, TEST.sch, charge_pump.sch, inv_symbol.sch, inverter.sch, untitled-1.sch]
2022-08-30 Adding tb files , Updating files , solving some issues
    [CP.sch, CP_tb.sch, PFD.sch, PFD_tb.sch, TEST.sch, charge_pump.sch, inv_symbol.sch, inverter.sch]
2022-09-01 Updating README and CP dirs
    [CP.sch, CP_OTA.sch, CP_OTA_tb.sch, CP_tb.sch, OTA.sch, PFD_CP.sch, inverter.sch]
2022-09-03 LC-VCO Update
    [OTA.sch, constant GM0.sch, constant GM01.sch, constant GM1.sch, constant GM2 1.sch, constant GM2 2.sch, constant GM2 3 Start up.sch, constant GM2.sch]
2022-09-05 Uploading CMOS_LC_VCO design
    [CMOS_VCO_tb1.sch, NMOS_char.sch, PMOS_char.sch, cdd_vec.csv, cgg_vec.csv, cgs_vec.csv, fosc_vs_vctrl.csv, gds_vec.csv]
2022-09-06 Uploading Corner Simulations
    [CMOS_VCO_tb1.sch, fosc_vs_vctrl.csv, fosc_vs_vctrl_ffff.csv, fosc_vs_vctrl_fffs.csv, fosc_vs_vctrl_ffsf.csv, fosc_vs_vctrl_ffss.csv, fosc_vs_vctrl_fsff.csv, fosc_vs_vctrl_fsfs.csv]
2022-09-08 Simulate with biasing cct
    [BGR_Banba.sch, CMOS_VCO_tb1.sch, fosc_vs_vctrl_ffff.csv, fosc_vs_vctrl_fffs.csv, fosc_vs_vctrl_ffsf.csv, fosc_vs_vctrl_ffss.csv, fosc_vs_vctrl_fsff.csv, fosc_vs_vctrl_fsfs.csv]
2022-09-09 TOP-237 updating simulation files (adding divider noise analysis)
    [divider_tb.sch, gm1_3nand.csv, gm1_TG.csv, gm1_inv.csv, gm1_nand.csv, gm2_3nand.csv, gm2_TG.csv, gm2_inv.csv]
2022-09-09 Completed final design including biasing circuit
    All specs are met across 19 corners, all that is left is the calculation of the phase noise and the layout of the whole design
    [BGR_Banba.sch, VCO_Final.sch]
2022-09-11 Adding files for biasing cct
    [fosc_vs_vctrl_ffff.csv, fosc_vs_vctrl_fffs.csv, fosc_vs_vctrl_ffsf.csv, fosc_vs_vctrl_ffss.csv, fosc_vs_vctrl_fsff.csv, fosc_vs_vctrl_fsfs.csv, fosc_vs_vctrl_fssf.csv, fosc_vs_vctrl_fsss.csv]
2022-09-11 Reordering some files
    [BGR_Banba.sch, CMOS_VCO_tb1.sch, fosc_vs_vctrl_ffff.csv, fosc_vs_vctrl_fffs.csv, fosc_vs_vctrl_ffsf.csv, fosc_vs_vctrl_ffss.csv, fosc_vs_vctrl_fsff.csv, fosc_vs_vctrl_fsfs.csv]
2022-09-11 Adding CMOS VCO phase noise files of my design
    [VCO_Full_Phase_Noise.sch]
2022-09-11 integration of PFD+Cp+loop filter
    [PFD_CP_LPF.sch, PFD_CP_loop_filter.sch, PFD_tb.sch]
2022-09-12 Cleaning divider lib and testing PN runs
    [divider_tb.sch, gm1_3nand.csv, gm1_TG.csv, gm1_inv.csv, gm1_nand.csv, gm2_3nand.csv, gm2_TG.csv, gm2_inv.csv]
2022-09-12 Cleaning PFD_CP_LPF files and modifying some issues
    [PFD_CP_LPF.sch, PFD_CP_LPF_tb.sch]
2022-09-12 Restructure and cleaning lc_vco libs , fixing some isssues
    [BGR_Banba.sch, BGR_Banba_tb.sch, CMOS_LC_VCO.sch, CMOS_LC_VCO_tb.sch, CMOS_VCO_tb1.sch, Complementary.sch, Complementary_0.5_1.5.sch, MOSCAPS_char.sch]
2022-09-12 adding my crystal
    [Crystal.sch, Inv.sch]
2022-09-14 Cleaning DSM files , ADding openlane flow for DSM
    [DSM.sdf, metrics.csv]
2022-09-14 updated version of crystal
    [Crystal.sch]
2022-09-15 Fixing config file for pll design, testing pfd with design_manger
    [PFD_tb.sch]
2022-09-18 update the MD file
    [Crystal.sch]
2022-09-18 ADT-142 Adding struct for all pfd_cp_lf cells ,cleaning and testing pfd_cp_lf lib
    [CP.sch, CP_OTA.sch, CP_OTA_tb.sch, CP_tb.sch, OTA.sch, PFD_CP_LPF.sch, PFD_CP_tb.sch, inverter.sch]
2022-09-18 ADT-142 Adding new structure for all divider cells ,cleaning and testing divider lib
    [DFF.sch, TG.sch, and.sch, divider.sch, divider_cell.sch, inv.sch, nand.sch, nand_3in.sch]
2022-09-18 ADT-142 Adding new structure for xctl cells ,cleaning and testing xctl lib
    [Inv.sch, schematic_crystal.sch, schematic_crystal_v2.sch, xctl.sch, xctl_tb.sch, xctl_test.sch]
2022-09-18 ADT-142 Cleaning some of lc_vco cells
    [BGR_Banba.sch, VCO_Final.sch]
2022-09-20 Rearrange files
    [gm_bgr_banba_xm13.csv, gm_bgr_banba_xm14.csv, gm_bgr_banba_xm15.csv, gm_bgr_banba_xm16.csv, gm_bgr_banba_xm17.csv, gm_bgr_banba_xm18.csv, gm_bgr_banba_xm19.csv, gm_bgr_banba_xm20.csv]
2022-09-20 PDK oscillator update 1
    [ac_mag_0.csv, ac_mag_1.csv, ac_mag_10.csv, ac_mag_11.csv, ac_mag_12.csv, ac_mag_13.csv, ac_mag_14.csv, ac_mag_15.csv]
2022-09-20 Uploading the trnoise_experiments and PDK_varactor_experiments
    [temp2.csv]
2022-09-20 Rearrange files in the Experiments folder
    [ac_mag_0.csv, ac_mag_1.csv, ac_mag_10.csv, ac_mag_11.csv, ac_mag_12.csv, ac_mag_13.csv, ac_mag_14.csv, ac_mag_15.csv]
2022-09-20 Pdk varactor update 4
    [ac_mag_0.csv, ac_mag_1.csv, ac_mag_10.csv, ac_mag_11.csv, ac_mag_12.csv, ac_mag_13.csv, ac_mag_14.csv, ac_mag_15.csv]
2022-09-21 setting corners simulations
    [fosc_vs_vctrl_tssf.csv, fosc_vs_vctrl_tttt.csv]
2022-09-21 BGR Corners
    [Iref_tran_ffff.csv, Iref_tran_fffs.csv, Iref_tran_ffsf.csv, Iref_tran_ffss.csv, Iref_tran_fsff.csv, Iref_tran_fsfs.csv, Iref_tran_fssf.csv, Iref_tran_fsss.csv]
2022-09-21 start sesting the corners of the vco corners with ideal current source
    [fosc_vs_vctrl_tssf.csv]
2022-09-21 final design ideal current source update 1
2022-09-21 simulate vco with ideal current source with corners update 3
2022-09-21 Corners Script
    [Iref_tran_fftt.csv, Iref_tran_fstt.csv, Iref_tran_ftff.csv, Iref_tran_ftfs.csv, Iref_tran_ftsf.csv, Iref_tran_ftss.csv, Iref_tran_fttt.csv, Iref_tran_sfff.csv]
2022-09-21 uploading csv files of the dc operating point of the lc vco
    [In_left.csv, In_right.csv, Ip_right.csv]
2022-09-21 upload the results of all corners with ideal current source
2022-09-21 - Adding run vco with corners script.
    [In_left.csv, In_right.csv, Ip_right.csv]
2022-09-22 changing the current source direction and add comments to the main python scripy
    [all_measurements.csv]
2022-09-22 ODE-13 Making some pll cells work with design manger
    [BGR_Banba.sch, BGR_Banba_tb.sch, MOSCAPS_char.sch, MOS_char.sch, OTA.sch, VCO_final.sch, lc_osc_complementary_0.5_1.5_tb.sch, lc_osc_complementary_tb.sch]
2022-09-22 Updating the script after running on server
    [all_measurements.csv]
2022-09-22 Adding BGR corners simulation files
    [all_measurements.csv]
2022-09-22 uodate thecripts on the server
    [all_measurements.csv]
2022-09-22 Adding the BGR corner files after simulating them
    [all_measurements.csv]
2022-09-22 uploading the all measurement csv file for all the corner cases
    [all_measurements.csv]
2022-09-22 fetching the failed corners
    [failed_corners.csv, temp.csv]
2022-09-24 handling githup after the server came on
    [all_measurements.csv]
2022-09-24 adding gm
    [all_measurements.csv]
2022-09-25 the design is modified
    [all_measurements.csv]
2022-09-25 adding script to plot the measurements
    [all_measurements.csv]
2022-09-26 adding the results of the vco ideal cs with 2 failed corners
    [all_measurements_after_modification.csv, all_measurements_original.csv]
2022-09-26 ASTIC version1 with BGR
    [all_measurements.csv]
2022-09-26 add the results - separating the inductor model in a separate subckt - adding a mim parallel cap
    [all_measurements.csv, all_measurements_ASTIC_hexa.csv]
2022-09-26 optimizing the nmos varactor device
    [all_measurements.csv]
2022-09-27 adding the corner results after optimizing the varactor and considering the BGR
    [all_measurements.csv, all_measurements_varactor optimization.csv]
2022-09-27 add corner analysis
    [all_measurements.csv, fosc_vs_vctrl_ffff.csv, fosc_vs_vctrl_fffs.csv, fosc_vs_vctrl_ffsf.csv, fosc_vs_vctrl_ffss.csv, fosc_vs_vctrl_fsff.csv, fosc_vs_vctrl_fsfs.csv, fosc_vs_vctrl_fssf.csv]
2022-09-27 -Adding Intergeration Testbenchs
    [vco_behav.csv]
2022-09-27 Adding a model for the integration of both divider and dsm
    [Measurements.csv]
2022-09-29 using the nf in replacement of using mult and measuring the power
    [all_measurements.csv]
2022-09-29 replacing the mult with nf
    [all_measurements.csv, all_measurements_after_replacing_mult_with_nf.csv]
2022-09-29 add new design for PFD using conventional PFD and add design of current steering cp with buffer
    [5TOTA.sch, CP.sch, CP_tb.sch, CP_with_buffer.sch, Nor_gate.sch, OTA.sch, PFD_tb.sch, conventional_pfd.sch]
2022-10-02 Adding DSM openlane flow
    [DSM.sdf, metrics.csv]
2022-10-02 uploading the results of the unbalanced inductor
    [all_measurements.csv, all_measurements_after_replacing_mult_with_nf_unbalanced_left.csv, all_measurements_after_replacing_mult_with_nf_unbalanced_right.csv]
2022-10-03 new crystal
    [Crystal.sch, all_measurements.csv]
2022-10-03 add the corner folder
    [pfd_ckt.csv]
2022-10-03 -Adding circuit diagrams
2022-10-03 run pfd
    [all_measurements.csv]
2022-10-04 -Updated read me with the circuit diagrams
2022-10-04 update two
    [pfd_ckt.csv]
2022-10-04 update three
    [all_measurements.csv]
2022-10-04 update four
    [all_measurements.csv]
2022-10-04 update five
    [all_measurements.csv]
2022-10-04 update eight
    [all_measurements.csv]
2022-10-04 update nine
    [all_measurements.csv]
2022-10-04 update ten
    [5TOTA.sch, CP_with_buffer.sch, OTA.sch, PFD_tb.sch]
2022-10-04 change name of pfd_corners
    [all_measurements.csv]
2022-10-04 adding the corner running setup of the charfe pump
    [all_measurements.csv]
2022-10-05 plot the current via corners
    [all_measurements.csv, all_measurements_0_0.csv, all_measurements_0_1.8.csv, all_measurements_1.8_0.csv, all_measurements_1.8_1.8.csv, temp.csv]
2022-10-08 fixing some of the failed corners
    [Crystal.sch, all_measurements.csv]
2022-10-09 last update
    [CP_with_buffer.sch, OTA.sch, cp_second_design_tb.sch]
2022-10-10 adding some trials to test new latches & designing 2by3 divider
    [CML-latch.sch, CMOS_d_latch.sch, DFF.sch, cell.sch, divider.sch, divider_TB.sch, dynamic_cmos_latch.sch, dynamic_latch.sch]
2022-10-11 adding python scripts for automating divider simulation
    [divider_simulation.csv]
2022-10-12 Editing divider_lib & adding automation files & updating README file with new DFF
    [CMOS_DFF.sch, DFF.sch, TG.sch, all_measurements.csv, and.sch, divider.sch, divider_cell.sch, divider_simulation.csv]
2022-10-13 continue lvs on server
    [CP_with_buffer.sch, all_measurements.csv, cp_second_design_tb.sch]
2022-10-13 Adding corners_automation results
    [final_result.csv]
2022-10-13 plotting pex results
    [all_measurements_PEX_2.csv, all_measurements_failed_corners.csv]
2022-10-13 comparing before and after PEX
    [all_measurements_PEX.csv, all_measurements_PEX_2.csv, all_measurements_failed_corners_PEX.csv, all_measurements_failed_corners_schematic.csv, all_measurements_schematic.csv]
2022-10-15 bgr pex
    [all_measurements.csv, all_measurements_PEX.csv, all_measurements_failed_corners_PEX.csv, all_measurements_failed_corners_PEX_const_load.csv, all_measurements_failed_corners_schematic.csv, all_measurements_failed_corners_schematic_const_load.csv, all_measurements_schematic.csv]
2022-10-15 adding csv sheets
    [all_measurements_failed_corners_pex_const.csv, all_measurements_failed_corners_pex_var.csv, all_measurements_failed_corners_sch_const.csv, all_measurements_failed_corners_sch_var.csv, all_measurements_pex_const.csv, all_measurements_pex_var.csv, all_measurements_sch_const.csv, all_measurements_sch_var.csv]
2022-10-20 rearranging selected_vco_lib directory
    [all_measurements.csv, all_measurements_ASTIC_hexa.csv, all_measurements_after_modification.csv, all_measurements_after_replacing_mult_with_nf_unbalanced_left.csv, all_measurements_after_replacing_mult_with_nf_unbalanced_right.csv, all_measurements_original.csv, all_measurements_pex.csv, all_measurements_sch.csv]
2022-10-20 arrange files
    [all_measurements.csv]
2022-10-20 pex vco and bgr
    [all_measurements.csv]
2022-10-20 vco pex bgr sch
    [all_measurements.csv]
2022-10-20 vco pex bgr ideal cs
    [all_measurements.csv]
2022-10-20 vco sch bgr sch
    [all_measurements.csv]
2022-10-21 vco pex bgr pex all corners
    [all_measurements.csv]
2022-10-22 add results of vco after pex before cahnging the capacitance values
2022-10-22 varying cap 1
    [all_measurements.csv]
2022-10-22 varying cap 3
    [all_measurements.csv]
2022-10-22 varying cap 5
    [all_measurements.csv]
2022-10-22 varying cap 7
    [all_measurements.csv]
2022-10-22 varying cap 9
    [all_measurements.csv]
2022-10-24 uploading files from the server
    [all_measurements.csv, all_measurements_0_0.csv, all_measurements_0_1.8.csv, all_measurements_1.8_0.csv, all_measurements_1.8_1.8.csv, divider_simulation.csv, pfd_behave.csv, temp.csv]
2022-10-25 adding fractional N division ratios simulation & frequency-hopping testing on the divider
    [divider_tb_fractional.sch, divider_tb_hopping.sch]
2022-10-25 updating loop filter
2022-10-25 Commenting print and measure commands
2022-10-26 adding ss corner analysis on NMOS, PMOS
    [curve(0).csv, curve(1).csv, curve(2).csv, curve(3).csv, curve(4).csv, curve(5).csv, curve(6).csv, curve(7).csv]
2022-10-26 Rearranging the repo
    [CML-latch.sch, CMOS_DFF.sch, CMOS_d_latch.sch, DFF.sch, all_measurements.csv, all_measurements_0_0.csv, all_measurements_0_1.8.csv, all_measurements_1.8_0.csv]
2022-10-27 Rearranging the structure
    [DSM.sdf, metrics.csv]
2022-10-27 adding pll behave and circuit
2022-10-27 finishing BGR organization
    [all_measurements.csv]
2022-10-27 Updating folder struct
    [DSM.sdf, metrics.csv]
2022-10-27 adding loop filter tb
2022-10-27 divider finicshed organization
    [all_measurements.csv]
2022-10-30 sweeping pmos width
    [all_measurements.csv]
2022-11-02 organizing the structure of the PLL section and create the bash script to run the analysis of the PLL
    [all_measurements.csv]
2022-11-02 running ful pll with small step of 2 pecos up to 30 microns
    [all_measurements.csv]
2022-11-03 running corners
    [all_measurements.csv]
2022-11-04 ff corner integer pll fully schematic integrated
    [all_measurements.csv]
2022-11-05 adding testbench to repalce the ideal current source of the cp with a non ideal one
    [all_measurements.csv]
2022-11-05 rearrange the cp netlist
    [all_measurements.csv]
2022-11-05 adding non ideal current source to the cp
    [all_measurements.csv]
2022-11-08 vco reults
    [all_measurements.csv]
2022-11-08 vco results
    [all_measurements.csv]
2022-11-14 - Adding the final crystal osc.
    [Crystal.sch, all_measurements.csv]
2022-11-16 Adding Divider layout division ratios testbench
    [all_measurements.csv]
2022-11-16 Adding Divider layout division ratios testbenches
    [all_measurements.csv]
2022-11-17 Divider divison ratios Run no R pex test
    [all_measurements.csv]
2022-11-17 Modifying the layout of the integer pll (reducing the contacts of the supplay rails and reducing the length of then rail not to pass arounf the large cap)
2022-11-17 Run LVS on the integer pll after modyfing the supply rails to make sure that all things are correct after the modification
2022-11-17 Divider 1 cell circuit and layout testing
2022-11-17 Extracting the parasitics from the PLL layout using magic after reducing the supply rails area
2022-12-11 - Update to crystal osc.
    [Crystal.sch]
2022-12-12 Modifying the convert_raw python script and the integer pll test benshs to improve the combatiblity and make the code run on both schematic and pex simulations.In addition to seperating the run scrip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
2022-12-13 - Delete old crystal design.
    [xctl.sch, xctl_tb.sch]
2022-12-13 - Moving the crystal to the right folder structure.
    [Crystal.sch, all_measurements.csv]
2022-12-13 - Clean up the corners folder and replace all files with new ones.
    [all_measurements.csv]
